nanda-1243/tngexp/docs/research/market-check-folds.md

# Market check: how square tin photo magnets are folded

Date: 2026-10-27. Question: does the Rev E fold match the sharp-cornered tin photo magnets that are sold, and what happens at the corners?

## What the products show

1. **Two flat folds, no curl.** The photo, film and tin fold down at the face edge, then fold flat inward under the back. There is no rolled edge.
2. **A flat border on the back, mitred at 45° at the corners.** On card-back kits the photo carries on round the edge, so the border is printed. On other makes the photo stops at the side wall and the border is bare tin.
3. **The tin starts flat.** Kits sold for 50 × 50, 63.5 × 63.5, 53 × 80 and 65 × 90 mm magnets (the same four sizes as the MagPress kits) supply:
   - a flat tinplate blank with small 45° corner clips;
   - photo paper and film cut as octagons, with large 45° corner clips (the paper cutters are octagonal);
   - a card back and a rubber magnet.
   The press folds the blank itself. Pre-formed square badge shells are sold too, but they have rounded corners of about R3–R4, so they cannot give a sharp corner.
4. **The spare material at each corner folds flat.** It is not cut away. The paper's corner clip stops it from bunching, and the line where the two folded edges meet is the diagonal seen on the back.

## What it changed in Rev E

- **The back edge is a two-layer hem.** After it turns inward under the back, the edge folds back on itself and both layers are pressed flat (the Rev D curl, made flat). That is the "folds twice" on the back of a bought magnet, and it is what the back length and the tin size give: 6 mm of tin past each face edge is the 2.4 mm side wall plus two layers of about 1.5–2 mm under the back. The photo stays outside, so the back shows a 2.8 mm printed border with mitred corners and the cut tin edge is hidden inside the fold.
- **Crimp anvil:** cove R0.7 flush with ring B's bore turns the edge inward; the back-plate platform's side wall (X − 6.6) turns it back on itself; the floor 0.85 below the platform presses the two layers flat. The magnet is about 2.4 mm thick.
- **Tin.** Changed from a drawn 4.5 mm tray to a flat blank cut from 0.20 mm soft tinplate, X + 12 (6 mm a side), with its corners clipped on the photo's 45° line. The photo and film are cut the same size, X + 12.
- **Stroke 1 now folds the tin.** It folds round the pickup pedestal (top edge R0.8) together with the photo and film, into walls about 5.6 mm deep. The pedestal is 23.0 high (was 21.8) so the whole 6 mm flange is drawn into the upper ring. Pickup ring A has a 0.6 mm recess at X + 12.5 that centres the blank, photo and film.
- **Folding force:** about 0.9–1.3 kN for 0.20 mm soft tin (`calc/results.txt`, section 2). The Rev D upper springs (0.68–1.3 kN) could not hold the upper ring against that.
- **New upper springs:** 8 × ISO 10243 Ø12.5 × 44 red, giving 1.57 kN preload and 2.54 kN at full travel. They sit in a 20 mm die body, which has a Ø54 counterbore for the holder.
- **Hand force at the end of stroke 2:** rises by about 50 N, to 210–268 N for the square kits.
- **Round kits keep the Rev D rolled edge** and drawn round cups. A flat round blank cannot be folded, and a round edge folded flat would have to shrink about 10 % as it turns in, so it would wrinkle.
- **To prove on the prototype:** that the edge, pushed round the cove and back along the floor, lies flat in two layers without buckling; the real hem width (adjust the blank between X + 11 and X + 13 to suit).

## Sources

- Jiangxi Mide square fridge-magnet press kit, molds 50 × 50, 63.5 × 63.5, 53 × 80 and 65 × 90 mm, with materials and finished-product photos: https://jxmide.en.made-in-china.com/product/ATERtYaUFjkM/China-Manual-Metal-Square-Fridge-Magnet-Photo-Making-Machine-Kit.html
- Square tinplate souvenir magnets, back views: https://ruiwangifts.en.made-in-china.com/product/MqlnwISypdpF/China-Square-Souvenir-Metal-Tin-Plate-Fridge-Magnet-for-Promotion-Gifts.html
- Tinplate fridge magnets, back views: https://miligift.en.made-in-china.com/product/AKxnBFECCqWV/China-Glitter-Square-Type-Flower-Wedding-Tourist-Tinplate-Fridge-Magnet.html
- Square badge machine and its materials, including pre-formed shells with rounded corners and an octagonal paper cutter (India): https://abhishekid.com/blogs/blog/how-to-make-square-button-badges-fridge-magnets
- Square badge crimping tips: https://www.americanbuttonmachines.com/blogs/american-button-machines/how-to-solve-crimping-issues
