nanda-1243/tngexp/release/RevE/MagPress-M4_Drawings_RevE.pdf

# MagPress M4

## Photo-magnet press · drawing set · Rev E (release)

### One universal die + size kits: 50 × 50, 63.5 × 63.5, 53 × 80, 65 × 90 mm Round kits (Rev D): Ø44, Ø50, Ø56, Ø58 mm

### DRAWING LIST

DRG NO. | TITLE | QTY | SHEET
MP-001 | GENERAL ARRANGEMENT & HEIGHTS | — | 2
MP-101 | BASE PLATE | 1 | 3
MP-102 | GUIDE RAIL | 2 (1 × -F, 1 × -B) | 4
MP-103 | KEEPER STRIP (GIB) | 2 (1 × -F, 1 × -B) | 5
MP-104 | STATION STOP BLOCK | 2 | 6
MP-105 | DIE TABLE (SLIDE) | 1 | 7
MP-106 | DIE TABLE STOP PIN | 1 | 8
MP-107 | COLUMN | 2 | 9
MP-108 | CROWN | 1 | 10
MP-109 | RAM | 1 | 11
MP-110 | CLEVIS | 1 | 12
MP-111 | DIE HOLDER | 1 | 13
MP-112 | PIVOT CHEEK | 2 | 14
MP-113 | HANDLE LEVER (ONE PIECE) | 1 | 15
MP-114 | TOGGLE LINK | 2 | 16
MP-116 | PIN A / PIN B (TOGGLE) | 2 | 17
MP-117 | PIN O (HANDLE PIVOT) | 1 | 18
MP-118 | RETURN ROD | 2 | 19
MP-119 | PIVOT SPACER | 2 | 20
MP-120 | STATION PILOT | 1 | 21
MP-121 | HANDLE-STOP POST | 1 | 22
MP-201 | UPPER DIE BODY (UNIVERSAL) | 1 per press | 23
MP-202 | UPPER DIE SHANK | 1 per press | 24
MP-203 | PLUG (SIZE KIT) | 1 per size kit (4) | 25
MP-204 | UPPER RING (SIZE KIT) | 1 per size kit (4) | 26
MP-205 | STATION BASE (UNIVERSAL) | 2 per press | 27
MP-206 | PICKUP PEDESTAL (SIZE KIT) | 1 per size kit (4) | 28
MP-207 | PICKUP RING A (SIZE KIT) | 1 per size kit (4) | 29
MP-208 | CRIMP ANVIL (SIZE KIT) | 1 per size kit (4) | 30
MP-209 | CRIMP RING B (SIZE KIT) | 1 per size kit (4) | 31
MP-210 | UPPER CARRIER (UNIVERSAL) | 1 per press | 32
MP-211 | LOWER CARRIER A / B (UNIVERSAL) | A + B per press | 33
MP-212 | PLUG STUD (SIZE KIT) | 1 per kit (8: 4 square, 4 round) 34
MP-223 | PLUG, ROUND (SIZE KIT) | 1 per round kit (4) | 35
MP-224 | UPPER RING, ROUND (SIZE KIT) | 1 per round kit (4) | 36
MP-226 | PICKUP PEDESTAL, ROUND (SIZE KIT) | 1 per round kit (4) | 37
MP-227 | PICKUP RING A, ROUND (SIZE KIT) | 1 per round kit (4) | 38
MP-228 | CRIMP ANVIL, ROUND (SIZE KIT) | 1 per round kit (4) | 39

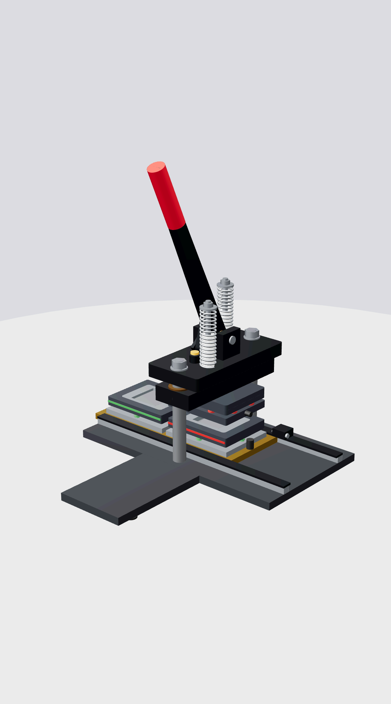
[picture p52: figure]
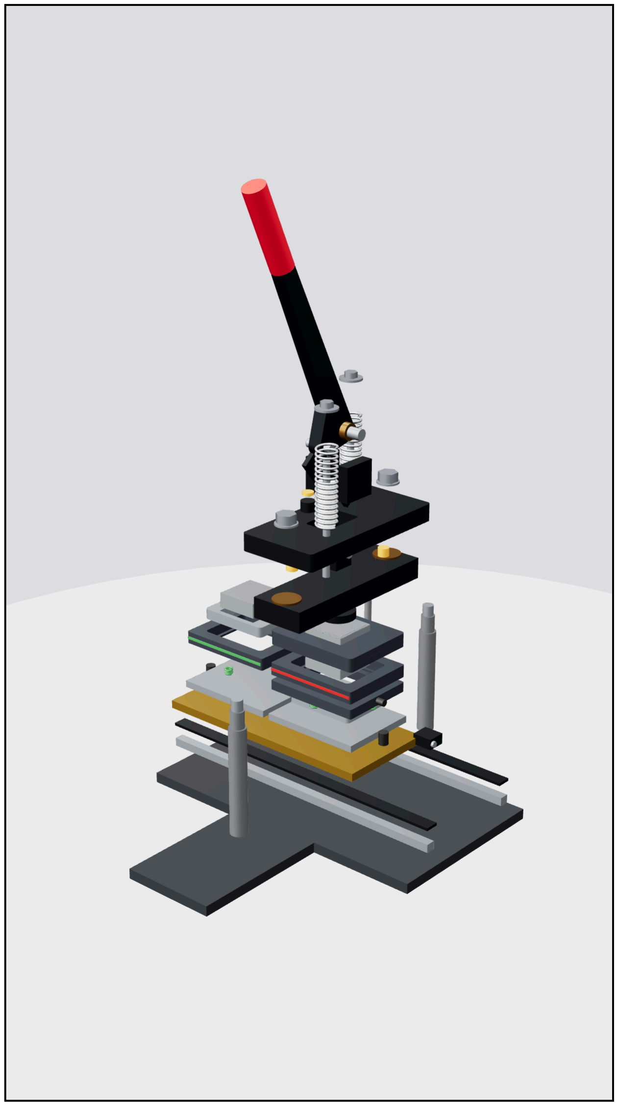
[picture p53: figure]

MP-229 | CRIMP RING B, ROUND (SIZE KIT) | 1 per round kit (4) | 40 | Reference renderings (Rev E): assembled, handle up (left); exploded (right). Not for measurement.

PROJECT
MagPress M4 · manual photo-magnet press

REVISION
E

SHEET
1 / 40

TITLE

# DRAWING SET — COVER & LIST

DRAWING NO.
MP-000

QTY
—

SCALE
—

UNITS
mm

MATERIAL
—

HEAT TREATMENT / FINISH
—

GENERAL TOLERANCES
ISO 2768-mK | 1st

DATE
2026-10-27
DRAWN | CHECKED

NOTES
1. Units mm. First-angle projection (ISO 128-30); every view is also labelled by name.
2. General tolerances ISO 2768-mK unless stated. Fits ISO 286. Threads ISO metric coarse 6H/6g unless stated. Ra 3.2 unless stated.
3. Column bores in base MP-101, crown MP-108 and ram MP-109 at 210.00 ±0.01: same datum scheme and CNC program.
4. Universal parts (MP-201, 202, 205, 210, 211) are made once per press. Square and rectangular kit parts (MP-203, 204, 206 to 209, 212) are tabulated for 5050, 6363, 5380, 6590; Rev D round kit parts (MP-223, 224, 226 to 229, with stud MP-212) for D44, D50, D56, D58.
5. DXF profiles are supplied for cutting and wire-EDM. If a DXF and a drawing disagree, the drawing governs. Bought parts are in the build pack BOM.
6. Rev B: failure-mode review (lever, pin O, bushings, return springs, pilot, base, 16 kN). Rev C (2026-10-27): universal die + 6-part size kits
changed by hand in about a minute; crimp anvil with roll channel; die springs re-rated to ISO 10243 limits. Rev C.1 (2026-10-27): fit fixes from the 3D interference check: ram link pockets (MP-109), crown reliefs for pins A and B (MP-108), push knobs on the table top (MP-105), flush column clamp (MP-101, MP-107), handle stop without jam nut, stop screw M6 × 0.75 × 40 (MP-104). Rev D (2026-10-27): four round size kits on the same universal die; MP-201 gains the inner plug pattern D2/K2. Rev E (2026-10-27), release: fixes from the independent review: sharp-cornered magnets from flat tin blanks folded in stroke 1, double flat fold (hem) with a printed border on the back (round kits keep the rolled edge); die body 20 thick with Ø12.5
× 44 red upper springs; detent pin along X; spigots; crown 120; stop post MP-121.

KEY HEIGHTS, handle up (mm from bench)

HEIGHT | LEVEL
586 | grip top, handle up
324 | return-rod top
234.5 | pivot O
201 | crown top
176 | crown bottom
164 | ram top
134 | ram bottom
92 | upper die bottom
66 | lower die top
40 | station base top
30 | die table top
18 | base top
3 | base underside (3 mm pads)
0 | bench

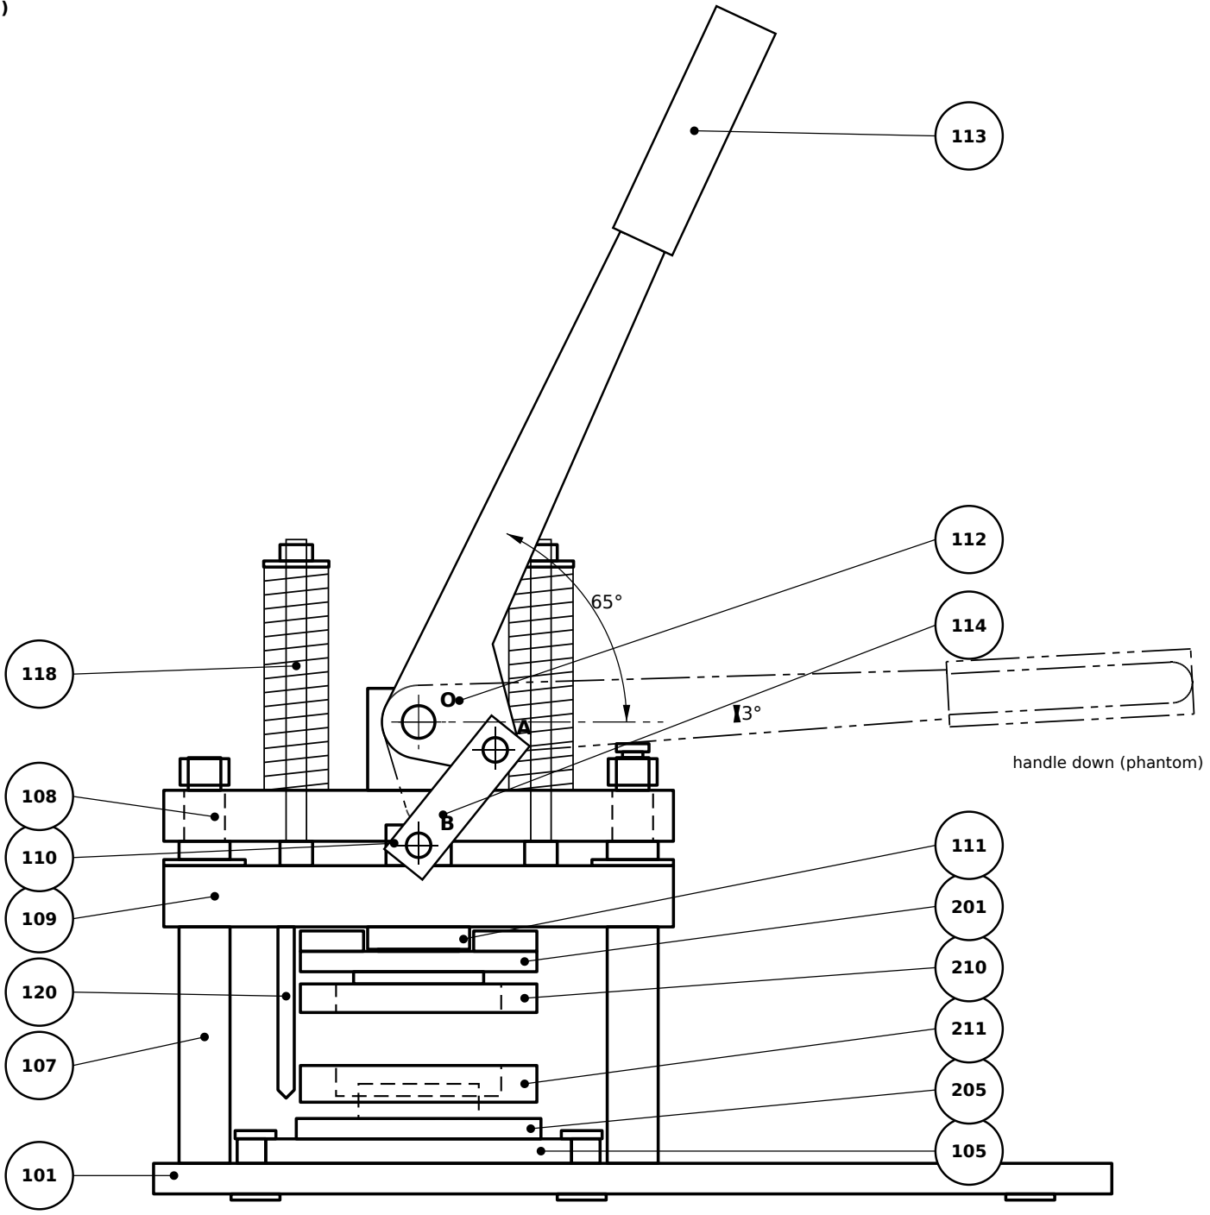
[picture p54: figure]
handle down (phantom)

### SIDE ELEVATION (viewed from the left; front →)

460

160 (stations)

80 (ram)

### FRONT ELEVATION 1:5 (handle cut off)

A | B

PROJECT
MagPress M4 · manual photo-magnet press

REVISION
E

SHEET
2 / 40

TITLE

# GENERAL ARRANGEMENT & HEIGHTS

DRAWING NO.
MP-001

QTY
—

SCALE
1:3 / 1:5

UNITS
mm

MATERIAL
—

—

NOTES
1. Shown with the handle UP (open), die table at "B under ram", size kit 6363 in the universal die. Heights from the bench top.
2. Toggle: crank O→A 40, link A→B 60, grip centre 320 from O (Rev A 290). Handle 65° → 3° above horizontal. Force gain 6.6 at the start, 34.6 at the end of the stroke.
3. Ram stroke 38.9. Dies meet after 26.0; working travel 12.9. Pickup stroke stops at 35.5. Station pilot MP-120 enters the table at 20.0, before the
dies meet.
4. Open stop: 2 urethane bumpers on the ram top. Closed stop: adjustable M10 × 1 screw + urethane cap in the post MP-121 on the crown (Rev E), set so the lever rests at 3°.
5. Rev B: one-piece lever (MP-115 deleted); pin O Ø16; dry bushings; return springs 80 / 245 N; station pilot; 15 mm base. Rev C: universal die + size kits (MP-201 to 212). Rev C.1: seven fit fixes from the 3D check (MP-101, 104, 105, 107, 108, 109). Rev D: round size kits Ø44 to Ø58 (MP-223 to 229), inner plug pattern on MP-201. Rev E: fixes from the independent review (see the cover).
6. Balloons = drawing numbers (MP-xxx). Pins MP-116 at A and B, MP-117 at O; spacers MP-119 on pin O; stop blocks MP-104 behind the table.

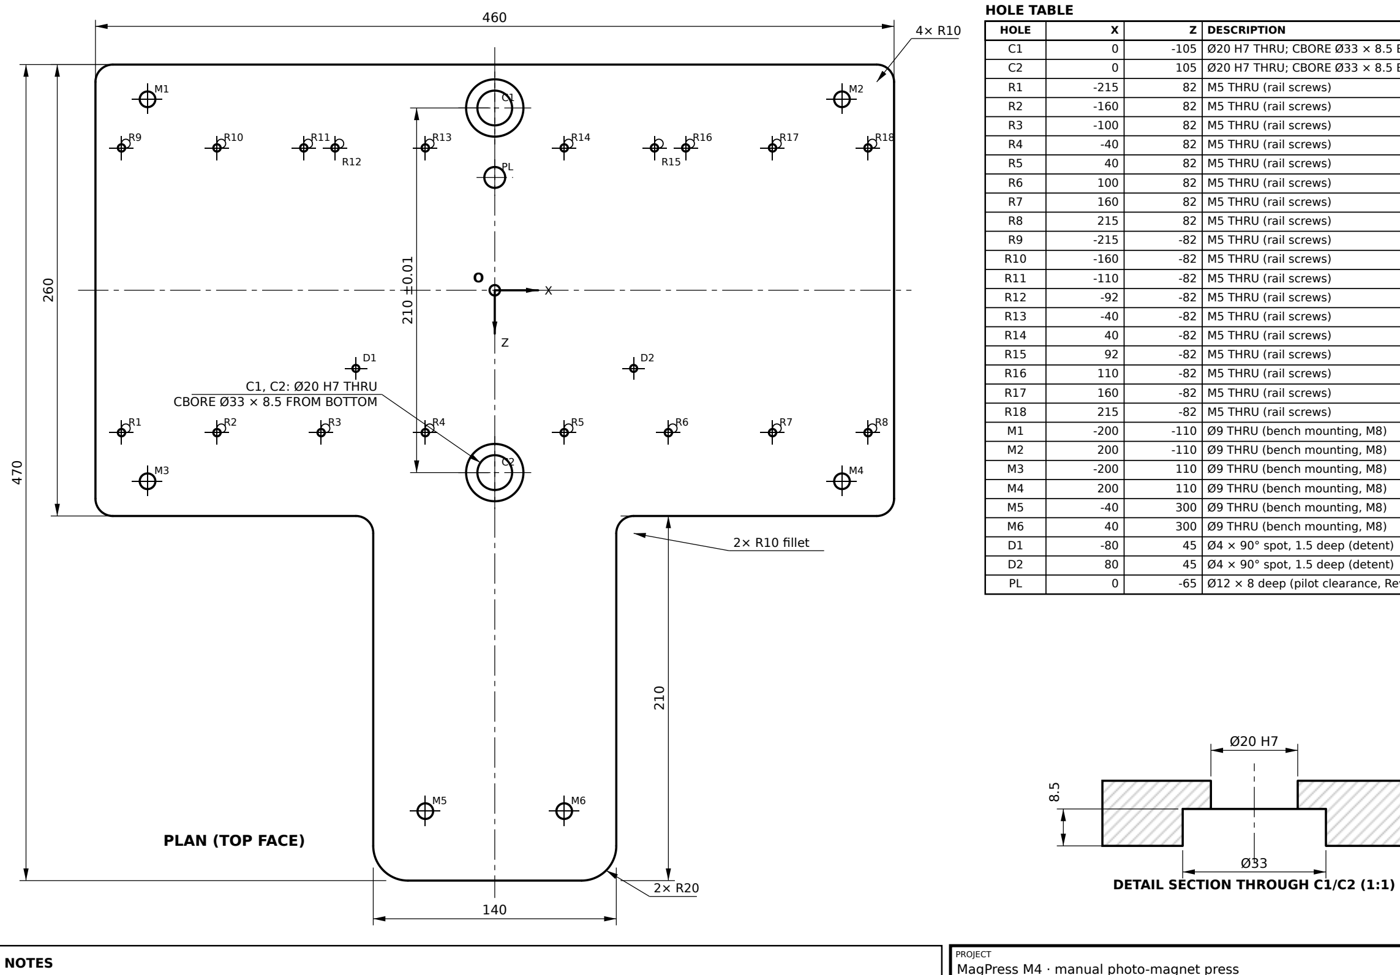
[picture p55: figure]
2× R10 fillet; C1, C2: Ø20 H7 THRU CBORE Ø33 × 8.5 FROM BOTTOM; PLAN (TOP FACE); HOLE TABLE; HOLE; DESCRIPTION; M5 THRU (rail screws); Ø9 THRU (bench mounting, M8); DETAIL SECTION THROUGH C1/C2 (1:1); PROJECT; NOTES

C1 | 0 | -105 | Ø20 H7 THRU; CBORE Ø33 × 8.5 BOTTOM
C2 | 0 | 105 | Ø20 H7 THRU; CBORE Ø33 × 8.5 BOTTOM
D1 | -80 | 45 | Ø4 × 90° spot, 1.5 deep (detent)
D2 | 80 | 45 | Ø4 × 90° spot, 1.5 deep (detent)
PL | 0 | -65 | Ø12 × 8 deep (pilot clearance, Rev E)

15

MagPress M4 · manual photo-magnet press

REVISION
E

SHEET
3 / 40

TITLE

# BASE PLATE

DRAWING NO.
MP-101

QTY
1

SCALE
1:2.5

UNITS
mm

MATERIAL
S355J2 steel plate 20 mm, profile cut, faced to 15.0

Slide area: QPQ nitrocarburize (prototype: black oxide + oil). Rest: black powder coat, bores masked

1. Rev B: 15 mm S355 (was 12 S235). At the 16 kN design load: 112 MPa, 0.26 mm (Rev A: 175 MPa, 0.51 mm). 0.08 mm at a normal 5 kN stroke.
2. Face both sides to 15.0 ±0.1. Flatness 0.05 over the slide area X ±230 × Z ±75, Ra 1.6.
3. C1/C2 Ø20 H7 at 210.00 ±0.01: same datum and program as crown MP-108 and ram MP-109. CBORE Ø33 × 8.5 from the BOTTOM (Rev C.1, was 4.5): the M10 × 16 DIN 7984 clamp screw and Ø32 × 2.5 washer sit flush with the underside.
4. M1–M6: Ø9 THRU bench-mounting holes (M8). Underside: five 3 mm adhesive rubber pads Ø24 at (±200, ±80) and (0, 300).
5. PL: Ø12 × 8 deep clearance for the station pilot MP-120. D1/D2: Ø4 × 90° spots, 1.5 deep (table detents).
6. Hole positions from datum O (midpoint of C1–C2). X to the right; Z toward the front (tongue).
7. General tolerances ISO 2768-mK; fits per ISO 286; threads ISO metric 6H/6g.
8. Break all sharp edges 0.3 × 45° unless stated. Remove all burrs.

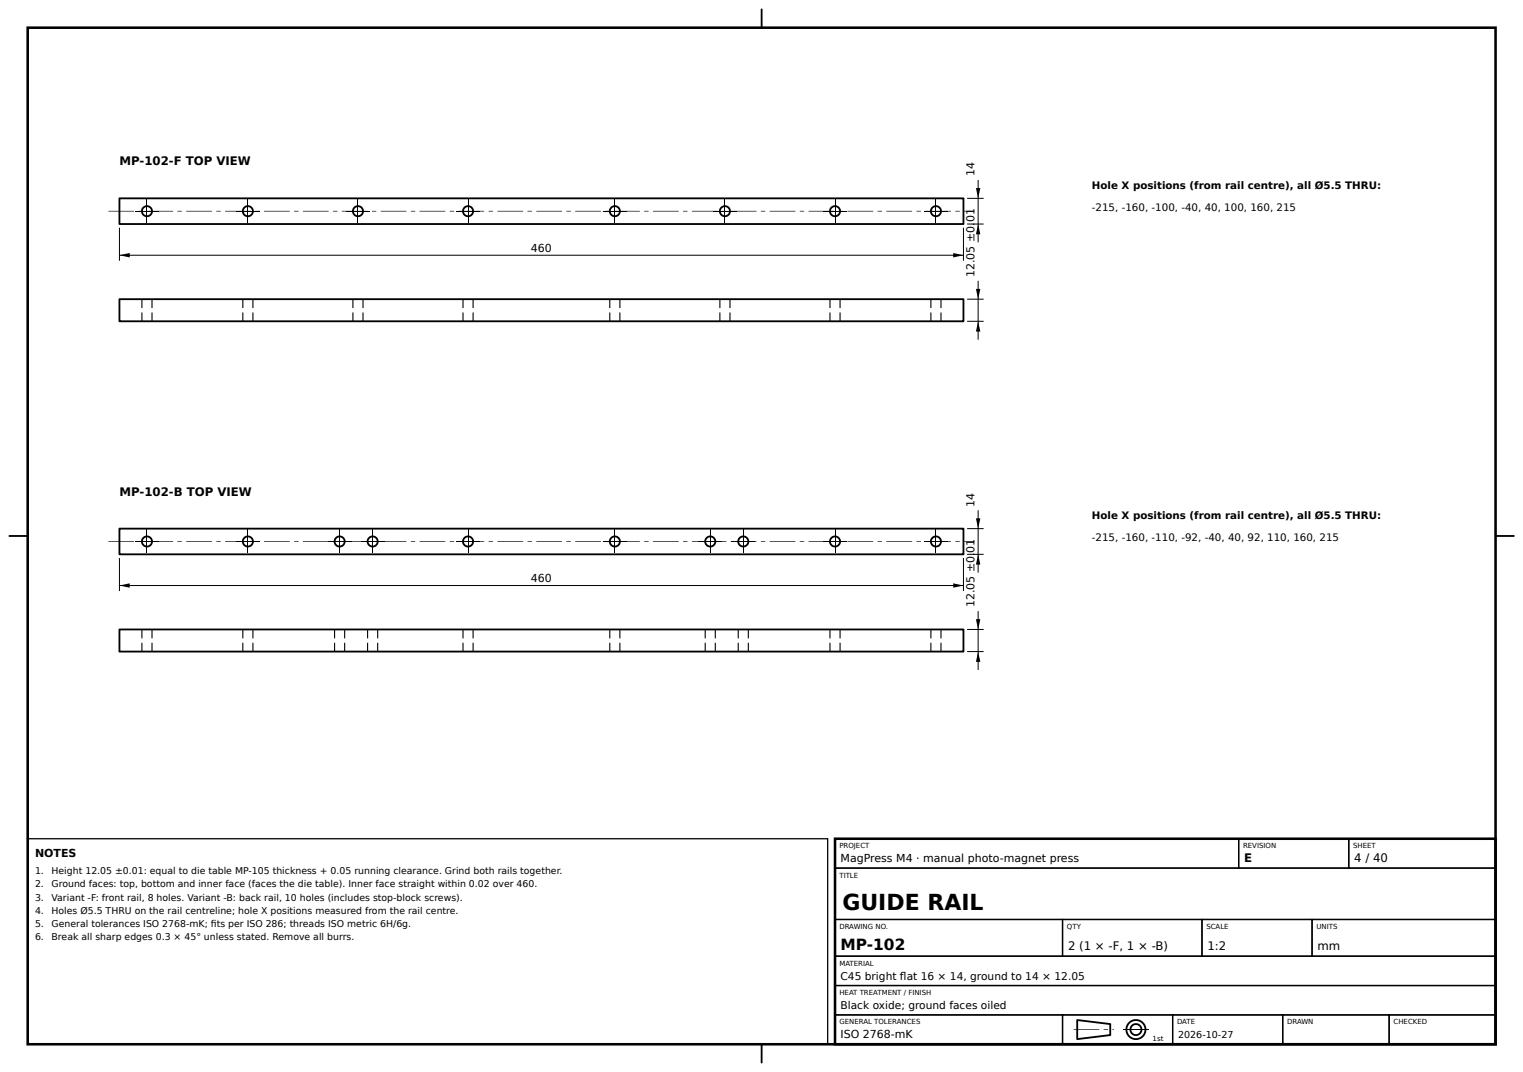
[picture p56: page 4]
REVISION E; SHEET 4 / 40; TITLE; DRAWING NO. MP-102; QTY 2 (1 × -F, 1 × -B); SCALE 1:2; UNITS mm

MP-102-F TOP VIEW

Hole X positions (from rail centre), all Ø5.5 THRU:

MP-102-B TOP VIEW

PROJECT
MagPress M4 · manual photo-magnet press
GUIDE RAIL

NOTES
1. Height 12.05 ±0.01: equal to die table MP-105 thickness + 0.05 running clearance. Grind both rails together.
2. Ground faces: top, bottom and inner face (faces the die table). Inner face straight within 0.02 over 460.
3. Variant -F: front rail, 8 holes. Variant -B: back rail, 10 holes (includes stop-block screws).
4. Holes Ø5.5 THRU on the rail centreline; hole X positions measured from the rail centre.
5. General tolerances ISO 2768-mK; fits per ISO 286; threads ISO metric 6H/6g.
6. Break all sharp edges 0.3 × 45° unless stated. Remove all burrs.

MATERIAL
C45 bright flat 16 × 14, ground to 14 × 12.05

Black oxide; ground faces oiled

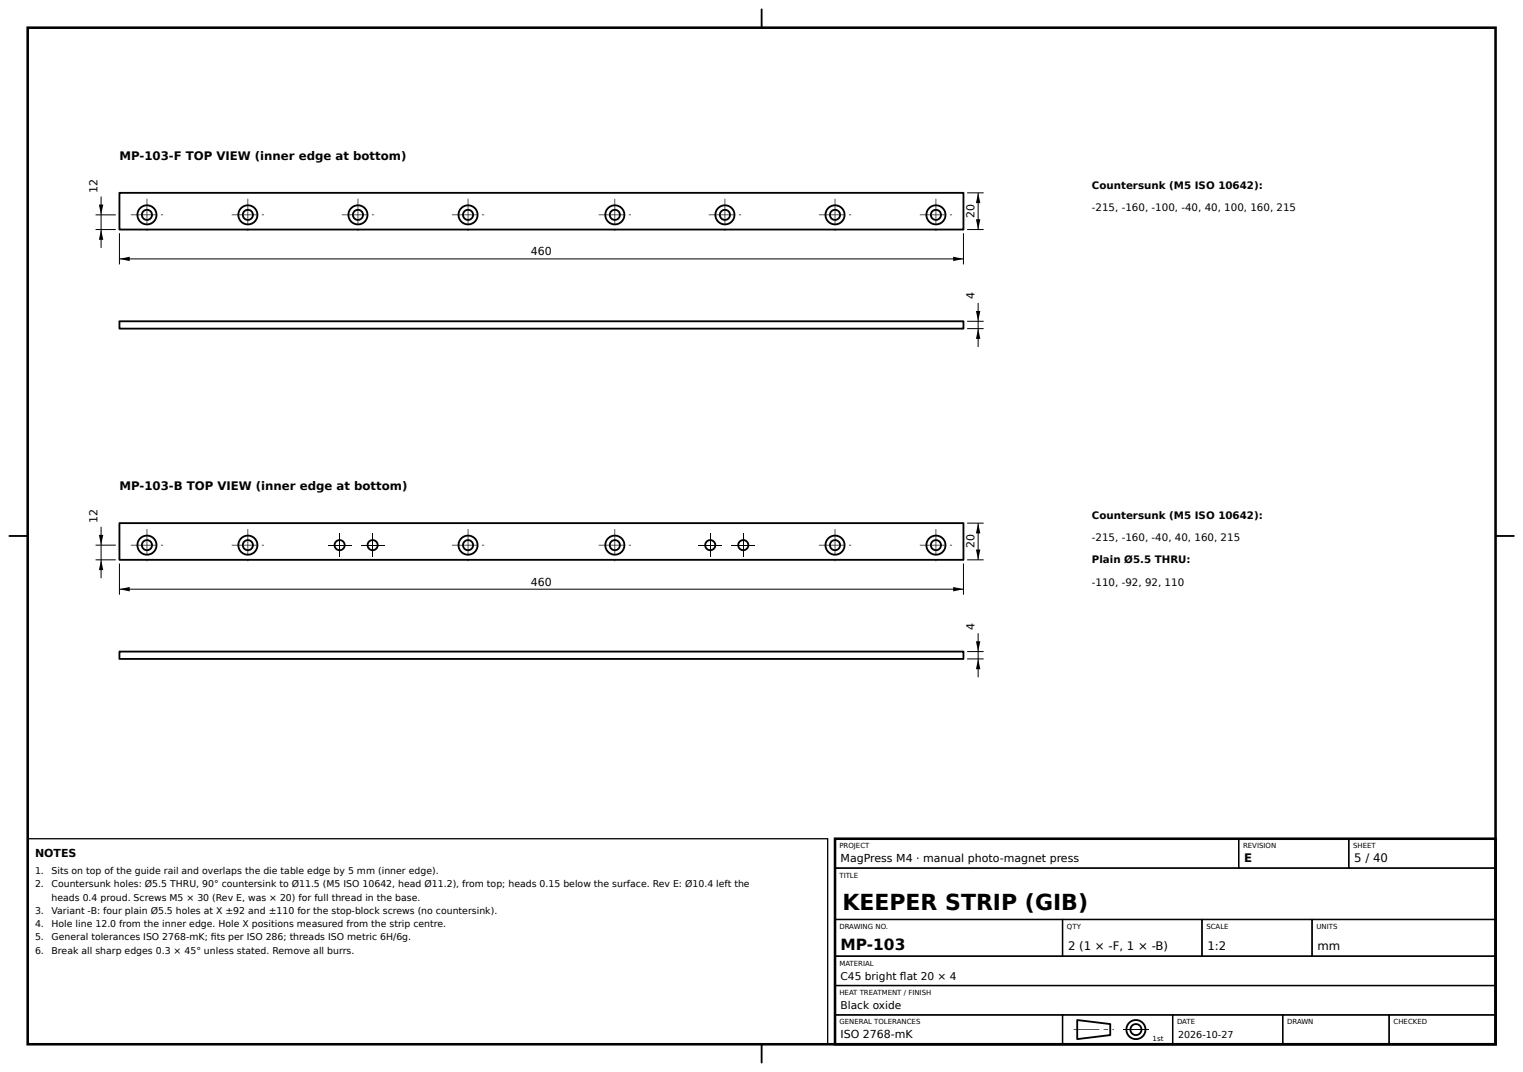
[picture p57: page 5]
Countersunk (M5 ISO 10642):; Plain Ø5.5 THRU:; REVISION E; SHEET 5 / 40; TITLE; DRAWING NO. MP-103; QTY 2 (1 × -F, 1 × -B); SCALE 1:2; UNITS mm; MATERIAL C45 bright flat 20 × 4; Black oxide

MP-103-F TOP VIEW (inner edge at bottom)

MP-103-B TOP VIEW (inner edge at bottom)

PROJECT
MagPress M4 · manual photo-magnet press
KEEPER STRIP (GIB)

NOTES
1. Sits on top of the guide rail and overlaps the die table edge by 5 mm (inner edge).
2. Countersunk holes: Ø5.5 THRU, 90° countersink to Ø11.5 (M5 ISO 10642, head Ø11.2), from top; heads 0.15 below the surface. Rev E: Ø10.4 left the
heads 0.4 proud. Screws M5 × 30 (Rev E, was × 20) for full thread in the base.
3. Variant -B: four plain Ø5.5 holes at X ±92 and ±110 for the stop-block screws (no countersink).
4. Hole line 12.0 from the inner edge. Hole X positions measured from the strip centre.
5. General tolerances ISO 2768-mK; fits per ISO 286; threads ISO metric 6H/6g.
6. Break all sharp edges 0.3 × 45° unless stated. Remove all burrs.

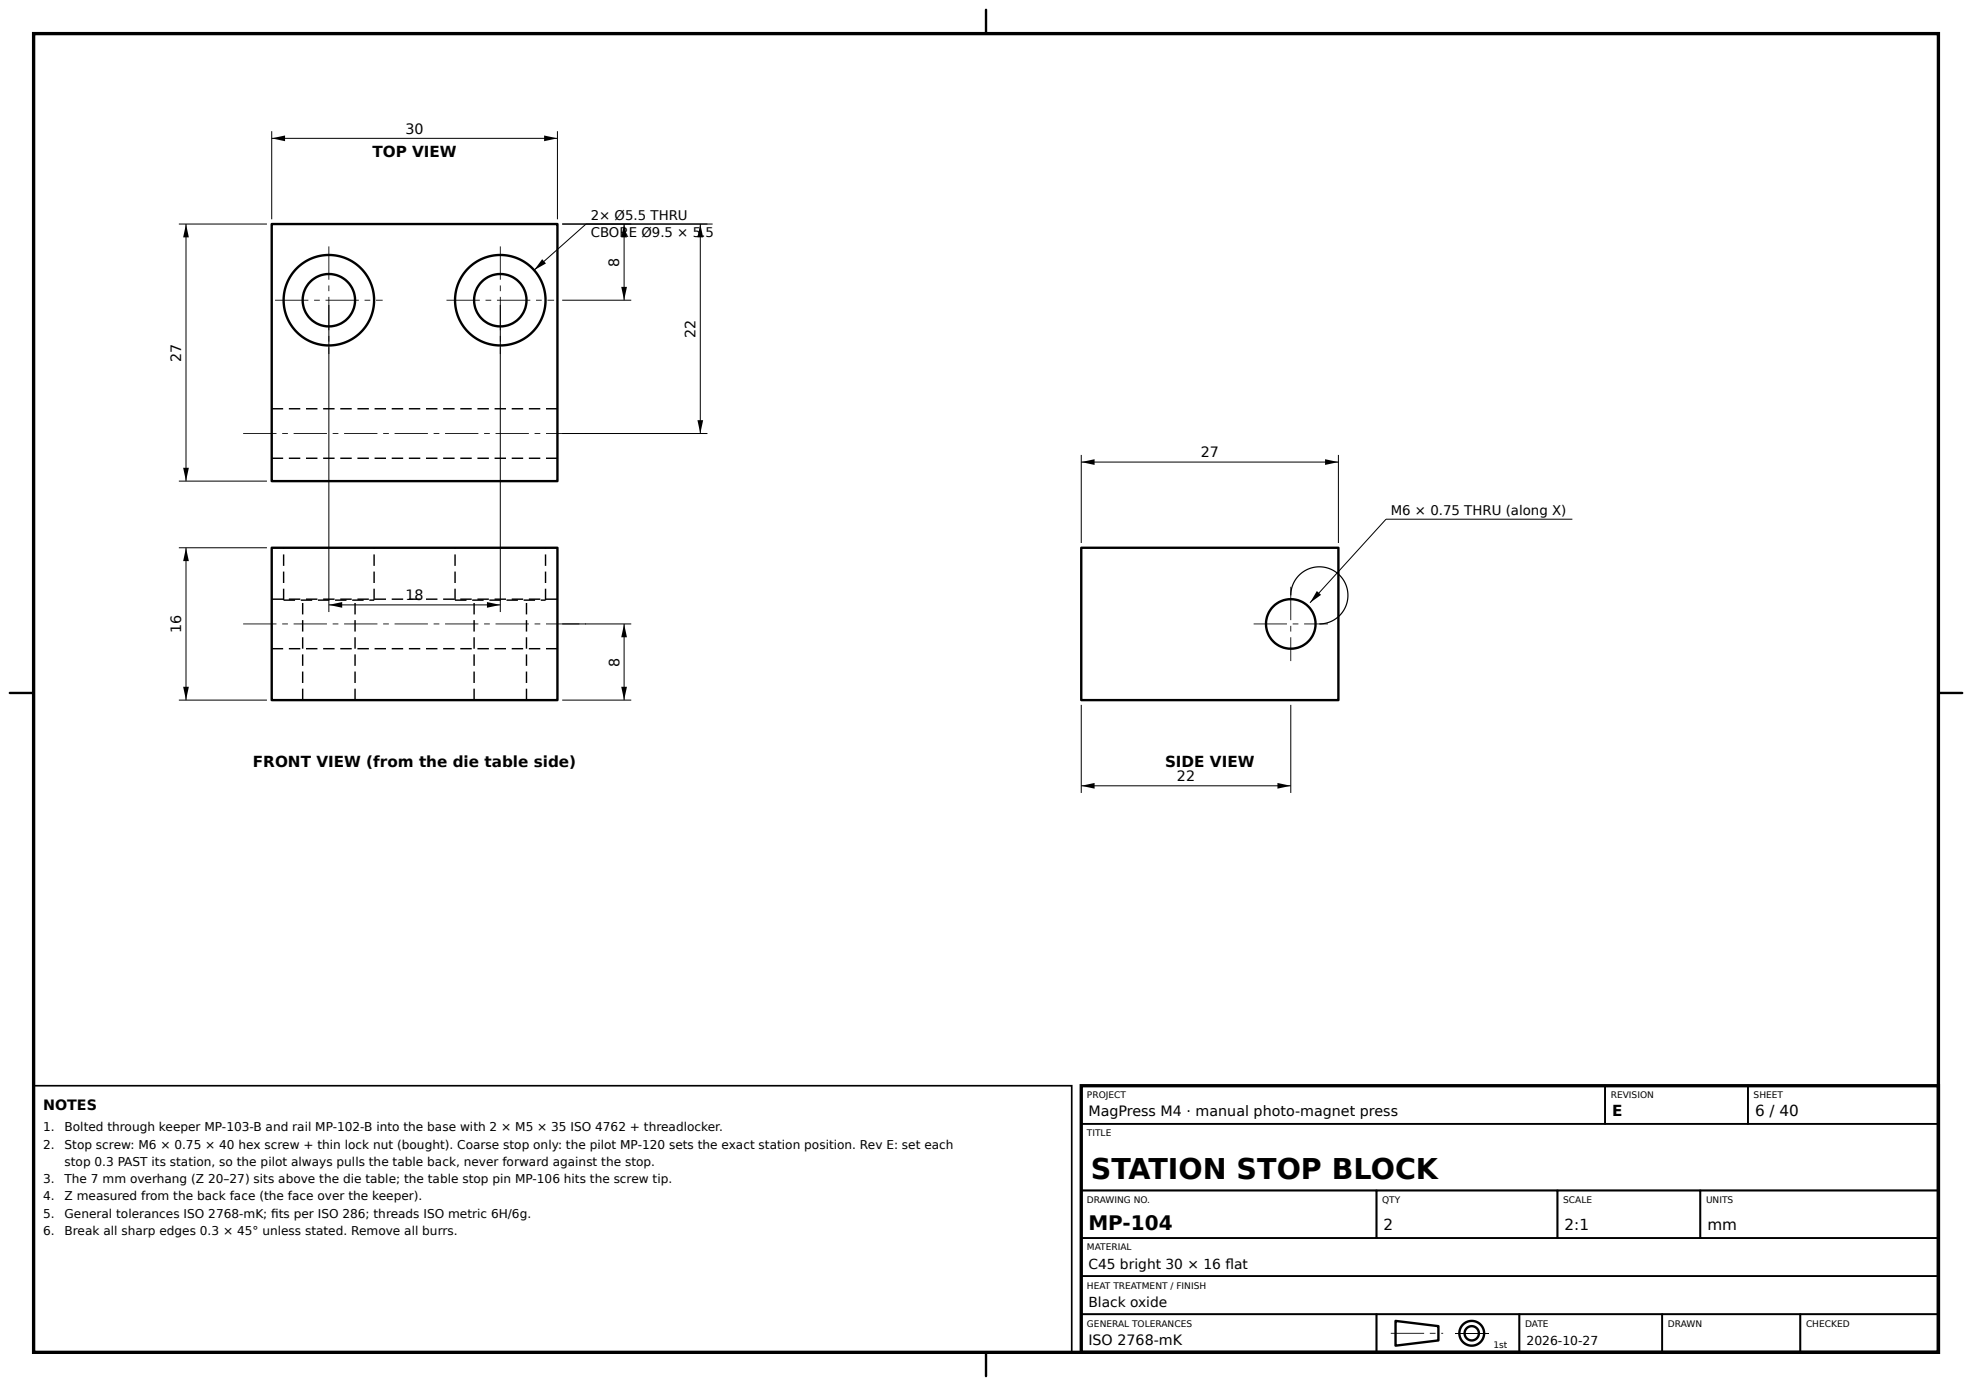
[picture p58: page 6]
TOP VIEW; 2× Ø5.5 THRU CBORE Ø9.5 × 5.5; SIDE VIEW; M6 × 0.75 THRU (along X); REVISION E; SHEET 6 / 40; TITLE; DRAWING NO. MP-104; QTY 2; SCALE 2:1; UNITS mm; MATERIAL C45 bright 30 × 16 flat; Black oxide

FRONT VIEW (from the die table side)

PROJECT
MagPress M4 · manual photo-magnet press
STATION STOP BLOCK

NOTES
1. Bolted through keeper MP-103-B and rail MP-102-B into the base with 2 × M5 × 35 ISO 4762 + threadlocker.
2. Stop screw: M6 × 0.75 × 40 hex screw + thin lock nut (bought). Coarse stop only: the pilot MP-120 sets the exact station position. Rev E: set each
stop 0.3 PAST its station, so the pilot always pulls the table back, never forward against the stop.
3. The 7 mm overhang (Z 20–27) sits above the die table; the table stop pin MP-106 hits the screw tip.
4. Z measured from the back face (the face over the keeper).
5. General tolerances ISO 2768-mK; fits per ISO 286; threads ISO metric 6H/6g.
6. Break all sharp edges 0.3 × 45° unless stated. Remove all burrs.

F1 | F2
F3 | F4
F5 | F6
F7 | F8
G1 | G2 | G3 | G4

S

BP

PA | PB
K1 | STATION A | STATION B | K2
X

Z

340

150

160

### PLAN

HOLE TABLE

HOLE | X | Z | DESCRIPTION
F1 | -115 | -35 | Ø5.5 THRU, CSK Ø11.5 × 90° BOTTOM (base screw)
F2 | -45 | -35 | Ø5.5 THRU, CSK Ø11.5 × 90° BOTTOM (base screw)
F3 | -115 | 35 | Ø5.5 THRU, CSK Ø11.5 × 90° BOTTOM (base screw)
F4 | -45 | 35 | Ø5.5 THRU, CSK Ø11.5 × 90° BOTTOM (base screw)
F5 | 45 | -35 | Ø5.5 THRU, CSK Ø11.5 × 90° BOTTOM (base screw)
F6 | 115 | -35 | Ø5.5 THRU, CSK Ø11.5 × 90° BOTTOM (base screw)
F7 | 45 | 35 | Ø5.5 THRU, CSK Ø11.5 × 90° BOTTOM (base screw)
F8 | 115 | 35 | Ø5.5 THRU, CSK Ø11.5 × 90° BOTTOM (base screw)
G1 | -125 | 0 | Ø6 H7 × 10 deep (base dowel)
G2 | -35 | 0 | Ø6 H7 × 10 deep (base dowel)
G3 | 35 | 0 | Ø6 H7 × 10 deep (base dowel)
G4 | 125 | 0 | Ø6 H7 × 10 deep (base dowel)
S | 0 | -66 | M4 × 8 deep (stop pin MP-106)
BP | 0 | 45 | M6 THRU (ball plunger)
PA | -80 | -65 | Ø10 H8 THRU (station pilot), ±0.02
PB | 80 | -65 | Ø10 H8 THRU (station pilot), ±0.02
K1 | -163 | 0 | M5 × 8 deep (push knob Ø14, top face)
K2 | 163 | 0 | M5 × 8 deep (push knob Ø14, top face)

A A

12 ±0.01

### SECTION A–A (through the pilot holes)

PROJECT
MagPress M4 · manual photo-magnet press

REVISION
E

SHEET
7 / 40

TITLE

# DIE TABLE (SLIDE)

DRAWING NO.
MP-105

QTY
1

SCALE
1:2

UNITS
mm

MATERIAL
EN AW-6061-T6 plate 15 mm, faced to 12.00

Hard anodise 25 µm, gold, PTFE-sealed

NOTES
1. Thickness 12.00 ±0.01 and flat within 0.03 after anodising. Guide rails MP-102 are 12.05.
2. PA/PB Ø10 H8 THRU take the station pilot MP-120 (Rev E: Ø10, was Ø8), ±0.02 to the base dowel holes G. The station bases MP-205 are fixed for good (F, G).
3. F1–F8: Ø5.5 THRU, 90° countersink Ø11.5 from the BOTTOM (M5 × 20 ISO 10642, 0.15 below flush). G1–G4: Ø6 H7 THRU, drilled and reamed in place with the station base aligned (base dowels).
4. S: M4 × 8 (stop pin MP-106). BP: M6 THRU (ball plunger). K1/K2: M5 × 8 in the top face (Ø14 push knobs; Rev C.1, the Rev C Ø24 end-face knobs
reached below the table into the base).
5. Hole positions from the table centre. Station centres at X = −80 (A) and +80 (B), Z = 0.
6. Long edges: 0.5 × 45° chamfer only (they run against the rails).
7. General tolerances ISO 2768-mK; fits per ISO 286; threads ISO metric 6H/6g.
8. Break all sharp edges 0.3 × 45° unless stated. Remove all burrs.

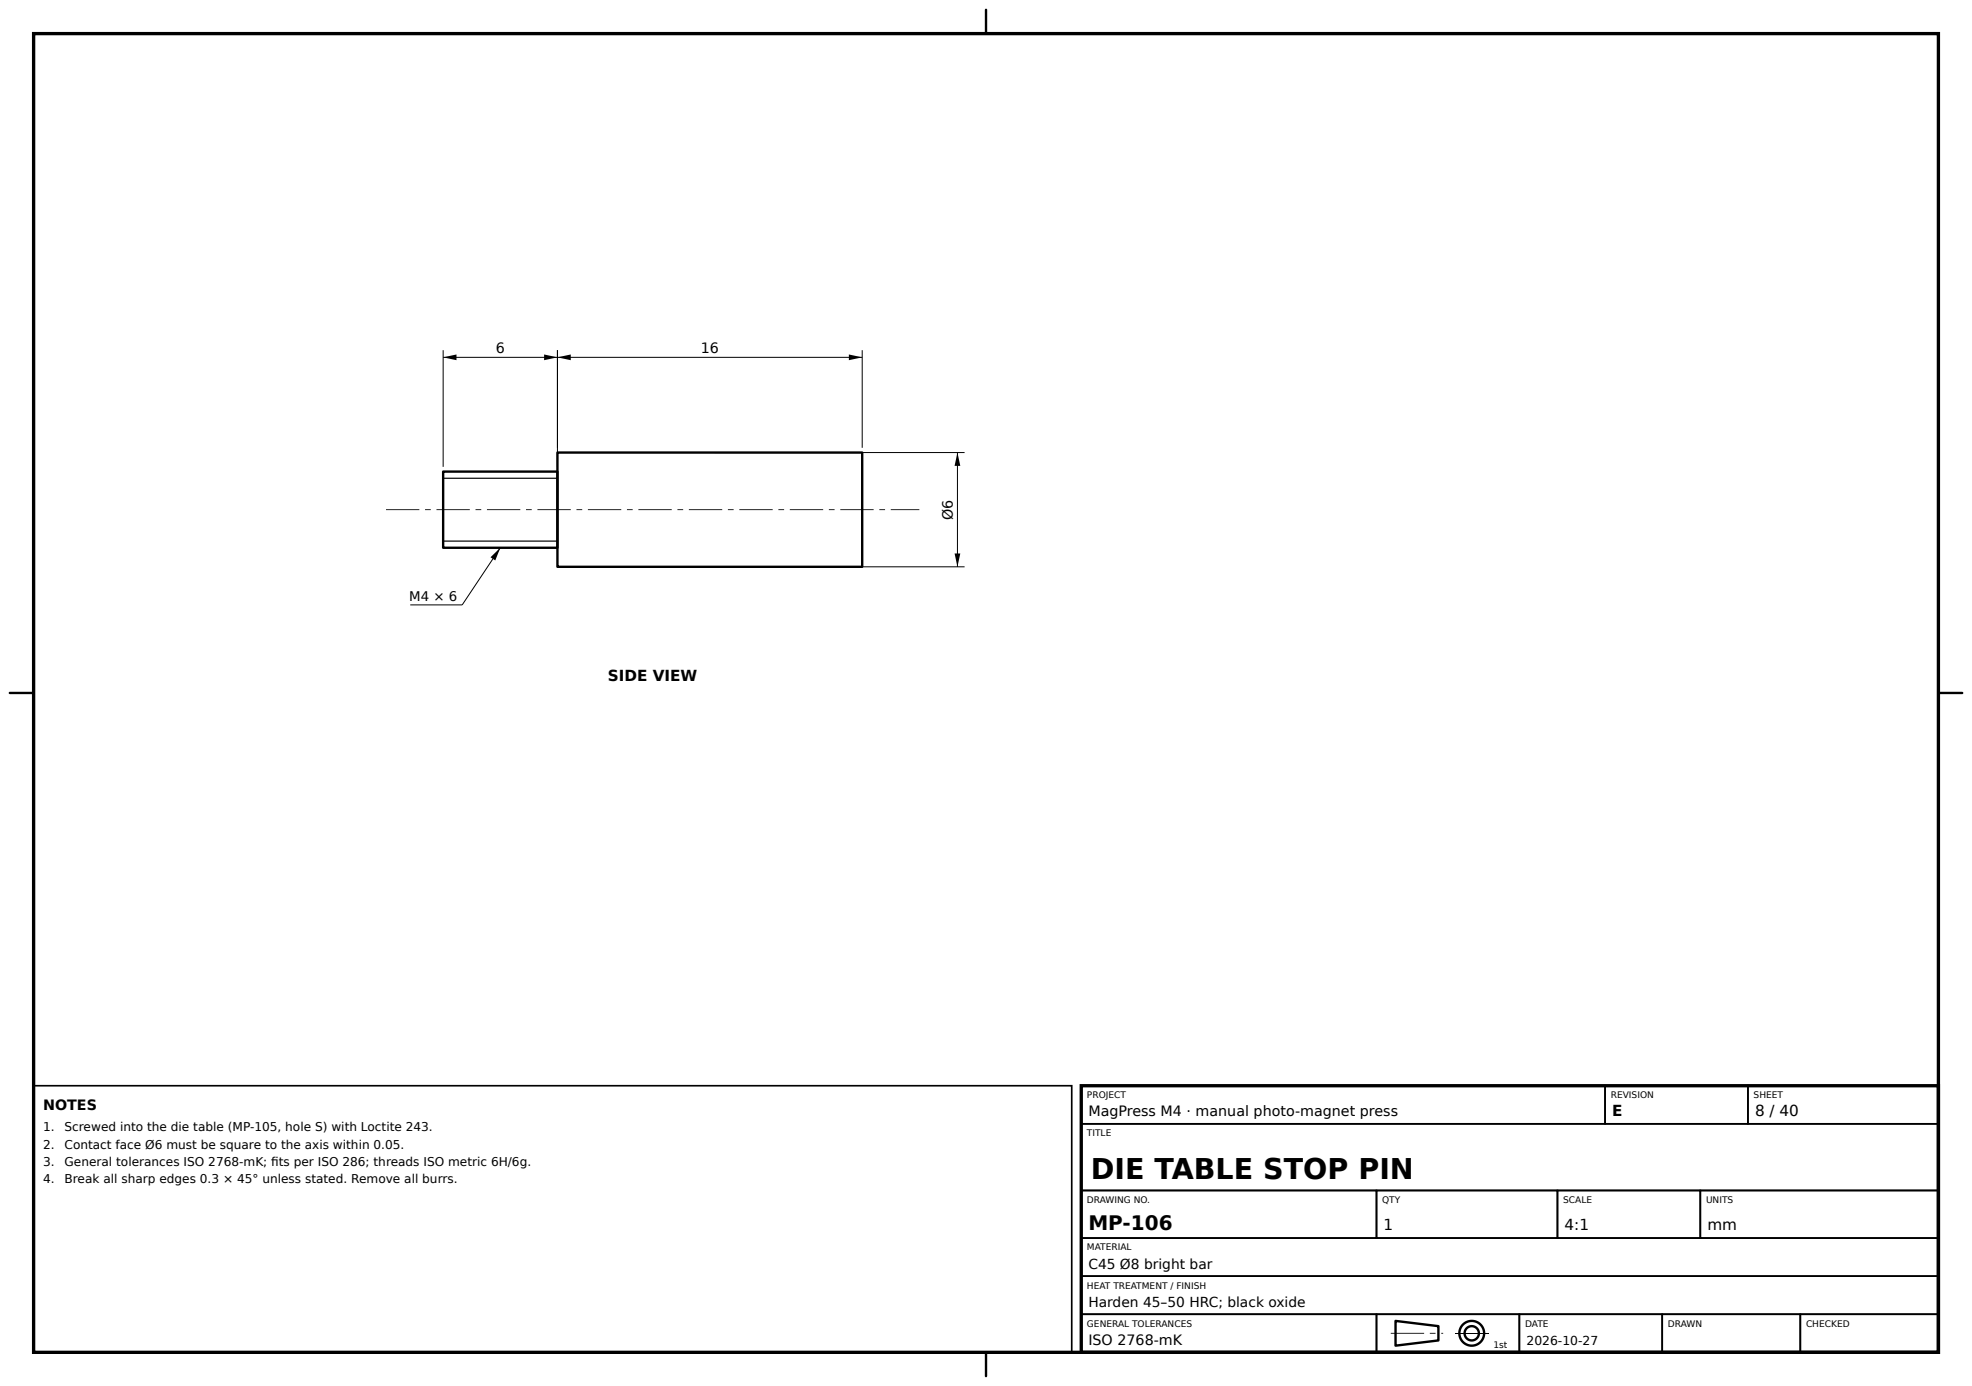
[picture p59: page 8]
SIDE VIEW; REVISION E; SHEET 8 / 40; TITLE; DRAWING NO. MP-106; QTY 1; SCALE 4:1; UNITS mm; MATERIAL C45 Ø8 bright bar

PROJECT
MagPress M4 · manual photo-magnet press
DIE TABLE STOP PIN

NOTES
1. Screwed into the die table (MP-105, hole S) with Loctite 243.
2. Contact face Ø6 must be square to the axis within 0.05.
3. General tolerances ISO 2768-mK; fits per ISO 286; threads ISO metric 6H/6g.
4. Break all sharp edges 0.3 × 45° unless stated. Remove all burrs.

Harden 45–50 HRC; black oxide

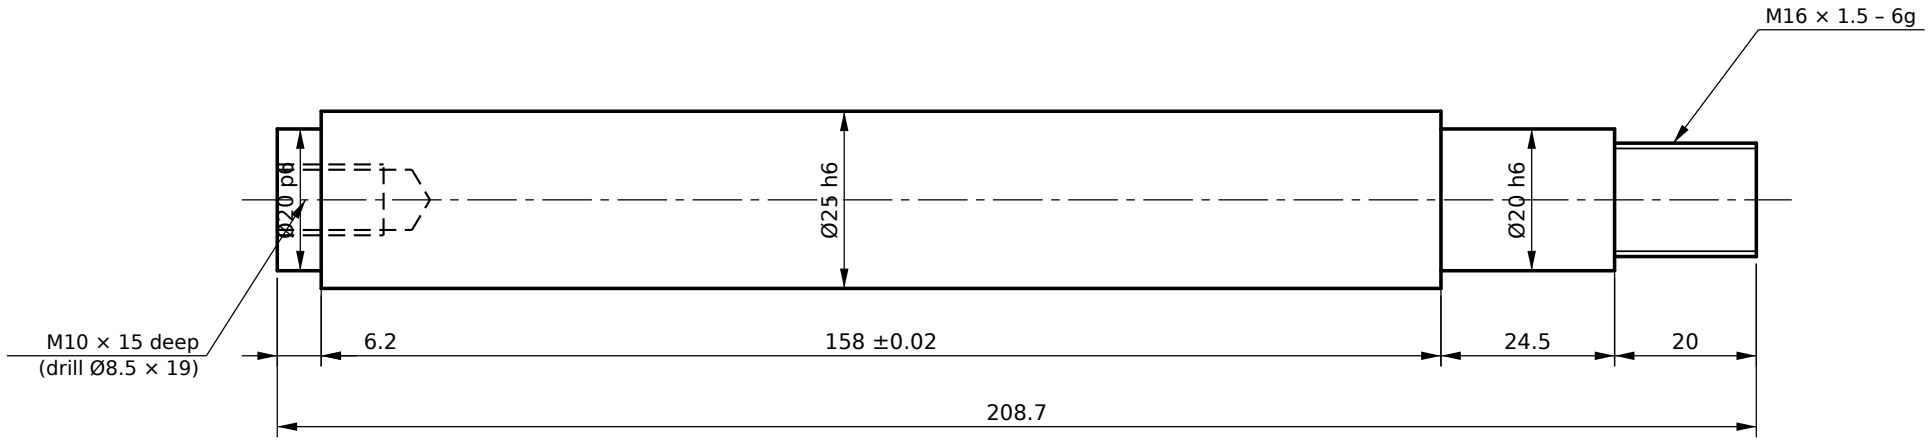
[picture p60: figure]
M10 × 15 deep (drill Ø8.5 × 19)

### SIDE VIEW

PROJECT
MagPress M4 · manual photo-magnet press

REVISION
E

SHEET
9 / 40

TITLE

# COLUMN

DRAWING NO.
MP-107

QTY
2

SCALE
1:1

UNITS
mm

MATERIAL
100Cr6 (52100 / GCr15) Ø30 bar

Ø25 section: induction harden 58–62 HRC, hard chrome 8–12 µm, ground to h6, Ra 0.2

NOTES
1. Ø25 h6 length 158.00 ±0.02; the two columns matched within 0.01 (sets crown parallelism).
2. Bottom spigot Ø20 p6 × 6.2 in the 6.5 bore below the base counterbore: the clamp washer bears on the base, not on the spigot end (Rev E, was 6.5). Clamp from below: M10 × 16 DIN 7984 + hardened washer Ø32 × 2.5, 40 N·m; head flush with the base underside.
3. Ø20 h6 top section 24.5 long passes through the 25 crown (Ø20 H7), so the nut clamps the crown, not the column (Rev E, was 25). Nut M16 × 1.5 + Nord-Lock washer on top, 100 N·m; thread 20 long (was 16).
4. Rev E: no tapped hole in the top end (it left a 2 mm wall under the nut thread). The handle stop is on a post on the crown, MP-121.
5. Shoulders square to the axis within 0.01. Run-out of all diameters 0.01 to the Ø25 axis.
6. Chamfers: ends 1 × 45°; steps 0.5 × 45°. Thread undercut DIN 76-A at the M16 thread end.
7. General tolerances ISO 2768-mK; fits per ISO 286; threads ISO metric 6H/6g.
8. Break all sharp edges 0.3 × 45° unless stated. Remove all burrs.

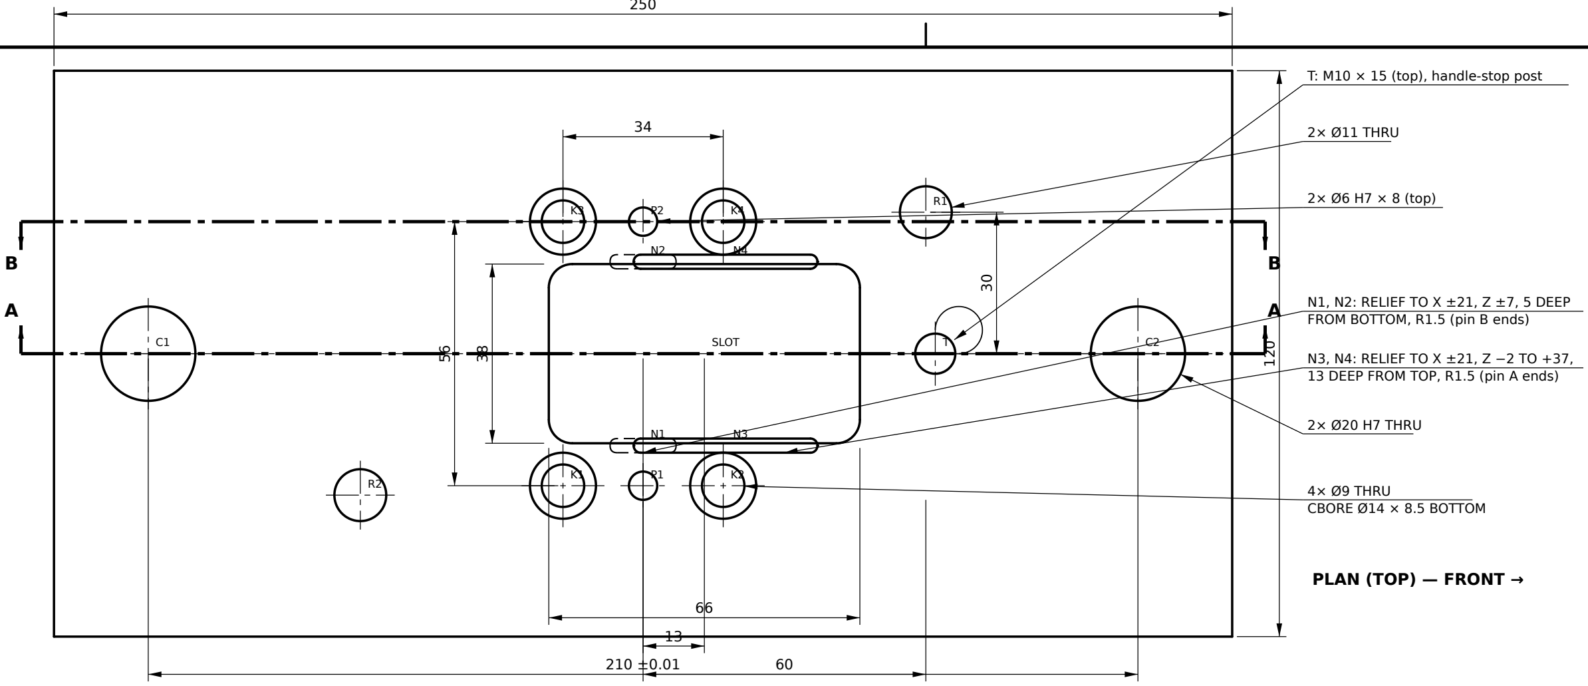
[picture p61: figure]
SLOT; PLAN (TOP) — FRONT →; T: M10 × 15 (top), handle-stop post; 2× Ø20 H7 THRU; 2× Ø11 THRU; 4× Ø9 THRU CBORE Ø14 × 8.5 BOTTOM; 2× Ø6 H7 × 8 (top); N1, N2: RELIEF TO X ±21, Z ±7, 5 DEEP FROM BOTTOM, R1.5 (pin B ends); N3, N4: RELIEF TO X ±21, Z −2 TO +37, 13 DEEP FROM TOP, R1.5 (pin A ends)

25

### SECTION A–A

### SECTION B–B (X = +28)

8.5

PROJECT
MagPress M4 · manual photo-magnet press

REVISION
E

SHEET
10 / 40

TITLE

# CROWN

DRAWING NO.
MP-108

QTY
1

SCALE
1:1

UNITS
mm

MATERIAL
C45 flat 120 × 30, faced to 25

Black oxide

NOTES
1. C1/C2 Ø20 H7 at 210.00 ±0.01: same datum and program as base MP-101 and ram MP-109.
2. Rev E: 120 wide (was 80). At the cheek-bolt line the slot, bolt holes and reliefs left the 80 crown at 373–426 MPa at 16 kN; 120 wide takes it to about 120 MPa and carries the whole return-spring seat.
3. T: M10 × 15 from the TOP at Z +62 for the handle-stop post MP-121 (Rev E: the stop moved off the column top).
4. K1–K4: Ø9 THRU, CBORE Ø14 × 8.5 from the BOTTOM (M8 × 30 ISO 4762 + Nord-Lock into the cheeks MP-112).
5. P1/P2: Ø6 H7 × 8 from the top (cheek dowels). Slot 38 × 66, R5, THRU (links pass through).
6. Rev C.1: reliefs in the slot walls, all to X ±21, R1.5. N1/N2 from the BOTTOM, Z −7 to +7, 5 deep: ends of pin B, handle up. N3/N4 from the TOP, Z −2 to +37, 13 deep: ends of pin A, handle down. 212 MPa at 16 kN at the centre section.
7. Top and bottom faces parallel 0.02, flat 0.02. Plan drawn with the front of the press to the right.
8. General tolerances ISO 2768-mK; fits per ISO 286; threads ISO metric 6H/6g.
9. Break all sharp edges 0.3 × 45° unless stated. Remove all burrs.

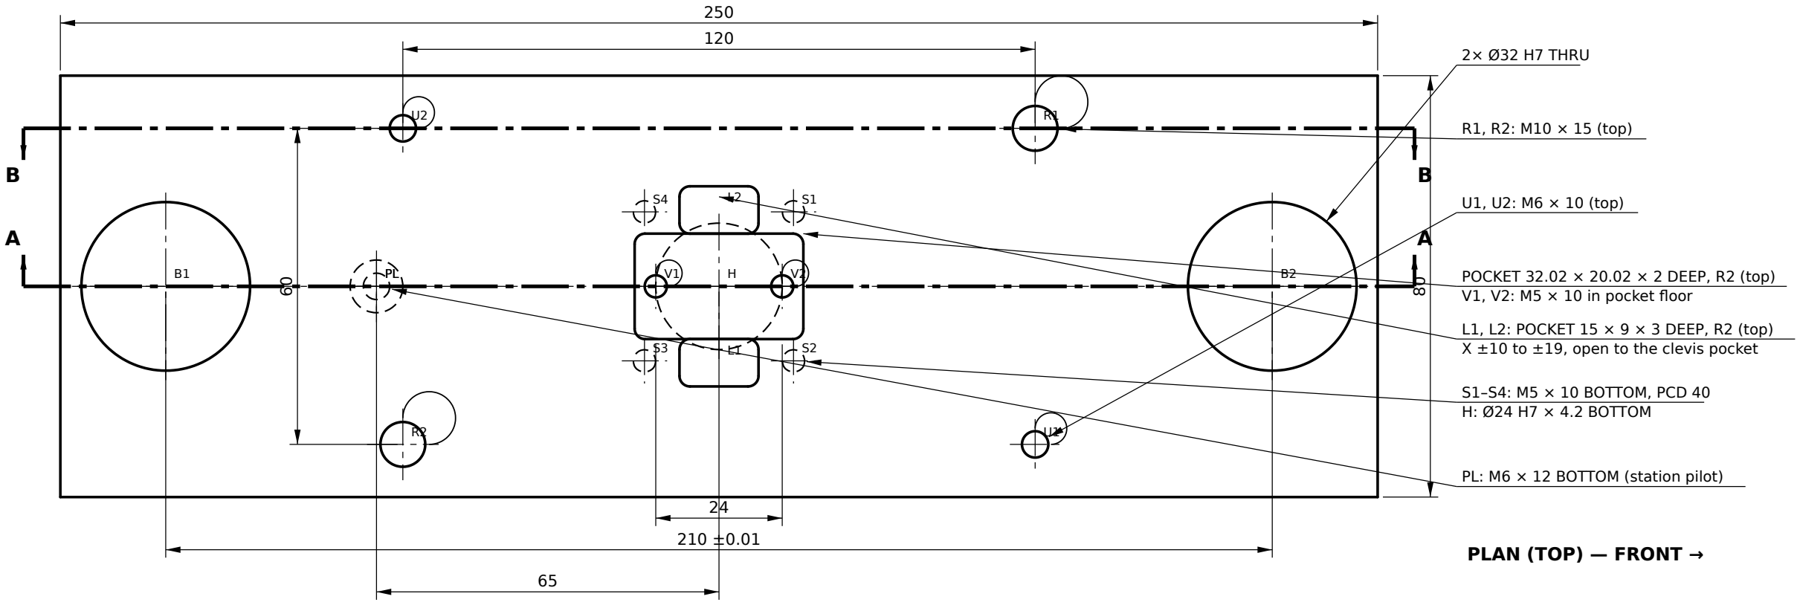
[picture p62: figure]
PLAN (TOP) — FRONT →; 2× Ø32 H7 THRU; R1, R2: M10 × 15 (top); U1, U2: M6 × 10 (top); POCKET 32.02 × 20.02 × 2 DEEP, R2 (top) V1, V2: M5 × 10 in pocket floor; S1–S4: M5 × 10 BOTTOM, PCD 40 H: Ø24 H7 × 4.2 BOTTOM; PL: M6 × 12 BOTTOM (station pilot); X ±10 to ±19, open to the clevis pocket

L1, L2: POCKET 15 × 9 × 3 DEEP, R2 (top)

30

### SECTION A–A

### SECTION B–B (X = +30)

PROJECT
MagPress M4 · manual photo-magnet press

REVISION
E

SHEET
11 / 40

TITLE

# RAM

DRAWING NO.
MP-109

QTY
1

SCALE
1:1

UNITS
mm

MATERIAL
C45 flat 90 × 35, faced to 80 × 30

Black oxide

NOTES
1. Rev B: width 80 (was 70) to carry the return rods at X = ±30 with full thread walls.
2. B1/B2 Ø32 H7 at 210.00 ±0.01 for flanged self-lubricating bronze bushings ID 25 / OD 32 / L 33; same program as MP-101/MP-108.
3. Top: clevis pocket 20.02 × 32.02 × 2.0 (R2) with V1/V2 M5 × 10; R1/R2 M10 × 15 (return rods); U1/U2 M6 × 10 (urethane bumpers).
4. Bottom: H Ø24 H7 × 4.2 (die-holder spigot); S1–S4 M5 × 10 on PCD 40 at 45°; PL Ø10 H7 × 4 + M6 × 14 for the station pilot MP-120 (Rev E: the pilot locates on its Ø10 body, not its thread).
5. V1/V2: M5 thread 10 deep BELOW the pocket floor (Rev E: the section showed 8; the M5 × 25 clevis screws need 8.5).
6. Rev E: after pressing in the bushings, ream the BACK bushing (B2) to Ø25.15: one column guides the ram, the other only stops it turning, so the columns bowing 0.05 under load cannot pinch it.
7. Rev C.1: L1/L2 link-clearance pockets on the top, X ±10 to ±19, 15 long, 3 deep, R2, open into the clevis pocket. The R12 link ends dip 2 mm below the ram top.
8. Top and bottom faces parallel 0.02. Plan drawn with the front of the press to the right; hidden features are on the bottom.
9. General tolerances ISO 2768-mK; fits per ISO 286; threads ISO metric 6H/6g.
10. Break all sharp edges 0.3 × 45° unless stated. Remove all burrs.

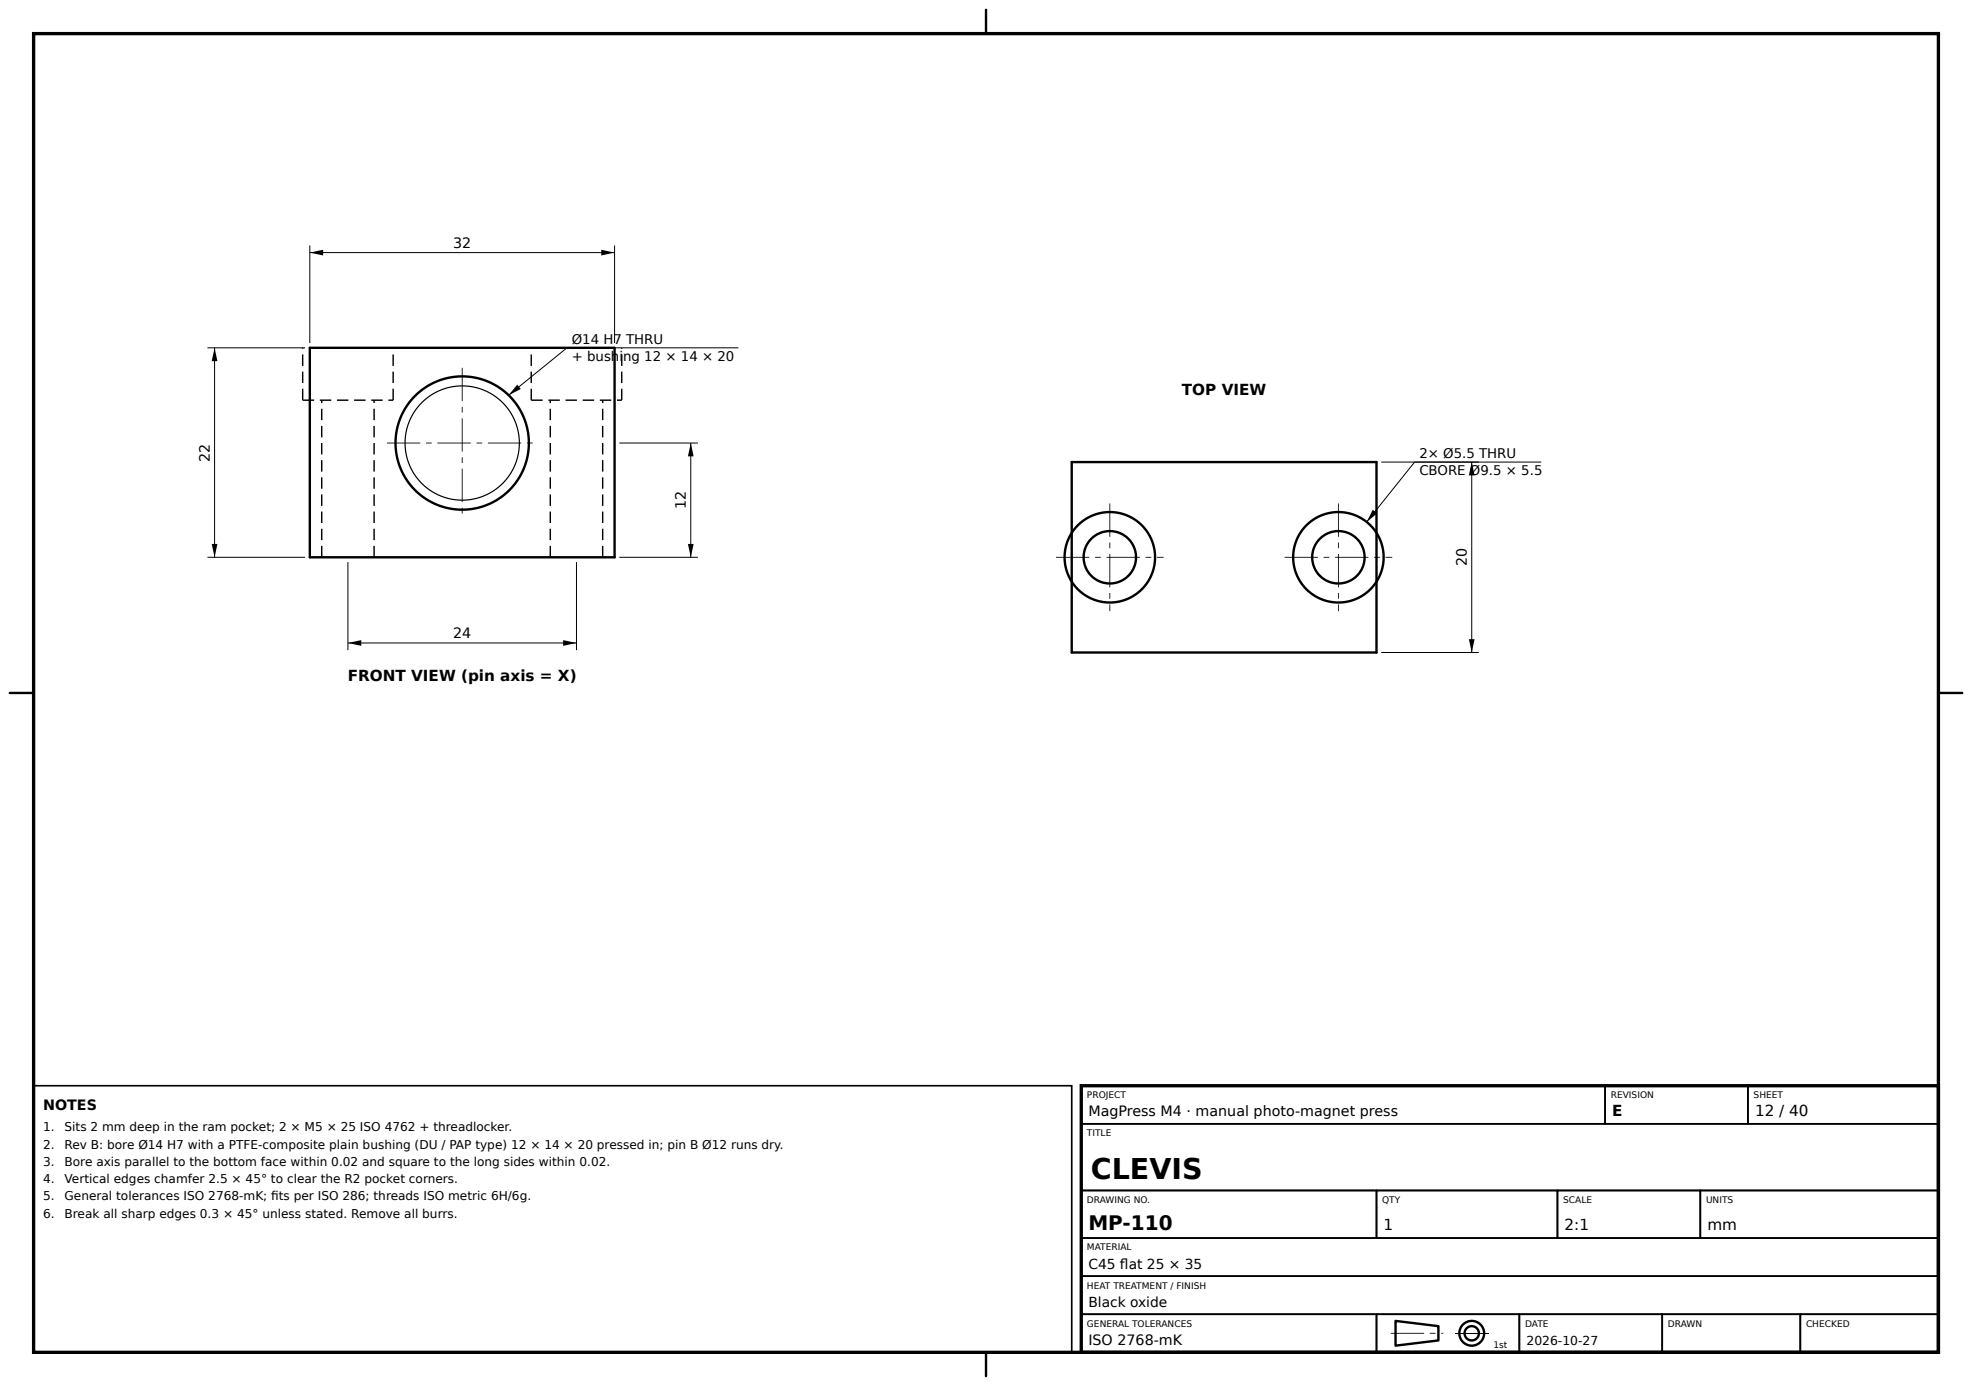
[picture p63: page 12]
Ø14 H7 THRU + bushing 12 × 14 × 20; TOP VIEW; 2× Ø5.5 THRU CBORE Ø9.5 × 5.5; REVISION E; SHEET 12 / 40; TITLE; DRAWING NO. MP-110; QTY 1; SCALE 2:1; UNITS mm; MATERIAL C45 flat 25 × 35; Black oxide

FRONT VIEW (pin axis = X)

PROJECT
MagPress M4 · manual photo-magnet press
CLEVIS

NOTES
1. Sits 2 mm deep in the ram pocket; 2 × M5 × 25 ISO 4762 + threadlocker.
2. Rev B: bore Ø14 H7 with a PTFE-composite plain bushing (DU / PAP type) 12 × 14 × 20 pressed in; pin B Ø12 runs dry.
3. Bore axis parallel to the bottom face within 0.02 and square to the long sides within 0.02.
4. Vertical edges chamfer 2.5 × 45° to clear the R2 pocket corners.
5. General tolerances ISO 2768-mK; fits per ISO 286; threads ISO metric 6H/6g.
6. Break all sharp edges 0.3 × 45° unless stated. Remove all burrs.

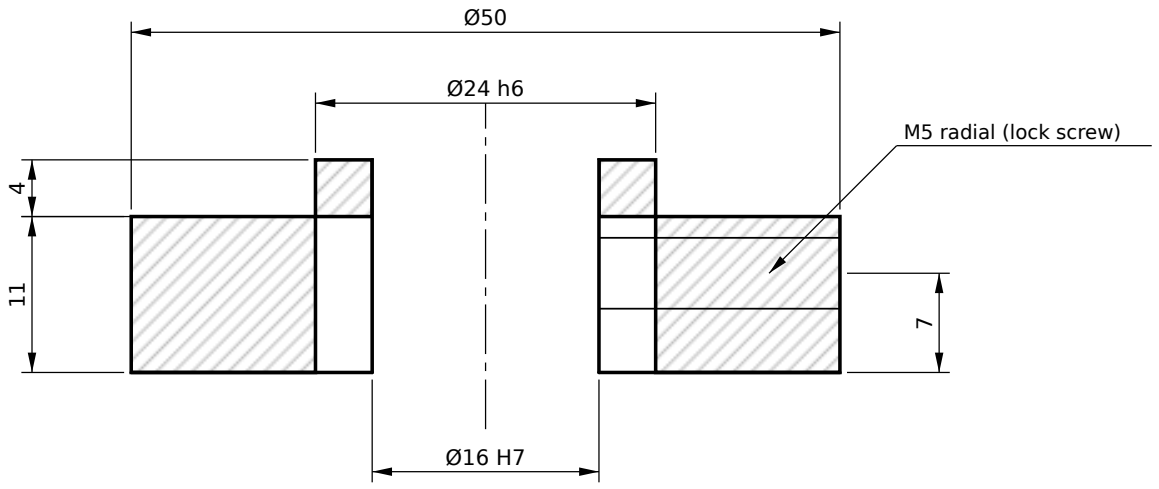
[picture p64: figure]
M5 radial (lock screw)

### SECTION THROUGH X AXIS

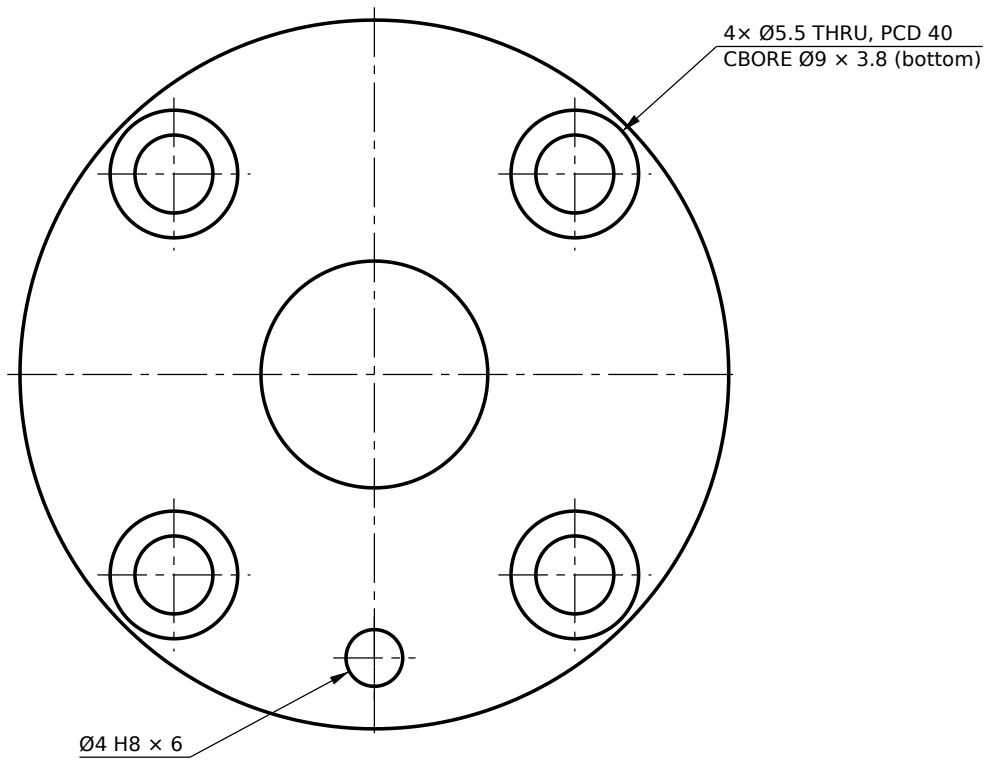
[picture p65: figure]
4× Ø5.5 THRU, PCD 40 CBORE Ø9 × 3.8 (bottom)

### BOTTOM VIEW (front at bottom)

PROJECT
MagPress M4 · manual photo-magnet press

REVISION
E

SHEET
13 / 40

TITLE

# DIE HOLDER

DRAWING NO.
MP-111

QTY
1

SCALE
2:1

UNITS
mm

MATERIAL
42CrMo4 Ø55 bar, QT 28–32 HRC

Black oxide

NOTES
1. Spigot Ø24 h6 locates in the ram (Ø24 H7). 4 × M5 × 16 DIN 7984 low-head screws from below + threadlocker.
2. Bore Ø16 H7 takes the upper-die shank MP-202. Bottom face (die seat) square to the bore within 0.01, flat 0.01.
3. Lock screw: M5 × 10 ISO 4027 cone-point set screw with nylon patch; seats in the shank V-groove. Rev E: 7.0 above the die seat (was 5.5), above the groove centre for any shim pack, so it always pulls the shank up. Check at every die change.
4. Orientation hole Ø4 H8 × 6 deep in the bottom face at 20 mm radius, on the Z axis toward the FRONT.
5. General tolerances ISO 2768-mK; fits per ISO 286; threads ISO metric 6H/6g.
6. Break all sharp edges 0.3 × 45° unless stated. Remove all burrs.

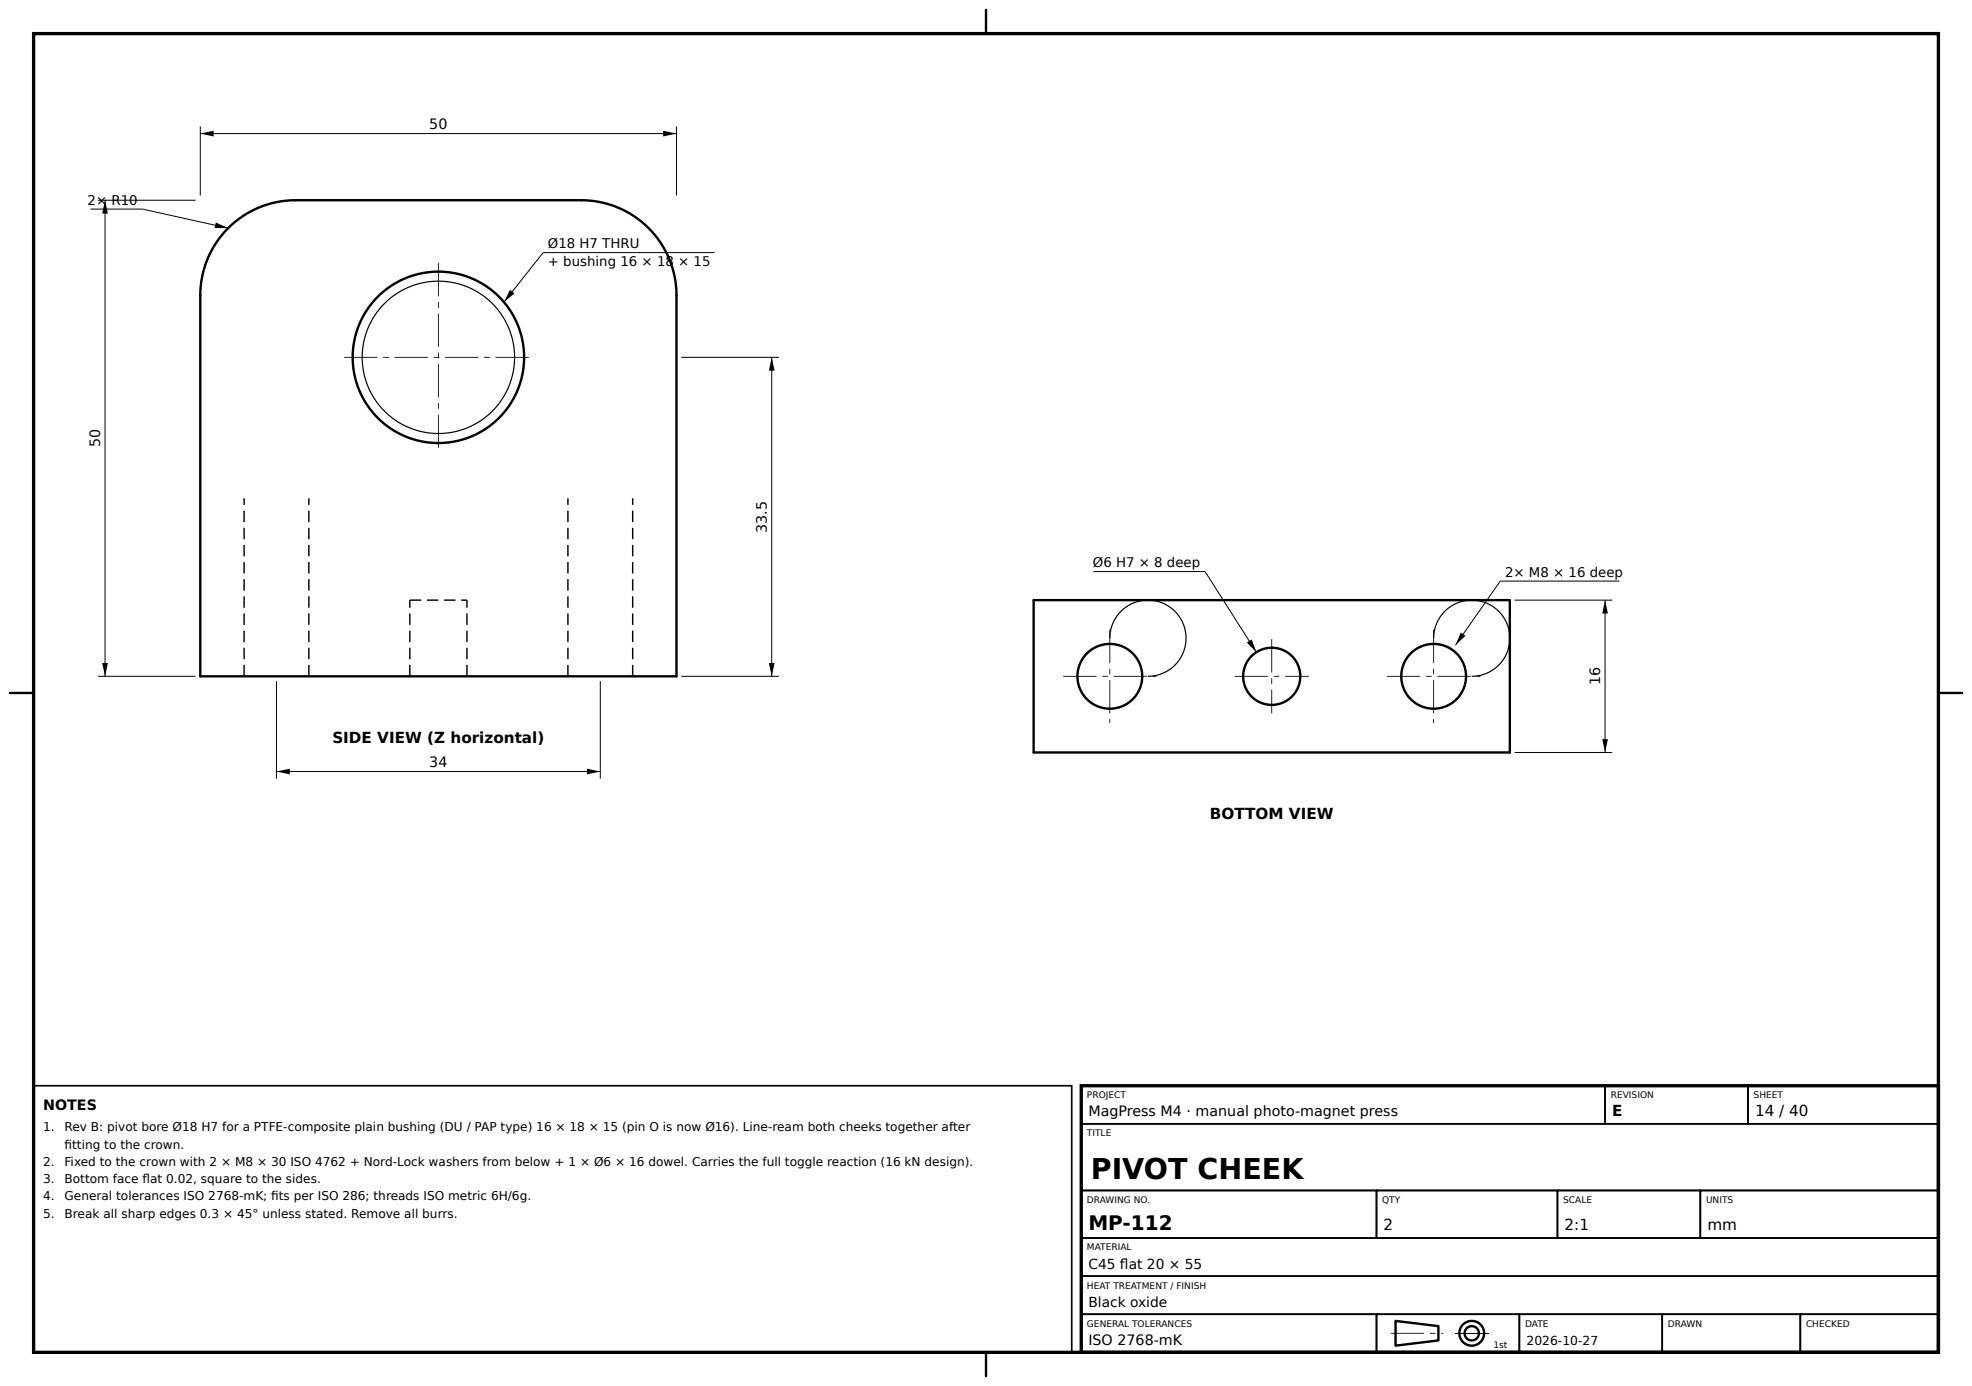
[picture p66: page 14]
Ø18 H7 THRU + bushing 16 × 18 × 15; BOTTOM VIEW; 2× M8 × 16 deep; Ø6 H7 × 8 deep; REVISION E; SHEET 14 / 40; TITLE; DRAWING NO. MP-112; QTY 2; SCALE 2:1; UNITS mm; MATERIAL C45 flat 20 × 55; Black oxide

SIDE VIEW (Z horizontal)

PROJECT
MagPress M4 · manual photo-magnet press
PIVOT CHEEK

NOTES
1. Rev B: pivot bore Ø18 H7 for a PTFE-composite plain bushing (DU / PAP type) 16 × 18 × 15 (pin O is now Ø16). Line-ream both cheeks together after
fitting to the crown.
2. Fixed to the crown with 2 × M8 × 30 ISO 4762 + Nord-Lock washers from below + 1 × Ø6 × 16 dowel. Carries the full toggle reaction (16 kN design).
3. Bottom face flat 0.02, square to the sides.
4. General tolerances ISO 2768-mK; fits per ISO 286; threads ISO metric 6H/6g.
5. Break all sharp edges 0.3 × 45° unless stated. Remove all burrs.

### PROFILE (handle axis horizontal)

320 (grip centre); Ø18 H7 THRU (O); Ø14 H7 THRU (A)

40 ±0.02 from O at 85°

### EDGE VIEW (thickness)

20

grip zone: 4 edges R6

PROJECT
MagPress M4 · manual photo-magnet press

REVISION
E

SHEET
15 / 40

TITLE

# HANDLE LEVER (ONE PIECE)

DRAWING NO.
MP-113

QTY
1

SCALE
1:2

UNITS
mm

MATERIAL
C45 plate 25 mm, faced to 20

Black oxide; grip zone edges R6

NOTES
1. Rev B: replaces the Rev A hub + screwed bar (MP-115 deleted). The Rev A M12 thread reached ≈ 465 MPa at a 200 N push; this section sees ≈ 14 MPa (36 MPa at 500 N).
2. Profile from DXF (laser/waterjet + CNC, or wire EDM). Faces parallel 0.05.
3. O: Ø18 H7 for a PTFE-composite plain bushing (DU / PAP type) 16 × 18 × 20. A: Ø14 H7 for a 12 × 14 × 20. Crank O→A = 40.00 ±0.02 at 85° ±0.1° to the handle axis.
4. Grip zone (u 260–380): 20 × 20 with all four long edges R6; red TPR grip Ø32 / Ø24 × 120 pushed on with rubber adhesive. Grip centre 320 from O.
5. Handle stop: the lever underside rests on the adjustable stop screw on the front column at 3° above horizontal.
6. General tolerances ISO 2768-mK; fits per ISO 286; threads ISO metric 6H/6g.
7. Break all sharp edges 0.3 × 45° unless stated. Remove all burrs.

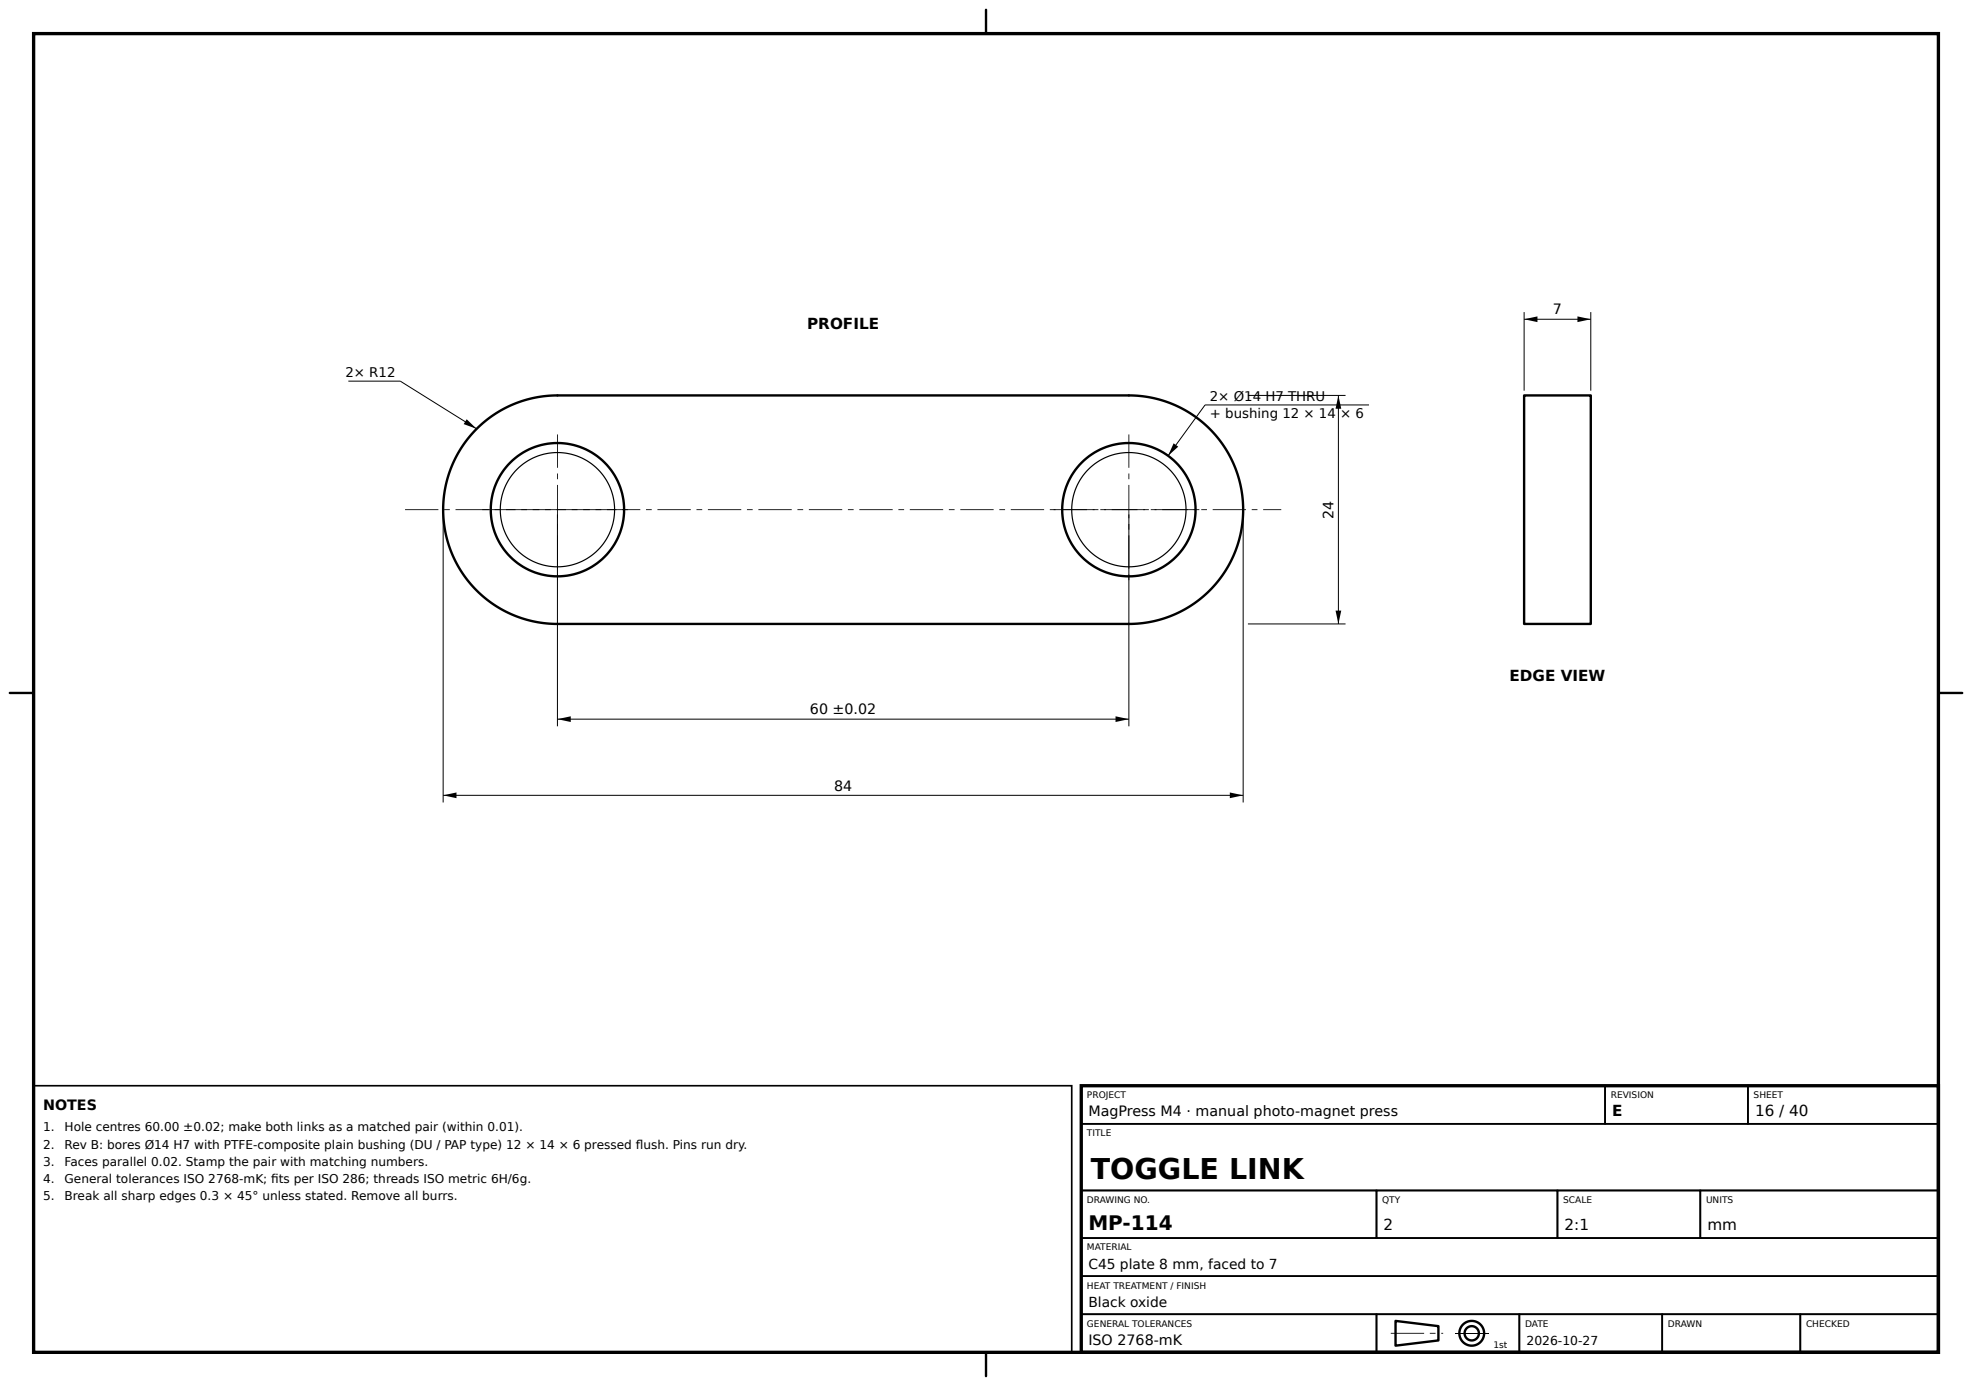
[picture p67: page 16]
PROFILE; 2× Ø14 H7 THRU + bushing 12 × 14 × 6; EDGE VIEW; REVISION E; SHEET 16 / 40; TITLE; DRAWING NO. MP-114; QTY 2; SCALE 2:1; UNITS mm; Black oxide

PROJECT
MagPress M4 · manual photo-magnet press
TOGGLE LINK

NOTES
1. Hole centres 60.00 ±0.02; make both links as a matched pair (within 0.01).
2. Rev B: bores Ø14 H7 with PTFE-composite plain bushing (DU / PAP type) 12 × 14 × 6 pressed flush. Pins run dry.
3. Faces parallel 0.02. Stamp the pair with matching numbers.
4. General tolerances ISO 2768-mK; fits per ISO 286; threads ISO metric 6H/6g.
5. Break all sharp edges 0.3 × 45° unless stated. Remove all burrs.

MATERIAL
C45 plate 8 mm, faced to 7

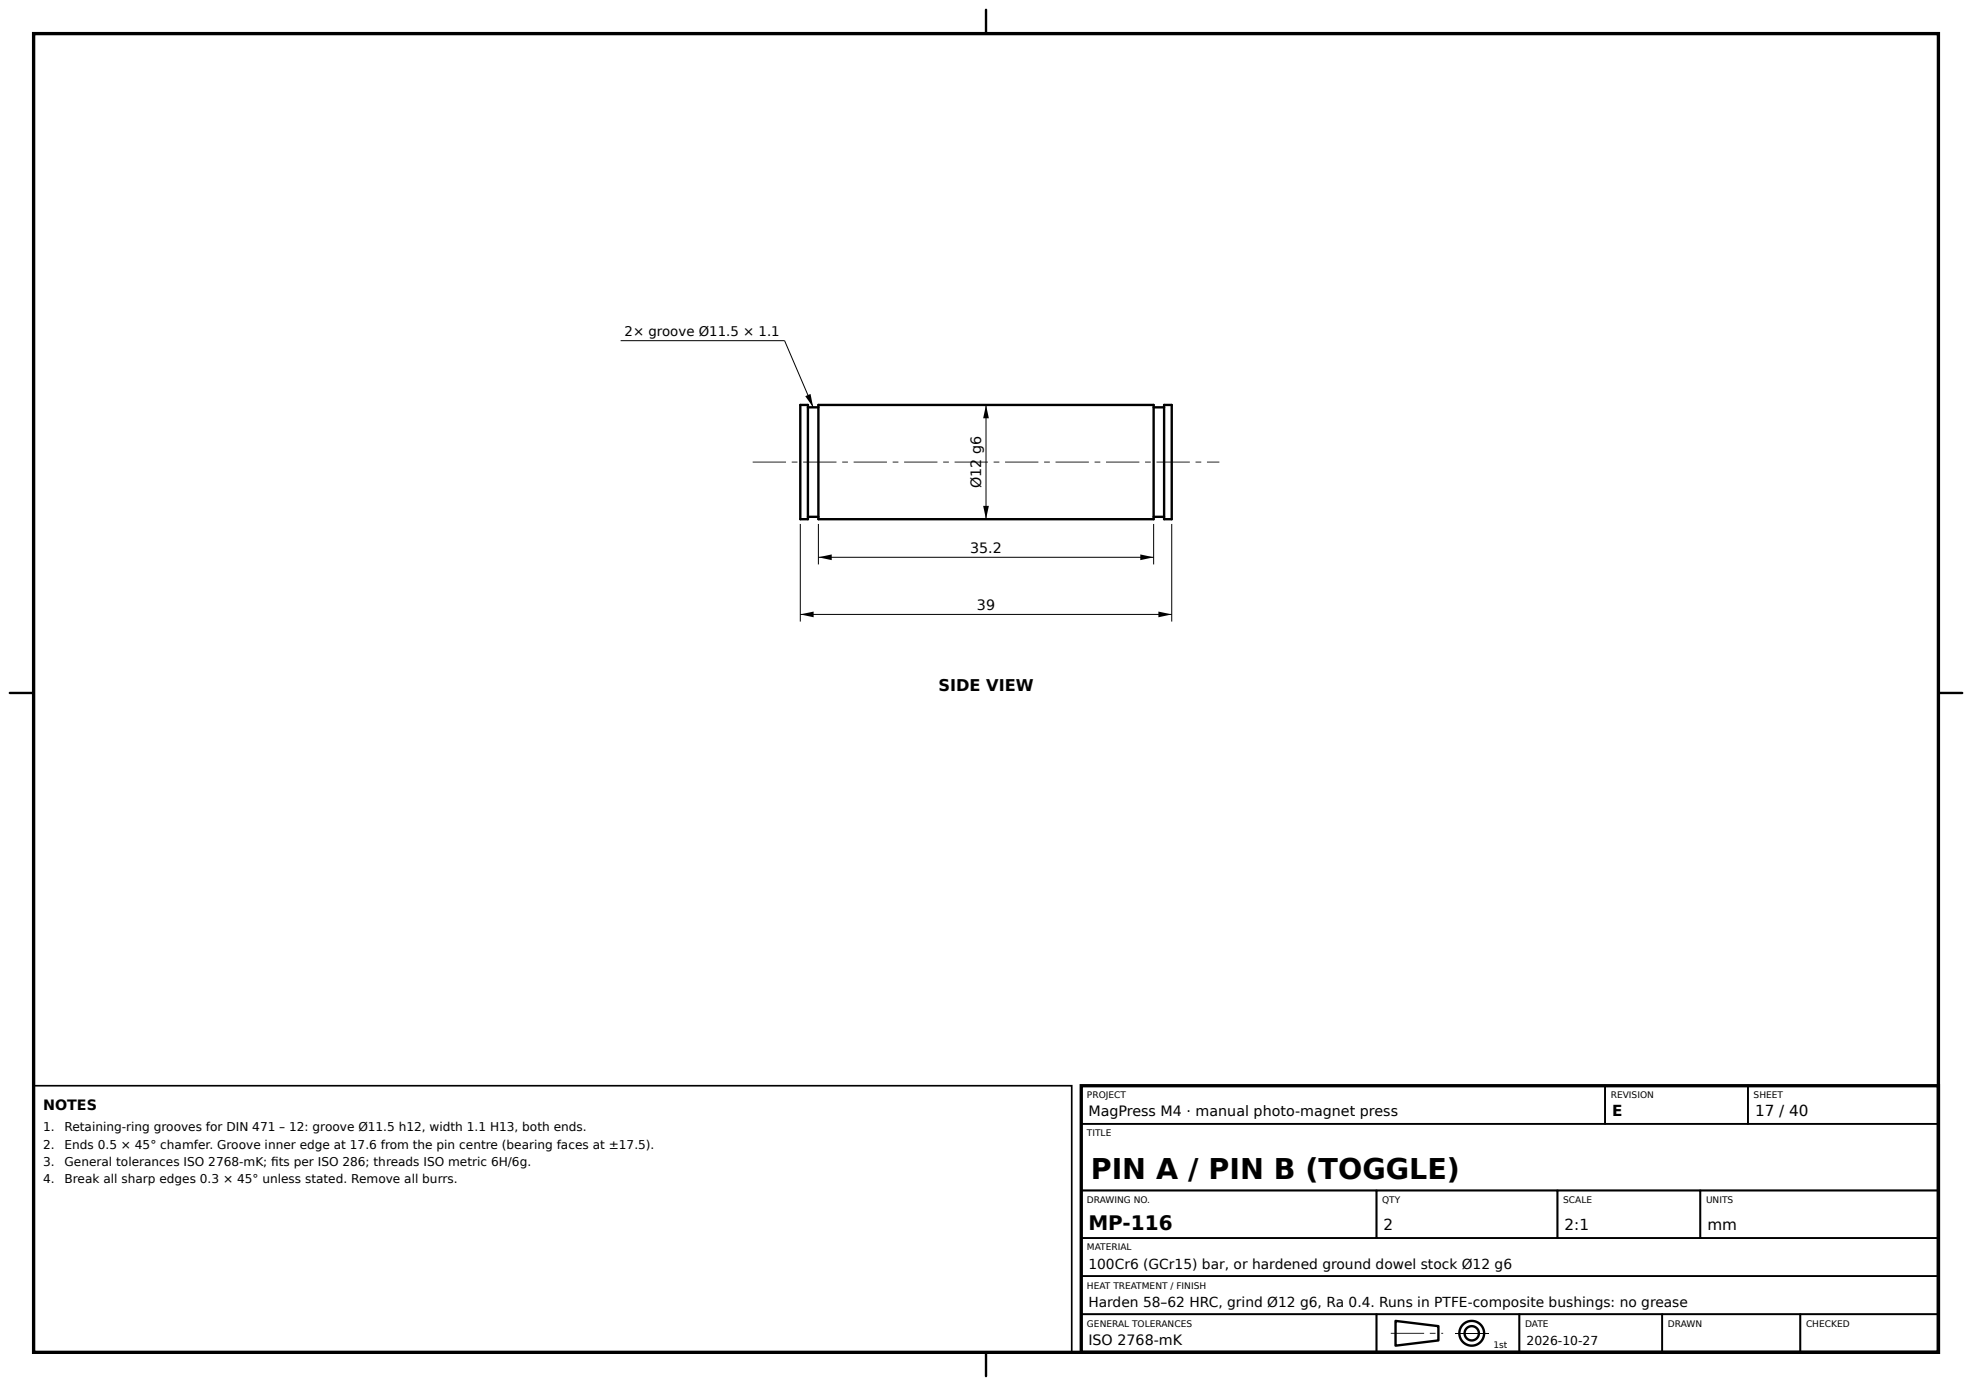
[picture p68: page 17]
2× groove Ø11.5 × 1.1; SIDE VIEW; REVISION E; SHEET 17 / 40; TITLE; DRAWING NO. MP-116; QTY 2; SCALE 2:1; UNITS mm

PROJECT
MagPress M4 · manual photo-magnet press
PIN A / PIN B (TOGGLE)

NOTES
1. Retaining-ring grooves for DIN 471 – 12: groove Ø11.5 h12, width 1.1 H13, both ends.
2. Ends 0.5 × 45° chamfer. Groove inner edge at 17.6 from the pin centre (bearing faces at ±17.5).
3. General tolerances ISO 2768-mK; fits per ISO 286; threads ISO metric 6H/6g.
4. Break all sharp edges 0.3 × 45° unless stated. Remove all burrs.

MATERIAL
100Cr6 (GCr15) bar, or hardened ground dowel stock Ø12 g6

Harden 58–62 HRC, grind Ø12 g6, Ra 0.4. Runs in PTFE-composite bushings: no grease

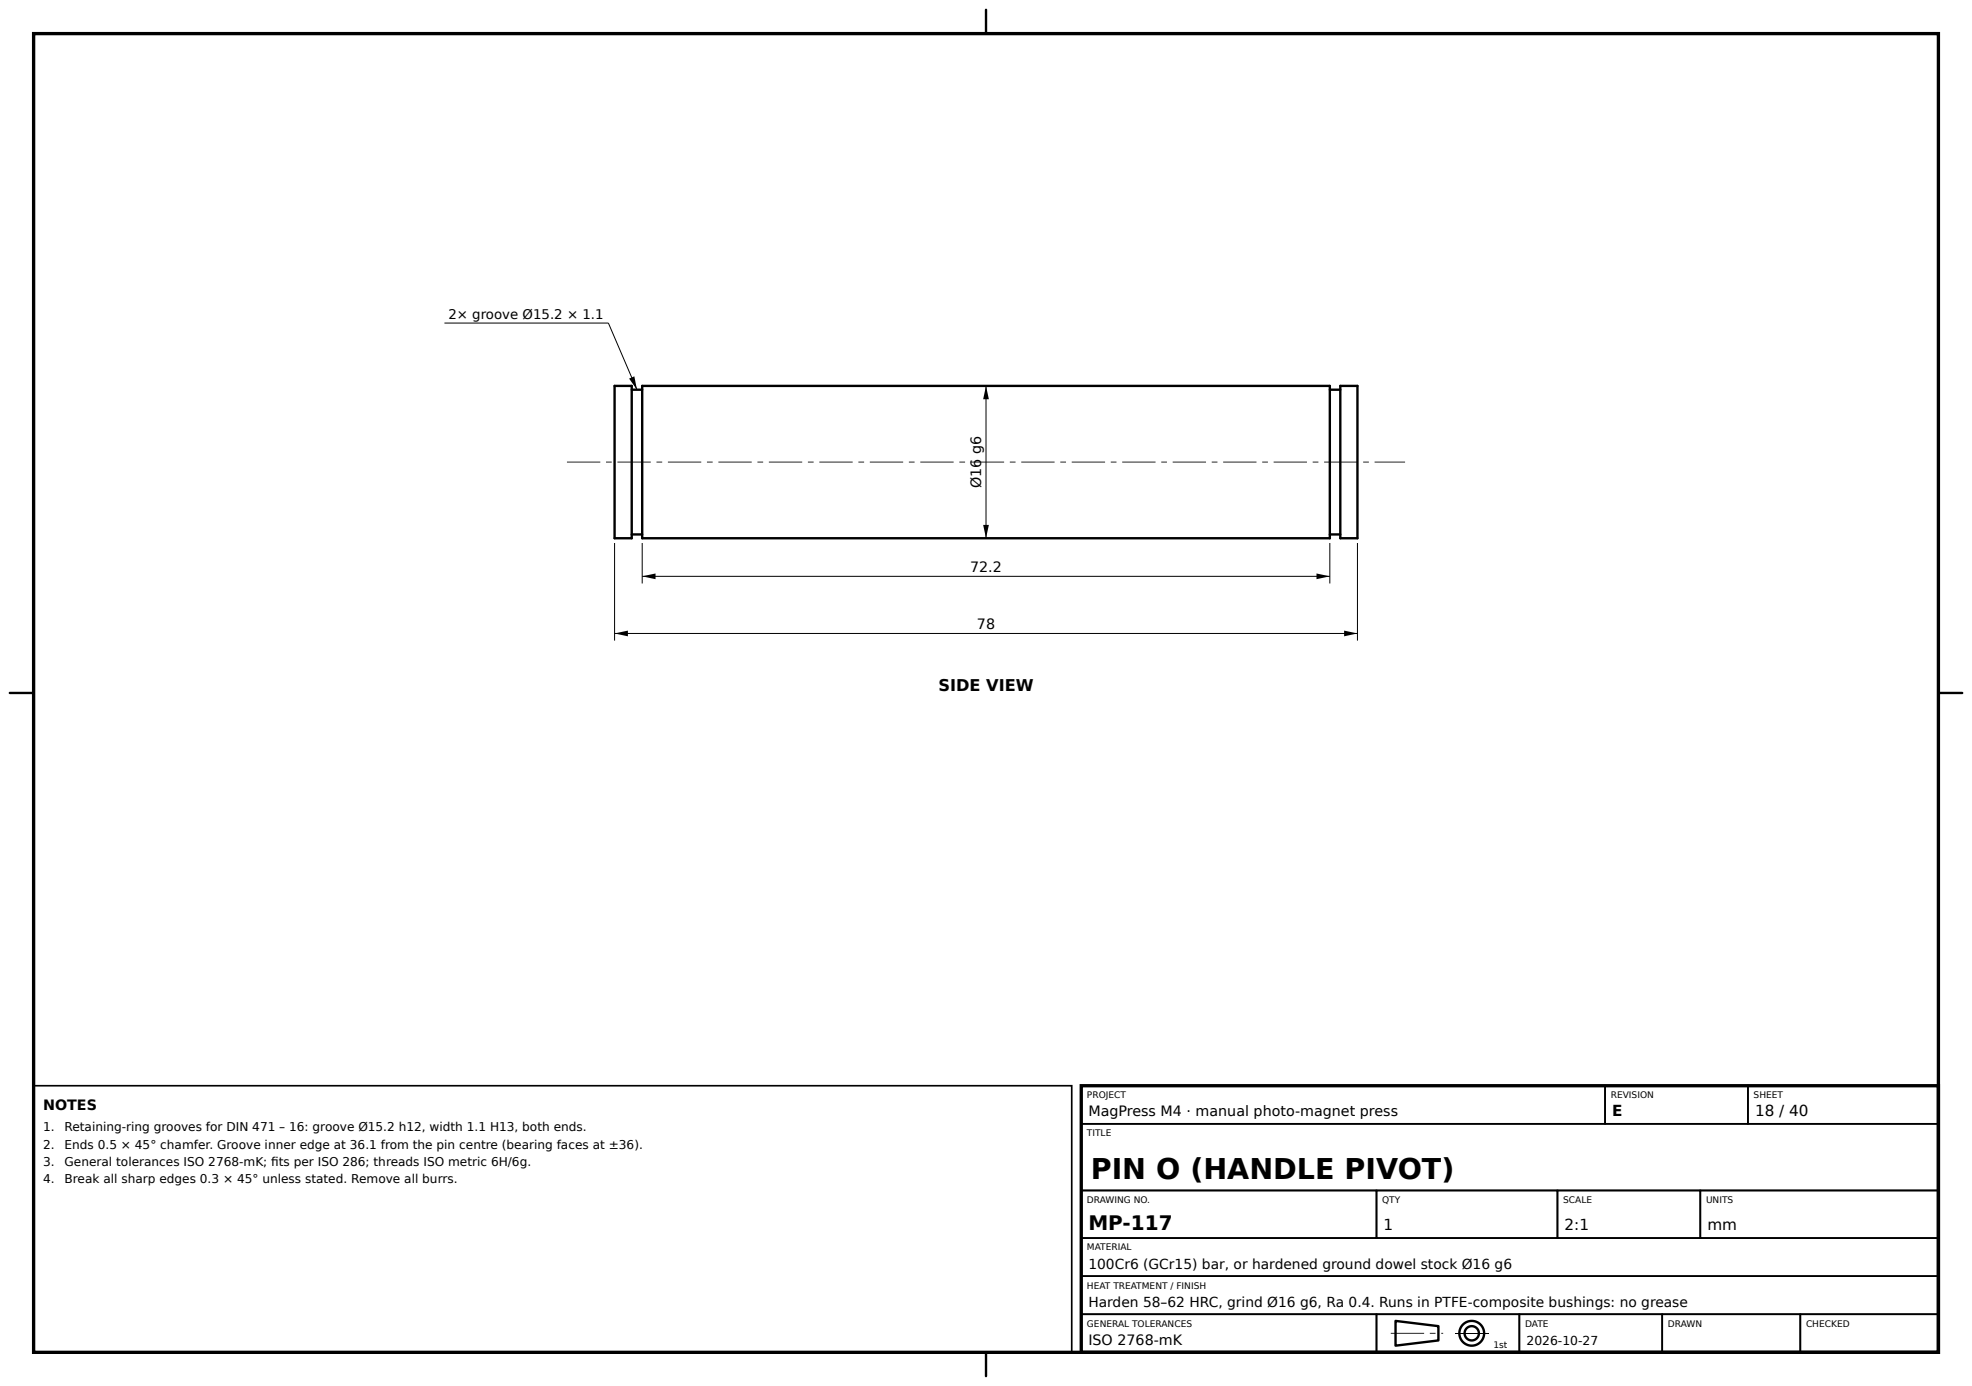
[picture p69: page 18]
2× groove Ø15.2 × 1.1; SIDE VIEW; REVISION E; SHEET 18 / 40; TITLE; DRAWING NO. MP-117; QTY 1; SCALE 2:1; UNITS mm

PROJECT
MagPress M4 · manual photo-magnet press
PIN O (HANDLE PIVOT)

NOTES
1. Retaining-ring grooves for DIN 471 – 16: groove Ø15.2 h12, width 1.1 H13, both ends.
2. Ends 0.5 × 45° chamfer. Groove inner edge at 36.1 from the pin centre (bearing faces at ±36).
3. General tolerances ISO 2768-mK; fits per ISO 286; threads ISO metric 6H/6g.
4. Break all sharp edges 0.3 × 45° unless stated. Remove all burrs.

MATERIAL
100Cr6 (GCr15) bar, or hardened ground dowel stock Ø16 g6

Harden 58–62 HRC, grind Ø16 g6, Ra 0.4. Runs in PTFE-composite bushings: no grease

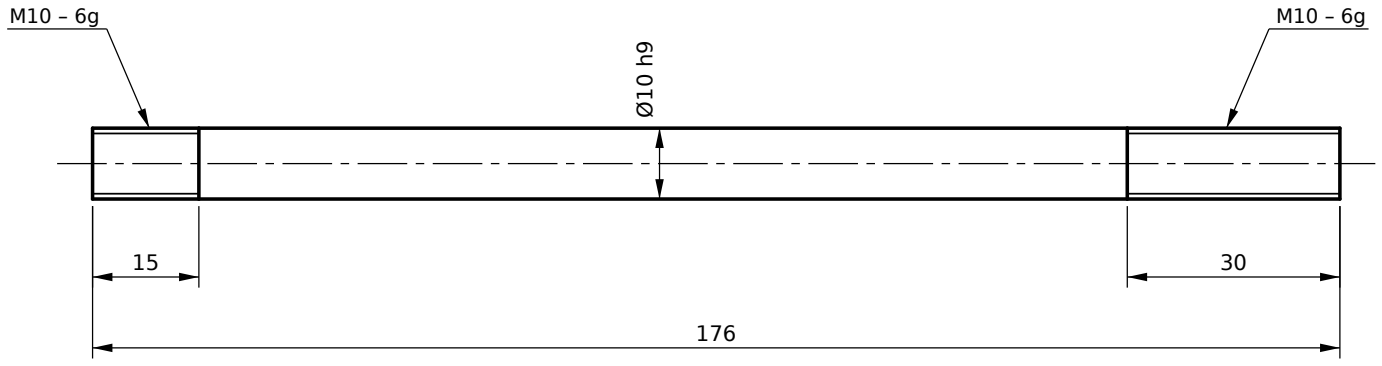
[picture p70: figure]

### SIDE VIEW

PROJECT
MagPress M4 · manual photo-magnet press

REVISION
E

SHEET
19 / 40

TITLE

# RETURN ROD

DRAWING NO.
MP-118

QTY
2

SCALE
1:1

UNITS
mm

MATERIAL
C45 Ø12 bright bar

Zinc plate 8 µm

NOTES
1. Bottom thread screws into the ram MP-109 (M10 × 15) with Loctite 243.
2. Return spring: music wire Ø3.5 (EN 10270-1 DH), OD 31.5, free length 128, ≈ 16.4 active coils, ends closed and ground, shot-peened.
3. Rate ≈ 4.25 N/mm. Installed 109.5 at handle-up (≈ 80 N); 70.6 at handle-down (≈ 245 N, τ ≈ 480 MPa). Solid length ≤ 64.5.
4. Top: Ø32 × 3 washer and M10 nylock nut. The two springs together must lift the handle from the fully-down position.
5. Rev E: two flats 8 a/f, 6 long, just above the bottom thread (to tighten the rod). A POM guide sleeve Ø24 × Ø10.5 × 60 (BUY-49) on each rod centres the spring and stops it buckling.
6. General tolerances ISO 2768-mK; fits per ISO 286; threads ISO metric 6H/6g.
7. Break all sharp edges 0.3 × 45° unless stated. Remove all burrs.

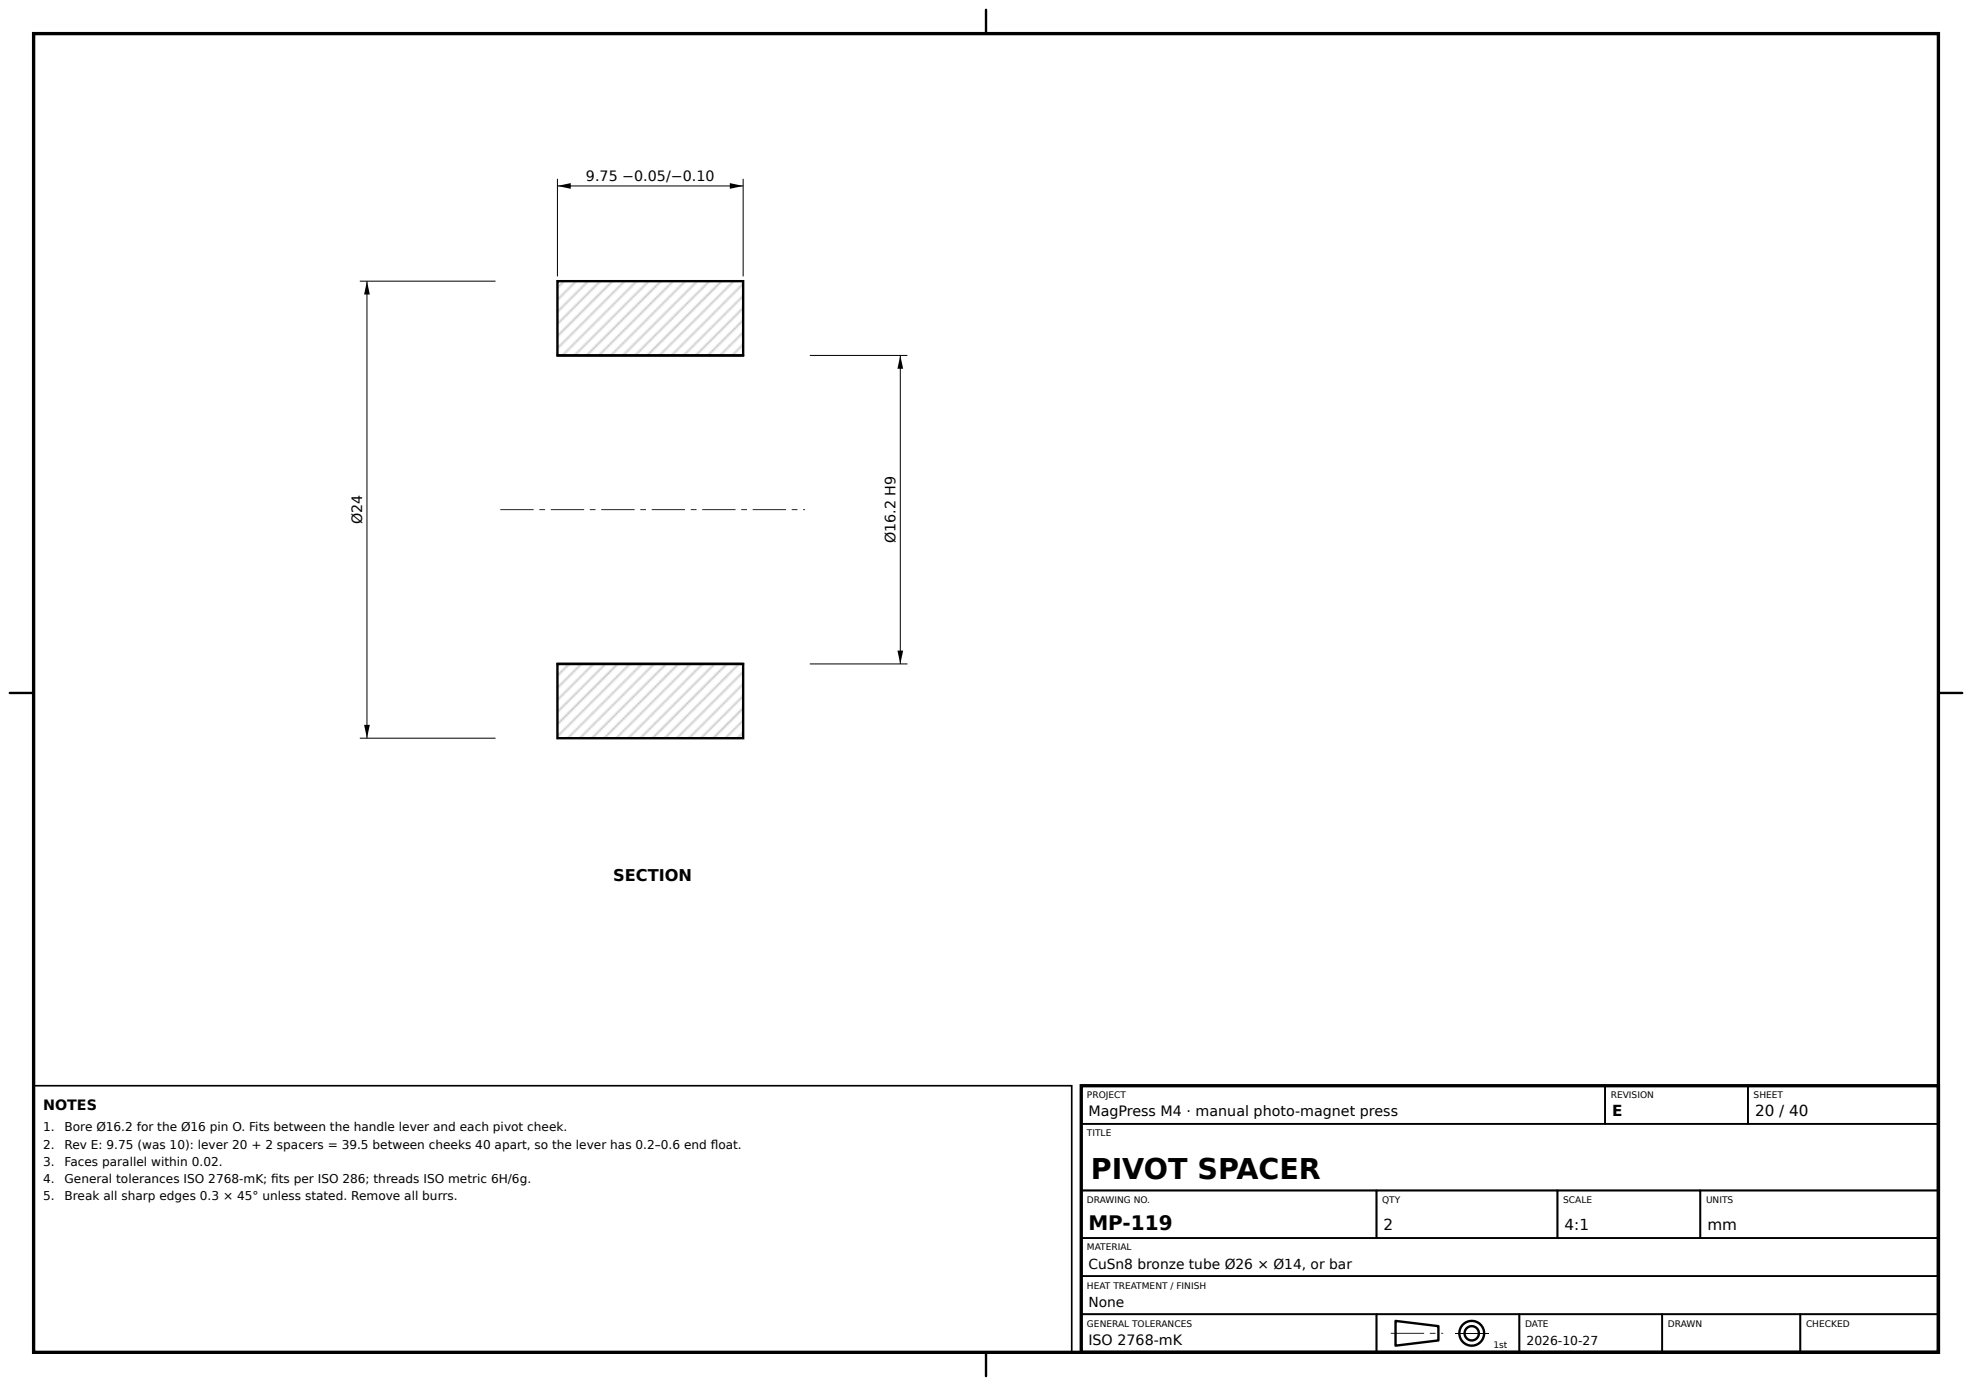
[picture p71: page 20]
SECTION; REVISION E; SHEET 20 / 40; TITLE; DRAWING NO. MP-119; QTY 2; SCALE 4:1; UNITS mm; None

PROJECT
MagPress M4 · manual photo-magnet press
PIVOT SPACER

NOTES
1. Bore Ø16.2 for the Ø16 pin O. Fits between the handle lever and each pivot cheek.
2. Rev E: 9.75 (was 10): lever 20 + 2 spacers = 39.5 between cheeks 40 apart, so the lever has 0.2–0.6 end float.
3. Faces parallel within 0.02.
4. General tolerances ISO 2768-mK; fits per ISO 286; threads ISO metric 6H/6g.
5. Break all sharp edges 0.3 × 45° unless stated. Remove all burrs.

MATERIAL
CuSn8 bronze tube Ø26 × Ø14, or bar

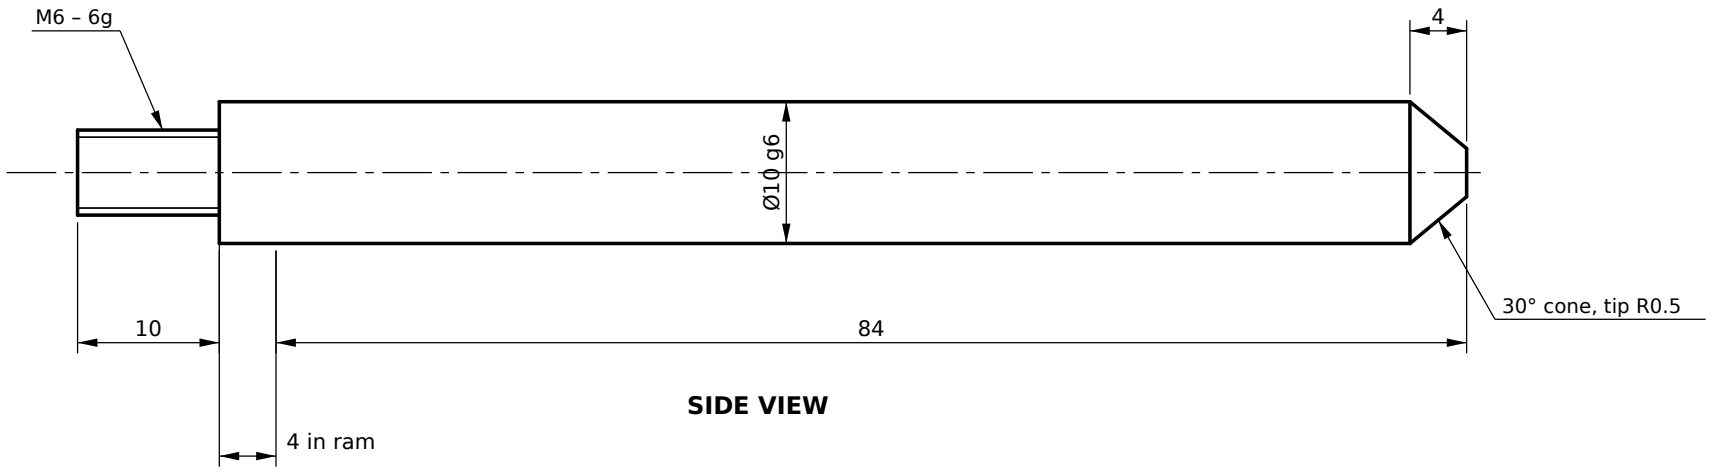
[picture p72: figure]
4 in ram; 30° cone, tip R0.5; SIDE VIEW

PROJECT
MagPress M4 · manual photo-magnet press

REVISION
E

SHEET
21 / 40

TITLE

# STATION PILOT

DRAWING NO.
MP-120

QTY
1

SCALE
2:1

UNITS
mm

MATERIAL
42CrMo4 Ø12 bar, QT 28–32 HRC

Grind Ø10 g6, Ra 0.4; tip nitrided or hard chrome

NOTES
1. Rev E: Ø10 in tough 42CrMo4 (was Ø8 hardened 100Cr6): if the table is held off station it bends, it does not snap. The Ø10 g6 body locates in the ram (Ø10 H7 × 4); the M6 thread only clamps.
2. Screwed into the ram underside (MP-109, hole PL) with Loctite 243 until the shoulder seats; tip 84 below the ram.
3. Enters the die table hole PA or PB 6 mm before the dies touch. If the table is more than about 2 mm off a station, the tip lands on the table and stops the stroke with the dies still 6 mm apart.
4. Within ±2 mm, the 30° tip pulls the table onto the exact station (±0.02).
5. Tip: 30° half-angle cone, 4 long, tip radius R0.5, polished.
6. General tolerances ISO 2768-mK; fits per ISO 286; threads ISO metric 6H/6g.
7. Break all sharp edges 0.3 × 45° unless stated. Remove all burrs.

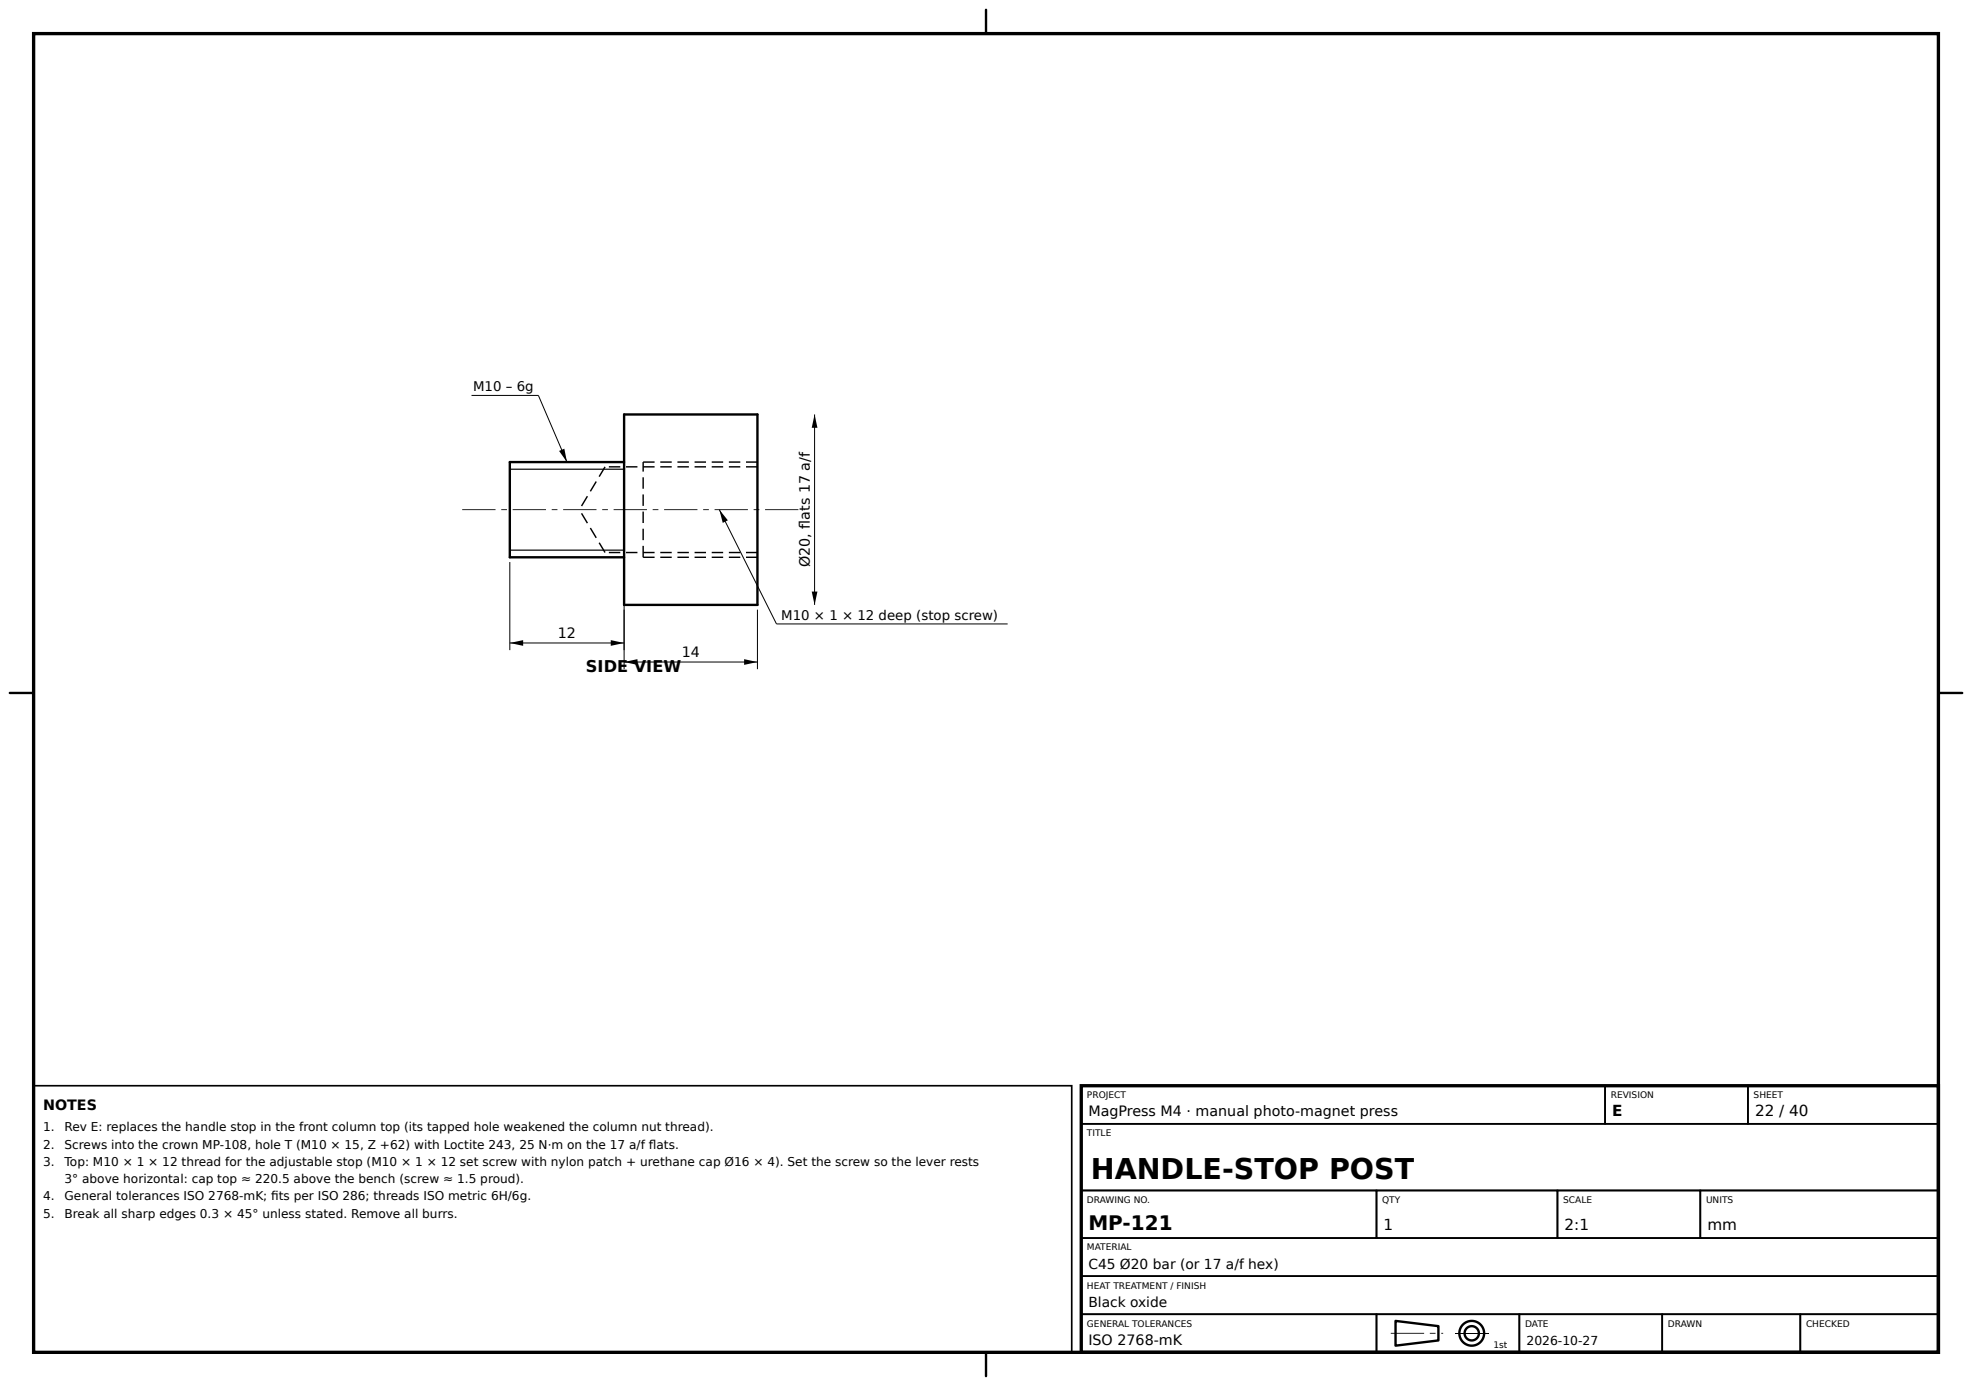
[picture p73: page 22]
Ø20, flats 17 a/f; SIDE VIEW; REVISION E; SHEET 22 / 40; TITLE; DRAWING NO. MP-121; QTY 1; SCALE 2:1; UNITS mm; Black oxide

M10 × 1 × 12 deep (stop screw)

PROJECT
MagPress M4 · manual photo-magnet press
HANDLE-STOP POST

NOTES
1. Rev E: replaces the handle stop in the front column top (its tapped hole weakened the column nut thread).
2. Screws into the crown MP-108, hole T (M10 × 15, Z +62) with Loctite 243, 25 N·m on the 17 a/f flats.
3. Top: M10 × 1 × 12 thread for the adjustable stop (M10 × 1 × 12 set screw with nylon patch + urethane cap Ø16 × 4). Set the screw so the lever rests
3° above horizontal: cap top ≈ 220.5 above the bench (screw ≈ 1.5 proud).
4. General tolerances ISO 2768-mK; fits per ISO 286; threads ISO metric 6H/6g.
5. Break all sharp edges 0.3 × 45° unless stated. Remove all burrs.

MATERIAL
C45 Ø20 bar (or 17 a/f hex)

HS | W
D | D

K

D2 | D2

K2

R

R

R

R

O

### PLAN (TOP) — front at bottom

144

116

125

98.5

S: Ø12 H7 × 6 + M10 THRU (shank)

A A

20

### SECTION A–A

B B

### SECTION B–B (Z = ±49.25)

L: Ø6 H8 from the LEFT end face to X −7, at Z +7,
4 above the bottom face (detent pin, inserted from the left)

FEATURES (positions from the part centre, +Z = front)

KEY | POSITIONS (X, Z) | FEATURE
H | centre | Ø54 × 10 from the TOP (room for the shim pack and the die holder MP-111)
W | X +27 → +72 | Slot 10 wide × 10 deep from the TOP, H to the +X end (key for the lock screw)
S | centre | Ø12 H7 × 6 below the floor of H (shank spigot), then M10 THRU (shank MP-202)
D | (±20, −10) | Ø5 F7 × 6 from the BOTTOM (square-kit plug dowels; drop-in fit)
K | (−18, +13.8) | Ø10.5 × 8 from the BOTTOM (plug stud MP-212, square kits)
D2 | (±12, −12) | Ø5 F7 × 6 from the BOTTOM (round-kit plug dowels; drop-in fit)
K2 | (−13, +0.2) | Ø10.5 × 8 from the BOTTOM (round-kit plug stud)
L | Z +7, X −72 → −7 | Ø6 H8 along X from the LEFT end, 4 up; detent groove 0.4 deep, 4 from the end
R | (±62.5, ±49.25) | M5 THRU (carrier shoulder screws ISO 7379 Ø6 × 10)
P | (±30, ±49.25), (±62.5, ±25) | Ø13 × 18 from the BOTTOM (8 upper springs ISO 10243 Ø12.5 × 44 red)
O | (0, +20) | Ø4 H7 × 6 below the floor of H (orientation pin Ø4 m6 × 10)

PROJECT
MagPress M4 · manual photo-magnet press

REVISION
E

SHEET
23 / 40

TITLE

# UPPER DIE BODY (UNIVERSAL)

DRAWING NO.
MP-201

QTY

### 1 per press

SCALE
1:1

UNITS
mm

MATERIAL
1.2312 (P20+S) prehardened 28–32 HRC

Black oxide

NOTES
1. Universal die part: one per press, the same for every magnet size. X = along the die table, +Z = front.
2. Laser-mark the drawing number on a side face.
3. The plug hangs on dowels D and the stud K, held by a Ø6 quick-release detent pin in hole L: no screws to change a size. Round kits use the inner pattern D2 + K2.
4. Rev E: pin L runs along X from the left end face (Rev D ran it from the front face, where the front column blocked it). K and K2 sit 6.8 either side of its axis, so one pin holds either stud. D, D2 are F7: the plug dowels drop in by hand.
5. Floor of H (seat against the holder through the shim pack) and bottom face parallel 0.01, flat 0.01. The shim pack sets the crimp depth once for all kits.
6. Rev E: 20 thick (was 10) for longer, stronger upper springs: 8 × ISO 10243 Ø12.5 × 44 red in 36 mm cavities, 8 mm preload (≈ 1.57 kN total), ≈ 2.54 kN at full retraction (29%). They hold the upper ring while stroke 1 folds the flat tin blank (up to ≈ 1.7 kN). Replace every 100,000 strokes. Top
face 2 mm below the ram.
7. General tolerances ISO 2768-mK; fits per ISO 286; threads ISO metric 6H/6g.
8. Break all sharp edges 0.3 × 45° unless stated. Remove all burrs.

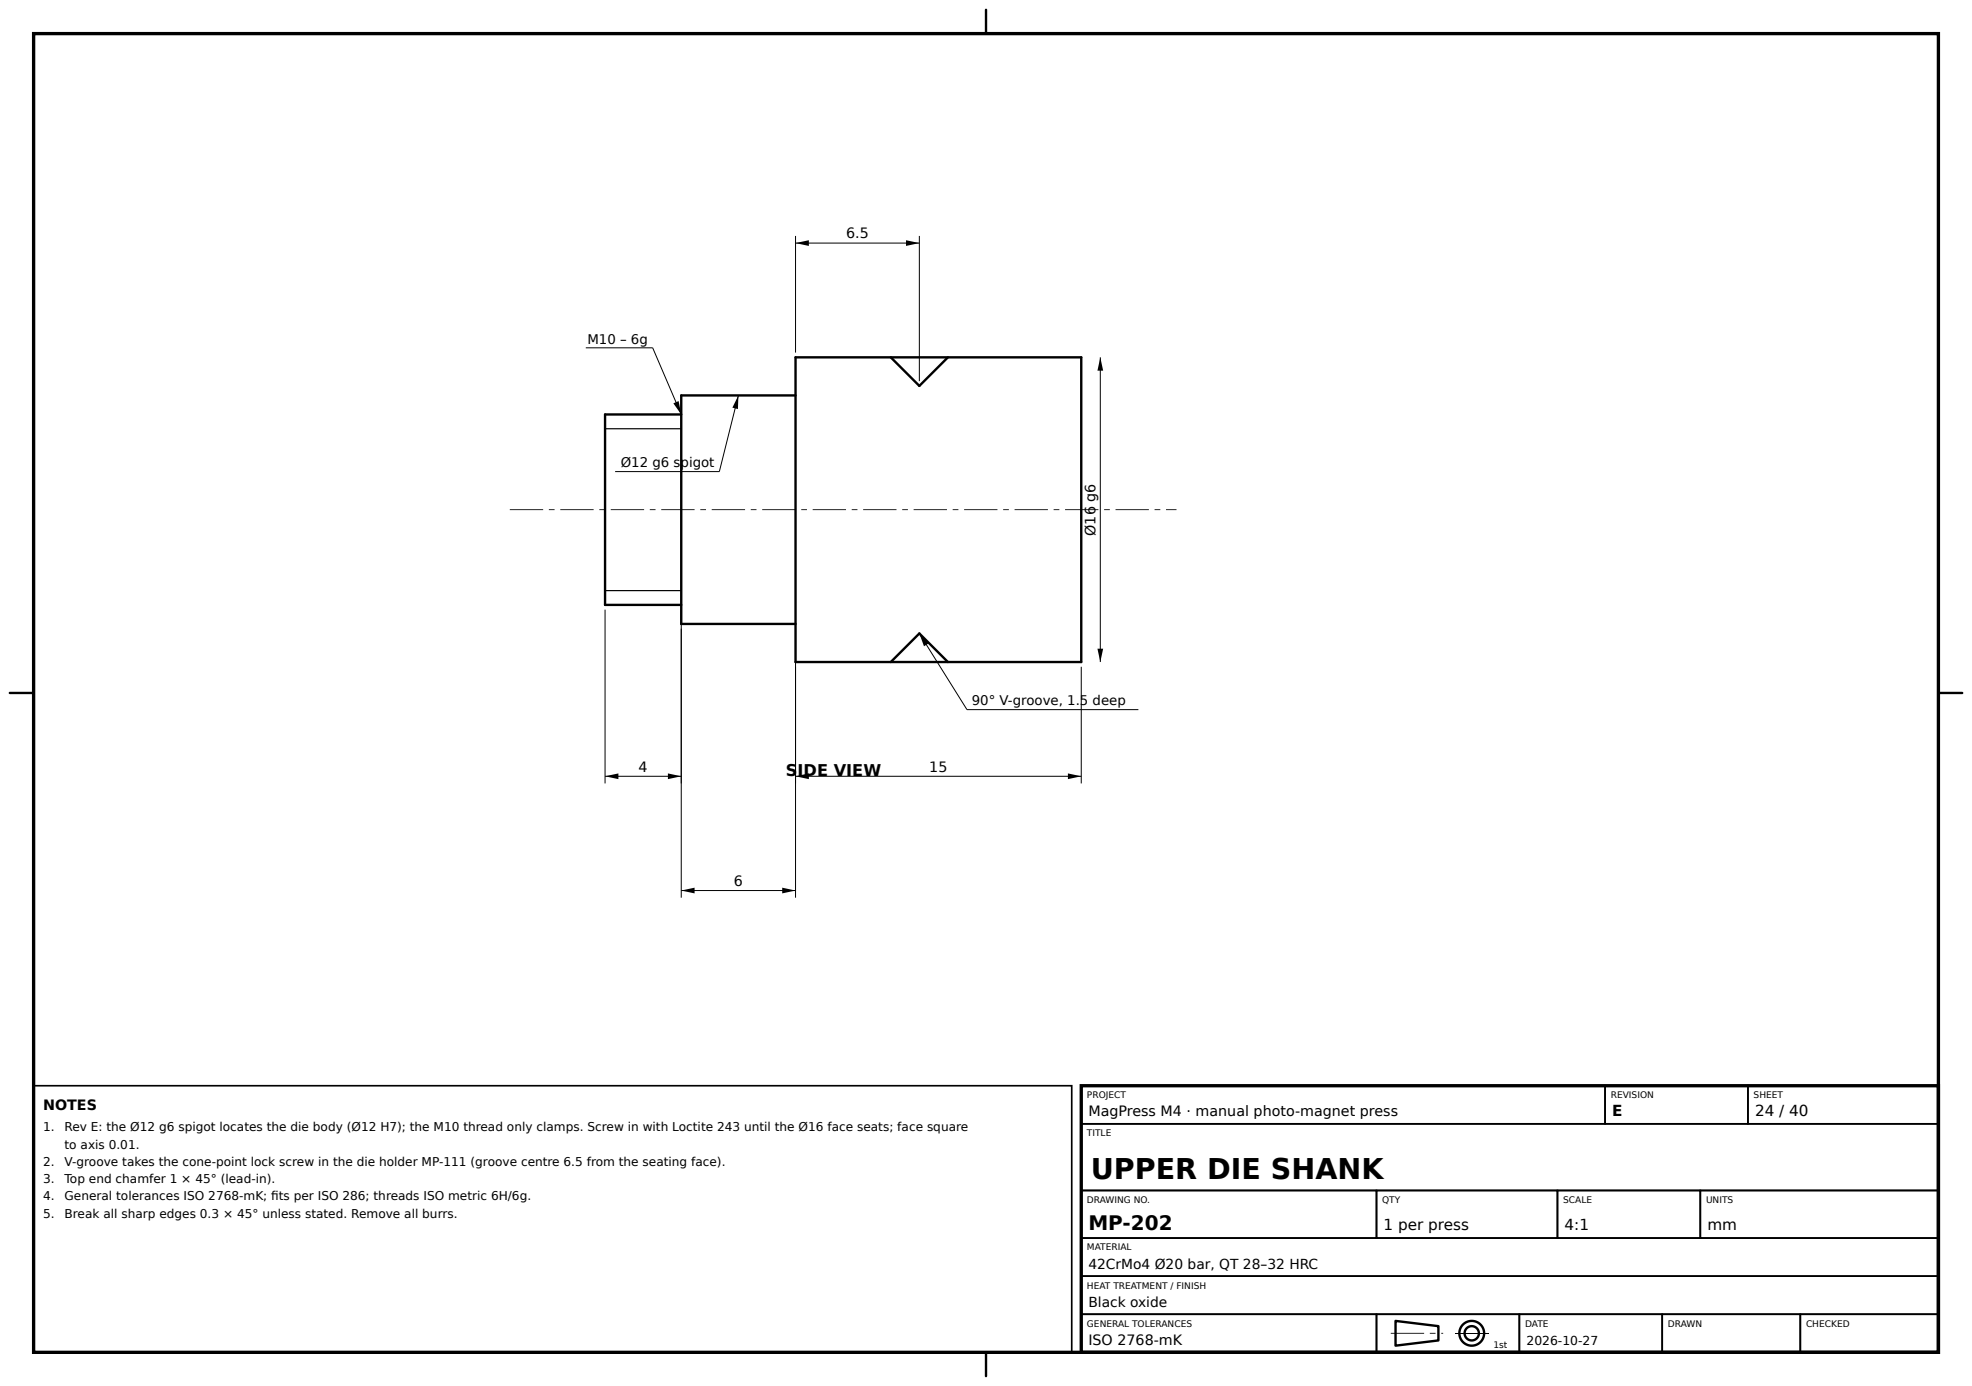
[picture p74: page 24]
Ø12 g6 spigot; 90° V-groove, 1.5 deep; SIDE VIEW; REVISION E; SHEET 24 / 40; TITLE; DRAWING NO. MP-202; QTY 1 per press; SCALE 4:1; UNITS mm; Black oxide

PROJECT
MagPress M4 · manual photo-magnet press
UPPER DIE SHANK

NOTES
1. Rev E: the Ø12 g6 spigot locates the die body (Ø12 H7); the M10 thread only clamps. Screw in with Loctite 243 until the Ø16 face seats; face square
to axis 0.01.
2. V-groove takes the cone-point lock screw in the die holder MP-111 (groove centre 6.5 from the seating face).
3. Top end chamfer 1 × 45° (lead-in).
4. General tolerances ISO 2768-mK; fits per ISO 286; threads ISO metric 6H/6g.
5. Break all sharp edges 0.3 × 45° unless stated. Remove all burrs.

MATERIAL
42CrMo4 Ø20 bar, QT 28–32 HRC

### PLAN (TOP) — front at bottom

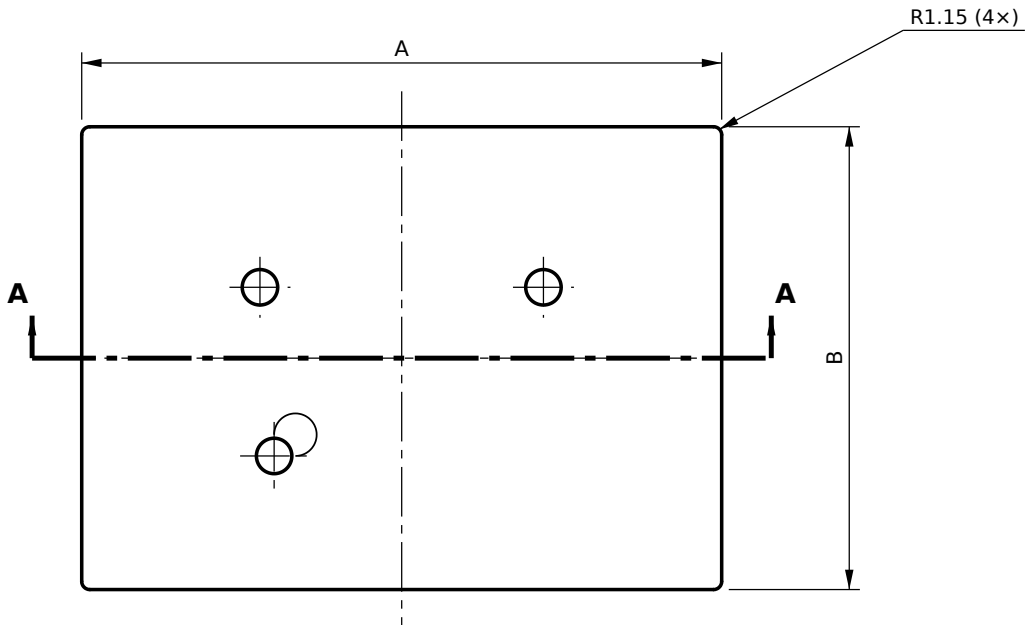
[picture p75: figure]

14.5

### SECTION A–A

DETAIL Y (5:1) working edge concave lip R1, 1.5 wide × 0.5 deep all round the bottom face

DIMENSION TABLE (mm)

SIZE | X | Z | A | B
5050 | 50 | 50 | 50.3 | 50.3
6363 | 63.5 | 63.5 | 63.8 | 63.8
5380 | 80 | 53 | 80.3 | 53.3
6590 | 90 | 65 | 90.3 | 65.3

Size code = magnet face: 5050 = 50 × 50, 6363 = 63.5 × 63.5, 5380 = 53 × 80, 6590 = 65 × 90. A = X + 0.30 (plug length, ±0.01)
B = Z + 0.30 (plug width, ±0.01)

FEATURES (positions from the part centre, +Z = front)

KEY | POSITIONS (X, Z) | FEATURE
S | (−18, +13.8) | M6 × 10 from the TOP (stud MP-212, Loctite 243)
D | (±20, −10) | Ø5 H7 × 8 from the TOP (dowels Ø5 m6 × 14: +X cylindrical, −X diamond)

PROJECT
MagPress M4 · manual photo-magnet press

REVISION
E

SHEET
25 / 40

TITLE

# PLUG (SIZE KIT)

DRAWING NO.
MP-203

QTY

### 1 per size kit (4)

SCALE

### 1:1 (size 6590)

UNITS
mm

MATERIAL
A2 / 1.2363 tool steel; 7075-T6 for the prototype kit; PM cold-work steel for high volume

Harden 58–60 HRC, temper ×2; wire-EDM + 2 skim cuts, then re-temper; forming edges Ra 0.2; thin dense chrome

NOTES
1. Size kit part: one per magnet size, tabulated below. Shown to scale for size 6590 (65 × 90). X = long side, along the die table.
2. Laser-mark on a side face: drawing no., size code and U / A / B where applicable (e.g. "MP-207 6590 A").
3. No screws. Two Ø5 × 14 dowels pressed in (5.5 protruding), one cylindrical and one diamond, locate it in the body; stud MP-212 in the M6 hole takes the detent pin.
4. Profile A × B, R1.15 (Rev E: sharp-cornered magnets): wire-EDM after hardening, ±0.01. Sliding fit in the upper ring (ring = plug + 0.05).
5. Bottom (working) face flat 0.01, Ra 0.2, lip per Detail Y. Height 14.5 ±0.01 sets the 5.5 recess in the ring.
6. General tolerances ISO 2768-mK; fits per ISO 286; threads ISO metric 6H/6g.
7. Break all sharp edges 0.3 × 45° unless stated. Remove all burrs.

Y

Y

Y

Y

### PLAN (TOP) — front at bottom

106

81

C

D

A A

14

### SECTION A–A

B B

### SECTION B–B (Z = ±20)

N: 4× M3 radial (ball plungers)
1.8 above the BOTTOM face, at X = ±E/2

M: Ø3.6 × 3.5 hole, both X ends, 7 above the bottom face (dog-point thumb screws)

Y: corner relief Ø1.2 THRU on each corner of the opening (paper folded at the corner)

DETAIL P (5:1) bottom inner edge

opening

lead-in 0.3 × 30° all round, polished

M3 plunger hole, centre 1.8

DIMENSION TABLE (mm)

SIZE | X | Z | C | D | E
5050 | 50 | 50 | 50.35 | 50.35 | 25
6363 | 63.5 | 63.5 | 63.85 | 63.85 | 31.75
5380 | 80 | 53 | 80.35 | 53.35 | 40
6590 | 90 | 65 | 90.35 | 65.35 | 45

Size code = magnet face: 5050 = 50 × 50, 6363 = 63.5 × 63.5, 5380 = 53 × 80, 6590 = 65 × 90. C = X + 0.35 (opening, +0.01/0)
D = Z + 0.35 (opening, +0.01/0)
E = X / 2 (pitch of the plungers in X)

FEATURES (positions from the part centre, +Z = front)

KEY | POSITIONS (X, Z) | FEATURE
K | (0, ±41.5) | Key slot R2.1, centre 1.0 outside the face, full height, on both long faces
M | (±53, 0) | Ø3.6 × 3.5 deep, 7 above the bottom face (dog-point thumb screws)
N | (±E/2, long faces) | M3 radial THRU, 1.8 above the bottom face (ball plungers)
Y | opening corners | Ø1.2 THRU on each corner of the opening (corner relief)

PROJECT
MagPress M4 · manual photo-magnet press

REVISION
E

SHEET
26 / 40

TITLE

# UPPER RING (SIZE KIT)

DRAWING NO.
MP-204

QTY

### 1 per size kit (4)

SCALE

### 1:1 (size 6590)

UNITS
mm

MATERIAL
A2 / 1.2363 tool steel; 7075-T6 for the prototype kit; PM cold-work steel for high volume

Harden 58–60 HRC, temper ×2; wire-EDM + 2 skim cuts, then re-temper; forming edges Ra 0.2; thin dense chrome

NOTES
1. Size kit part: one per magnet size, tabulated below. Shown to scale for size 6590 (65 × 90). X = long side, along the die table.
2. Laser-mark on a side face: drawing no., size code and U / A / B where applicable (e.g. "MP-207 6590 A").
3. Outside 106 × 81 (−0.01/−0.02) for every size: fits the upper carrier MP-210 pocket. Key slots K (R2.1, centre 1.0 outside the face) take the carrier pins.
4. Opening C × D, R1.2, with corner reliefs Y, THRU: wire-EDM after hardening, lap Ra 0.2. Bottom inner lead-in 0.3 × 30° (Detail P): Rev E, a short lead-in so the wrapped shell is gripped over 2.5 mm of straight wall. It is also the die edge the flat tin blank folds over in stroke 1: polish it.
5. Held by 2 dog-point thumb screws in holes M (Rev E: dog points take the load in shear; cone points brinelled their dimples). Four M3 ball plungers N protrude 0.2–0.3 into the opening at 1.8, on the straight wall of the shell.
6. General tolerances ISO 2768-mK; fits per ISO 286; threads ISO metric 6H/6g.
7. Break all sharp edges 0.3 × 45° unless stated. Remove all burrs.

### PLAN (TOP) — front at bottom

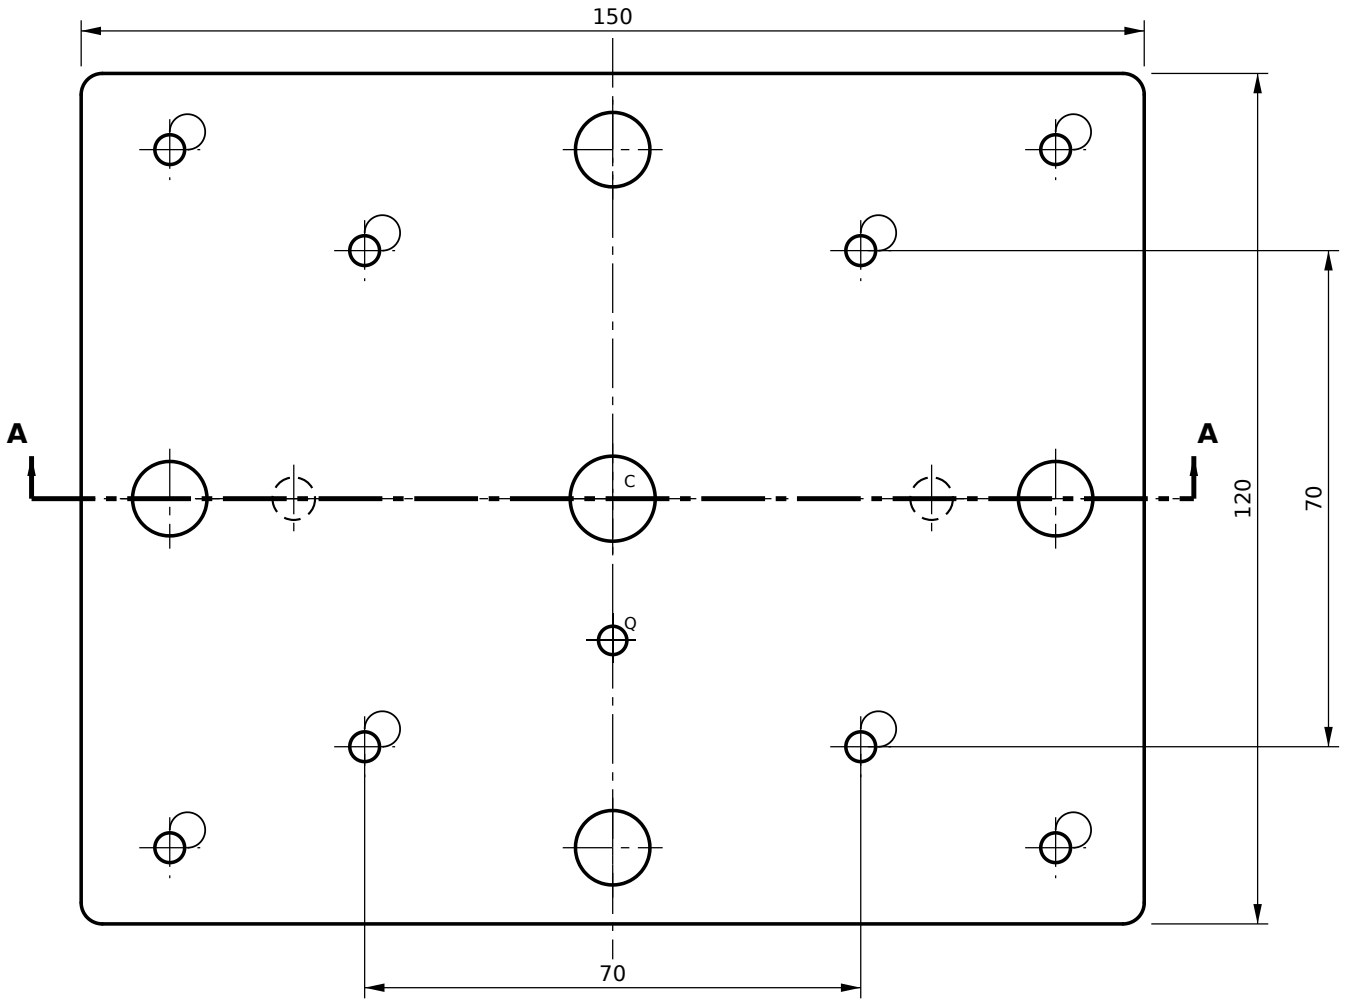
[picture p76: figure]

10

### SECTION A–A

FEATURES (positions from the part centre, +Z = front)

KEY | POSITIONS (X, Z) | FEATURE
C | centre | Ø12 F7 × 8 from the TOP (pedestal / anvil spigot; drop-in fit)
Q | (0, +20) | Ø4 F7 × 6 from the TOP (anti-rotation pin; drop-in fit)
P | (±62.5, 0), (0, ±49.25) | Ø10.5 × 7 from the TOP (4 lower springs)
R | (±62.5, ±49.25) | M5 THRU (carrier shoulder screws ISO 7379 Ø6 × 12)
F | (±35, ±35) | M5 THRU (fixing to the die table, M5 × 20 ISO 10642 from below)
G | (±45, 0) | Ø6 H7 × 6 from the BOTTOM (dowels Ø6 m6 × 12 into the table)

PROJECT
MagPress M4 · manual photo-magnet press

REVISION
E

SHEET
27 / 40

TITLE

# STATION BASE (UNIVERSAL)

DRAWING NO.
MP-205

QTY

### 2 per press

SCALE
1:1

UNITS
mm

MATERIAL
C45 plate 12 mm, faced to 10

Black oxide

NOTES
1. Universal die part: one per press, the same for every magnet size. X = along the die table, +Z = front.
2. Laser-mark the drawing number on a side face.
3. Both stations use this part; it stays fixed to the die table and is never removed for a size change.
4. Rev E: align each base to its carrier pocket with a setting plug through the ring pocket, clamp, then drill and ream the dowels G in place through the table. Faces parallel 0.01, flat 0.01.
5. General tolerances ISO 2768-mK; fits per ISO 286; threads ISO metric 6H/6g.
6. Break all sharp edges 0.3 × 45° unless stated. Remove all burrs.

### PLAN (TOP) — front at bottom

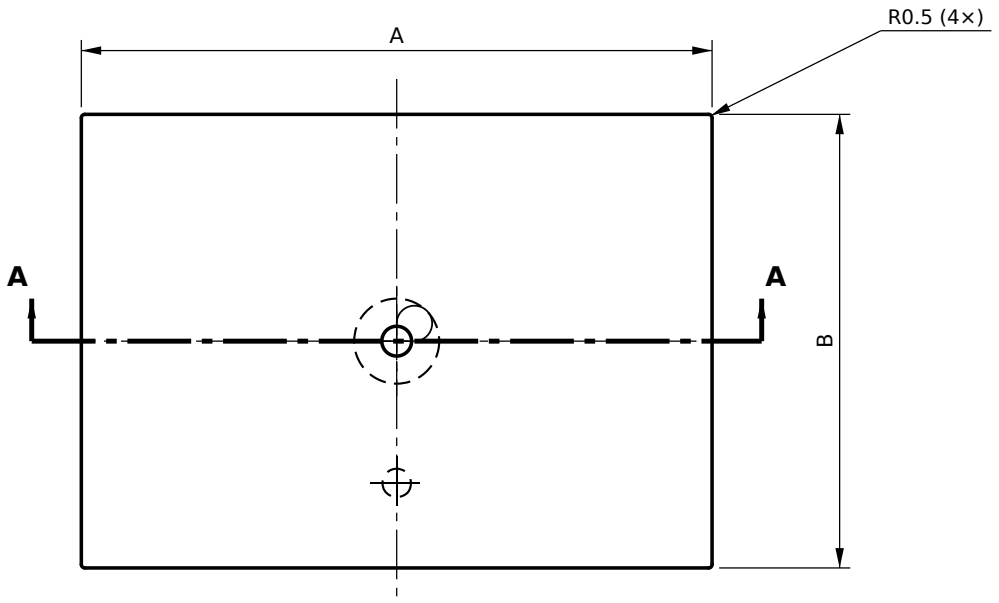
[picture p77: figure]

23

### SECTION A–A

DIMENSION TABLE (mm)

SIZE | X | Z | A | B
5050 | 50 | 50 | 49 | 49
6363 | 63.5 | 63.5 | 62.5 | 62.5
5380 | 80 | 53 | 79 | 52
6590 | 90 | 65 | 89 | 64

Size code = magnet face: 5050 = 50 × 50, 6363 = 63.5 × 63.5, 5380 = 53 × 80, 6590 = 65 × 90. A = X − 1.0 (±0.01)
B = Z − 1.0 (±0.01)

FEATURES (positions from the part centre, +Z = front)

KEY | POSITIONS (X, Z) | FEATURE
H | centre | M5 × 6 from the TOP (puller)
C | centre | Ø12 H7 × 8.5 from the BOTTOM (spigot dowel)
Q | (0, +20) | Ø4 H7 × 6 from the BOTTOM (anti-rotation pin)

PROJECT
MagPress M4 · manual photo-magnet press

REVISION
E

SHEET
28 / 40

TITLE

# PICKUP PEDESTAL (SIZE KIT)

DRAWING NO.
MP-206

QTY

### 1 per size kit (4)

SCALE

### 1:1 (size 6590)

UNITS
mm

MATERIAL
A2 / 1.2363 tool steel; 7075-T6 for the prototype kit; PM cold-work steel for high volume

Harden 58–60 HRC, temper ×2; wire-EDM + 2 skim cuts, then re-temper; forming edges Ra 0.2; thin dense chrome

NOTES
1. Size kit part: one per magnet size, tabulated below. Shown to scale for size 6590 (65 × 90). X = long side, along the die table.
2. Laser-mark on a side face: drawing no., size code and U / A / B where applicable (e.g. "MP-207 6590 A").
3. Rev E: the flat tin blank, photo and film lie in ring A's recess, 2.4 above it. In stroke 1 ring A drops and the pedestal folds the blank's edges
down into the upper ring (0.68 a side for 0.4 of tin, photo and film). Top face flat 0.01, Ra 0.2; top edge R0.8, the inside radius of the fold.
Height 23.0 ±0.02 (Rev E, was 21.8): the whole 6 mm flange is drawn into the upper ring.
4. Rev C: drop-in. Press a Ø12 m6 × 15 dowel into C (7 protruding) and a Ø4 m6 × 10 pin into Q (4 protruding). Lift out with the M5 T-handle puller in hole H.
5. General tolerances ISO 2768-mK; fits per ISO 286; threads ISO metric 6H/6g.
6. Break all sharp edges 0.3 × 45° unless stated. Remove all burrs.

### PLAN (TOP) — front at bottom

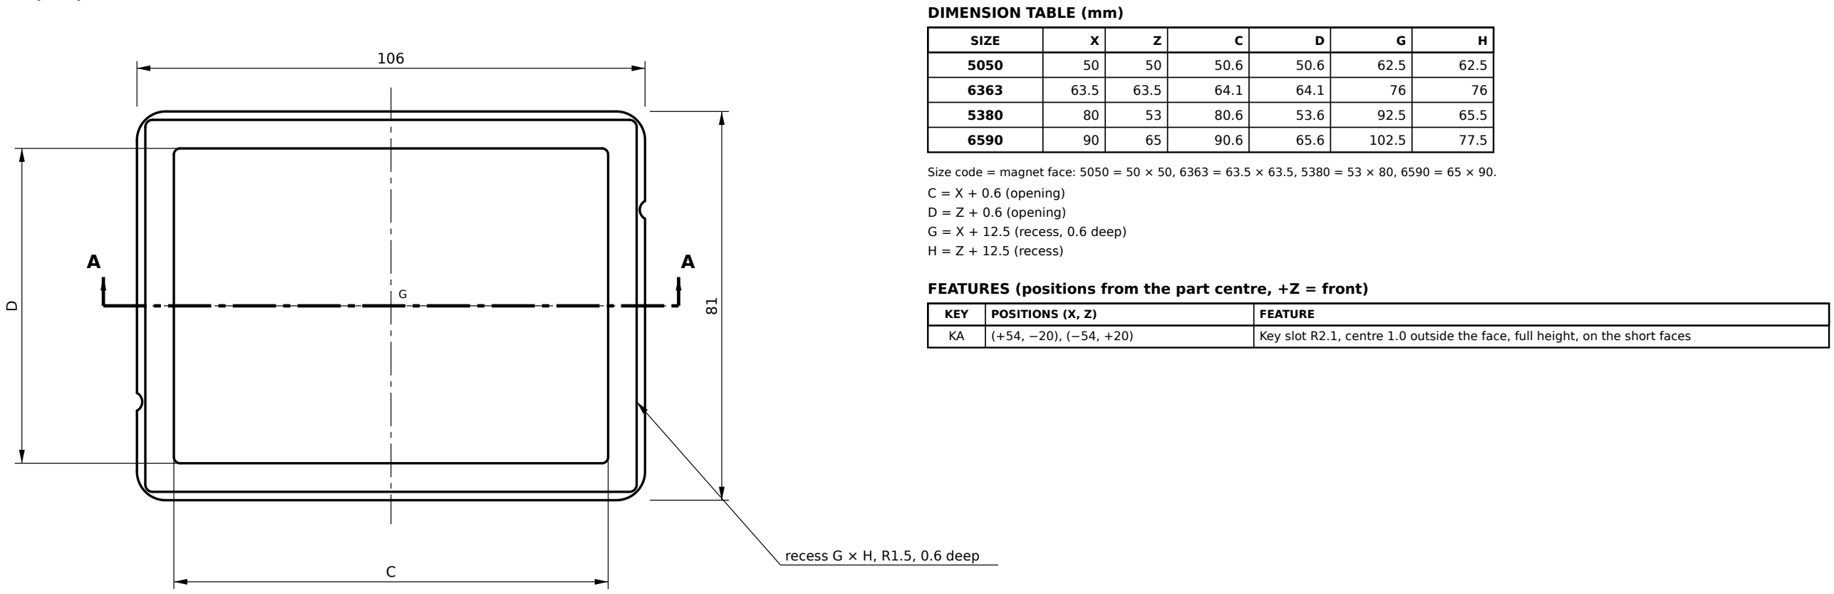
[picture p78: figure]
recess G × H, R1.5, 0.6 deep; DIMENSION TABLE (mm); SIZE; C = X + 0.6 (opening) D = Z + 0.6 (opening) G = X + 12.5 (recess, 0.6 deep) H = Z + 12.5 (recess); KEY; POSITIONS (X, Z); FEATURE

15

### SECTION A–A

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

FEATURES (positions from the part centre, +Z = front)

KA | (+54, −20), (−54, +20) | Key slot R2.1, centre 1.0 outside the face, full height, on the short faces

PROJECT
MagPress M4 · manual photo-magnet press

REVISION
E

SHEET
29 / 40

TITLE

# PICKUP RING A (SIZE KIT)

DRAWING NO.
MP-207

QTY

### 1 per size kit (4)

SCALE

### 1:1 (size 6590)

UNITS
mm

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

NOTES
1. Size kit part: one per magnet size, tabulated below. Shown to scale for size 6590 (65 × 90). X = long side, along the die table.
2. Laser-mark on a side face: drawing no., size code and U / A / B where applicable (e.g. "MP-207 6590 A").
3. Outside 106 × 81 (−0.01/−0.02) for every size: drops into the lower carrier A pocket. Key slots KA fit only carrier A.
4. Opening C × D, R1.3, THRU, wire-EDM; top inner edge R0.5. Recess G × H, R1.5, 0.6 deep, Ra 0.8: it centres the flat tin blank, the photo and the film, all cut X + 12 with the corners clipped at 45° (Rev E), 0.4 thick together.
5. Lift out by hand through the opening once the pedestal is out. Faces parallel 0.01.
6. General tolerances ISO 2768-mK; fits per ISO 286; threads ISO metric 6H/6g.
7. Break all sharp edges 0.3 × 45° unless stated. Remove all burrs.

### PLAN (TOP) — front at bottom

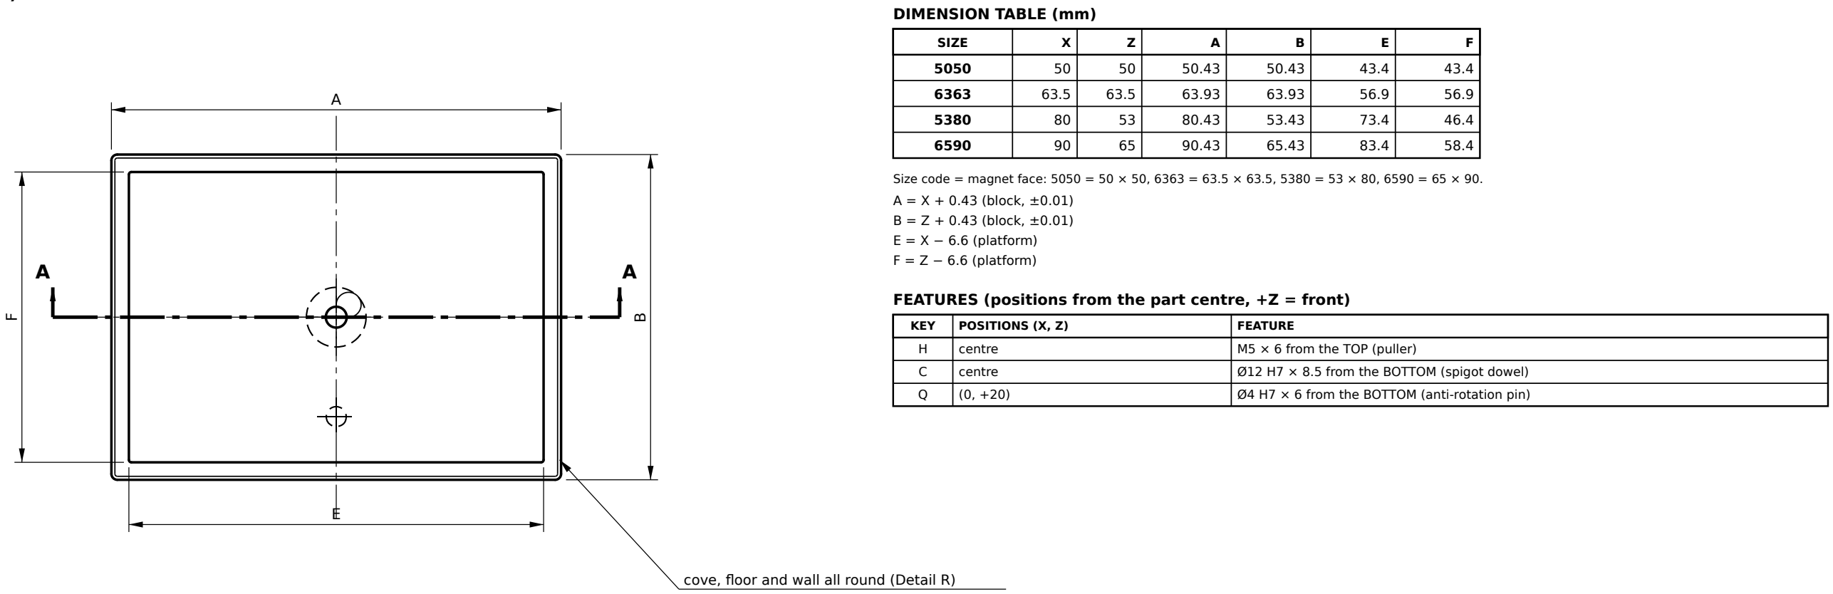
[picture p79: figure]
DIMENSION TABLE (mm); SIZE; A = X + 0.43 (block, ±0.01) B = Z + 0.43 (block, ±0.01) E = X − 6.6 (platform) F = Z − 6.6 (platform); KEY; POSITIONS (X, Z); FEATURE; centre; M5 × 6 from the TOP (puller)

cove, floor and wall all round (Detail R)

16.85
17

### SECTION A–A

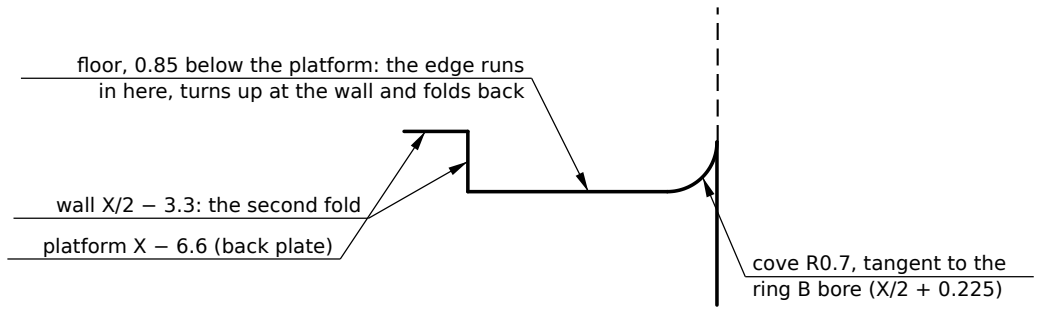
[picture p80: figure]
cove R0.7, tangent to the ring B bore (X/2 + 0.225); wall X/2 − 3.3: the second fold; platform X − 6.6 (back plate)

DETAIL R (10:1) cove, floor and wall — X/2 = shell line floor, 0.85 below the platform: the edge runs in here, turns up at the wall and folds back

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

FEATURES (positions from the part centre, +Z = front)

C | centre | Ø12 H7 × 8.5 from the BOTTOM (spigot dowel)
Q | (0, +20) | Ø4 H7 × 6 from the BOTTOM (anti-rotation pin)

PROJECT
MagPress M4 · manual photo-magnet press

REVISION
E

SHEET
30 / 40

TITLE

# CRIMP ANVIL (SIZE KIT)

DRAWING NO.
MP-208

QTY

### 1 per size kit (4)

SCALE
1:1 / 10:1

UNITS
mm

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

NOTES
1. Size kit part: one per magnet size, tabulated below. Shown to scale for size 6590 (65 × 90). X = long side, along the die table.
2. Laser-mark on a side face: drawing no., size code and U / A / B where applicable (e.g. "MP-207 6590 A").
3. Rev E: double flat fold, as on commercial square magnets. The skirt runs down the ring B bore; the cove (Detail R) turns it inward along the floor; the wall at the platform edge turns it up and back outward under the back plate. The edge ends in two flat layers with the photo outside: a 2.8 mm printed border on the back, the cut edge of the tin hidden inside.
4. Block A × B (X + 0.43) slides in the crimp ring (X + 0.45). Platform E × F (X − 6.6) carries the back plate; the floor is 0.85 below it, room for
the two layers.
5. Profile is a start value: prove it on the prototype kit, then cut tool steel. Polish the cove and floor Ra 0.2.
6. Drop-in: Ø12 m6 × 15 dowel in C (7 protruding), Ø4 m6 × 10 pin in Q. Lift out with the M5 puller in hole H.
7. General tolerances ISO 2768-mK; fits per ISO 286; threads ISO metric 6H/6g.
8. Break all sharp edges 0.3 × 45° unless stated. Remove all burrs.

### PLAN (TOP) — front at bottom

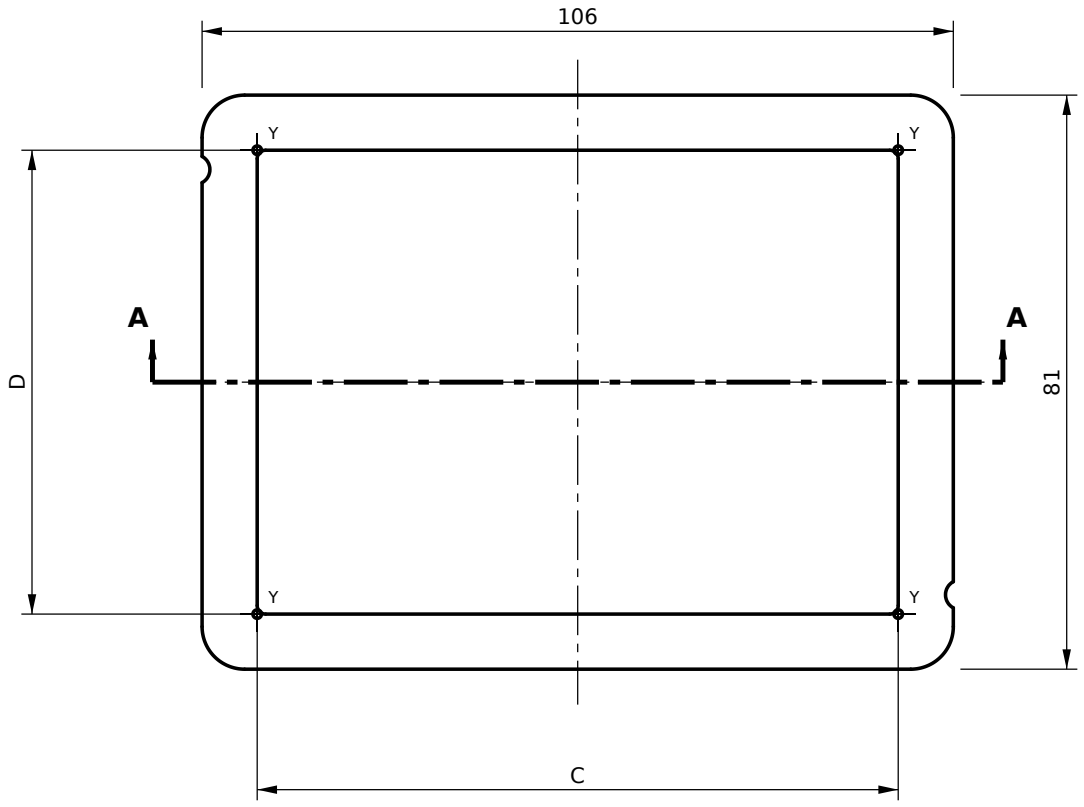
[picture p81: figure]

15

### SECTION A–A

1.2 × 30° lead-in, all round, polished Ra 0.2

DIMENSION TABLE (mm)

SIZE | X | Z | C | D
5050 | 50 | 50 | 50.45 | 50.45
6363 | 63.5 | 63.5 | 63.95 | 63.95
5380 | 80 | 53 | 80.45 | 53.45
6590 | 90 | 65 | 90.45 | 65.45

Size code = magnet face: 5050 = 50 × 50, 6363 = 63.5 × 63.5, 5380 = 53 × 80, 6590 = 65 × 90. C = X + 0.45 (opening, +0.01/0)
D = Z + 0.45 (opening, +0.01/0)

FEATURES (positions from the part centre, +Z = front)

KEY | POSITIONS (X, Z) | FEATURE
KB | (+54, +30), (−54, −30) | Key slot R2.1, centre 1.0 outside the face, full height, on the short faces (Rev E: Z ±30, so ring A turned over ca
Y | opening corners | Ø1.2 THRU on each corner of the opening (corner relief)

PROJECT
MagPress M4 · manual photo-magnet press

REVISION
E

SHEET
31 / 40

TITLE

# CRIMP RING B (SIZE KIT)

DRAWING NO.
MP-209

QTY

### 1 per size kit (4)

SCALE

### 1:1 (size 6590)

UNITS
mm

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

NOTES
1. Size kit part: one per magnet size, tabulated below. Shown to scale for size 6590 (65 × 90). X = long side, along the die table.
2. Laser-mark on a side face: drawing no., size code and U / A / B where applicable (e.g. "MP-207 6590 A").
3. Outside 106 × 81 (−0.01/−0.02) for every size: drops into the lower carrier B pocket. Key slots KB fit only carrier B.
4. Opening C × D, R1.2, with corner reliefs Y (Ø1.2 THRU on each corner), wire-EDM, lap Ra 0.2. Top lead-in 1.2 × 30°. The bore guides the skirt down onto the anvil cove; the anvil block slides in it (X + 0.43 in X + 0.45).
5. A drop of silicone release on the lead-in stops laser-printed film slipping. No EDM recast on the forming edges (2 skim cuts + re-temper).
6. General tolerances ISO 2768-mK; fits per ISO 286; threads ISO metric 6H/6g.
7. Break all sharp edges 0.3 × 45° unless stated. Remove all burrs.

### PLAN (TOP) — front at bottom

144

116

106.02 +0.01/0

81.02 +0.01/

A | A | 0

14

### SECTION A–A

B B

### SECTION B–B (Z = ±49.25)

T: M5 THRU along X, 7 above the bottom face, both ends (thumb screws, dog point, hold the ring)

FEATURES (positions from the part centre, +Z = front)

KEY | POSITIONS (X, Z) | FEATURE
W | centre | Pocket 106.02 × 81.02 (+0.01/0), R6, THRU: holds the upper ring MP-204
R | (±62.5, ±49.25) | Ø6.1 THRU, CBORE Ø10.5 × 10 from the BOTTOM
P | (±30, ±49.25), (±62.5, ±25) | Ø13 × 12 from the TOP (8 upper springs, Rev E: Ø12.5 × 44 red)
K | (0, ±41.51) | Ø4 H7 THRU, centre 1.0 into the pocket wall; press in Ø4 m6 × 14 flush (key pins, upper ring only)
T | X ±72 → ±53, Z 0 | M5 THRU along X, 7 above the bottom face (2 dog-point thumb screws, Ø3.5 × 3 dog)

PROJECT
MagPress M4 · manual photo-magnet press

REVISION
E

SHEET
32 / 40

TITLE

# UPPER CARRIER (UNIVERSAL)

DRAWING NO.
MP-210

QTY

### 1 per press

SCALE
1:1

UNITS
mm

MATERIAL
42CrMo4 (1.7225) plate, QT 28–32 HRC

Black oxide; pocket walls ground or wire-EDM, Ra 0.8

NOTES
1. Universal die part: one per press, the same for every magnet size. X = along the die table, +Z = front.
2. Laser-mark the drawing number on a side face.
3. Rev C: spring-loaded sleeve that carries the upper size ring. Guided by the plug through the ring; floats on 4 shoulder screws.
4. Faces parallel 0.01. Pocket walls square to the faces within 0.01.
5. General tolerances ISO 2768-mK; fits per ISO 286; threads ISO metric 6H/6g.
6. Break all sharp edges 0.3 × 45° unless stated. Remove all burrs.

### PLAN (TOP) — front at bottom

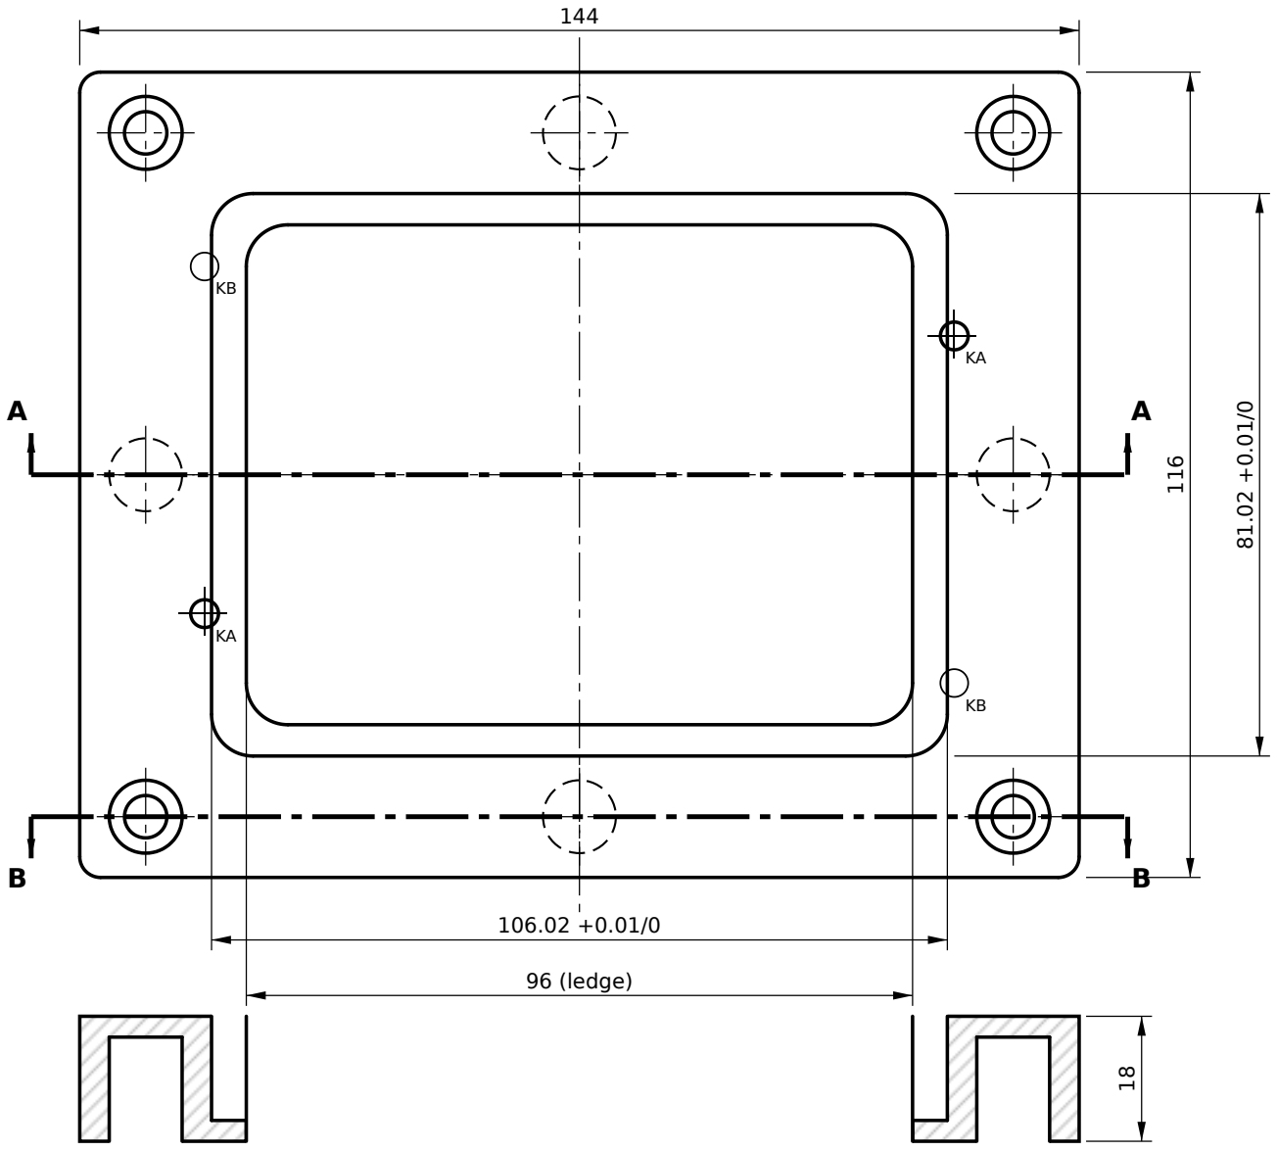
[picture p82: figure]
96 (ledge)

### SECTION A–A

### SECTION B–B (Z = ±49.25)

FEATURES (positions from the part centre, +Z = front)

KEY | POSITIONS (X, Z) | FEATURE
W | centre | Pocket 106.02 × 81.02 (+0.01/0), R6, 15 deep from the TOP (ring seat on a 3 mm ledge)
V | centre | Ledge opening 96 × 72, R6, THRU
R | (±62.5, ±49.25) | Ø6.1 THRU, CBORE Ø10.5 × 14 from the TOP (ISO 7379 Ø6 × 12 into the base)
P | (±62.5, 0), (0, ±49.25) | Ø10.5 × 15 from the BOTTOM (4 lower springs)
KA | (+54.01, −20), (−54.01, +20) | Variant A only: Ø4 H7 × 15, centre 1.0 into the pocket wall, Ø4 m6 × 14 pressed flush (key pins)
KB | (+54.01, +30), (−54.01, −30) | Variant B only: as KA at these positions

PROJECT
MagPress M4 · manual photo-magnet press

REVISION
E

SHEET
33 / 40

TITLE

# LOWER CARRIER A / B (UNIVERSAL)

DRAWING NO.
MP-211

QTY

### A + B per press

SCALE
1:1

UNITS
mm

MATERIAL
42CrMo4 (1.7225) plate, QT 28–32 HRC

Black oxide; pocket walls ground or wire-EDM, Ra 0.8

NOTES
1. Universal die part: one per press, the same for every magnet size. X = along the die table, +Z = front.
2. Laser-mark the drawing number on a side face.
3. Rev C: one carrier per station. Variant A (pickup, left station, green band) and variant B (crimp, right station, red band) differ only in the key pins.
4. The keys stop a pickup ring going into the crimp station and the other way round. Faces parallel 0.01; ledge face flat 0.01.
5. Lower springs: 4 × ISO 10243 Ø10 × 32 green per carrier in 30 mm cavities: 2 mm preload (≈ 75 N), ≈ 0.38 kN at the 8 mm stop (31%).
6. General tolerances ISO 2768-mK; fits per ISO 286; threads ISO metric 6H/6g.
7. Break all sharp edges 0.3 × 45° unless stated. Remove all burrs.

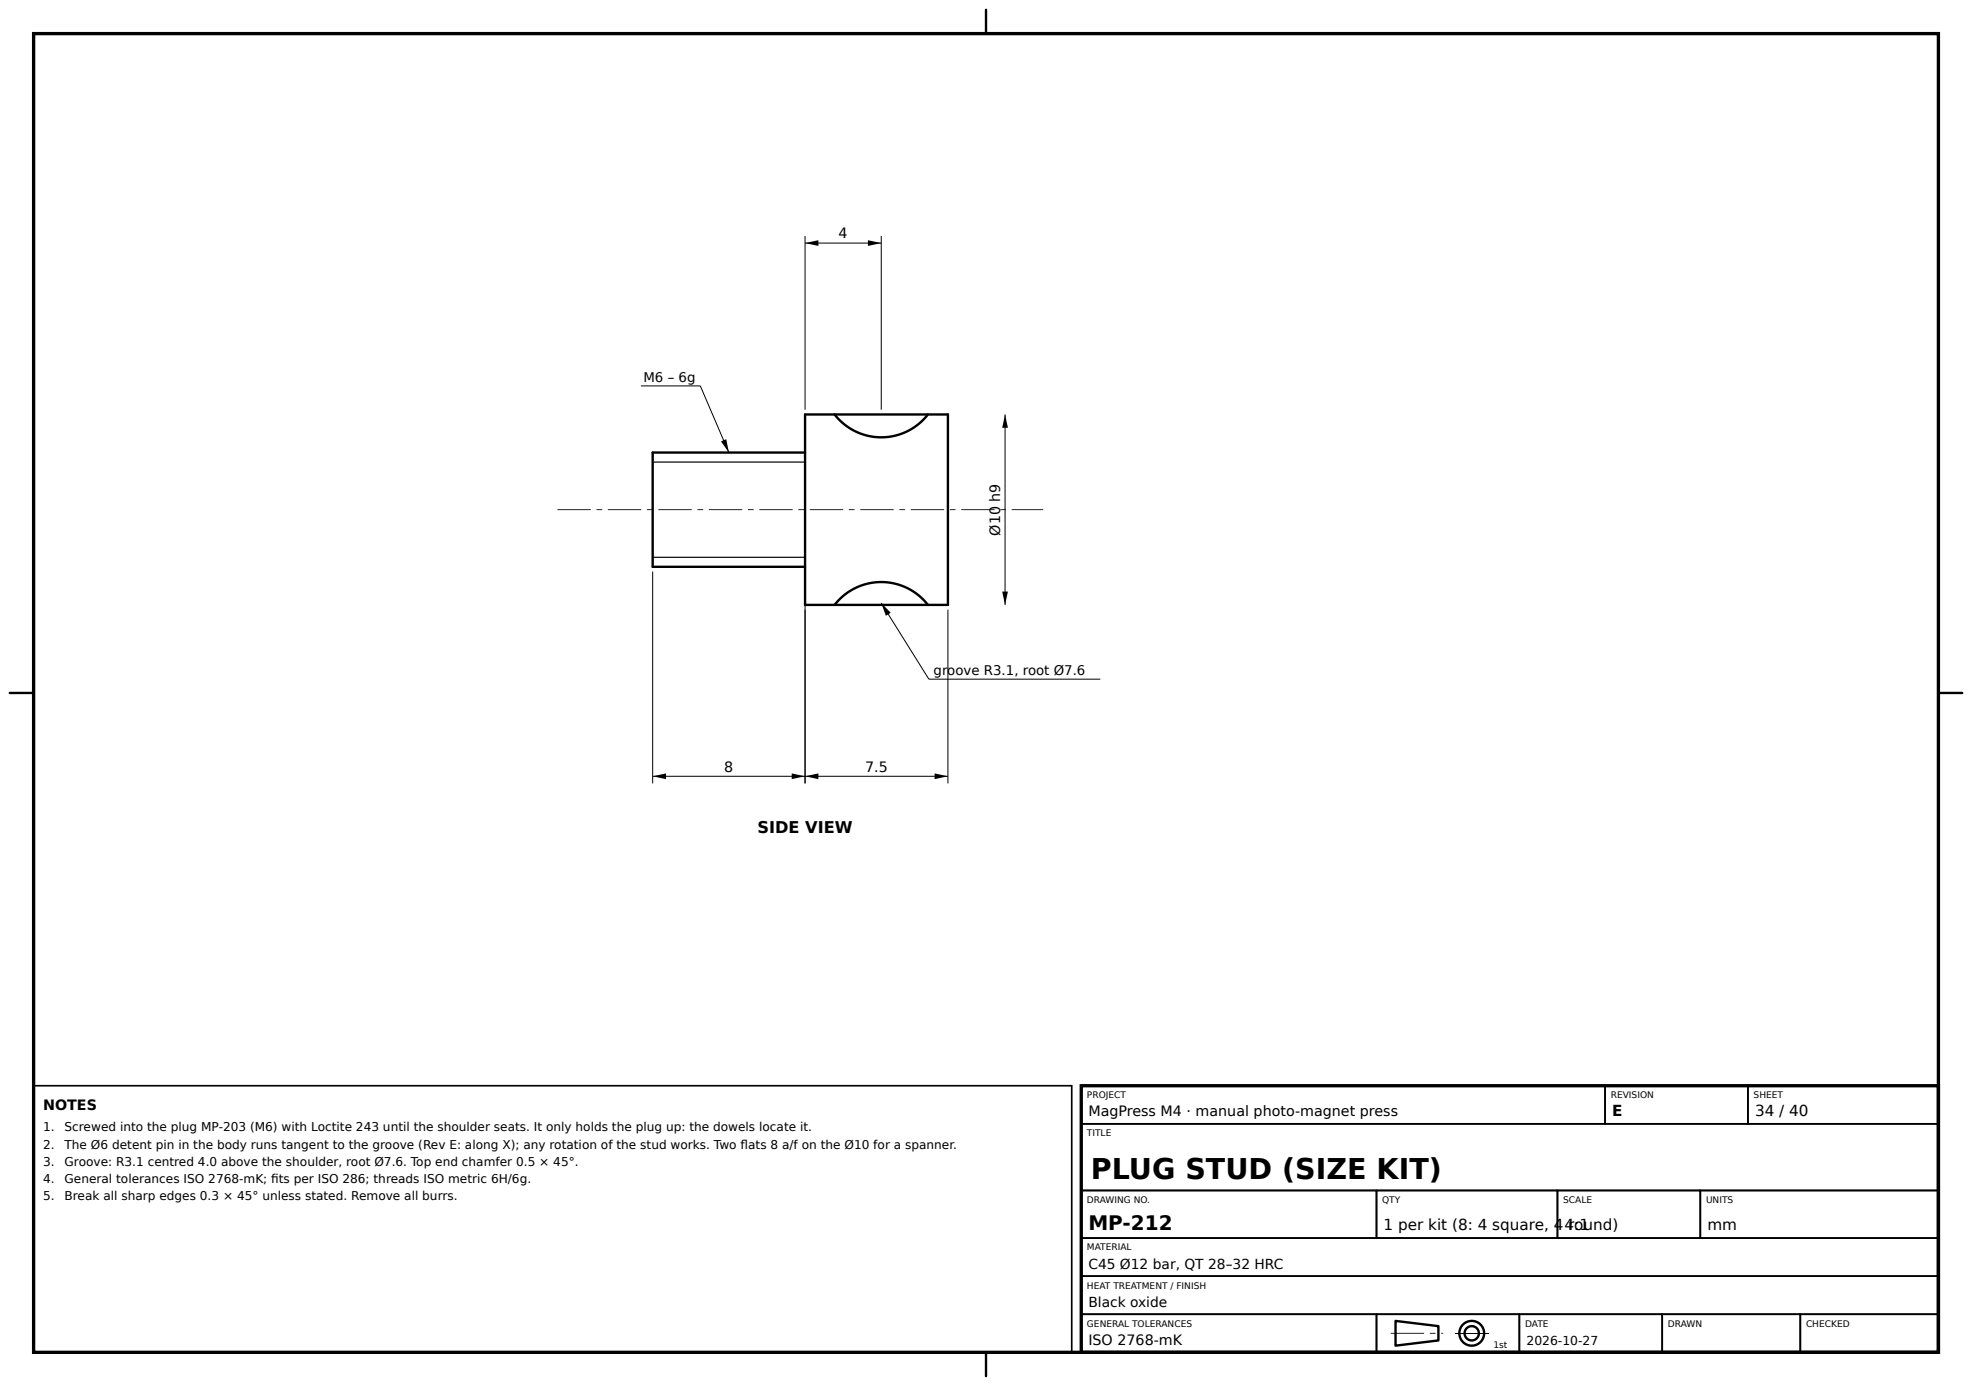
[picture p83: page 34]
groove R3.1, root Ø7.6; SIDE VIEW; REVISION E; SHEET 34 / 40; TITLE; DRAWING NO. MP-212; SCALE 4:1; UNITS mm; Black oxide

PROJECT
MagPress M4 · manual photo-magnet press
PLUG STUD (SIZE KIT)

NOTES
1. Screwed into the plug MP-203 (M6) with Loctite 243 until the shoulder seats. It only holds the plug up: the dowels locate it.
2. The Ø6 detent pin in the body runs tangent to the groove (Rev E: along X); any rotation of the stud works. Two flats 8 a/f on the Ø10 for a spanner.
3. Groove: R3.1 centred 4.0 above the shoulder, root Ø7.6. Top end chamfer 0.5 × 45°.
4. General tolerances ISO 2768-mK; fits per ISO 286; threads ISO metric 6H/6g.
5. Break all sharp edges 0.3 × 45° unless stated. Remove all burrs.

QTY
1 per kit (8: 4 square, 4 round)

MATERIAL
C45 Ø12 bar, QT 28–32 HRC

### PLAN (TOP) — front at bottom

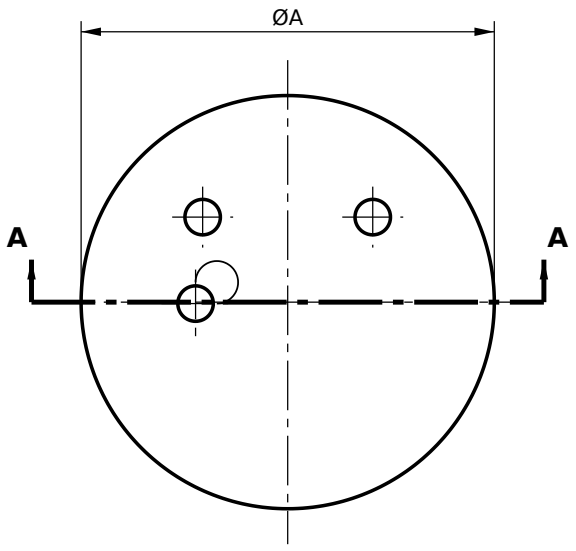
[picture p84: figure]

14.5

### SECTION A–A

DETAIL Y (5:1) working edge, as MP-203 concave lip R1, 1.5 wide × 0.5 deep all round the bottom face

DIMENSION TABLE (mm)

SIZE | Ø | A
D44 | 44 | 44.3
D50 | 50 | 50.3
D56 | 56 | 56.3
D58 | 58 | 58.3

Size code = magnet face diameter: D44 = Ø44, D50 = Ø50, D56 = Ø56, D58 = Ø58. A = D + 0.30 (plug diameter, ±0.01)

FEATURES (positions from the part centre, +Z = front)

KEY | POSITIONS (X, Z) | FEATURE
S | (−13, +0.2) | M6 × 10 from the TOP (stud MP-212, Loctite 243)
D | (±12, −12) | Ø5 H7 × 8 from the TOP (dowels Ø5 × 14: +X cylindrical, −X diamond)

PROJECT
MagPress M4 · manual photo-magnet press

REVISION
E

SHEET
35 / 40

TITLE

# PLUG, ROUND (SIZE KIT)

DRAWING NO.
MP-223

QTY

### 1 per round kit (4)

SCALE

### 1:1 (size D58)

UNITS
mm

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

Turn/bore +0.2; harden 58–60 HRC, temper ×2; grind, hone bores Ra 0.2; thin dense chrome

NOTES
1. Rev D round size-kit part: one per round size, tabulated below. Shown to scale for size D58 (Ø58).
2. Laser-mark on a side face: drawing no., size code and U / A / B where applicable (e.g. "MP-227 D58 A").
3. Turned part. Two Ø5 × 14 dowels pressed in (5.5 protruding; +X cylindrical, −X diamond) locate it on the INNER pattern D2 of the die body MP-201; stud MP-212 in the M6 hole sits in K2 and takes the same detent pin as the square kits.
4. Diameter A: grind after hardening, ±0.01. Sliding fit in the upper ring (ring = plug + 0.05).
5. Bottom (working) face flat 0.01, Ra 0.2, lip per Detail Y. Height 14.5 ±0.01 sets the 5.5 recess in the ring. No DXF: turned.
6. General tolerances ISO 2768-mK; fits per ISO 286; threads ISO metric 6H/6g.
7. Break all sharp edges 0.3 × 45° unless stated. Remove all burrs.

### PLAN (TOP) — front at bottom

106

81

ØC

A A

14

### SECTION A–A

B B

### SECTION B–B (Z = ±20)

N: 4× M3 THRU from the long faces 1.8 above the BOTTOM face, at X = ±E

M: Ø3.6 × 3.5 hole, both X ends, 7 above the bottom face (dog-point thumb screws)

DETAIL P (5:1) bottom inner edge lead-in 0.3 × 30° all round, polished

DIMENSION TABLE (mm)

SIZE | Ø | C | E
D44 | 44 | 44.35 | 11
D50 | 50 | 50.35 | 12.5
D56 | 56 | 56.35 | 14
D58 | 58 | 58.35 | 14.5

Size code = magnet face diameter: D44 = Ø44, D50 = Ø50, D56 = Ø56, D58 = Ø58. C = D + 0.35 (bore, +0.01/0)
E = D / 4 (plunger offset in X)

FEATURES (positions from the part centre, +Z = front)

KEY | POSITIONS (X, Z) | FEATURE
K | (0, ±41.5) | Key slot R2.1, centre 1.0 outside the face, full height, on both long faces
M | (±53, 0) | Ø3.6 × 3.5 deep, 7 above the bottom face (dog-point thumb screws)
N | (±E, long faces) | M3 THRU to the bore, 1.8 above the bottom face (ball plungers)

PROJECT
MagPress M4 · manual photo-magnet press

REVISION
E

SHEET
36 / 40

TITLE

# UPPER RING, ROUND (SIZE KIT)

DRAWING NO.
MP-224

QTY

### 1 per round kit (4)

SCALE

### 1:1 (size D58)

UNITS
mm

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

Turn/bore +0.2; harden 58–60 HRC, temper ×2; grind, hone bores Ra 0.2; thin dense chrome

NOTES
1. Rev D round size-kit part: one per round size, tabulated below. Shown to scale for size D58 (Ø58).
2. Laser-mark on a side face: drawing no., size code and U / A / B where applicable (e.g. "MP-227 D58 A").
3. Outside 106 × 81 (−0.01/−0.02) for every size: fits the upper carrier MP-210 pocket. Key slots K (R2.1, centre 1.0 outside the face) take the carrier pins.
4. Bore C: bore and hone after hardening, Ra 0.2. Bottom inner lead-in 0.3 × 30° (Detail P). Deburr the plunger breakouts in the bore.
5. Held by 2 dog-point thumb screws in holes M. Four M3 ball plungers N stand 0.2–0.3 into the bore at 1.8 above the bottom face.
6. General tolerances ISO 2768-mK; fits per ISO 286; threads ISO metric 6H/6g.
7. Break all sharp edges 0.3 × 45° unless stated. Remove all burrs.

### PLAN (TOP) — front at bottom

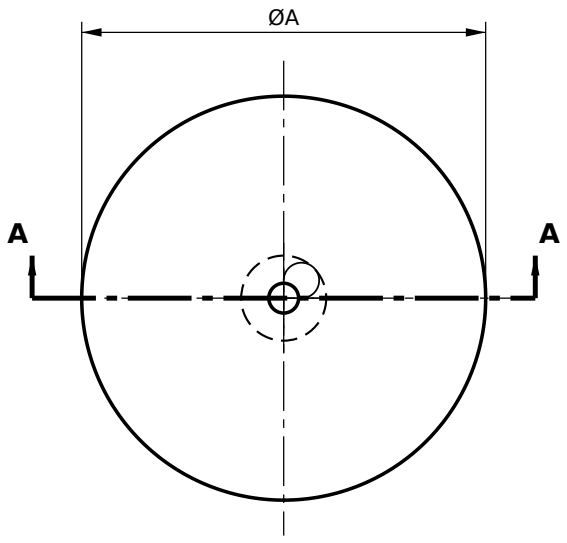
[picture p85: figure]

21.8

### SECTION A–A

DIMENSION TABLE (mm)

SIZE | Ø | A
D44 | 44 | 43
D50 | 50 | 49
D56 | 56 | 55
D58 | 58 | 57

Size code = magnet face diameter: D44 = Ø44, D50 = Ø50, D56 = Ø56, D58 = Ø58. A = D − 1.0 (±0.01)

FEATURES (positions from the part centre, +Z = front)

KEY | POSITIONS (X, Z) | FEATURE
H | centre | M5 × 6 from the TOP (puller)
C | centre | Ø12 H7 × 8.5 from the BOTTOM (spigot dowel)

PROJECT
MagPress M4 · manual photo-magnet press

REVISION
E

SHEET
37 / 40

TITLE

# PICKUP PEDESTAL, ROUND (SIZE KIT)

DRAWING NO.
MP-226

QTY

### 1 per round kit (4)

SCALE

### 1:1 (size D58)

UNITS
mm

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

Turn/bore +0.2; harden 58–60 HRC, temper ×2; grind, hone bores Ra 0.2; thin dense chrome

NOTES
1. Rev D round size-kit part: one per round size, tabulated below. Shown to scale for size D58 (Ø58).
2. Laser-mark on a side face: drawing no., size code and U / A / B where applicable (e.g. "MP-227 D58 A").
3. The tinplate shell sits face-up over it with 0.3 clearance a side (Rev E: was D − 0.5). Top face flat 0.01, Ra 0.2; top edge R0.3. Height 21.8 ±0.02.
4. Turned part. Press a Ø12 m6 × 15 dowel into C (7 protruding). No anti-rotation pin: a round pedestal can turn. Lift out with the M5 T-handle puller in hole H. No DXF: turned.
5. General tolerances ISO 2768-mK; fits per ISO 286; threads ISO metric 6H/6g.
6. Break all sharp edges 0.3 × 45° unless stated. Remove all burrs.

### PLAN (TOP) — front at bottom

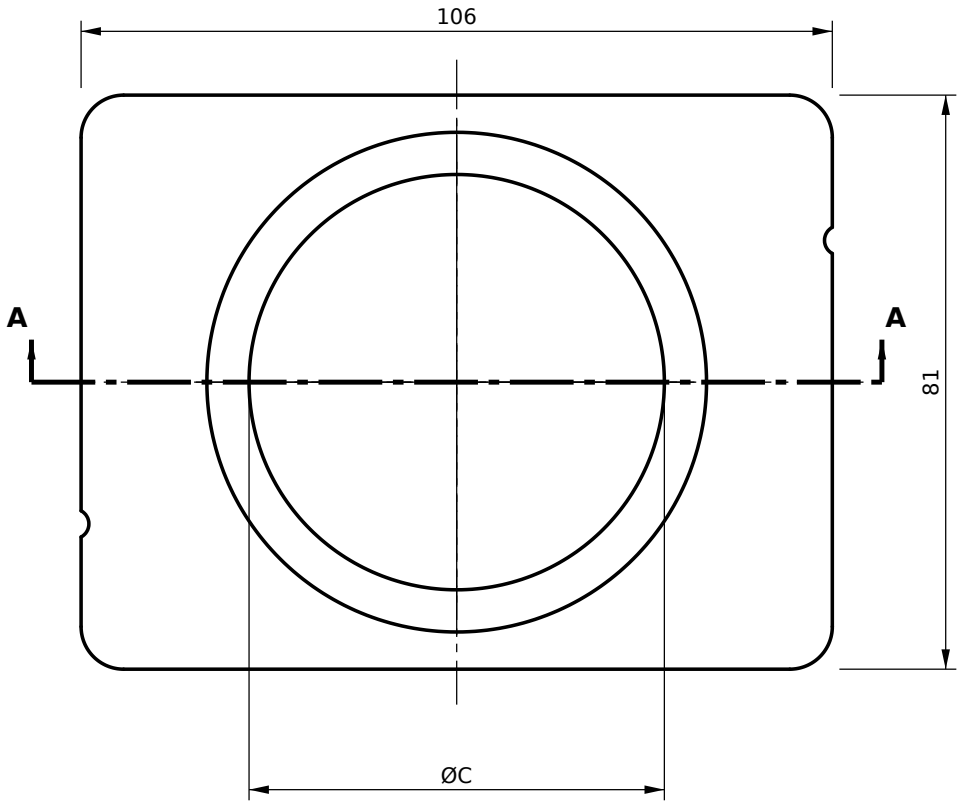
[picture p86: figure]

15

### SECTION A–A

DIMENSION TABLE (mm)

SIZE | Ø | C | G
D44 | 44 | 44.6 | 56.5
D50 | 50 | 50.6 | 62.5
D56 | 56 | 56.6 | 68.5
D58 | 58 | 58.6 | 70.5

Size code = magnet face diameter: D44 = Ø44, D50 = Ø50, D56 = Ø56, D58 = Ø58. C = D + 0.6 (bore)
G = D + 9.5 (film recess, 0.6 deep)

FEATURES (positions from the part centre, +Z = front)

KEY | POSITIONS (X, Z) | FEATURE
KA | (+54, −20), (−54, +20) | Key slot R2.1, centre 1.0 outside the face, full height, on the short faces

PROJECT
MagPress M4 · manual photo-magnet press

REVISION
E

SHEET
38 / 40

TITLE

# PICKUP RING A, ROUND (SIZE KIT)

DRAWING NO.
MP-227

QTY

### 1 per round kit (4)

SCALE

### 1:1 (size D58)

UNITS
mm

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

NOTES
1. Rev D round size-kit part: one per round size, tabulated below. Shown to scale for size D58 (Ø58).
2. Laser-mark on a side face: drawing no., size code and U / A / B where applicable (e.g. "MP-227 D58 A").
3. Outside 106 × 81 (−0.01/−0.02) for every size: drops into the lower carrier A pocket. Key slots KA fit only carrier A.
4. Bore C THRU, top inner edge R0.5. Film recess ØG, 0.6 deep, Ra 0.8: it centres the photo and film.
5. Lift out by hand through the bore once the pedestal is out. Faces parallel 0.01.
6. General tolerances ISO 2768-mK; fits per ISO 286; threads ISO metric 6H/6g.
7. Break all sharp edges 0.3 × 45° unless stated. Remove all burrs.

### PLAN (TOP)

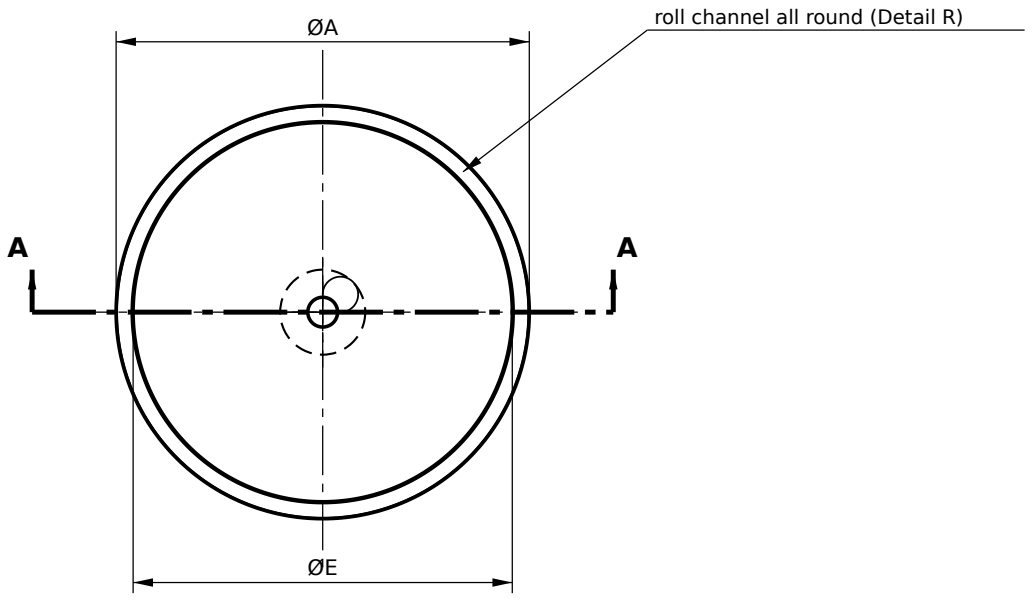
[picture p87: figure]
roll channel all round (Detail R)

16

17

### SECTION A–A

DETAIL R (10:1) roll channel (round kits only)

R1.0, centre 1.0 inside the shell line D/2, level with the rim (1.0 below the platform)

DIMENSION TABLE (mm)

SIZE | Ø | A | E
D44 | 44 | 44.3 | 39.5
D50 | 50 | 50.3 | 45.5
D56 | 56 | 56.3 | 51.5
D58 | 58 | 58.3 | 53.5

Size code = magnet face diameter: D44 = Ø44, D50 = Ø50, D56 = Ø56, D58 = Ø58. A = D + 0.3 (block, ±0.01)
E = D − 4.5 (platform)

FEATURES (positions from the part centre, +Z = front)

KEY | POSITIONS (X, Z) | FEATURE
H | centre | M5 × 6 from the TOP (puller)
C | centre | Ø12 H7 × 8.5 from the BOTTOM (spigot dowel)

PROJECT
MagPress M4 · manual photo-magnet press

REVISION
E

SHEET
39 / 40

TITLE

# CRIMP ANVIL, ROUND (SIZE KIT)

DRAWING NO.
MP-228

QTY

### 1 per round kit (4)

SCALE
1:1 / 10:1

UNITS
mm

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

NOTES
1. Rev D round size-kit part: one per round size, tabulated below. Shown to scale for size D58 (Ø58).
2. Laser-mark on a side face: drawing no., size code and U / A / B where applicable (e.g. "MP-227 D58 A").
3. Rev D, kept in Rev E: turned. The R1.0 roll channel runs round the full circle (Detail R): it rolls the shell edge inward under the back plate.
Round kits do not get the Rev E double flat fold: a round edge cannot be folded flat without wrinkling.
4. Block D + 0.3 slides in the crimp ring (D + 0.45) and guides it. Platform (D − 4.5) carries the back plate.
5. Channel profile is a start value: prove it on the 7075 prototype kit. Polish the channel Ra 0.2. Drop-in: Ø12 m6 × 15 dowel in C (7 protruding); no anti-rotation pin.
6. General tolerances ISO 2768-mK; fits per ISO 286; threads ISO metric 6H/6g.
7. Break all sharp edges 0.3 × 45° unless stated. Remove all burrs.

### PLAN (TOP) — front at bottom

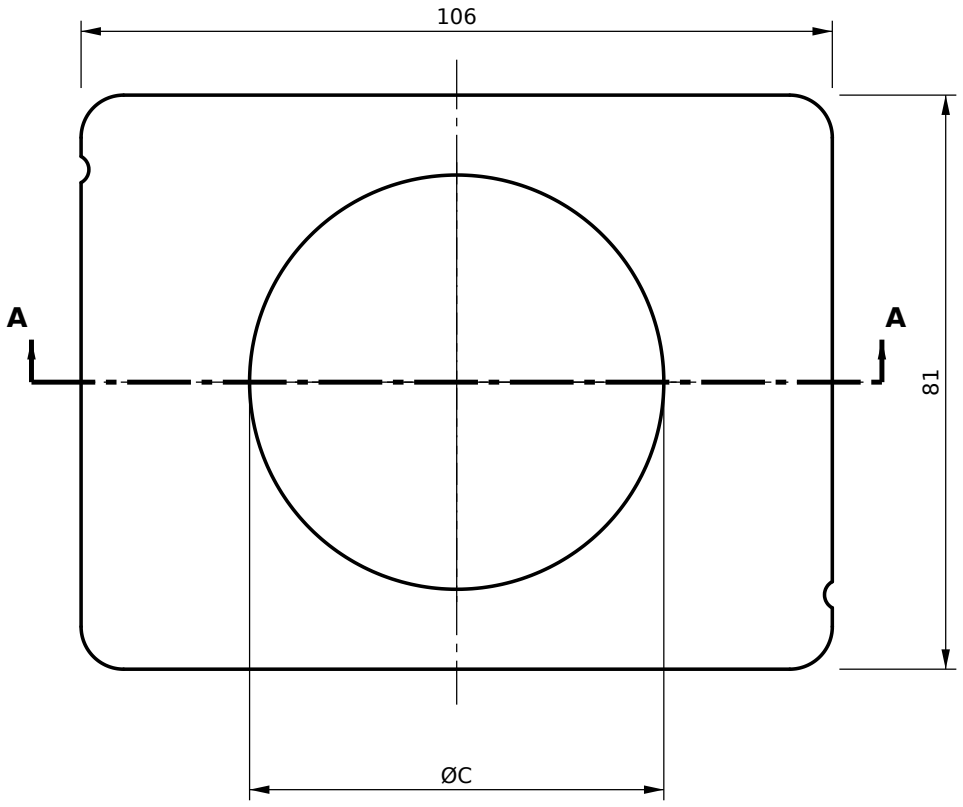
[picture p88: figure]

15

### SECTION A–A

1.2 × 30° lead-in, all round, polished Ra 0.2

DIMENSION TABLE (mm)

SIZE | Ø | C
D44 | 44 | 44.45
D50 | 50 | 50.45
D56 | 56 | 56.45
D58 | 58 | 58.45

Size code = magnet face diameter: D44 = Ø44, D50 = Ø50, D56 = Ø56, D58 = Ø58. C = D + 0.45 (bore, +0.01/0)

FEATURES (positions from the part centre, +Z = front)

KEY | POSITIONS (X, Z) | FEATURE
KB | (+54, +30), (−54, −30) | Key slot R2.1, centre 1.0 outside the face, full height, on the short faces

PROJECT
MagPress M4 · manual photo-magnet press

REVISION
E

SHEET
40 / 40

TITLE

# CRIMP RING B, ROUND (SIZE KIT)

DRAWING NO.
MP-229

QTY

### 1 per round kit (4)

SCALE

### 1:1 (size D58)

UNITS
mm

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

NOTES
1. Rev D round size-kit part: one per round size, tabulated below. Shown to scale for size D58 (Ø58).
2. Laser-mark on a side face: drawing no., size code and U / A / B where applicable (e.g. "MP-227 D58 A").
3. Outside 106 × 81 (−0.01/−0.02) for every size: drops into the lower carrier B pocket. Key slots KB fit only carrier B.
4. Bore C THRU, honed Ra 0.2. Top lead-in 1.2 × 30° folds the film under the shell edge and guides the shell onto the anvil's roll channel (round kits keep the Rev D rolled edge).
5. General tolerances ISO 2768-mK; fits per ISO 286; threads ISO metric 6H/6g.
6. Break all sharp edges 0.3 × 45° unless stated. Remove all burrs.
