nanda-1243/tngexp/cad/img_exploded.png

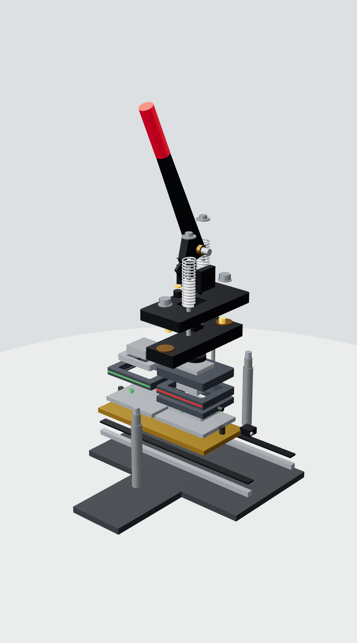
cad/img_exploded.png
