nanda-1243/tngexp/docs/research/market/ad1dac50-image.jpg

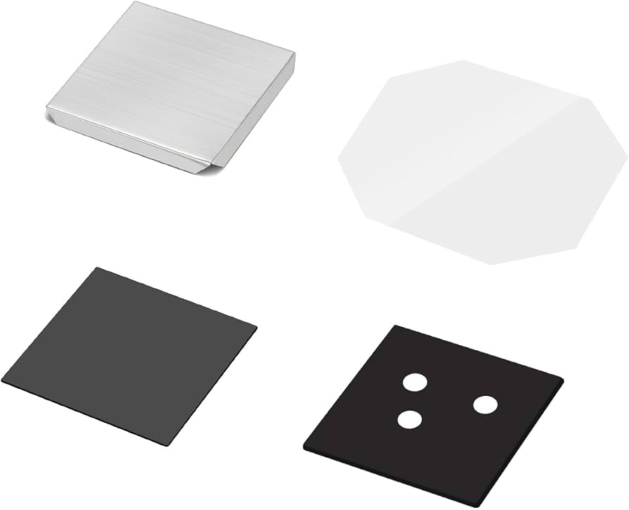
docs/research/market/ad1dac50-image.jpg
