nanda-1243/tngexp/docs/research/market/b5acaed8-image.jpg

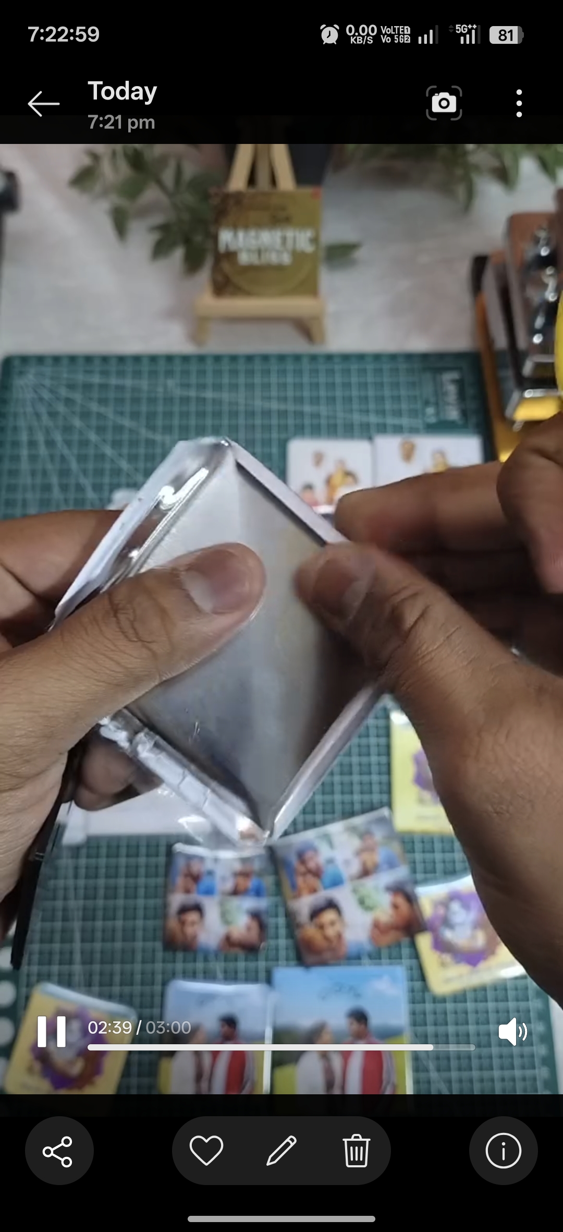
docs/research/market/b5acaed8-image.jpg
