nanda-1243/tngexp/docs/research/market/ba2e259d-image.jpg

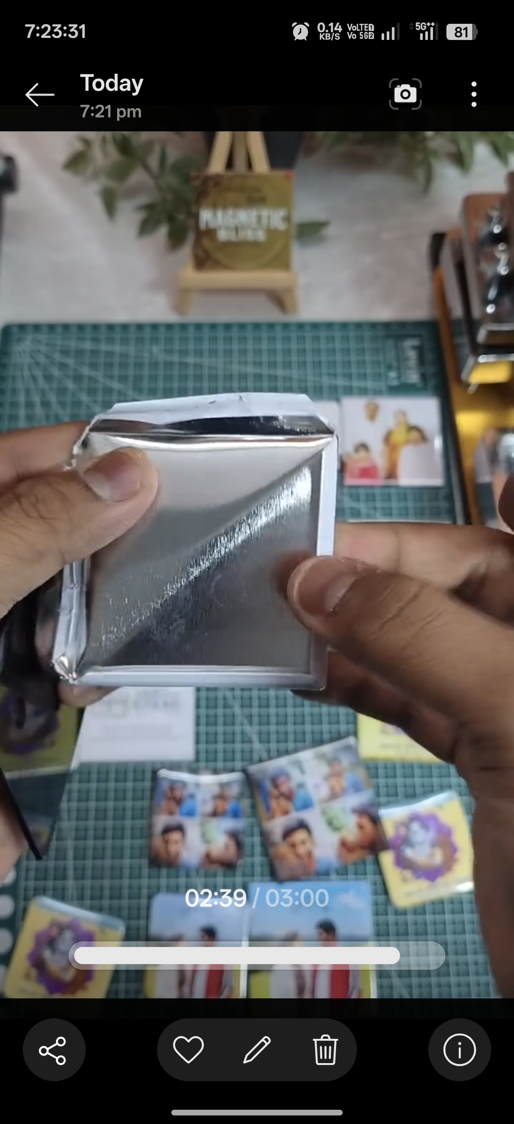
docs/research/market/ba2e259d-image.jpg
