nanda-1243/tngexp/docs/research/market/bfa5b5e2-image.jpg

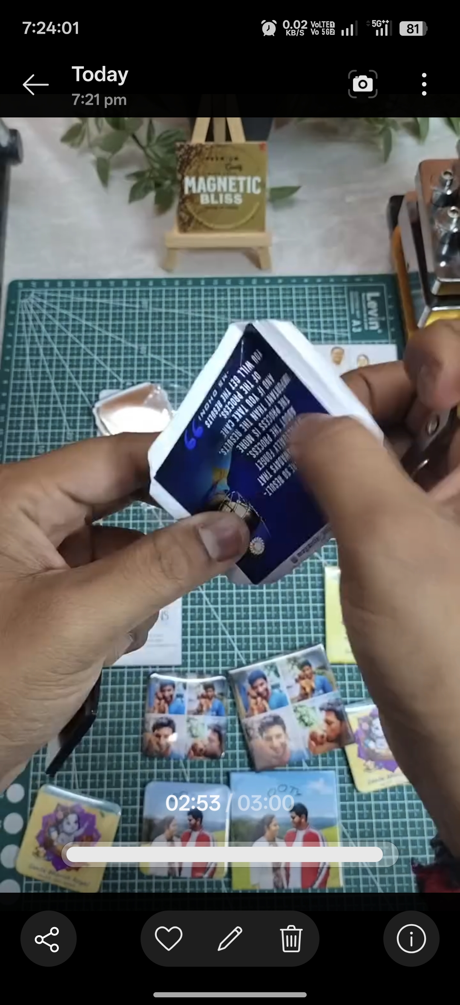
docs/research/market/bfa5b5e2-image.jpg
