nanda-1243/tngexp/docs/research/market/f2ef1e9c-image.jpg

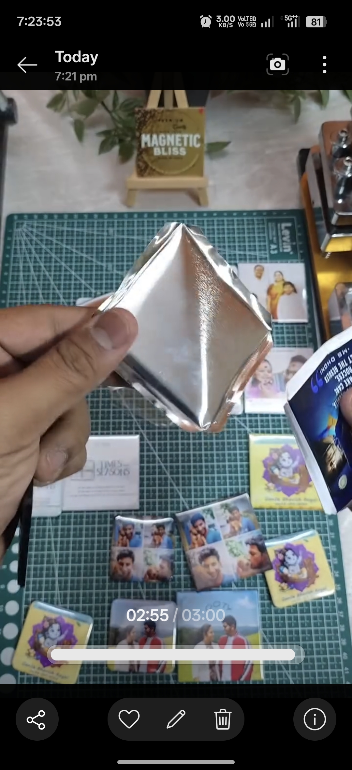
docs/research/market/f2ef1e9c-image.jpg
