nanda-1243/tngexp/docs/research/market/set-tin-and-film.jpg

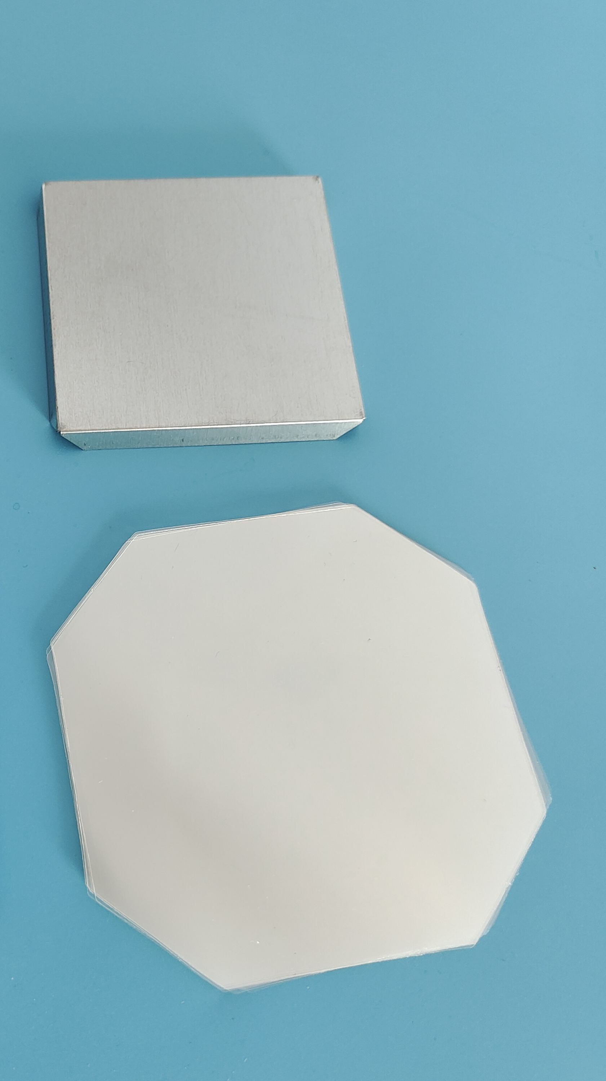
docs/research/market/set-tin-and-film.jpg
