nanda-1243/tngexp/light/render_exploded.png

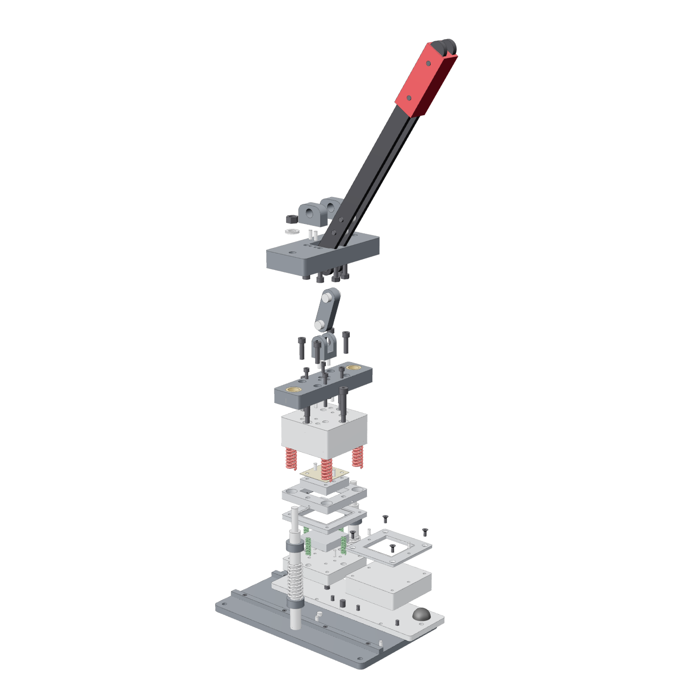
light/render_exploded.png
