nanda-1243/tngexp/docs/sourcing-india.md

# Building the MagPress M4 in India: where to get each part, and what it costs

Researched 28 Oct 2026 from suppliers' own pages, marketplace listings (IndiaMART, TradeIndia, Moglix) and institute rate
cards. Prices are what sellers advertise, mostly before GST (18 %) and transport. Treat every figure as ±30 % and get
two or three written quotes against the drawings before ordering. Andhra Pradesh and Delhi NCR come first in every row;
the "best option" column names the place that is best on price, capability or delivery wherever it is.

> **Status after verification (29 Oct 2026, [verification.md](verification.md)):** the frame, drive and fits pass. The
> **square size kits do not form as drawn** (the double fold on the back fails in simulation) and are on hold until they
> are reworked to the commercial recipe: a short flange and a thick card-and-magnet back. Do not order kit steel or
> machining for square sizes yet. The prices below stay valid for the frame, the universal die and the round kits; the
> square-kit rework will change the consumables (a thick back instead of the 1.2 mm plate) and may change the upper die
> springs.

## 1. Read this first: buying versus building

| Option | Approximate cost | Notes |
|---|---|---|
| Ready-made Indian square magnet press, one size | ₹10,000 (50 × 50, plastic body, cutter and 100 material sets) to ₹30,000 (50 × 50, metal body); ₹46,000 for 80 × 53 with cutter | [Copier Bazar](https://copierbazar.com/fridge-magnet-machines/) (+91 88899 15080); IndiaMART listings at ₹16,500 and ₹25,000 for 50 × 50 ([1](https://www.indiamart.com/proddetail/fridge-magnet-making-machine-50x-50-mm-sqaure-2855464652830.html), [2](https://www.indiamart.com/proddetail/50mm-square-fridge-magnet-badge-machine-kit-2857606458055.html)). Material sets ₹25–27 per magnet. |
| MagPress M4, press with one size kit | **₹0.85 – 1.45 lakh** (up to ≈ ₹1.7 lakh at tool-room rates) | Section 4. One frame takes all eight size kits; each extra kit ₹20,000–40,000. |
| A forming trial before the full build (recommended) | ₹15,000 – 25,000 | One size's six forming parts in 7075 aluminium or soft (unhardened) D2, pressed in a 1–2 t bench arbor press. Proves the fold and the back fold on real tin, paper and film before ₹1 lakh is spent. After the square-kit rework this is the one test the simulation cannot replace. |
| Commercial consumables to measure | ₹300 – 500 | One pack of square-magnet sets (sheet, film, card back, magnet) in 50 × 50 or 65 × 90, measured with calipers, fixes the reworked kit's sizes. |

For one or two sizes, a bought press is cheaper. The MagPress pays off only if you want several sizes on one frame, the
heavier build, or the printed back border it is designed around.

## 2. Where to get the machining done

| Work | Andhra Pradesh | Delhi NCR | Best option anywhere |
|---|---|---|---|
| Size-kit parts: CNC rough, wire-EDM openings after hardening, grinding, CMM check | **MSME Technology Centre, Visakhapatnam** (Plot 6, Industrial Corridor, Pudi, Atchutapuram 531011; +91 95153 97533, 08924-282600; info@msmetcvizag.org). Has 10 CNC mills, 10 CNC lathes, GF wire-cut and die-sink EDM, surface and cylindrical grinders, CMM; does tool and die work ([machines](https://www.msmetcvizag.org/list-of-machines/), [contact](https://www.msmetcvizag.org/contact-us/)). No vacuum furnace listed: send kit parts out for hardening (section 3). | NSIC Technical Services Centre, Okhla (job work and spare capacity: 99799 33266, 011-26826801 ext. 228) ([page](https://nsic.co.in/NTSC/Okhla)). Private tool rooms in Okhla, Mayapuri, Wazirpur and Faridabad ([Faridabad directory](https://dir.indiamart.com/faridabad/precision-machining-services.html)). | **CITD Hyderabad** (MSME Tool Room, Balanagar), the nearest full tool room to AP: wire cut, EDM, VMC, CNC lathes, grinding. Its website could not be opened from this session; call or visit. |
| Frame, drive and universal-die parts (C45, S355, 42CrMo4: milling, turning, drilling, tapping) | MSME TC Visakhapatnam; private CNC shops in the Vijayawada and Visakhapatnam Autonagars | Okhla, Mayapuri, Naraina, Faridabad CNC job shops | Any 3-axis VMC shop with a CNC lathe |
| Laser or plasma profiles (base plate blank, lever blank), laser-cut acrylic back plates | Local fabricators | Faridabad laser job work ₹25–30 per minute for steel ([listing](https://dir.indiamart.com/faridabad/laser-cutting-services.html)) | Acrylic: ₹50–245 per sq ft or ₹15–90 per running foot ([listing](https://m.indiamart.com/impcat/acrylic-cutting-service.html)) |

Typical rates to check quotes against:
- VMC job work: ₹250–450 per hour at small private shops ([example](https://m.indiamart.com/vanshi-engineering)), ₹1,030–1,400 per hour at institute tool rooms ([CSIR-CMERI rate chart](https://cmeri.res.in/sites/default/files/Brochure-MSME%20Rate%20Chart.pdf)).
- CNC lathe: ₹400 per hour (IIT Kanpur, industry users) to ₹1,150 per hour (CMERI) ([IIT Kanpur](https://www.iitk.ac.in/mse/MSE-Facilities/MTL/charges.php)).
- Wire EDM: ₹0.12–0.24 per mm² of cut face (≈ ₹77–155 per sq inch) at private shops ([listings](https://m.indiamart.com/impcat/wire-cutting-services.html)); ₹480–580 per hour at IIT Madras, ₹900 per hour at IIT Kanpur, ₹1,240 per hour at CMERI ([IIT Madras](https://cstf.iitm.ac.in/downloads/Guidlines%20to%20use%20wire%20EDM%20machine.pdf)).

## 3. Heat treatment and finishing

| Process | Parts | Andhra Pradesh | Delhi NCR | Approximate cost |
|---|---|---|---|---|
| Vacuum hardening, 58–60 HRC, double temper | Size-kit parts (D2), about 6 kg per kit | Hyderabad tool rooms and heat treaters (CITD, Balanagar/Jeedimetla); Chennai | **voestalpine High Performance Metals India** (Böhler/Uddeholm), vacuum heat treatment and warehouse at C-19, Site C, UPSIDC Surajpur, Greater Noida 201306; vahpm-in-vht-noida@voestalpine.com, 85888 91063 ([contact](https://www.voestalpine.com/highperformancemetals/india/en/contact-us/)) | ₹2,000–5,000 per batch (usually a minimum charge) |
| Through-hardening and grinding | Pins A, B, O (EN31), station pilot, die holder (EN19) | Local heat treaters | Local heat treaters; Maxwell Tools, Rajpura (vacuum) | ₹1,000–2,000 |
| Black oxide (blackodising) | Frame and drive steel parts | Local platers | Local platers | ₹1,000–2,000 per lot |
| Hard anodise | Die table (6061) | Hyderabad/Chennai platers | Delhi listing ₹3 per sq inch ([listing](https://m.indiamart.com/impcat/hard-coat-anodizing.html)) | ₹500–800. Mask the pilot and dowel holes |
| Hard chrome | Columns, only if not bought as chrome bar | — | Greater Noida listing ₹4 per sq inch ([listing](https://m.indiamart.com/impcat/hard-chrome-plating.html)) | ₹500–800 |
| QPQ (salt-bath nitrocarburise) | Base plate slide area | Ask | Ask | Quote; or grind the slide area and keep it oiled |
| Powder coat | Base plate | Local | Local | ₹500–1,000 |

## 4. Materials and bought parts

| Item | Spec and quantity | Andhra Pradesh | Delhi NCR | Best option / price |
|---|---|---|---|---|
| Kit tool steel | D2 (1.2379, "HCHCr"), about 6 kg finished, 8 kg bought, per kit. A2 (1.2363) is rarely stocked in India; D2 is the equivalent to order | Through the tool room | Loha Mandi, Naraina (e.g. Goel Steel Emporium, [listing](https://www.tradeindia.com/products/d2-tool-steel-c3026899.html)); voestalpine Greater Noida (Böhler K110 = D2) | ₹260–290 per kg generic D2 ([listings](https://m.indiamart.com/impcat/die-steels.html)); branded more |
| Carbon and alloy steel | C45 (≈ EN8/EN9) and 42CrMo4 (≈ EN19) bars and plate, about 45 kg | Steel stockists, Vijayawada/Visakhapatnam | Loha Mandi, Naraina | ₹65–90 per kg ([BigMint EN8 benchmark](https://www.bigmint.co/intel/detail/india-alloy-steel-round-bar-prices-remained-stable-w-o-w-35171), [Delhi bright bar](https://m.indiamart.com/bkengineeringtools/bright-steel-bars.html)) |
| Base plate steel | S355 (≈ IS 2062 E350), 20 mm, 480 × 490, about 37 kg | RINL/SAIL stockists | Naraina | ₹51–60 per kg + cutting ([listings](https://m.indiamart.com/impcat/ms-plates.html)) |
| Columns | Ø25, 2 × 210 mm. Either 100Cr6 (EN31) hardened, ground and hard-chromed, or induction-hardened chrome bar (CK45, 50–58 HRC) ground to Ø25 h6 | — | Indian Hydraulic Products, Delhi: IH chrome bar ₹150 per kg (≈ ₹600 per metre at Ø25) ([listing](https://www.aajjo.com/product/induction-hardened-rod-in-delhi-indian-hydraulic-products)) | ₹600–1,200 for both. Hydraulic rod is usually f7: ask for h6 |
| Die table | 6061-T6 plate, 12 mm, 340 × 150 | Aluminium stockists | Aluminium stockists | ₹350–450 per kg (≈ ₹700) |
| Bronze | CuSn8 / phosphor bronze rod for the pivot spacers | Local | Local | ₹400–1,000 per kg ([listing](https://www.tradeindia.com/products/phosphor-bronze-rods-1685517.html)) |
| Die springs | ISO 10243: 8 × Ø10 × 32 green (light) and 8 × Ø12.5 × 44 red (heavy) | Order online | Pi-Tech Services, New Delhi ([listing](https://m.indiamart.com/pi-techservices/die-spring.html)); Standard Ring Pvt Ltd, Karnal Road ([listing](https://www.tradeindia.com/products/die-springs-563445.html)) | ISO 10243 stockists: Prosoc Engineering Solutions and Maxima Resource (Bengaluru), FIBRO India (Pune). ₹100–300 each, ₹2,000–5,000 for 16. MISUMI India sells JIS springs (from ₹83–105, same-day dispatch, [catalogue](https://in.misumi-ec.com/vona2/maker/misumi/mold/K1000000000/K1001000000/K1001020000/)) but JIS sizes and colours differ: use them only after re-checking the rates and the spring pockets |
| PTFE-composite plain bushes (DU type) | 16 × 18 × 15 (2), 16 × 18 × 20 (1), 12 × 14 × 20 (2), 12 × 14 × 6 (4) | Bearing shops | Shraddhanand Marg / G.B. Road bearing and machinery stores (e.g. [RM Overseas](https://m.indiamart.com/rm-overseas), [Nitin Machinery Stores](https://m.indiamart.com/nitin-machinery-stores)) | ₹15–150 each ([listings](https://m.indiamart.com/impcat/dry-bushings.html)); ≈ ₹1,000 |
| Bronze flanged bushes | Self-lubricating, 25 × 32 × 33 with flange, 2 | Bearing shops | Same | ₹300–600 each ([SAE 660 listings](https://m.indiamart.com/impcat/bronze-bushes.html)) |
| Socket screws, nuts, set screws | Grade 12.9 (Unbrako or TVS): 22 × M5 csk, 10 × M5 cap/low-head, 4 × M8 × 30, 2 × M10 × 16 low-head, 2 × M16 × 1.5 nuts, 2 × M10 nylock, stop screws, set screws | Local hardware | **Bazar Sirkiwalan, Chandni Chowk** fastener dealers (e.g. [Reliance Fasteners](https://m.indiamart.com/reliancefasteners/profile.html), [Panchsheel Fasteners](https://m.indiamart.com/panchsheelfasteners/profile.html)); online at Moglix ([Unbrako M5 pack](https://www.moglix.com/unbrako-m5x10mm-full-threaded-socket-head-cap-screw-122243-pack-of-500/mp/msniot8tjc1)) | ₹1,500–3,000 (small quantities cost more per piece than packs) |
| Shoulder screws ISO 7379 | Ø6 × 10 (4), Ø6 × 12 (8) | Online | Unbrako dealers | ₹80–200 each |
| Dowel pins (hardened, m6) | Frame and universal die about 13; per kit 6 | Online | Unbrako dealers | ₹500–1,000 |
| Ball plungers | M3 × 4 per kit; M6 × 1 | Online | MISUMI India (spring plungers from ₹953, [page](https://in.misumi-ec.com/vona2/detail/110310869849)); IndiaMART | ₹1,000–4,000 |
| Quick-release detent pin | Ø6, 64 usable, ring handle | Online | Jergens India (₹3,000) or generic stainless ₹200 ([listings](https://m.indiamart.com/impcat/ball-lock-pins.html)) | ₹200–3,000 |
| Return springs | Music wire Ø3.5, OD 31.5, free length 128, 2 off | Local spring maker | Spring makers in Wazirpur / Karnal Road | ₹300–800 for two (custom) |
| Nord-Lock washers | M8 (4), M16 (2) | Online | Online | ₹1,500–3,000; or use Loctite 243 with plain hardened washers |
| Small parts | Retaining rings, thumb screws, rubber pads, urethane bumpers, push knobs, TPR grip, POM sleeves, shim pack | Local | Local | ₹1,000–2,000 |

## 5. Consumables (per magnet, 63.5 × 63.5)

| Item | Spec | Where | Cost per magnet |
|---|---|---|---|
| Tin blank | 0.20 mm soft (T2) electrolytic tinplate, X + 12 with clipped corners | Optimum Steels, New Delhi, ETP sheet ₹72 per kg ([listing](https://m.indiamart.com/optimum-steels)); Diamond Tin & Metal, Kolkata, 0.20 mm ₹97 per kg ([listing](https://m.indiamart.com/diamond-tin-metal)). Cut with a hand guillotine to the print template, or have a local press shop make a ₹5,000–15,000 blanking die per size | ≈ ₹1 |
| Photo | 90–120 g/m² inkjet matte paper, printed from the Magnet Studio | Any stationer | ≈ ₹1 |
| Film | 0.075 mm PET (Mylar) | Polyester film rolls ₹100–180 per kg ([listings](https://m.indiamart.com/impcat/polyester-film.html)); Sudershan Paper Mart, Delhi | < ₹1 |
| Back | Rev E: ABS or acrylic 1.2 mm, X − 1.4, laser cut (₹2–5). After the square-kit rework: a thick back that fills the shell, as in commercial sets (card about 2–4 mm + magnet sheet), or a laser-cut 3.5–4 mm MDF/acrylic insert | Laser cutters; card and board from paper merchants (Chawri Bazar, Delhi, is the main paper market) | ₹2–6 |
| Magnet sheet | Self-adhesive flexible magnet 0.5 mm, A4 | IndiaMART sellers, ₹15–64 per A4 sheet (self-adhesive ₹64 in Greater Noida) ([listings](https://m.indiamart.com/impcat/magnetic-sheets.html)) | ₹4–7 |
| **Total** | | | **≈ ₹10–15**, against ₹25–27 for bought material sets |

## 6. Estimated total cost

| Block | What it covers | Approximate cost |
|---|---|---|
| Frame and drive | About 40 machine hours (base, rails, keepers, stop blocks, die table, columns, crown, ram, clevis, holder, cheeks, lever, links, pins, rods, spacers, pilot, post), profile cutting, about 85 kg of steel, aluminium and bronze, hardening of pins, black oxide, anodise, powder coat | ₹40,000 – 60,000 |
| Universal die | About 17 machine hours (die body, shank, upper carrier, two lower carriers, two station bases), material, black oxide | ₹12,000 – 20,000 |
| Bought parts | Springs, bushings, fasteners, pins, plungers, detent pin, small parts (section 4) | ₹12,000 – 25,000 |
| **Press without a kit** | | **₹65,000 – 1,05,000** |
| One size kit | D2 ≈ ₹2,000; soft machining 5 h; vacuum hardening; wire EDM of 6 parts (≈ 60,000 mm² of cut face incl. skim cuts, ₹9,000–15,000); grinding, cove and edge radii, lapping 6 h | ₹20,000 – 40,000 |
| **Press with one kit** | | **₹0.85 – 1.45 lakh** (≈ ₹1.7 lakh at tool-room rates) |
| All eight kits | | ₹1.6 – 3.2 lakh |

Ways to bring it down: order the frame from a private CNC shop and only the kit from a tool room; buy induction-hardened
chrome bar for the columns and hardened ground dowel stock for the pins; skip QPQ, Nord-Lock and powder coat on the first
build.

## 7. How to order

1. Send the drawing PDF and the DXF zip from `release/RevE/` (and the STEP files from `models/step/` if the shop has CAM),
   with the material and heat-treatment column of the parts list. Ask for a quote per part, and for the inspection
   report on the H7 bores, the 210.00 hole pitch (base, crown, ram) and the kit openings.
2. Kit parts: rough machine, vacuum harden, then wire-EDM and grind, in that order. Ask the tool room to arrange the
   hardening if it has no vacuum furnace.
3. Buy the springs, bushings, pins and fasteners yourself before the parts arrive, so the shop can test-fit them.
4. Start with one size kit. Order the next kits after the first magnets come out right.
