nanda-1243/tngexp/models/parts.csv

id | name | make_or_buy | group | qty_in_assembly | size_xyz_mm | volume_mm3 | file_base | note
MP-101 | Base plate | make | Frame | 1 | 460.0 × 470.0 × 15.0 | 2201209 | MP-101_base-plate
MP-102-F | Guide rail, front | make | Frame | 1 | 460.0 × 14.0 × 12.1 | 75312 | MP-102-F_guide-rail-front
MP-102-B | Guide rail, back | make | Frame | 1 | 460.0 × 14.0 × 12.1 | 74739 | MP-102-B_guide-rail-back
MP-103-F | Keeper strip, front | make | Frame | 1 | 460.0 × 20.0 × 4.1 | 35192 | MP-103-F_keeper-strip-front
MP-103-B | Keeper strip, back | make | Frame | 1 | 460.0 × 20.0 × 4.1 | 35213 | MP-103-B_keeper-strip-back
MP-104 | Station stop block | make | Frame | 2 | 30.0 × 27.0 × 16.0 | 10833 | MP-104_station-stop-block
MP-105 | Die table (slide) | make | Die table | 1 | 340.0 × 150.0 × 12.1 | 604875 | MP-105_die-table-slide
MP-106 | Die table stop pin | make | Die table | 1 | 6.0 × 6.0 × 22.0 | 528 | MP-106_die-table-stop-pin
MP-107 | Column | make | Frame | 2 | 25.0 × 25.0 × 208.7 | 90046 | MP-107_column
MP-108 | Crown | make | Frame | 1 | 120.0 × 250.0 × 25.0 | 654042 | MP-108_crown
MP-109 | Ram | make | Press drive | 1 | 80.0 × 250.0 × 30.0 | 543084 | MP-109_ram
MP-110 | Clevis | make | Press drive | 1 | 20.0 × 32.0 × 22.0 | 9191 | MP-110_clevis
MP-111 | Die holder | make | Press drive | 1 | 50.0 × 50.1 × 15.0 | 18331 | MP-111_die-holder
MP-112 | Pivot cheek | make | Press drive | 2 | 50.0 × 50.0 × 16.0 | 33407 | MP-112_pivot-cheek
MP-113 | Handle lever (one piece) | make | Press drive | 1 | 398.2 × 70.2 × 20.4 | 227874 | MP-113_handle-lever-one-piece
MP-114 | Toggle link | make | Press drive | 2 | 84.0 × 24.0 × 7.0 | 11092 | MP-114_toggle-link
MP-116 | Pin A / pin B (toggle) | make | Press drive | 2 | 12.0 × 12.0 × 39.0 | 4390 | MP-116_pin-a-pin-b-toggle
MP-117 | Pin O (handle pivot) | make | Press drive | 1 | 16.0 × 16.0 × 78.0 | 15640 | MP-117_pin-o-handle-pivot
MP-118 | Return rod | make | Press drive | 2 | 10.0 × 10.0 × 176.0 | 13823 | MP-118_return-rod
MP-119 | Pivot spacer | make | Press drive | 2 | 24.0 × 24.0 × 9.8 | 2401 | MP-119_pivot-spacer
MP-120 | Station pilot | make | Press drive | 1 | 10.1 × 10.1 × 98.0 | 6964 | MP-120_station-pilot
MP-121 | Handle-stop post | make | Frame | 1 | 20.0 × 20.0 × 26.0 | 4398 | MP-121_handle-stop-post
MP-201 | Upper die body (universal) | make | Universal die | 1 | 144.0 × 116.0 × 20.1 | 280662 | MP-201_upper-die-body-universal
MP-202 | Upper die shank (universal) | make | Universal die | 1 | 16.1 × 16.1 × 25.0 | 3903 | MP-202_upper-die-shank-universal
MP-205 | Station base (universal) | make | Universal die | 2 | 150.0 × 120.0 × 10.0 | 174608 | MP-205_station-base-universal
MP-210 | Upper carrier (universal) | make | Universal die | 1 | 144.0 × 116.0 × 14.0 | 96222 | MP-210_upper-carrier-universal
MP-211-A | Lower carrier A (universal, pickup) | make | Universal die | 1 | 144.0 × 116.0 × 18.0 | 140692 | MP-211-A_lower-carrier-a-universal-pickup
MP-211-B | Lower carrier B (universal, crimp) | make | Universal die | 1 | 144.0 × 116.0 × 18.0 | 140692 | MP-211-B_lower-carrier-b-universal-crimp
MP-212 | Plug stud (size kit, same for every size) | make | Size kit | 1 | 10.0 × 10.0 × 15.5 | 700 | MP-212_plug-stud-size-kit-same-for-every-size
MP-203-5050 | Plug, kit 50 × 50 | make | Size kit | 0 | 50.3 × 50.3 × 14.5 | 36073 | MP-203-5050_plug-kit-50-x-50
MP-204-5050 | Upper ring, kit 50 × 50 | make | Size kit | 0 | 106.0 × 81.0 × 14.0 | 83650 | MP-204-5050_upper-ring-kit-50-x-50
MP-206-5050 | Pickup pedestal, kit 50 × 50 | make | Size kit | 0 | 49.0 × 49.0 × 23.0 | 54064 | MP-206-5050_pickup-pedestal-kit-50-x-50
MP-207-5050 | Pickup ring A, kit 50 × 50 | make | Size kit | 0 | 106.0 × 81.0 × 15.0 | 89049 | MP-207-5050_pickup-ring-a-kit-50-x-50
MP-208-5050 | Crimp anvil, kit 50 × 50 | make | Size kit | 0 | 50.4 × 50.4 × 17.0 | 41519 | MP-208-5050_crimp-anvil-kit-50-x-50
MP-209-5050 | Crimp ring B, kit 50 × 50 | make | Size kit | 0 | 106.0 × 81.0 × 15.0 | 89934 | MP-209-5050_crimp-ring-b-kit-50-x-50
MP-203-6363 | Plug, kit 63.5 × 63.5 | make | Size kit | 1 | 63.8 × 63.8 × 14.5 | 58408 | MP-203-6363_plug-kit-63-5-x-63-5
MP-204-6363 | Upper ring, kit 63.5 × 63.5 | make | Size kit | 1 | 106.0 × 81.0 × 14.0 | 62257 | MP-204-6363_upper-ring-kit-63-5-x-63-5
MP-206-6363 | Pickup pedestal, kit 63.5 × 63.5 | make | Size kit | 1 | 62.5 × 62.5 × 23.0 | 88684 | MP-206-6363_pickup-pedestal-kit-63-5-x-63-5
MP-207-6363 | Pickup ring A, kit 63.5 × 63.5 | make | Size kit | 1 | 106.0 × 81.0 × 15.0 | 65629 | MP-207-6363_pickup-ring-a-kit-63-5-x-63-5
MP-208-6363 | Crimp anvil, kit 63.5 × 63.5 | make | Size kit | 1 | 63.9 × 63.9 × 17.0 | 67609 | MP-208-6363_crimp-anvil-kit-63-5-x-63-5
MP-209-6363 | Crimp ring B, kit 63.5 × 63.5 | make | Size kit | 1 | 106.0 × 81.0 × 15.0 | 66746 | MP-209-6363_crimp-ring-b-kit-63-5-x-63-5
MP-203-5380 | Plug, kit 53 × 80 | make | Size kit | 0 | 80.3 × 53.3 × 14.5 | 61446 | MP-203-5380_plug-kit-53-x-80
MP-204-5380 | Upper ring, kit 53 × 80 | make | Size kit | 0 | 106.0 × 81.0 × 14.0 | 59171 | MP-204-5380_upper-ring-kit-53-x-80
MP-206-5380 | Pickup pedestal, kit 53 × 80 | make | Size kit | 0 | 79.0 × 52.0 × 23.0 | 93325 | MP-206-5380_pickup-pedestal-kit-53-x-80
MP-207-5380 | Pickup ring A, kit 53 × 80 | make | Size kit | 0 | 106.0 × 81.0 × 15.0 | 62416 | MP-207-5380_pickup-ring-a-kit-53-x-80
MP-208-5380 | Crimp anvil, kit 53 × 80 | make | Size kit | 0 | 80.4 × 53.4 × 17.0 | 71150 | MP-208-5380_crimp-anvil-kit-53-x-80
MP-209-5380 | Crimp ring B, kit 53 × 80 | make | Size kit | 0 | 106.0 × 81.0 × 15.0 | 63585 | MP-209-5380_crimp-ring-b-kit-53-x-80
MP-203-6590 | Plug, kit 65 × 90 | make | Size kit | 0 | 90.3 × 65.3 × 14.5 | 84887 | MP-203-6590_plug-kit-65-x-90
MP-204-6590 | Upper ring, kit 65 × 90 | make | Size kit | 0 | 106.0 × 81.0 × 14.0 | 36693 | MP-204-6590_upper-ring-kit-65-x-90
MP-206-6590 | Pickup pedestal, kit 65 × 90 | make | Size kit | 0 | 89.0 × 64.0 × 23.0 | 129849 | MP-206-6590_pickup-pedestal-kit-65-x-90
MP-207-6590 | Pickup ring A, kit 65 × 90 | make | Size kit | 0 | 106.0 × 81.0 × 15.0 | 37911 | MP-207-6590_pickup-ring-a-kit-65-x-90
MP-208-6590 | Crimp anvil, kit 65 × 90 | make | Size kit | 0 | 90.4 × 65.4 × 17.0 | 98554 | MP-208-6590_crimp-anvil-kit-65-x-90
MP-209-6590 | Crimp ring B, kit 65 × 90 | make | Size kit | 0 | 106.0 × 81.0 × 15.0 | 39268 | MP-209-6590_crimp-ring-b-kit-65-x-90
MP-223-D44 | Plug, round kit Ø44 | make | Size kit | 0 | 44.3 × 44.3 × 14.6 | 21752 | MP-223-D44_plug-round-kit-d44
MP-224-D44 | Upper ring, round kit Ø44 | make | Size kit | 0 | 106.0 × 81.0 × 14.1 | 97390 | MP-224-D44_upper-ring-round-kit-d44
MP-226-D44 | Pickup pedestal, round kit Ø44 | make | Size kit | 0 | 43.0 × 43.0 × 21.9 | 30579 | MP-226-D44_pickup-pedestal-round-kit-d44
MP-227-D44 | Pickup ring A, round kit Ø44 | make | Size kit | 0 | 106.0 × 81.0 × 15.1 | 104239 | MP-227-D44_pickup-ring-a-round-kit-d44
MP-228-D44 | Crimp anvil, round kit Ø44 | make | Size kit | 0 | 44.3 × 44.3 × 17.1 | 24616 | MP-228-D44_crimp-anvil-round-kit-d44
MP-229-D44 | Crimp ring B, round kit Ø44 | make | Size kit | 0 | 106.0 × 81.0 × 15.1 | 104904 | MP-229-D44_crimp-ring-b-round-kit-d44
MP-223-D50 | Plug, round kit Ø50 | make | Size kit | 0 | 50.3 × 50.3 × 14.6 | 28216 | MP-223-D50_plug-round-kit-d50
MP-224-D50 | Upper ring, round kit Ø50 | make | Size kit | 0 | 106.0 × 81.0 × 14.1 | 91216 | MP-224-D50_upper-ring-round-kit-d50
MP-226-D50 | Pickup pedestal, round kit Ø50 | make | Size kit | 0 | 49.0 × 49.0 × 21.9 | 40030 | MP-226-D50_pickup-pedestal-round-kit-d50
MP-227-D50 | Pickup ring A, round kit Ø50 | make | Size kit | 0 | 106.0 × 81.0 × 15.1 | 97442 | MP-227-D50_pickup-ring-a-round-kit-d50
MP-228-D50 | Crimp anvil, round kit Ø50 | make | Size kit | 0 | 50.3 × 50.3 × 17.1 | 32122 | MP-228-D50_crimp-anvil-round-kit-d50
MP-229-D50 | Crimp ring B, round kit Ø50 | make | Size kit | 0 | 106.0 × 81.0 × 15.1 | 98188 | MP-229-D50_crimp-ring-b-round-kit-d50
MP-223-D56 | Plug, round kit Ø56 | make | Size kit | 0 | 56.3 × 56.4 × 14.6 | 35500 | MP-223-D56_plug-round-kit-d56
MP-224-D56 | Upper ring, round kit Ø56 | make | Size kit | 0 | 106.0 × 81.0 × 14.1 | 84250 | MP-224-D56_upper-ring-round-kit-d56
MP-226-D56 | Pickup pedestal, round kit Ø56 | make | Size kit | 0 | 55.0 × 55.1 × 21.9 | 50714 | MP-226-D56_pickup-pedestal-round-kit-d56
MP-227-D56 | Pickup ring A, round kit Ø56 | make | Size kit | 0 | 106.0 × 81.0 × 15.1 | 89797 | MP-227-D56_pickup-ring-a-round-kit-d56
MP-228-D56 | Crimp anvil, round kit Ø56 | make | Size kit | 0 | 56.3 × 56.4 × 17.1 | 40589 | MP-228-D56_crimp-anvil-round-kit-d56
MP-229-D56 | Crimp ring B, round kit Ø56 | make | Size kit | 0 | 106.0 × 81.0 × 15.1 | 90624 | MP-229-D56_crimp-ring-b-round-kit-d56
MP-223-D58 | Plug, round kit Ø58 | make | Size kit | 0 | 58.3 × 58.4 × 14.6 | 38111 | MP-223-D58_plug-round-kit-d58
MP-224-D58 | Upper ring, round kit Ø58 | make | Size kit | 0 | 106.0 × 81.0 × 14.1 | 81753 | MP-224-D58_upper-ring-round-kit-d58
MP-226-D58 | Pickup pedestal, round kit Ø58 | make | Size kit | 0 | 57.0 × 57.1 × 21.9 | 54549 | MP-226-D58_pickup-pedestal-round-kit-d58
MP-227-D58 | Pickup ring A, round kit Ø58 | make | Size kit | 0 | 106.0 × 81.0 × 15.1 | 87060 | MP-227-D58_pickup-ring-a-round-kit-d58
MP-228-D58 | Crimp anvil, round kit Ø58 | make | Size kit | 0 | 58.3 × 58.4 × 17.1 | 43625 | MP-228-D58_crimp-anvil-round-kit-d58
MP-229-D58 | Crimp ring B, round kit Ø58 | make | Size kit | 0 | 106.0 × 81.0 × 15.1 | 87914 | MP-229-D58_crimp-ring-b-round-kit-d58
BUY-01 | Rubber pad Ø24 × 3 | buy | Frame | 6 | 24.0 × 24.0 × 3.0 | 1357 | BUY-01_rubber-pad-d24-x-3 | NBR, adhesive; 6 per press (Rev E: two under the tongue)
BUY-02 | Countersunk screw M5 × 30 ISO 10642 | buy | Frame | 14 | 11.3 × 11.3 × 30.1 | 672 | BUY-02_countersunk-screw-m5-x-30-iso-10642
BUY-03 | Cap screw M5 × 35 ISO 4762 (stop blocks) | buy | Frame | 4 | 8.5 × 8.5 × 40.0 | 933 | BUY-03_cap-screw-m5-x-35-iso-4762-stop-blocks
BUY-04 | Stop screw M6 × 0.75 × 40 hex | buy | Frame | 2 | 11.5 × 10.0 × 44.0 | 1477 | BUY-04_stop-screw-m6-x-0-75-x-40-hex
BUY-05 | Thin lock nut M6 × 0.75 | buy | Frame | 2 | 11.5 × 10.0 × 3.2 | 187 | BUY-05_thin-lock-nut-m6-x-0-75
BUY-06 | Column clamp screw M10 × 16 DIN 7984 (low head) | buy | Frame | 2 | 16.0 × 16.0 × 22.0 | 2323 | BUY-06_column-clamp-screw-m10-x-16-din-7984-low-head
BUY-07 | Column clamp washer Ø32 × 2.5, hardened | buy | Frame | 2 | 32.0 × 32.0 × 2.5 | 1794 | BUY-07_column-clamp-washer-d32-x-2-5-hardened
BUY-08 | Nord-Lock washer M16 | buy | Frame | 2 | 25.4 × 25.4 × 3.4 | 951 | BUY-08_nord-lock-washer-m16
BUY-09 | Column nut M16 × 1.5 | buy | Frame | 2 | 27.7 × 24.0 × 13.0 | 3871 | BUY-09_column-nut-m16-x-1-5
BUY-10 | Handle stop screw M10 × 1 × 12, nylon patch (set screw) | buy | Frame | 1 | 10.0 × 10.0 × 12.0 | 813 | BUY-10_handle-stop-screw-m10-x-1-x-12-nylon-patch-set-screw
BUY-12 | Handle stop cap, urethane Ø16 × 4 | buy | Frame | 1 | 16.0 × 16.0 × 4.0 | 804 | BUY-12_handle-stop-cap-urethane-d16-x-4
BUY-13 | Flanged bronze bushing 25 × 32 × 33 (ram) | buy | Press drive | 2 | 40.0 × 40.0 × 33.0 | 11699 | BUY-13_flanged-bronze-bushing-25-x-32-x-33-ram | self-lubricating, graphite plugs
BUY-14 | PTFE-composite bushing 16 × 18 × 15 (cheeks) | buy | Press drive | 2 | 18.0 × 18.0 × 15.0 | 801 | BUY-14_ptfe-composite-bushing-16-x-18-x-15-cheeks
BUY-15 | PTFE-composite bushing 16 × 18 × 20 (lever O) | buy | Press drive | 1 | 18.0 × 18.0 × 20.0 | 1068 | BUY-15_ptfe-composite-bushing-16-x-18-x-20-lever-o
BUY-16 | PTFE-composite bushing 12 × 14 × 20 (lever A, clevis) | buy | Press drive | 2 | 14.0 × 14.0 × 20.0 | 817 | BUY-16_ptfe-composite-bushing-12-x-14-x-20-lever-a-clevis
BUY-17 | PTFE-composite bushing 12 × 14 × 6 (links) | buy | Press drive | 4 | 14.0 × 14.0 × 6.0 | 245 | BUY-17_ptfe-composite-bushing-12-x-14-x-6-links
BUY-18 | Retaining ring DIN 471-12 | buy | Press drive | 4 | 16.5 × 16.3 × 1.0 | 100 | BUY-18_retaining-ring-din-471-12
BUY-19 | Retaining ring DIN 471-16 | buy | Press drive | 2 | 21.5 × 21.3 × 1.0 | 169 | BUY-19_retaining-ring-din-471-16
BUY-20 | Return spring Ø3.5 wire, OD 31.5 (shown installed, 109.5) | buy | Press drive | 2 | 32.1 × 32.1 × 110.1 | 15572 | BUY-20_return-spring-d3-5-wire-od-31-5-shown-installed-109-5 | music wire, free length 128, about 16.4 active coils
BUY-21 | Washer Ø32 × 3 (return rod) | buy | Press drive | 2 | 32.0 × 32.0 × 3.0 | 2153 | BUY-21_washer-d32-x-3-return-rod
BUY-49 | Spring guide sleeve POM Ø24 × Ø10.5 × 60 (return rod) | buy | Press drive | 2 | 24.0 × 24.0 × 60.0 | 21948 | BUY-49_spring-guide-sleeve-pom-d24-x-d10-5-x-60-return-rod | Rev E: centres the return spring on its rod and stops it buckling
BUY-22 | Nylock nut M10 | buy | Press drive | 2 | 19.6 × 17.0 × 10.0 | 1717 | BUY-22_nylock-nut-m10
BUY-23 | Urethane bumper Ø16 × 12, M6 stud | buy | Press drive | 2 | 16.0 × 16.0 × 22.0 | 2695 | BUY-23_urethane-bumper-d16-x-12-m6-stud
BUY-24 | Cap screw M8 × 30 ISO 4762 (cheeks) | buy | Press drive | 4 | 13.0 × 13.0 × 38.0 | 2433 | BUY-24_cap-screw-m8-x-30-iso-4762-cheeks
BUY-25 | Nord-Lock washer M8 | buy | Press drive | 4 | 13.5 × 13.5 × 2.5 | 209 | BUY-25_nord-lock-washer-m8
BUY-26 | Dowel pin Ø6 × 16 (cheeks) | buy | Press drive | 2 | 6.0 × 6.0 × 16.0 | 452 | BUY-26_dowel-pin-d6-x-16-cheeks
BUY-27 | Cap screw M5 × 25 ISO 4762 (clevis) | buy | Press drive | 2 | 8.5 × 8.5 × 30.0 | 736 | BUY-27_cap-screw-m5-x-25-iso-4762-clevis
BUY-28 | Low-head cap screw M5 × 16 DIN 7984 (die holder) | buy | Press drive | 4 | 8.5 × 8.5 × 19.5 | 498 | BUY-28_low-head-cap-screw-m5-x-16-din-7984-die-holder
BUY-29 | Lock screw M5 × 10 ISO 4027, cone point (die holder) | buy | Press drive | 1 | 5.0 × 5.0 × 10.0 | 152 | BUY-29_lock-screw-m5-x-10-iso-4027-cone-point-die-holder
BUY-30 | Grip, red TPR Ø32 × 120 | buy | Press drive | 1 | 32.0 × 32.0 × 120.0 | 41851 | BUY-30_grip-red-tpr-d32-x-120
BUY-31 | Spring ball plunger M6 | buy | Die table | 1 | 6.0 × 6.0 × 11.5 | 316 | BUY-31_spring-ball-plunger-m6
BUY-32 | Push knob, phenolic Ø14 × 18, M5 | buy | Die table | 2 | 14.0 × 14.0 × 26.0 | 2851 | BUY-32_push-knob-phenolic-d14-x-18-m5
BUY-33 | Die spring ISO 10243 Ø10 × 32 green (light), shown installed 30 | buy | Universal die | 8 | 9.8 × 9.8 × 30.0 | 311 | BUY-33_die-spring-iso-10243-d10-x-32-green-light-shown-installed-30
BUY-34 | Die spring ISO 10243 Ø12.5 × 44 red (heavy), shown installed 36 | buy | Universal die | 8 | 12.3 × 12.3 × 36.1 | 896 | BUY-34_die-spring-iso-10243-d12-5-x-44-red-heavy-shown-installed-36 | Rev E: 8 mm preload, 1.57 kN total; holds the upper ring while stroke 1 folds the flat tin blank
BUY-35 | Shoulder screw ISO 7379 Ø6 × 10 (upper carrier) | buy | Universal die | 4 | 10.0 × 10.0 × 24.0 | 803 | BUY-35_shoulder-screw-iso-7379-d6-x-10-upper-carrier
BUY-36 | Shoulder screw ISO 7379 Ø6 × 12 (lower carriers) | buy | Universal die | 8 | 10.0 × 10.0 × 26.0 | 860 | BUY-36_shoulder-screw-iso-7379-d6-x-12-lower-carriers
BUY-37 | Key pin Ø4 × 14 | buy | Universal die | 6 | 4.0 × 4.0 × 14.0 | 176 | BUY-37_key-pin-d4-x-14
BUY-38 | Thumb screw M5, knurled, dog point Ø3.5 × 3 (upper ring) | buy | Universal die | 2 | 11.9 × 11.9 × 28.0 | 1009 | BUY-38_thumb-screw-m5-knurled-dog-point-d3-5-x-3-upper-ring
BUY-39 | Quick-release detent pin Ø6, usable length 64, ring handle | buy | Universal die | 1 | 22.0 × 22.0 × 71.0 | 2799 | BUY-39_quick-release-detent-pin-d6-usable-length-64-ring-handle
BUY-40 | Countersunk screw M5 × 20 ISO 10642 (station bases) | buy | Universal die | 8 | 11.3 × 11.3 × 20.1 | 476 | BUY-40_countersunk-screw-m5-x-20-iso-10642-station-bases
BUY-41 | Dowel pin Ø6 × 12 (station bases) | buy | Universal die | 4 | 6.0 × 6.0 × 12.0 | 339 | BUY-41_dowel-pin-d6-x-12-station-bases
BUY-42 | Orientation pin Ø4 × 10 | buy | Universal die | 1 | 4.0 × 4.0 × 10.0 | 126 | BUY-42_orientation-pin-d4-x-10
BUY-43 | Depth shim pack Ø40 × 1 | buy | Universal die | 1 | 40.0 × 39.9 × 1.0 | 1036 | BUY-43_depth-shim-pack-d40-x-1 | stainless 0.1 / 0.2 / 0.5, shown as 1.0
BUY-44 | Puller, M5 T-handle (loose tool) | buy | Universal die | 0 | 50.0 × 10.0 × 44.0 | 3390 | BUY-44_puller-m5-t-handle-loose-tool
BUY-45 | Ball plunger M3 (upper ring) | buy | Size kit | 4 | 3.0 × 3.0 × 6.0 | 42 | BUY-45_ball-plunger-m3-upper-ring | 4 per kit; ball protrudes 0.2-0.3 into the opening, 1.8 above the ring bottom
BUY-46 | Dowel pin Ø5 × 14 (plug) | buy | Size kit | 2 | 5.0 × 5.0 × 14.0 | 275 | BUY-46_dowel-pin-d5-x-14-plug
BUY-47 | Dowel pin Ø12 × 15 (pedestal and anvil spigot) | buy | Size kit | 2 | 12.0 × 12.0 × 15.0 | 1696 | BUY-47_dowel-pin-d12-x-15-pedestal-and-anvil-spigot
BUY-48 | Pin Ø4 × 10 (pedestal and anvil anti-rotation) | buy | Size kit | 2 | 4.0 × 4.0 × 10.0 | 126 | BUY-48_pin-d4-x-10-pedestal-and-anvil-anti-rotation
