nanda-1243/tngexp/models/assembly/MagPress-M4_assembly.step

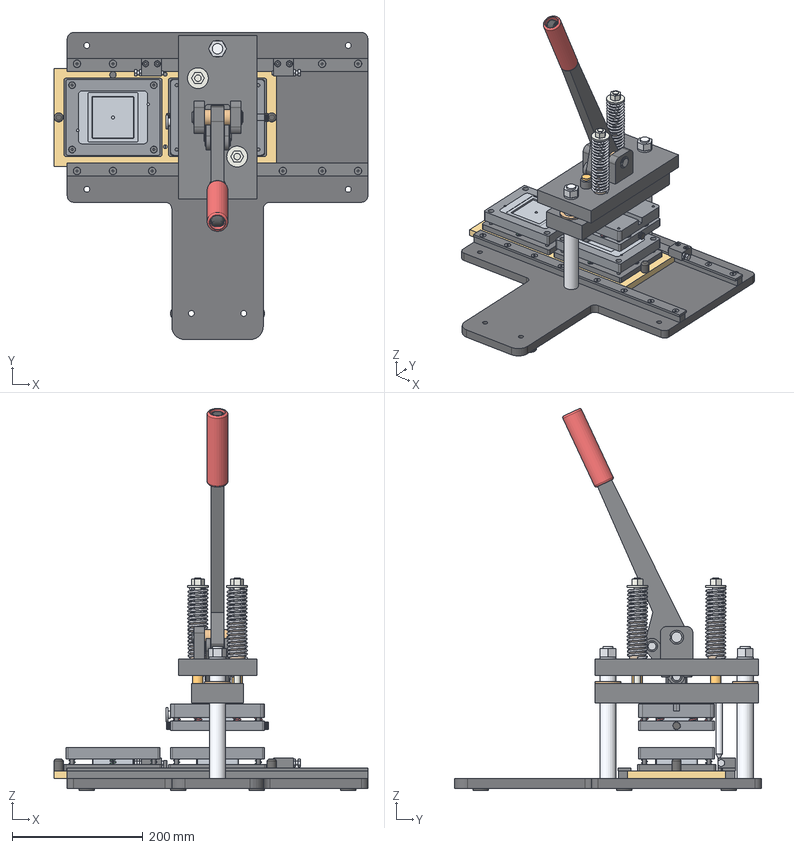
[picture p172: CAD file, 2026-10-28]
models/assembly/MagPress-M4_assembly.step
480.0 x 470.0 x 584.5 mm
MP-101_1
MP-102-F_1
MP-102-B_1
MP-103-F_1
MP-103-B_1
MP-104_1
MP-104_2
MP-105_1
MP-106_1
MP-107_1
MP-107_2
MP-108_1
MP-109_1
MP-110_1
MP-111_1
MP-112_1
MP-112_2
MP-113_1
MP-114_1
MP-114_2
MP-116_1
MP-116_2
MP-117_1
MP-118_1
MP-118_2
MP-119_1
MP-119_2
MP-120_1
MP-121_1
MP-201_1
MP-202_1
MP-205_1
MP-205_2
MP-210_1
MP-211-A_1
MP-211-B_1
MP-212_1
MP-203-6363_1
MP-204-6363_1
MP-206-6363_1
MP-207-6363_1
MP-208-6363_1
MP-209-6363_1
BUY-01_1
BUY-01_2
BUY-01_3
BUY-01_4
BUY-01_5
BUY-01_6
BUY-02_1
BUY-02_2
BUY-02_3
BUY-02_4
BUY-02_5
BUY-02_6
BUY-02_7
BUY-02_8
BUY-02_9
BUY-02_10
BUY-02_11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
