nanda-1243/tngexp/models/step/MP-228-D44_crimp-anvil-round-kit-d44.step

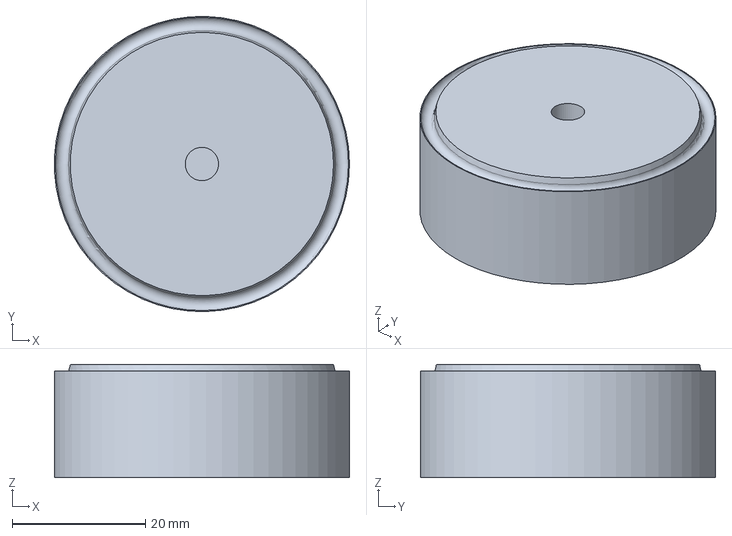
[picture p173: CAD file, 2026-10-28]
models/step/MP-228-D44_crimp-anvil-round-kit-d44.step
44.3 x 44.3 x 17.0 mm
