nanda-1243/tngexp/models/step/MP-207-5050_pickup-ring-a-kit-50-x-50.step

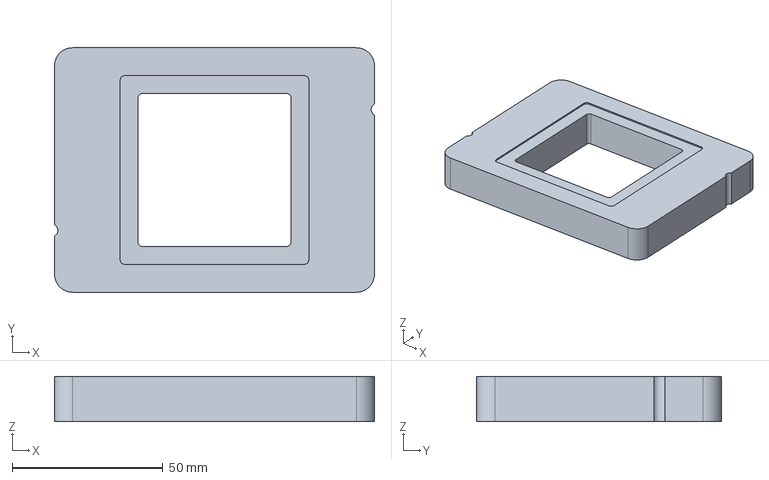
[picture p174: CAD file, 2026-10-28]
models/step/MP-207-5050_pickup-ring-a-kit-50-x-50.step
106.0 x 81.0 x 15.0 mm
