nanda-1243/tngexp/models/step/MP-208-5050_crimp-anvil-kit-50-x-50.step

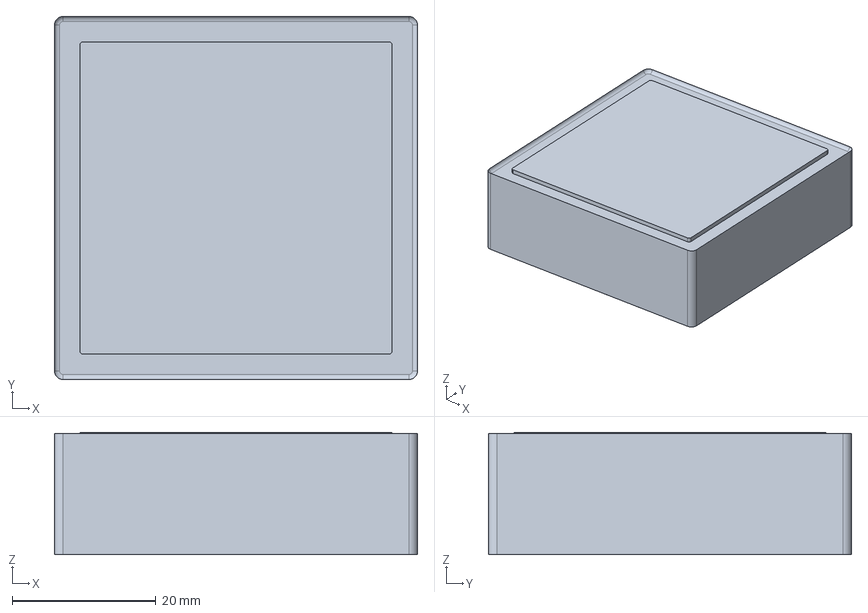
[picture p175: CAD file, 2026-10-28]
models/step/MP-208-5050_crimp-anvil-kit-50-x-50.step
50.4 x 50.4 x 17.0 mm
