nanda-1243/tngexp/models/step/MP-206-6363_pickup-pedestal-kit-63-5-x-63-5.step

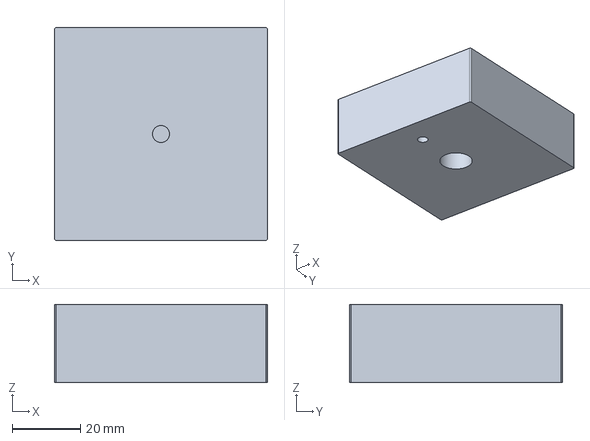
[picture p176: CAD file, 2026-10-28]
models/step/MP-206-6363_pickup-pedestal-kit-63-5-x-63-5.step
62.5 x 62.5 x 23.0 mm
