nanda-1243/tngexp/models/step/MP-227-D50_pickup-ring-a-round-kit-d50.step

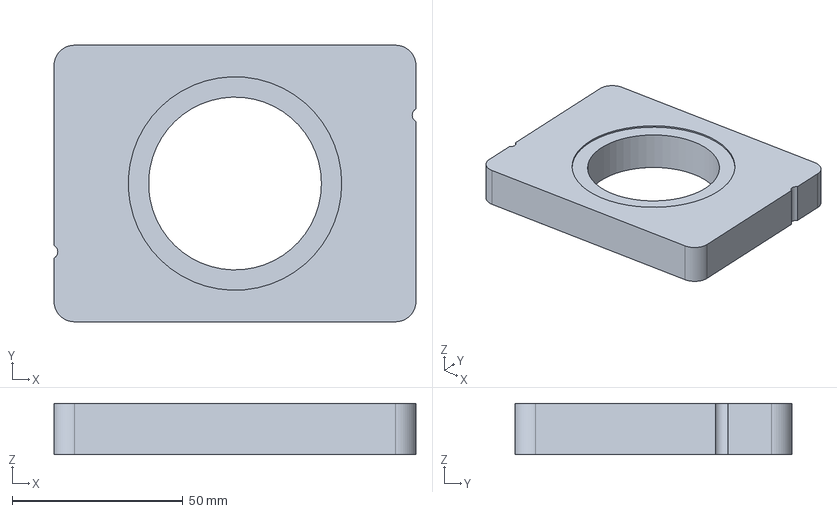
[picture p177: CAD file, 2026-10-28]
models/step/MP-227-D50_pickup-ring-a-round-kit-d50.step
106.0 x 81.0 x 15.0 mm
