nanda-1243/tngexp/models/step/MP-113_handle-lever-one-piece.step

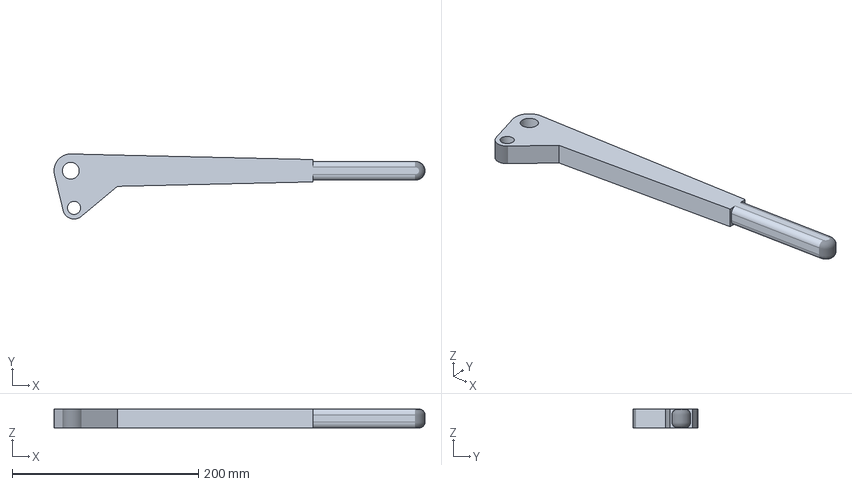
[picture p178: CAD file, 2026-10-28]
models/step/MP-113_handle-lever-one-piece.step
398.0 x 69.8 x 20.0 mm
