nanda-1243/tngexp/models/step/MP-228-D56_crimp-anvil-round-kit-d56.step

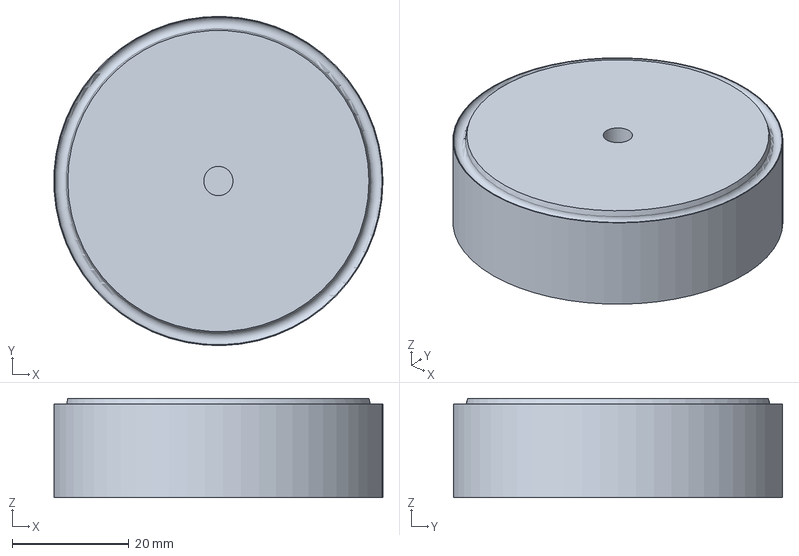
[picture p179: CAD file, 2026-10-28]
models/step/MP-228-D56_crimp-anvil-round-kit-d56.step
56.3 x 56.3 x 17.0 mm
