nanda-1243/tngexp/models/step/MP-228-D58_crimp-anvil-round-kit-d58.step

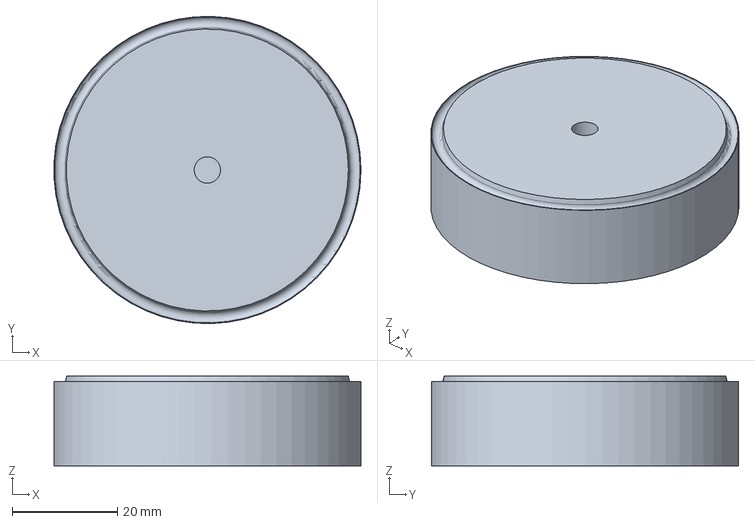
[picture p180: CAD file, 2026-10-28]
models/step/MP-228-D58_crimp-anvil-round-kit-d58.step
58.3 x 58.3 x 17.0 mm
