nanda-1243/tngexp/models/step/MP-207-5380_pickup-ring-a-kit-53-x-80.step

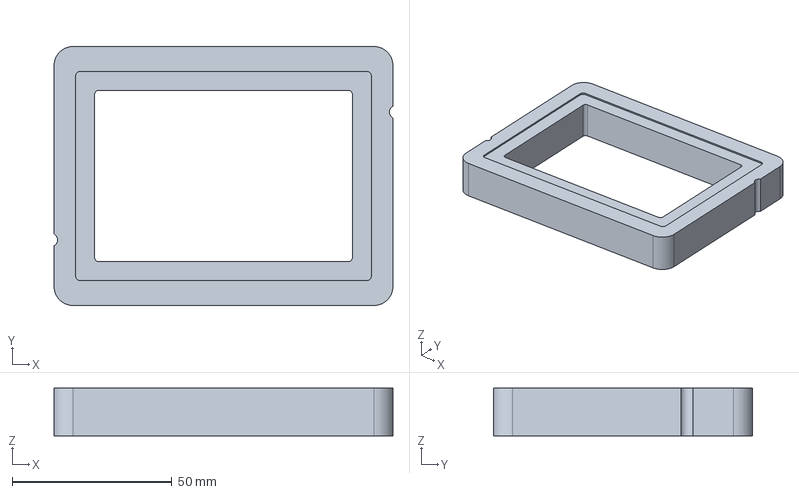
[picture p181: CAD file, 2026-10-28]
models/step/MP-207-5380_pickup-ring-a-kit-53-x-80.step
106.0 x 81.0 x 15.0 mm
