nanda-1243/tngexp/models/step/MP-206-5050_pickup-pedestal-kit-50-x-50.step

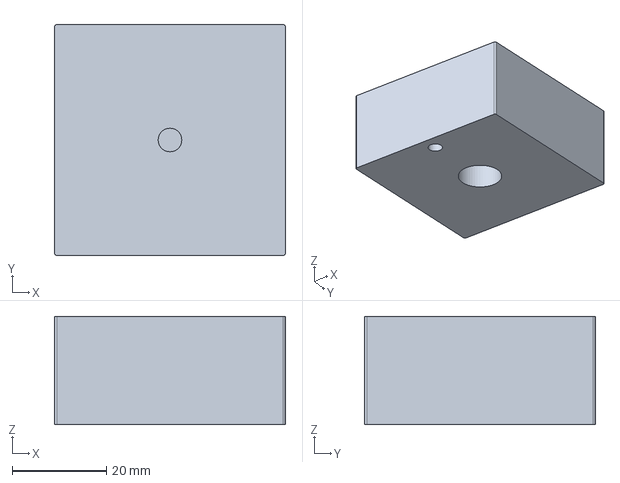
[picture p182: CAD file, 2026-10-28]
models/step/MP-206-5050_pickup-pedestal-kit-50-x-50.step
49.0 x 49.0 x 23.0 mm
