nanda-1243/tngexp/models/step/MP-208-5380_crimp-anvil-kit-53-x-80.step

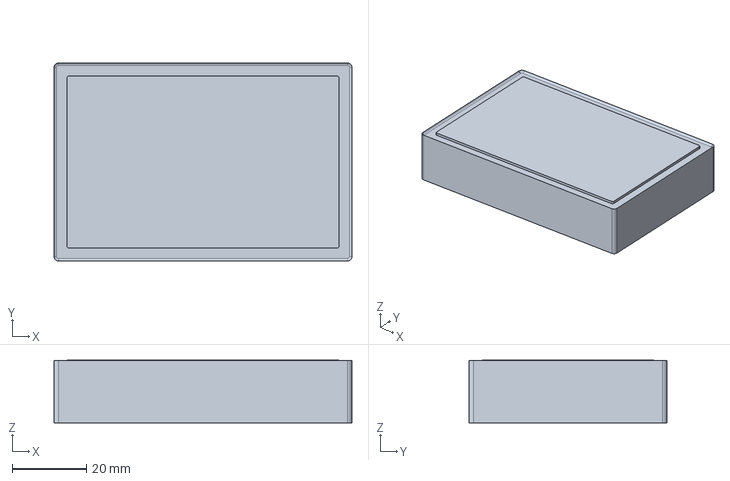
[picture p183: CAD file, 2026-10-28]
models/step/MP-208-5380_crimp-anvil-kit-53-x-80.step
80.4 x 53.4 x 17.0 mm
