nanda-1243/tngexp/models/step/MP-228-D50_crimp-anvil-round-kit-d50.step

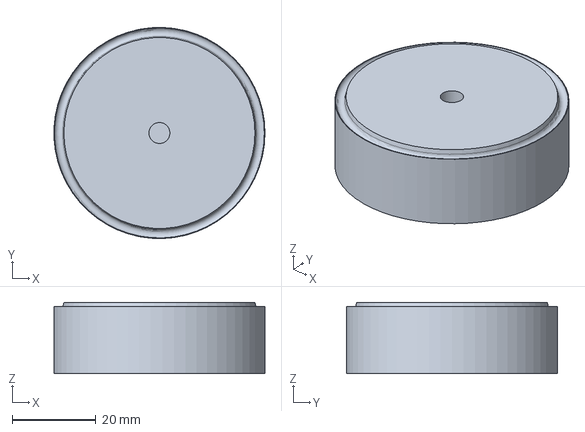
[picture p184: CAD file, 2026-10-28]
models/step/MP-228-D50_crimp-anvil-round-kit-d50.step
50.3 x 50.3 x 17.0 mm
