nanda-1243/tngexp/models/step/MP-208-6363_crimp-anvil-kit-63-5-x-63-5.step

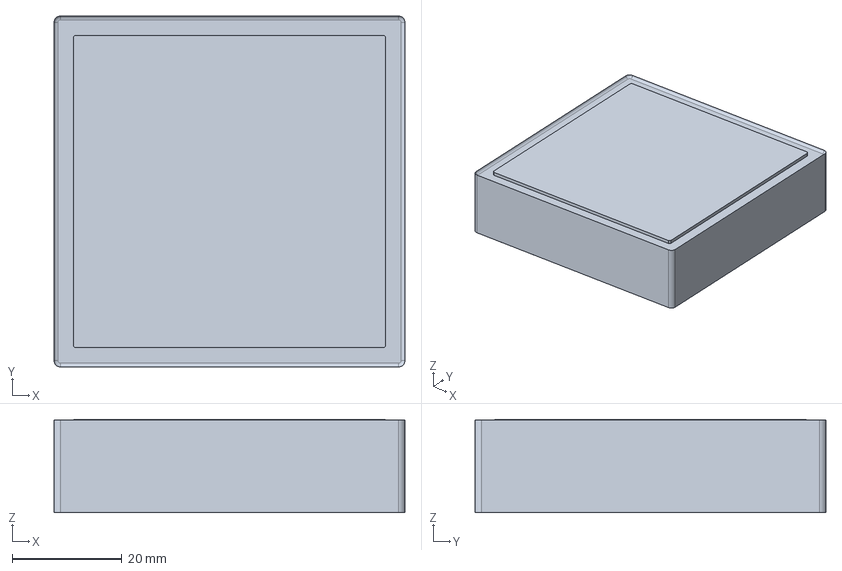
[picture p185: CAD file, 2026-10-28]
models/step/MP-208-6363_crimp-anvil-kit-63-5-x-63-5.step
63.9 x 63.9 x 17.0 mm
