nanda-1243/tngexp/models/step/MP-207-6590_pickup-ring-a-kit-65-x-90.step

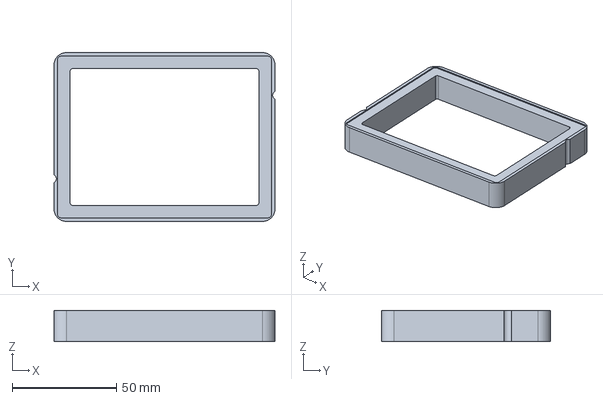
[picture p186: CAD file, 2026-10-28]
models/step/MP-207-6590_pickup-ring-a-kit-65-x-90.step
106.0 x 81.0 x 15.0 mm
