nanda-1243/tngexp/models/step/MP-206-6590_pickup-pedestal-kit-65-x-90.step

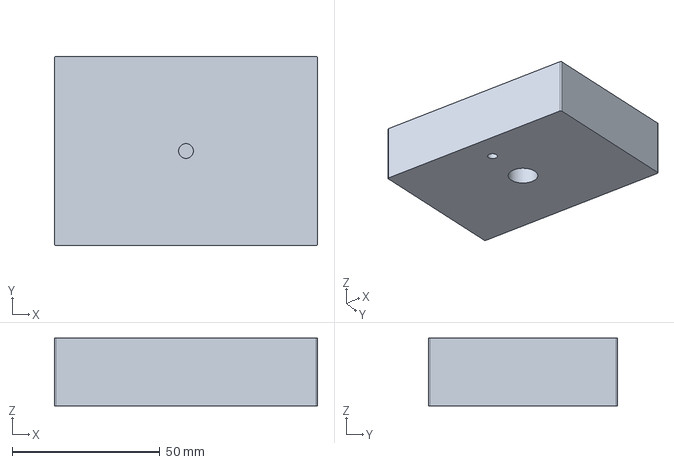
[picture p187: CAD file, 2026-10-28]
models/step/MP-206-6590_pickup-pedestal-kit-65-x-90.step
89.0 x 64.0 x 23.0 mm
