nanda-1243/tngexp/models/step/MP-227-D44_pickup-ring-a-round-kit-d44.step

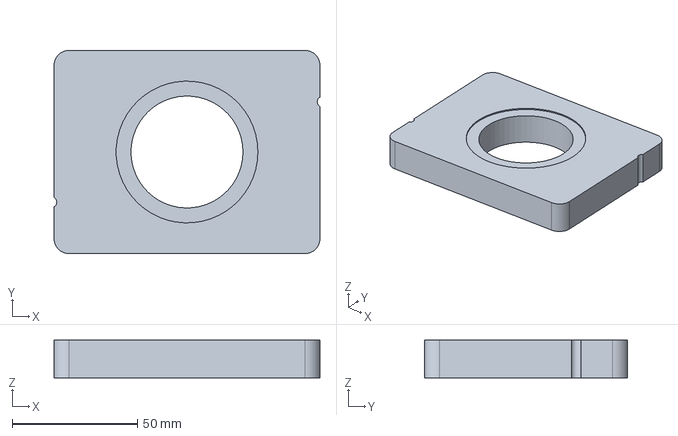
[picture p188: CAD file, 2026-10-28]
models/step/MP-227-D44_pickup-ring-a-round-kit-d44.step
106.0 x 81.0 x 15.0 mm
