nanda-1243/tngexp/models/step/MP-206-5380_pickup-pedestal-kit-53-x-80.step

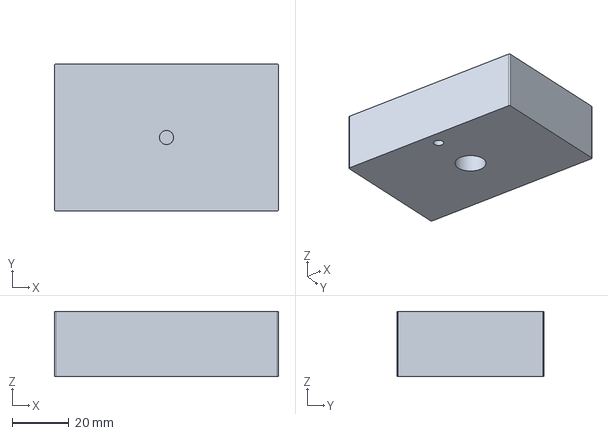
[picture p189: CAD file, 2026-10-28]
models/step/MP-206-5380_pickup-pedestal-kit-53-x-80.step
79.0 x 52.0 x 23.0 mm
