nanda-1243/tngexp/models/step/MP-208-6590_crimp-anvil-kit-65-x-90.step

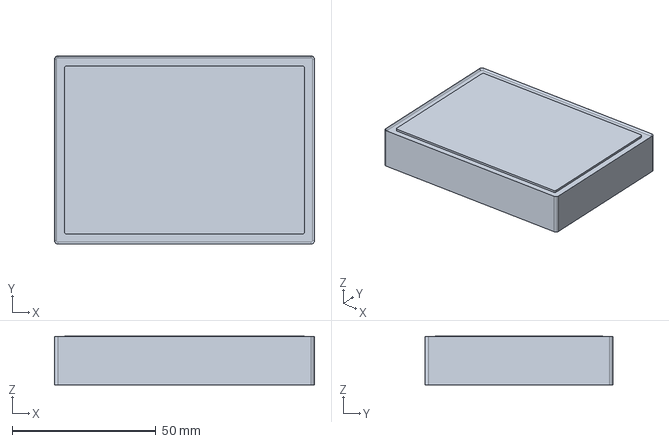
[picture p190: CAD file, 2026-10-28]
models/step/MP-208-6590_crimp-anvil-kit-65-x-90.step
90.4 x 65.4 x 17.0 mm
