nanda-1243/tngexp/models/step/MP-204-5050_upper-ring-kit-50-x-50.step

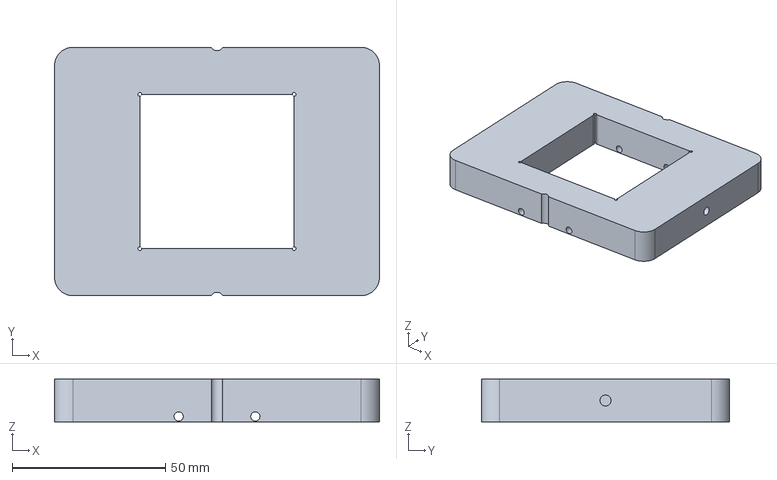
[picture p191: CAD file, 2026-10-27]
models/step/MP-204-5050_upper-ring-kit-50-x-50.step
106.0 x 81.0 x 14.0 mm
