nanda-1243/tngexp/models/step/BUY-16_ptfe-composite-bushing-12-x-14-x-20-lever-a-clevis.step

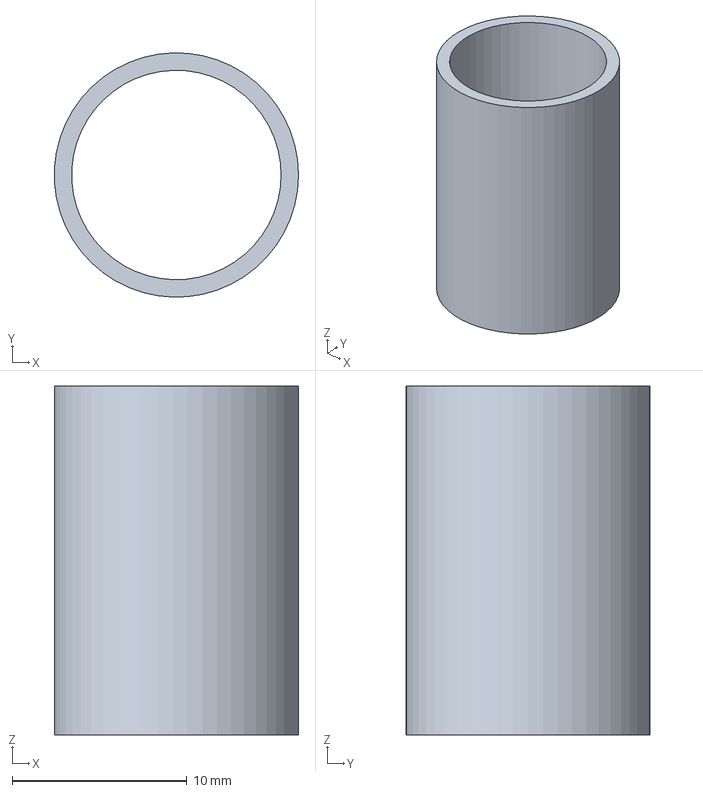
[picture p192: CAD file, 2026-10-27]
models/step/BUY-16_ptfe-composite-bushing-12-x-14-x-20-lever-a-clevis.step
14.0 x 14.0 x 20.0 mm
