nanda-1243/tngexp/models/step/BUY-18_retaining-ring-din-471-12.step

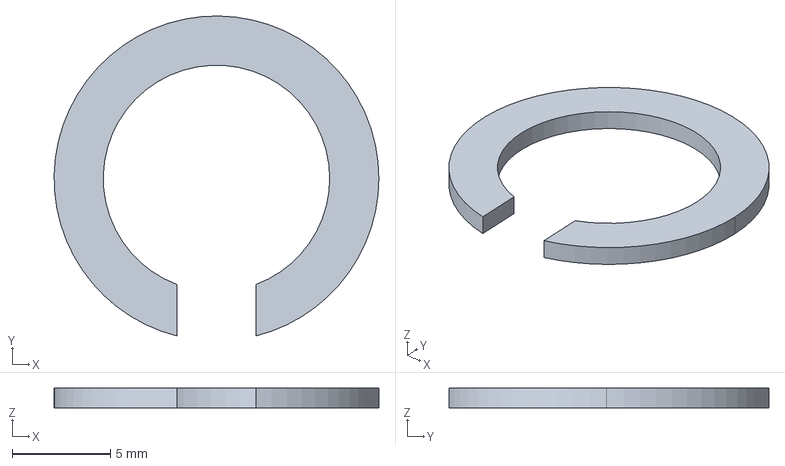
[picture p193: CAD file, 2026-10-27]
models/step/BUY-18_retaining-ring-din-471-12.step
16.5 x 16.3 x 1.00 mm
