nanda-1243/tngexp/models/step/MP-204-6590_upper-ring-kit-65-x-90.step

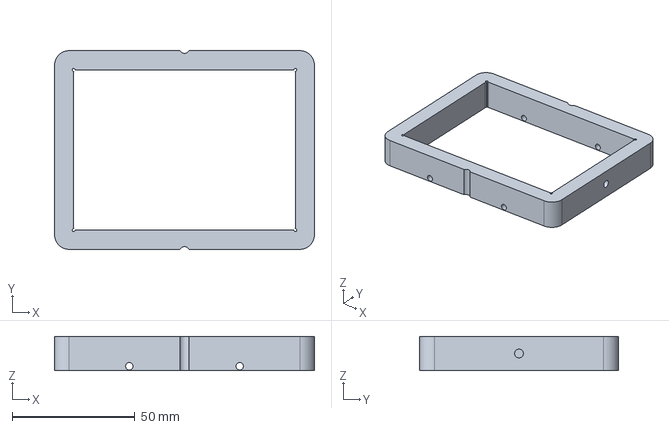
[picture p194: CAD file, 2026-10-27]
models/step/MP-204-6590_upper-ring-kit-65-x-90.step
106.0 x 81.0 x 14.0 mm
