nanda-1243/tngexp/models/step/MP-211-B_lower-carrier-b-universal-crimp.step

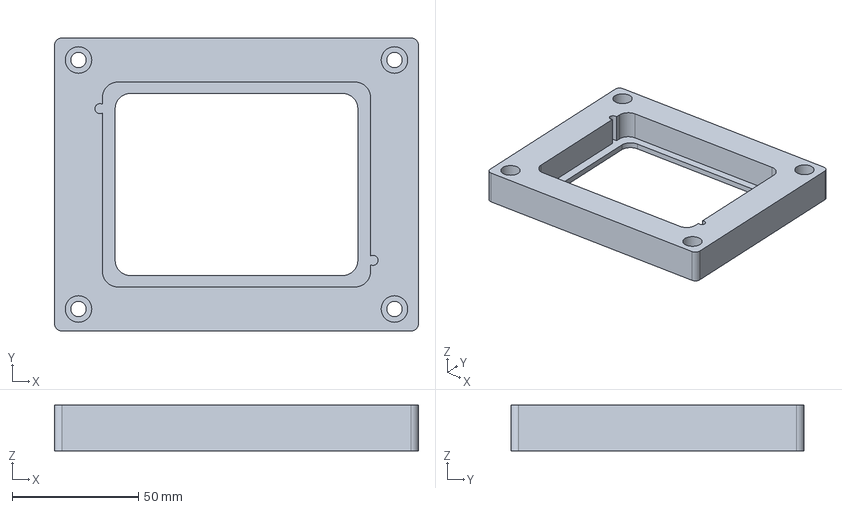
[picture p195: CAD file, 2026-10-27]
models/step/MP-211-B_lower-carrier-b-universal-crimp.step
144.0 x 116.0 x 18.0 mm
