nanda-1243/tngexp/models/step/MP-105_die-table-slide.step

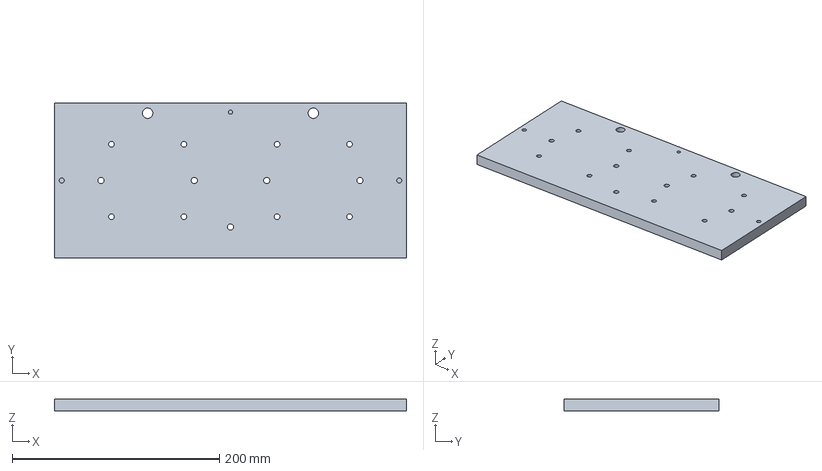
[picture p196: CAD file, 2026-10-27]
models/step/MP-105_die-table-slide.step
340.0 x 150.0 x 12.0 mm
