nanda-1243/tngexp/models/step/BUY-43_depth-shim-pack-d40-x-1.step

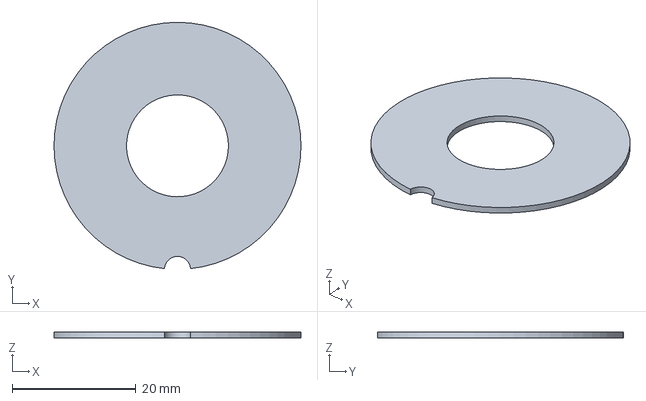
[picture p197: CAD file, 2026-10-27]
models/step/BUY-43_depth-shim-pack-d40-x-1.step
40.0 x 39.9 x 1.00 mm
