nanda-1243/tngexp/models/step/BUY-31_spring-ball-plunger-m6.step

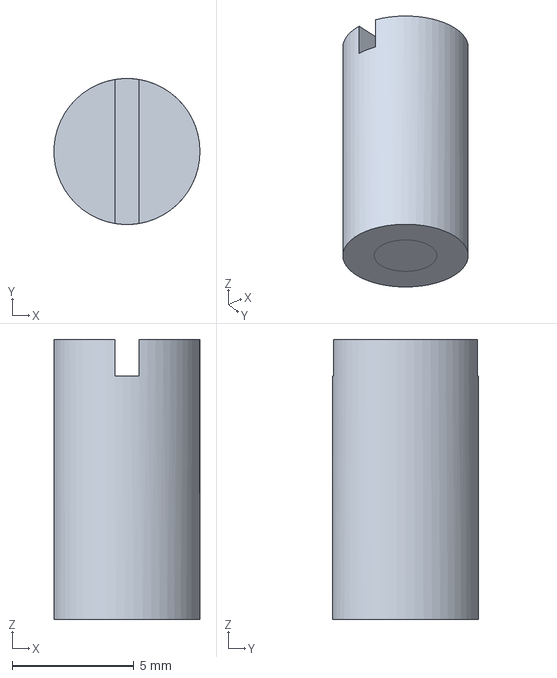
[picture p198: CAD file, 2026-10-27]
models/step/BUY-31_spring-ball-plunger-m6.step
5.99 x 6.00 x 11.5 mm
