nanda-1243/tngexp/models/step/BUY-37_key-pin-d4-x-14.step

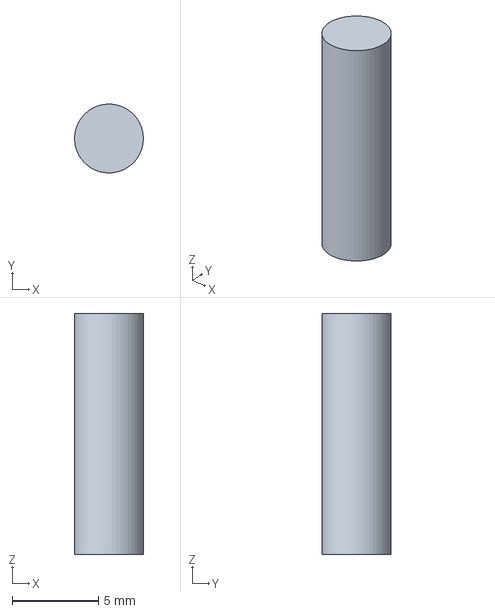
[picture p199: CAD file, 2026-10-27]
models/step/BUY-37_key-pin-d4-x-14.step
4.00 x 4.00 x 14.0 mm
