nanda-1243/tngexp/models/step/BUY-19_retaining-ring-din-471-16.step

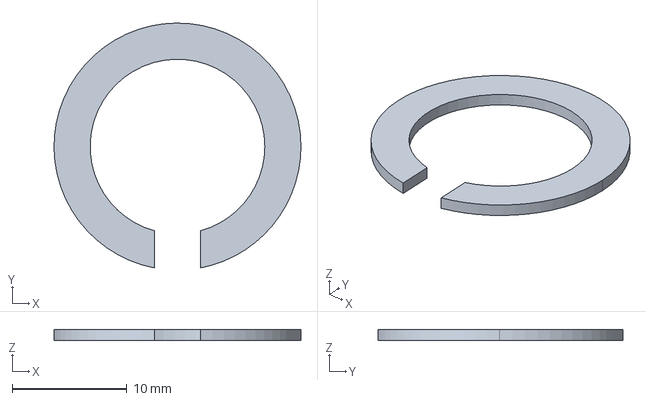
[picture p200: CAD file, 2026-10-27]
models/step/BUY-19_retaining-ring-din-471-16.step
21.5 x 21.3 x 1.00 mm
