nanda-1243/tngexp/models/step/MP-104_station-stop-block.step

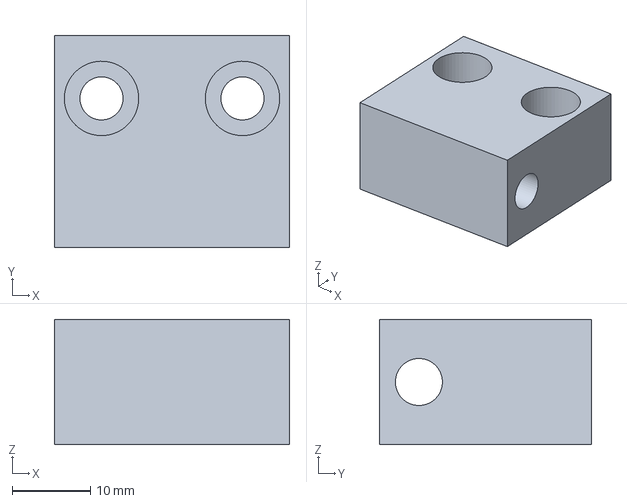
[picture p201: CAD file, 2026-10-27]
models/step/MP-104_station-stop-block.step
30.0 x 27.0 x 16.0 mm
