nanda-1243/tngexp/models/step/MP-223-D44_plug-round-kit-d44.step

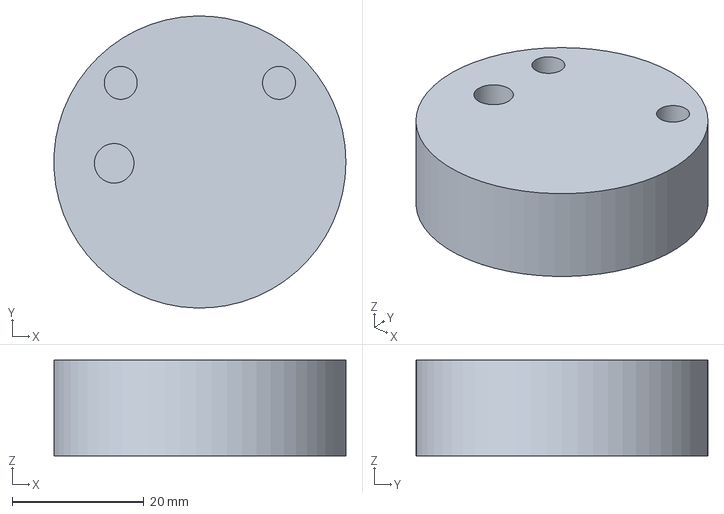
[picture p202: CAD file, 2026-10-27]
models/step/MP-223-D44_plug-round-kit-d44.step
44.3 x 44.3 x 14.5 mm
