nanda-1243/tngexp/models/step/BUY-42_orientation-pin-d4-x-10.step

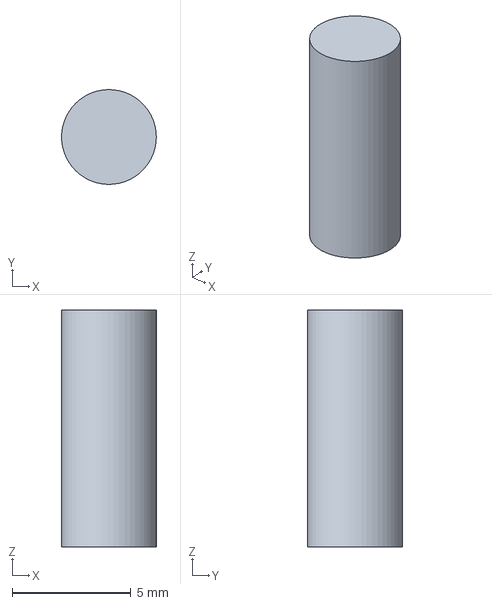
[picture p203: CAD file, 2026-10-27]
models/step/BUY-42_orientation-pin-d4-x-10.step
4.00 x 4.00 x 10.0 mm
