nanda-1243/tngexp/models/step/BUY-33_die-spring-iso-10243-d10-x-32-green-light-shown-installed-30.step

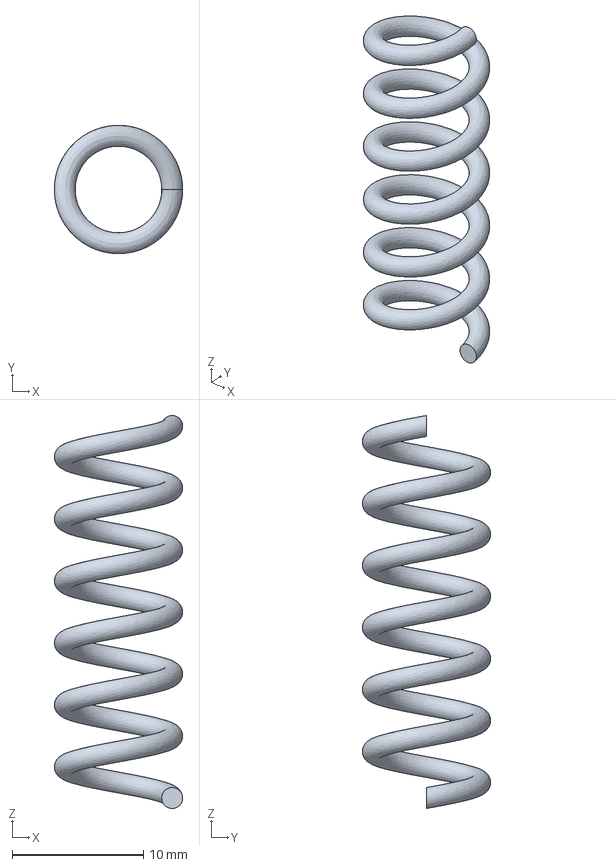
[picture p204: CAD file, 2026-10-27]
models/step/BUY-33_die-spring-iso-10243-d10-x-32-green-light-shown-installed-30.step
9.80 x 9.80 x 30.0 mm
