nanda-1243/tngexp/models/step/MP-201_upper-die-body-universal.step

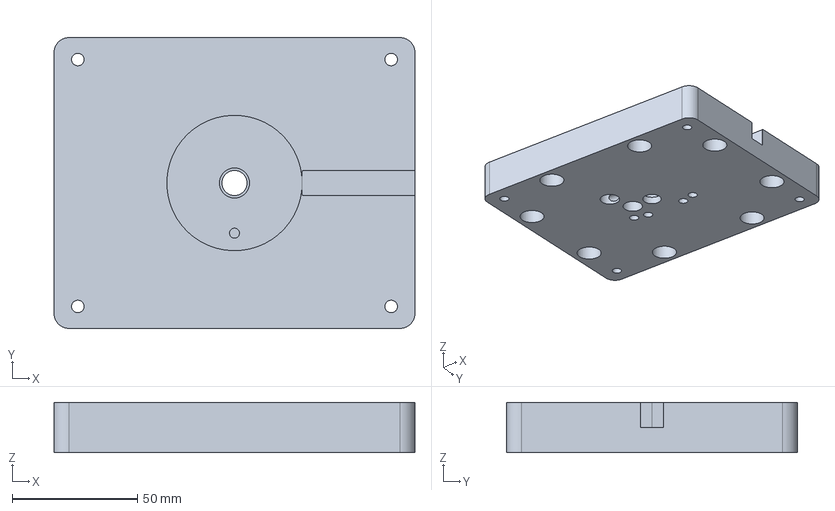
[picture p205: CAD file, 2026-10-27]
models/step/MP-201_upper-die-body-universal.step
144.0 x 116.0 x 20.0 mm
