nanda-1243/tngexp/models/step/MP-223-D58_plug-round-kit-d58.step

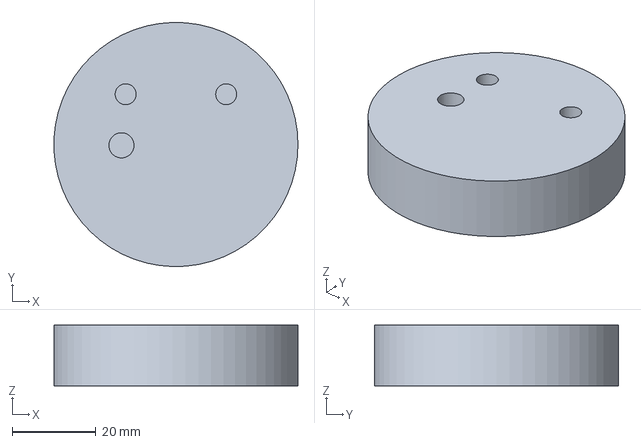
[picture p206: CAD file, 2026-10-27]
models/step/MP-223-D58_plug-round-kit-d58.step
58.3 x 58.3 x 14.5 mm
