nanda-1243/tngexp/models/step/MP-120_station-pilot.step

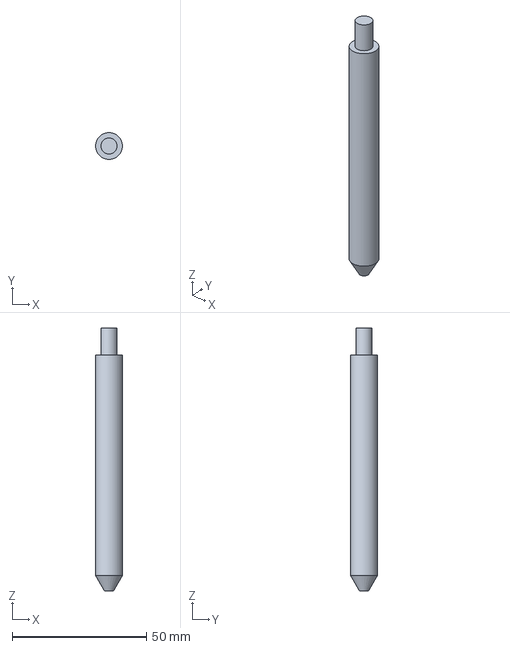
[picture p207: CAD file, 2026-10-27]
models/step/MP-120_station-pilot.step
9.99 x 10.00 x 98.0 mm
