nanda-1243/tngexp/models/step/BUY-47_dowel-pin-d12-x-15-pedestal-and-anvil-spigot.step

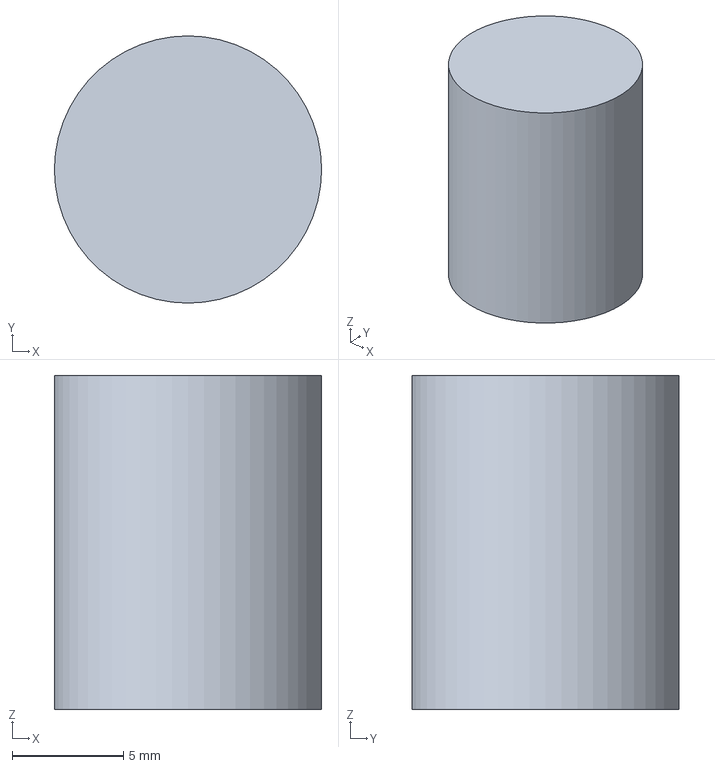
[picture p208: CAD file, 2026-10-27]
models/step/BUY-47_dowel-pin-d12-x-15-pedestal-and-anvil-spigot.step
12.0 x 12.0 x 15.0 mm
