nanda-1243/tngexp/models/step/MP-121_handle-stop-post.step

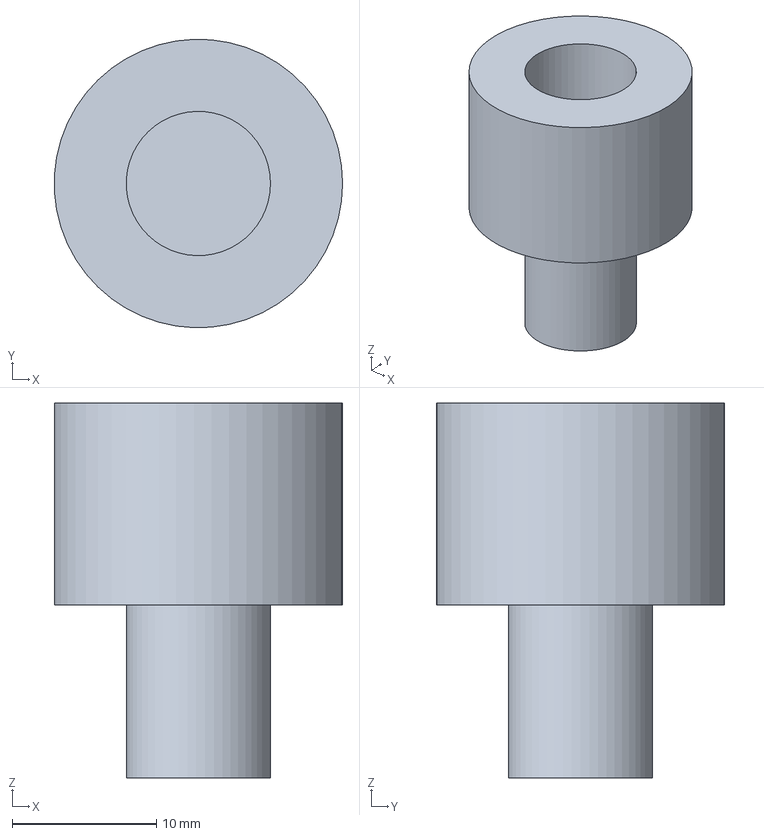
[picture p209: CAD file, 2026-10-27]
models/step/MP-121_handle-stop-post.step
20.0 x 20.0 x 26.0 mm
