nanda-1243/tngexp/models/step/MP-226-D58_pickup-pedestal-round-kit-d58.step

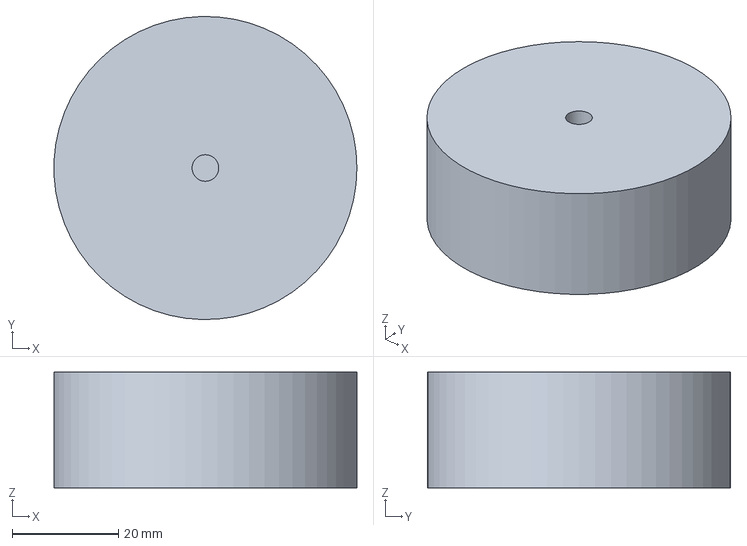
[picture p210: CAD file, 2026-10-27]
models/step/MP-226-D58_pickup-pedestal-round-kit-d58.step
57.0 x 57.0 x 21.8 mm
