nanda-1243/tngexp/models/step/MP-226-D44_pickup-pedestal-round-kit-d44.step

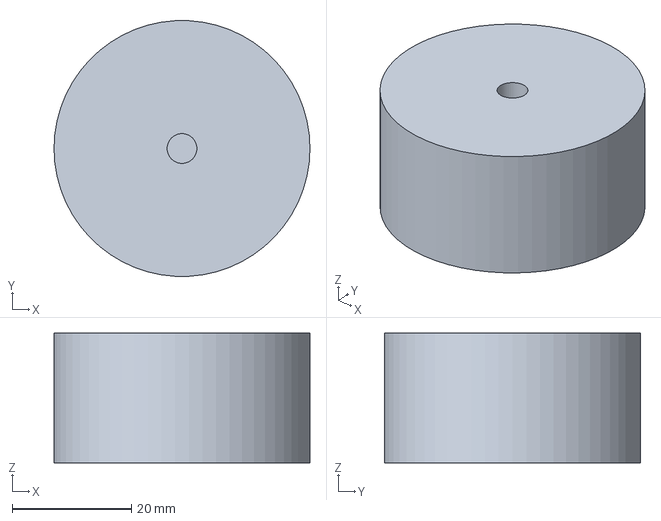
[picture p211: CAD file, 2026-10-27]
models/step/MP-226-D44_pickup-pedestal-round-kit-d44.step
43.0 x 42.9 x 21.8 mm
