nanda-1243/tngexp/models/step/BUY-34_die-spring-iso-10243-d12-5-x-44-red-heavy-shown-installed-36.step

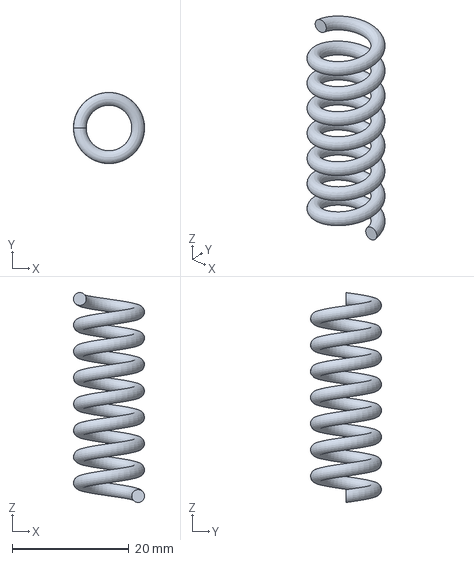
[picture p212: CAD file, 2026-10-27]
models/step/BUY-34_die-spring-iso-10243-d12-5-x-44-red-heavy-shown-installed-36.step
12.2 x 12.2 x 36.0 mm
