nanda-1243/tngexp/models/step/MP-118_return-rod.step

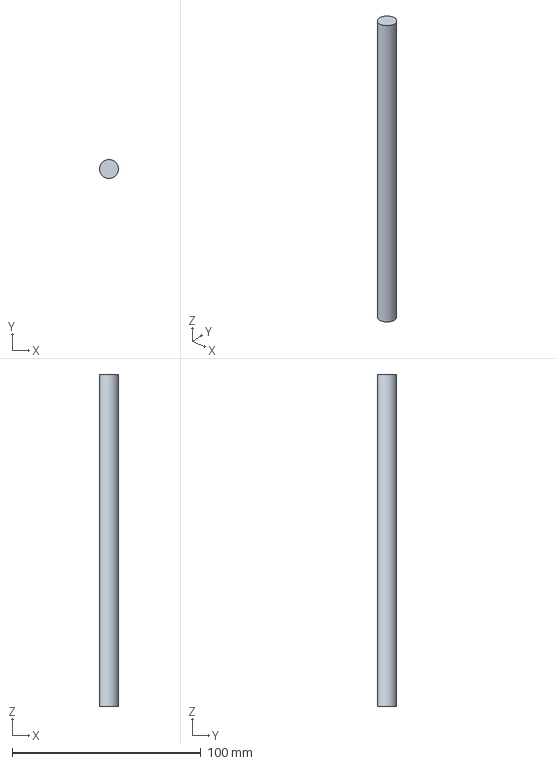
[picture p213: CAD file, 2026-10-27]
models/step/MP-118_return-rod.step
9.99 x 10.00 x 176.0 mm
