nanda-1243/tngexp/models/step/BUY-49_spring-guide-sleeve-pom-d24-x-d10-5-x-60-return-rod.step

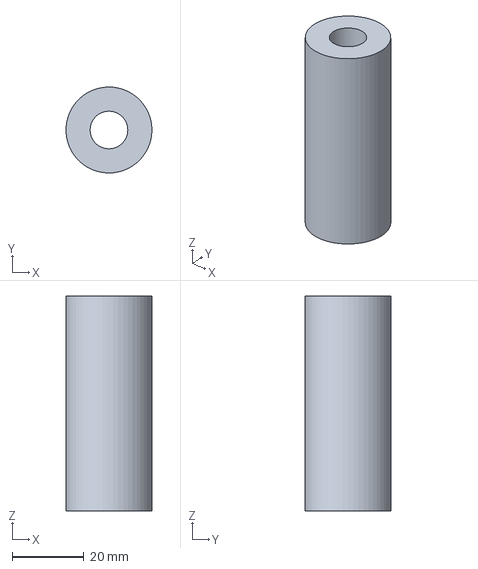
[picture p214: CAD file, 2026-10-27]
models/step/BUY-49_spring-guide-sleeve-pom-d24-x-d10-5-x-60-return-rod.step
24.0 x 24.0 x 60.0 mm
