nanda-1243/tngexp/models/step/BUY-26_dowel-pin-d6-x-16-cheeks.step

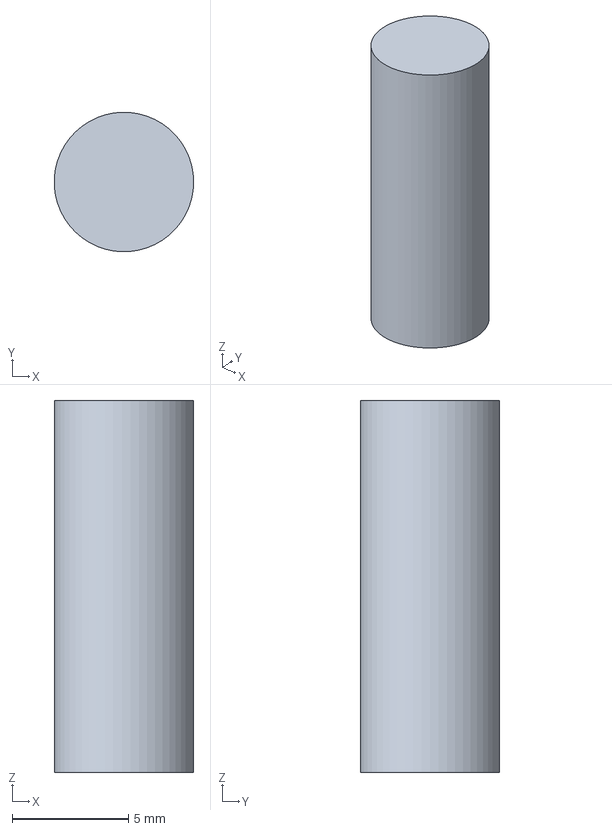
[picture p215: CAD file, 2026-10-27]
models/step/BUY-26_dowel-pin-d6-x-16-cheeks.step
5.99 x 6.00 x 16.0 mm
