nanda-1243/tngexp/models/step/BUY-46_dowel-pin-d5-x-14-plug.step

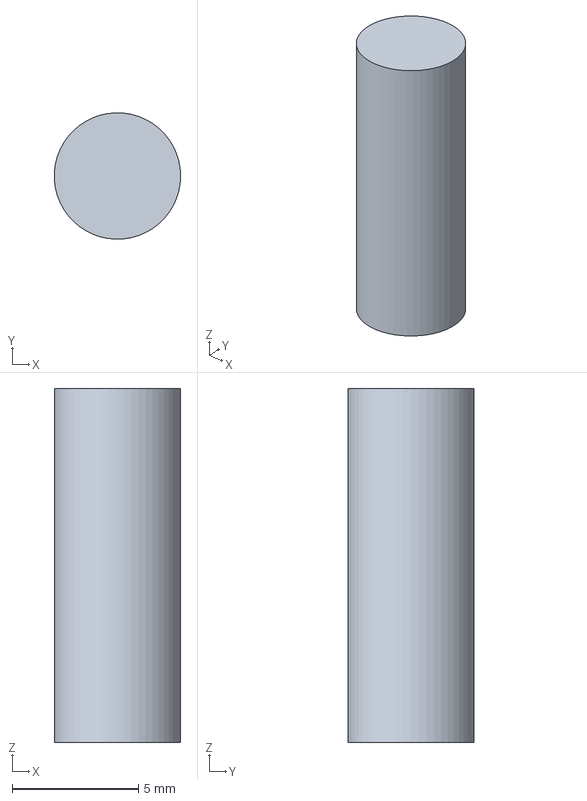
[picture p216: CAD file, 2026-10-27]
models/step/BUY-46_dowel-pin-d5-x-14-plug.step
5.00 x 5.00 x 14.0 mm
