nanda-1243/tngexp/models/step/MP-108_crown.step

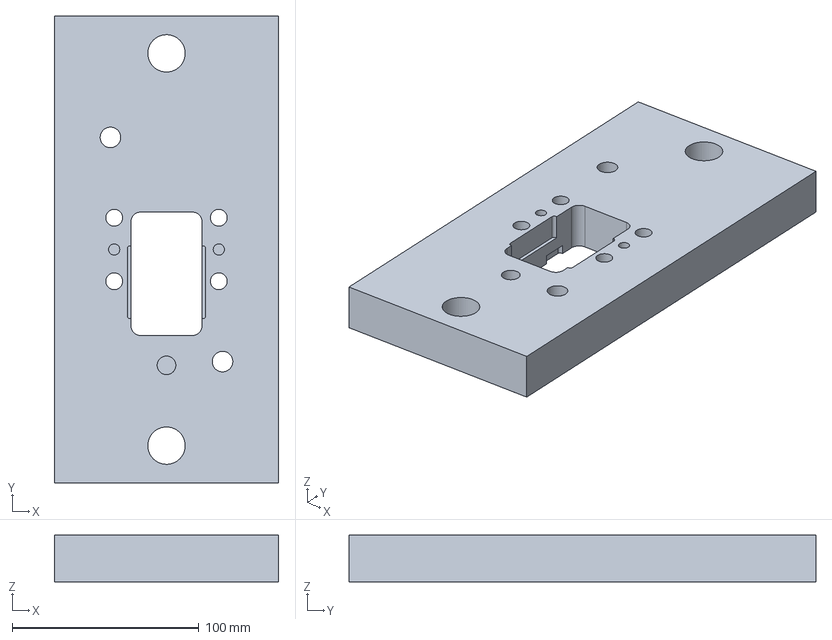
[picture p217: CAD file, 2026-10-27]
models/step/MP-108_crown.step
120.0 x 250.0 x 25.0 mm
