nanda-1243/tngexp/models/step/MP-102-B_guide-rail-back.step

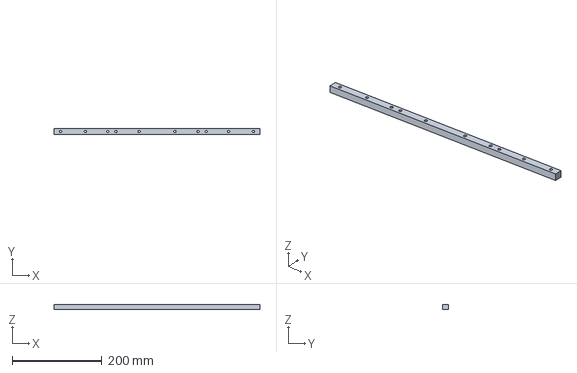
[picture p218: CAD file, 2026-10-27]
models/step/MP-102-B_guide-rail-back.step
460.0 x 14.0 x 12.1 mm
