nanda-1243/tngexp/models/step/MP-111_die-holder.step

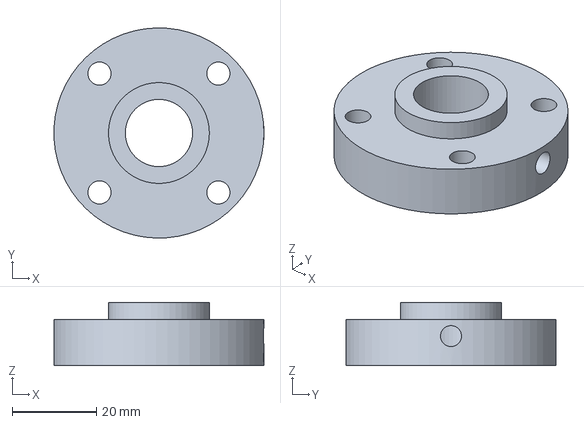
[picture p219: CAD file, 2026-10-27]
models/step/MP-111_die-holder.step
50.0 x 50.0 x 15.0 mm
