nanda-1243/tngexp/models/step/BUY-39_quick-release-detent-pin-d6-usable-length-64-ring-handle.step

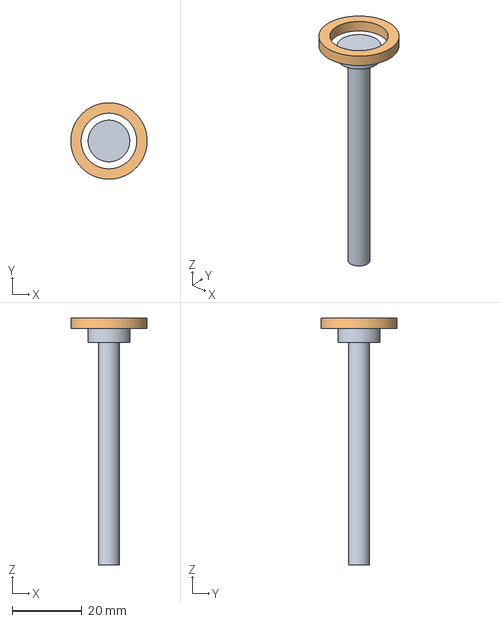
[picture p220: CAD file, 2026-10-27]
models/step/BUY-39_quick-release-detent-pin-d6-usable-length-64-ring-handle.step
22.0 x 22.0 x 71.0 mm
