nanda-1243/tngexp/models/step/MP-223-D56_plug-round-kit-d56.step

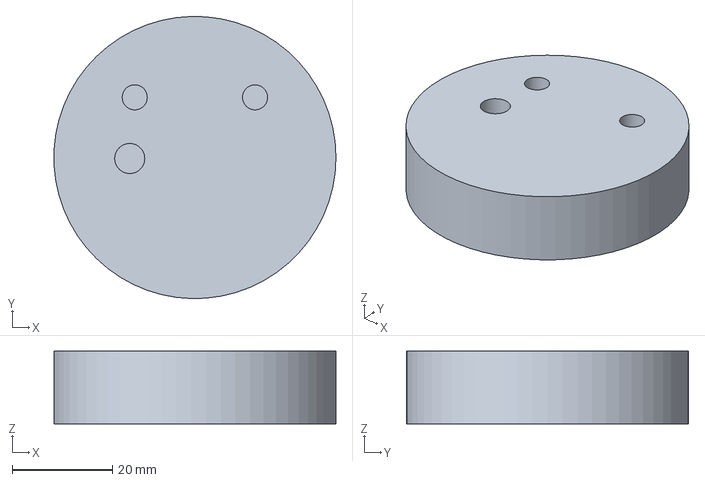
[picture p221: CAD file, 2026-10-27]
models/step/MP-223-D56_plug-round-kit-d56.step
56.3 x 56.3 x 14.5 mm
