nanda-1243/tngexp/models/step/MP-203-6590_plug-kit-65-x-90.step

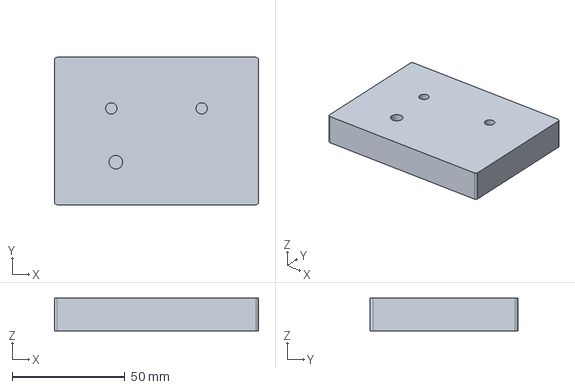
[picture p222: CAD file, 2026-10-27]
models/step/MP-203-6590_plug-kit-65-x-90.step
90.3 x 65.3 x 14.5 mm
