nanda-1243/tngexp/models/step/MP-205_station-base-universal.step

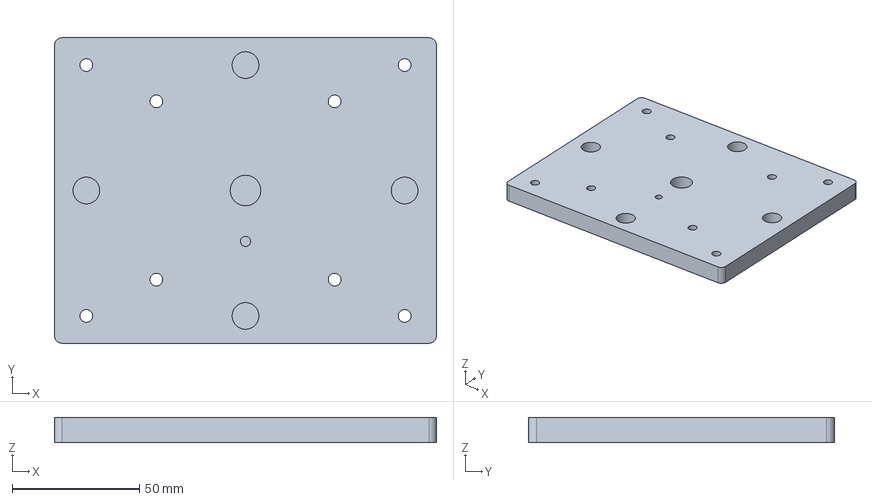
[picture p224: CAD file, 2026-10-27]
models/step/MP-205_station-base-universal.step
150.0 x 120.0 x 10.0 mm
