nanda-1243/tngexp/models/step/MP-107_column.step

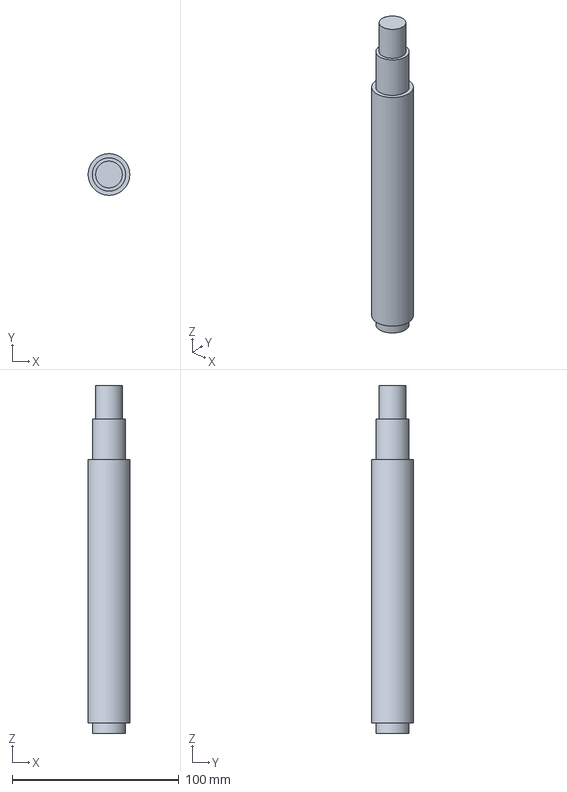
[picture p225: CAD file, 2026-10-27]
models/step/MP-107_column.step
25.0 x 25.0 x 208.7 mm
