nanda-1243/tngexp/models/step/BUY-15_ptfe-composite-bushing-16-x-18-x-20-lever-o.step

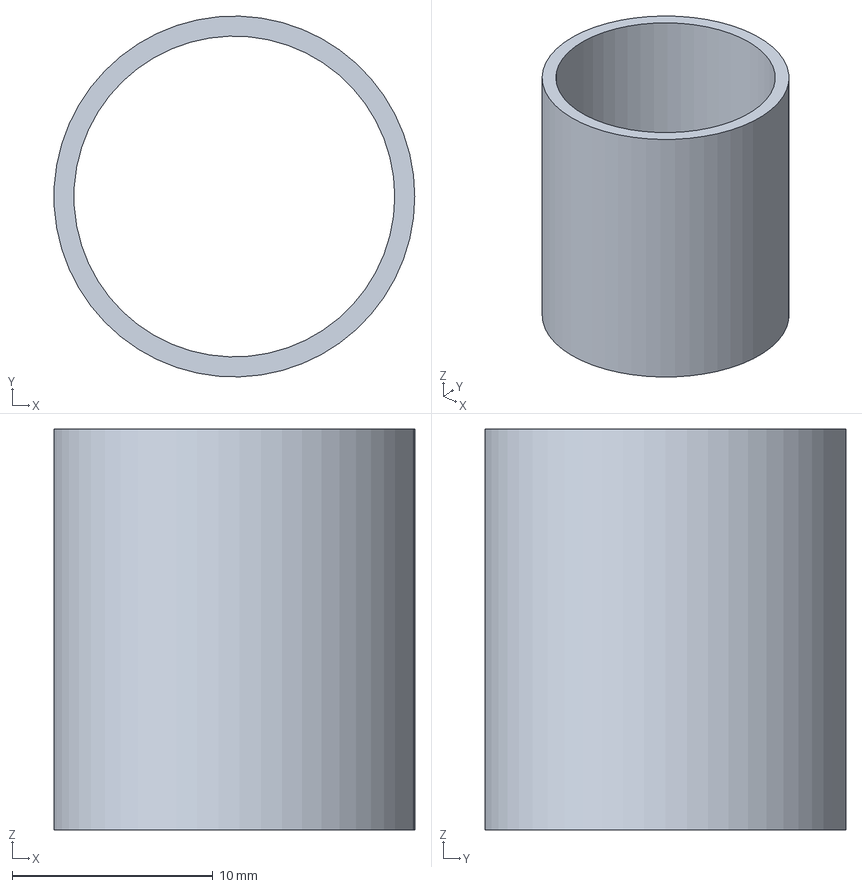
[picture p226: CAD file, 2026-10-27]
models/step/BUY-15_ptfe-composite-bushing-16-x-18-x-20-lever-o.step
18.0 x 18.0 x 20.0 mm
