nanda-1243/tngexp/models/step/MP-203-5050_plug-kit-50-x-50.step

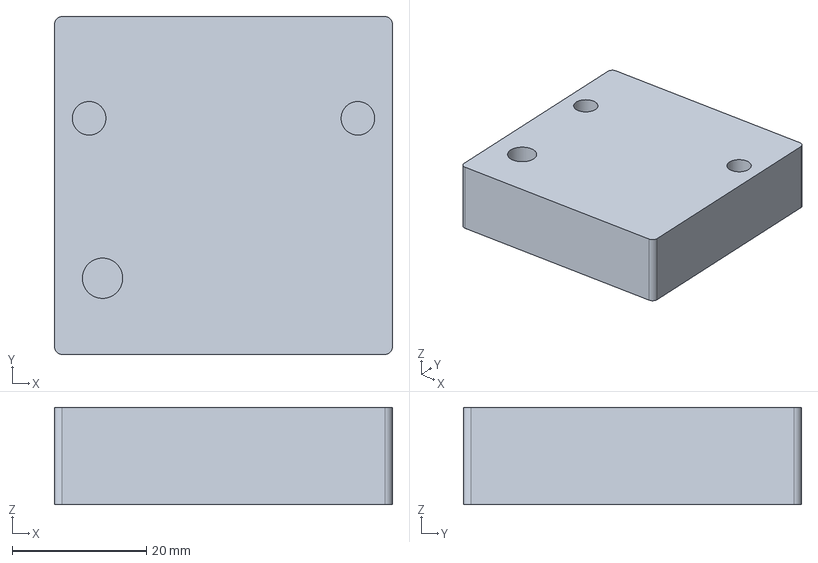
[picture p227: CAD file, 2026-10-27]
models/step/MP-203-5050_plug-kit-50-x-50.step
50.3 x 50.3 x 14.5 mm
