nanda-1243/tngexp/models/step/MP-224-D44_upper-ring-round-kit-d44.step

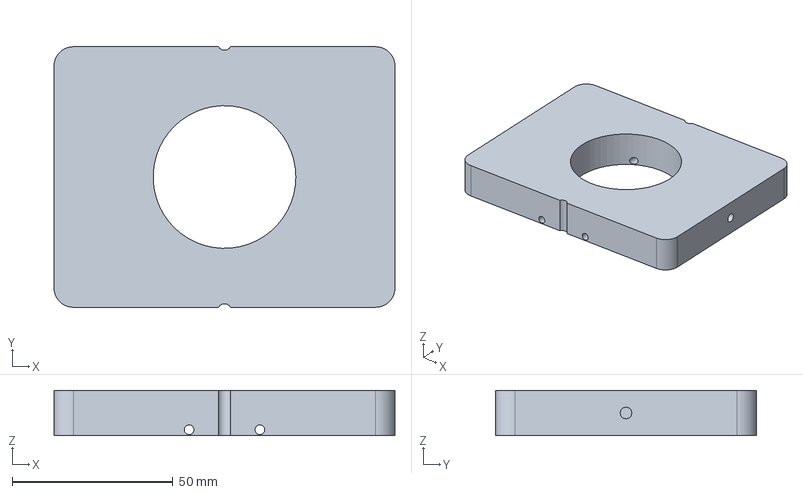
[picture p228: CAD file, 2026-10-27]
models/step/MP-224-D44_upper-ring-round-kit-d44.step
106.0 x 81.0 x 14.0 mm
