nanda-1243/tngexp/models/step/MP-106_die-table-stop-pin.step

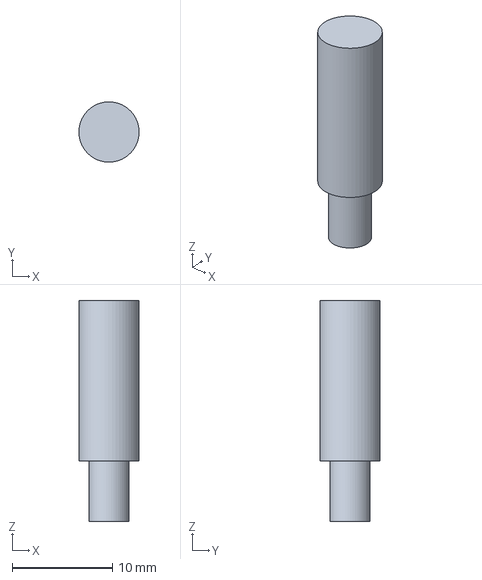
[picture p229: CAD file, 2026-10-27]
models/step/MP-106_die-table-stop-pin.step
5.99 x 6.00 x 22.0 mm
