nanda-1243/tngexp/models/step/BUY-13_flanged-bronze-bushing-25-x-32-x-33-ram.step

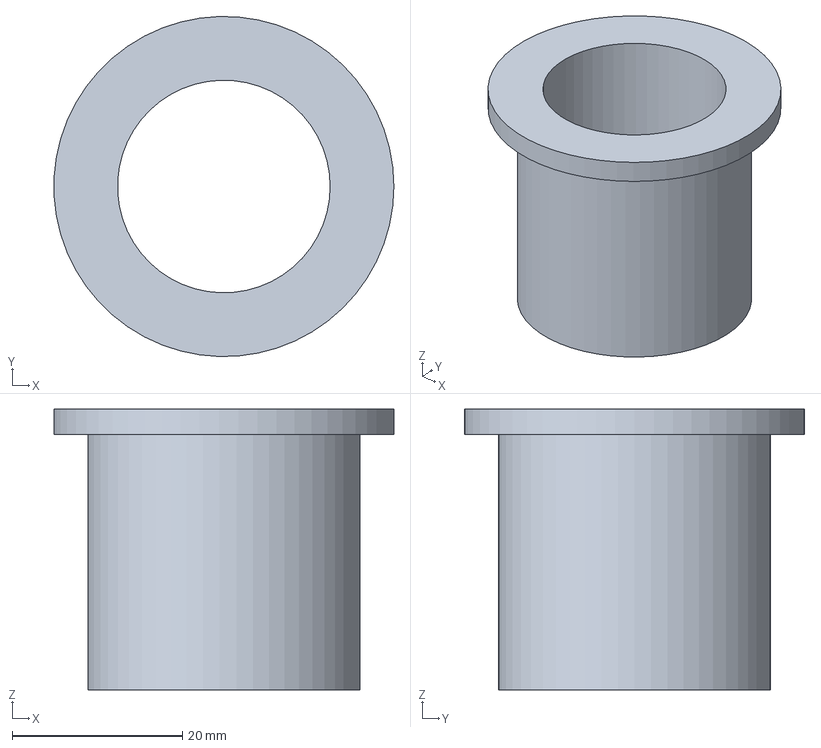
[picture p230: CAD file, 2026-10-27]
models/step/BUY-13_flanged-bronze-bushing-25-x-32-x-33-ram.step
40.0 x 40.0 x 33.0 mm
