nanda-1243/tngexp/models/step/MP-103-B_keeper-strip-back.step

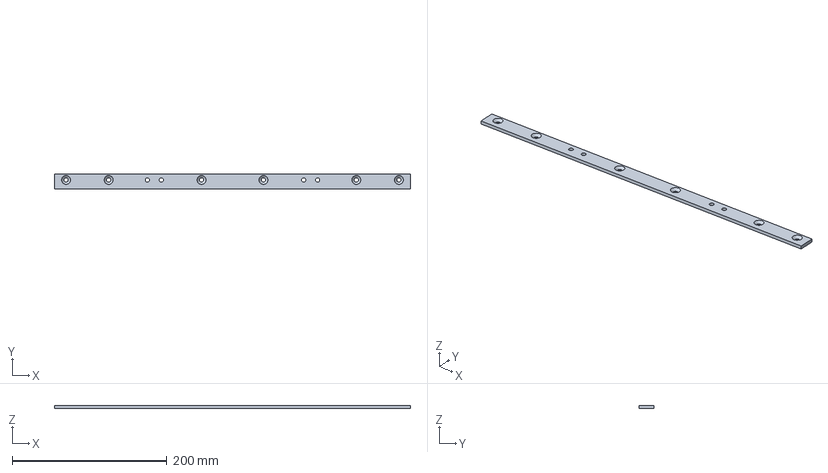
[picture p231: CAD file, 2026-10-27]
models/step/MP-103-B_keeper-strip-back.step
460.0 x 20.0 x 4.00 mm
