nanda-1243/tngexp/models/step/MP-117_pin-o-handle-pivot.step

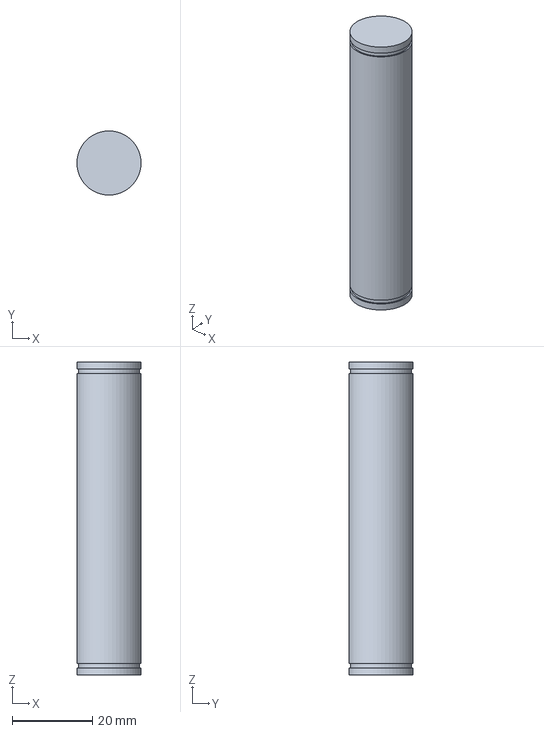
[picture p232: CAD file, 2026-10-27]
models/step/MP-117_pin-o-handle-pivot.step
16.0 x 16.0 x 78.0 mm
