nanda-1243/tngexp/models/step/MP-204-6363_upper-ring-kit-63-5-x-63-5.step

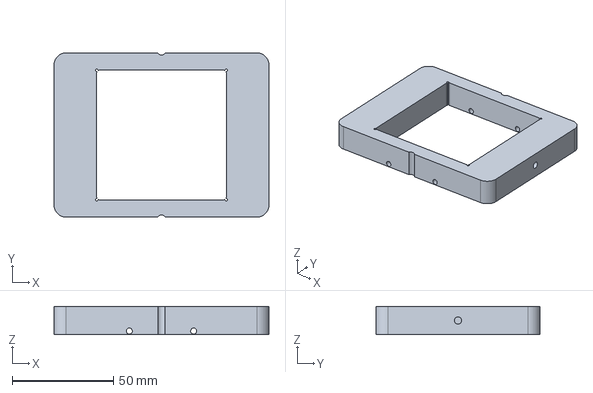
[picture p233: CAD file, 2026-10-27]
models/step/MP-204-6363_upper-ring-kit-63-5-x-63-5.step
106.0 x 81.0 x 14.0 mm
