nanda-1243/tngexp/models/step/BUY-17_ptfe-composite-bushing-12-x-14-x-6-links.step

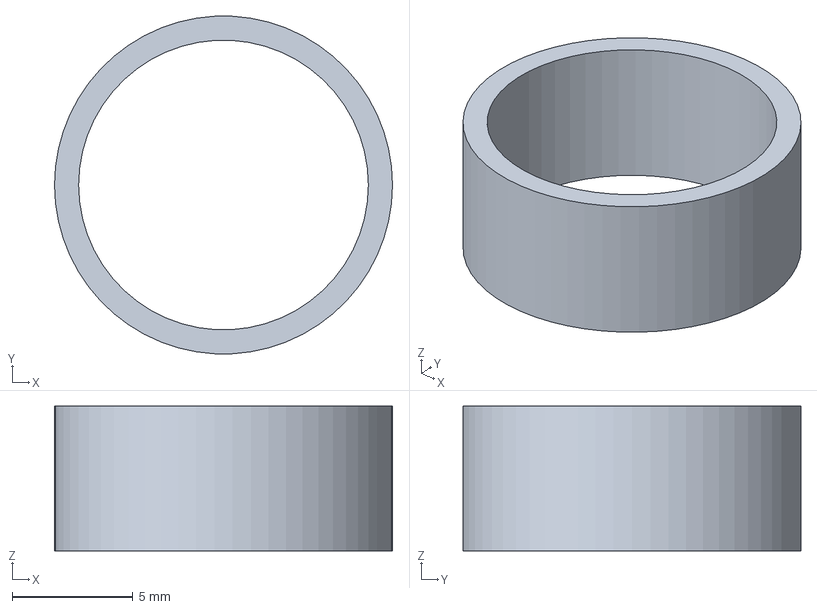
[picture p234: CAD file, 2026-10-27]
models/step/BUY-17_ptfe-composite-bushing-12-x-14-x-6-links.step
14.0 x 14.0 x 6.00 mm
