nanda-1243/tngexp/models/step/BUY-41_dowel-pin-d6-x-12-station-bases.step

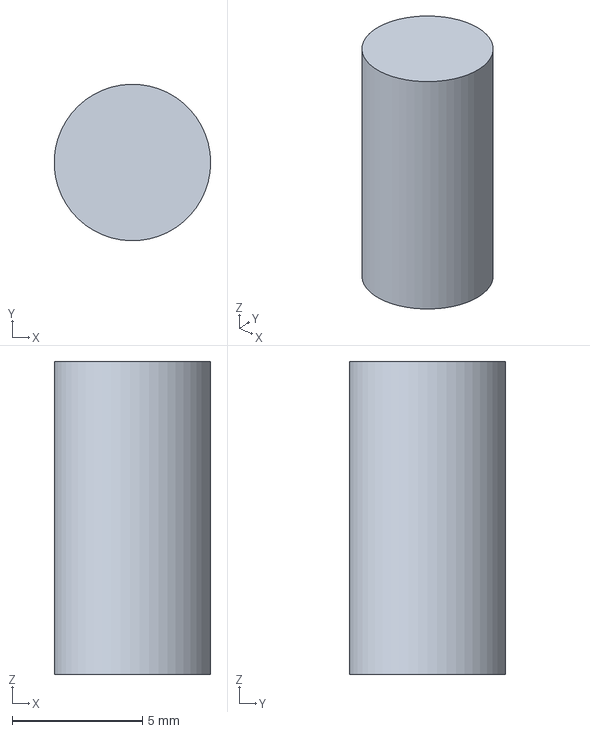
[picture p235: CAD file, 2026-10-27]
models/step/BUY-41_dowel-pin-d6-x-12-station-bases.step
5.99 x 6.00 x 12.0 mm
