nanda-1243/tngexp/models/step/BUY-45_ball-plunger-m3-upper-ring.step

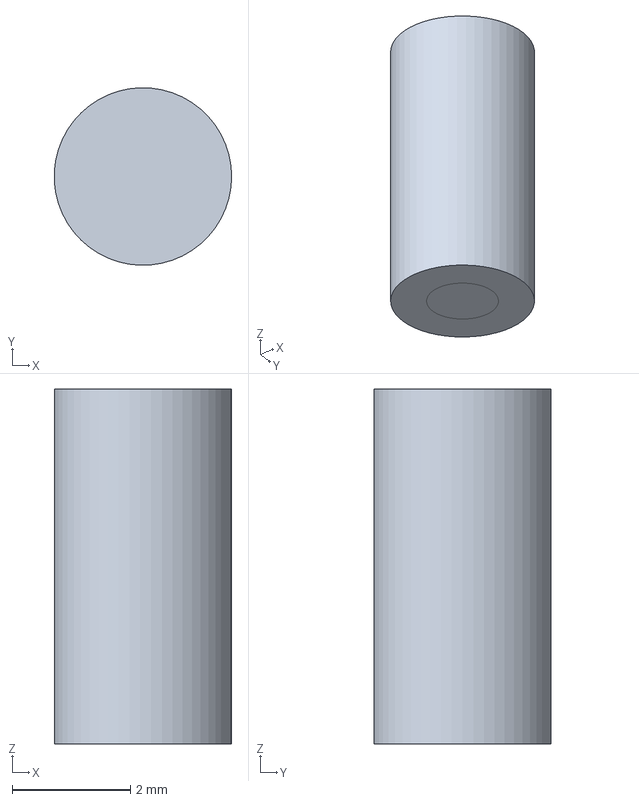
[picture p236: CAD file, 2026-10-27]
models/step/BUY-45_ball-plunger-m3-upper-ring.step
3.00 x 3.00 x 6.00 mm
