nanda-1243/tngexp/models/step/BUY-32_push-knob-phenolic-d14-x-18-m5.step

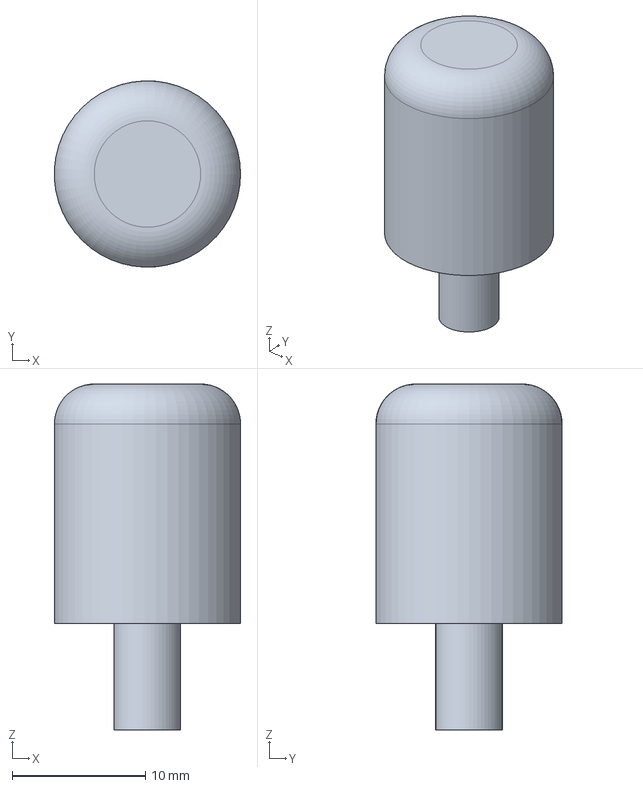
[picture p237: CAD file, 2026-10-27]
models/step/BUY-32_push-knob-phenolic-d14-x-18-m5.step
14.0 x 14.0 x 26.0 mm
