nanda-1243/tngexp/models/step/MP-202_upper-die-shank-universal.step

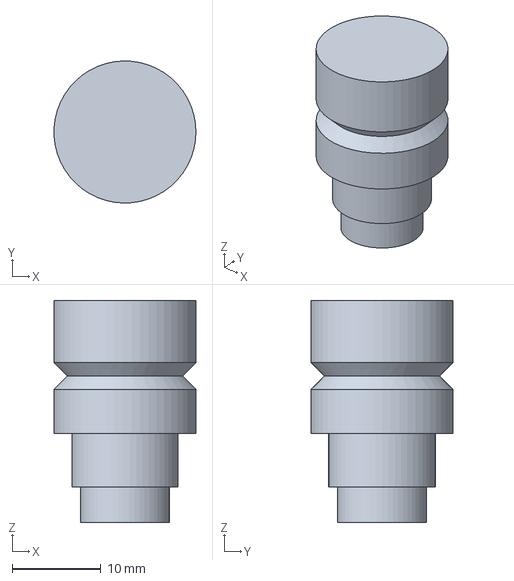
[picture p238: CAD file, 2026-10-27]
models/step/MP-202_upper-die-shank-universal.step
16.0 x 16.0 x 25.0 mm
