nanda-1243/tngexp/models/step/MP-101_base-plate.step

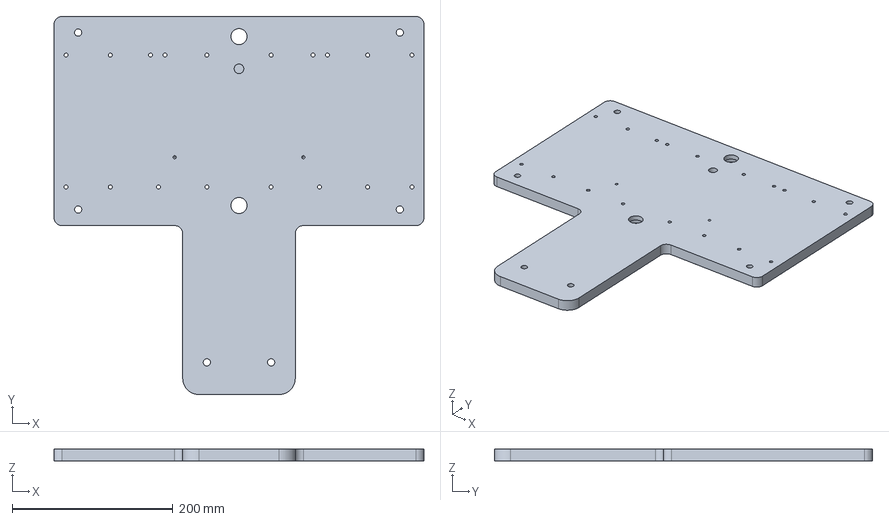
[picture p239: CAD file, 2026-10-27]
models/step/MP-101_base-plate.step
460.0 x 470.0 x 15.0 mm
