nanda-1243/tngexp/models/step/MP-112_pivot-cheek.step

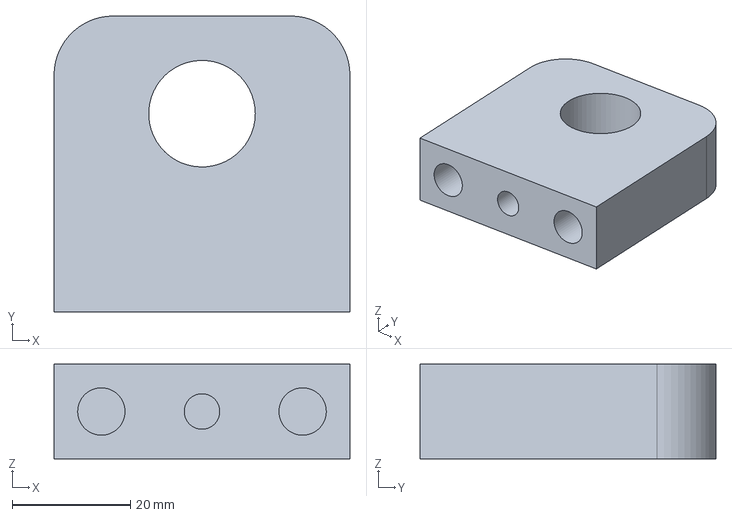
[picture p240: CAD file, 2026-10-27]
models/step/MP-112_pivot-cheek.step
50.0 x 50.0 x 16.0 mm
