nanda-1243/tngexp/models/step/MP-226-D56_pickup-pedestal-round-kit-d56.step

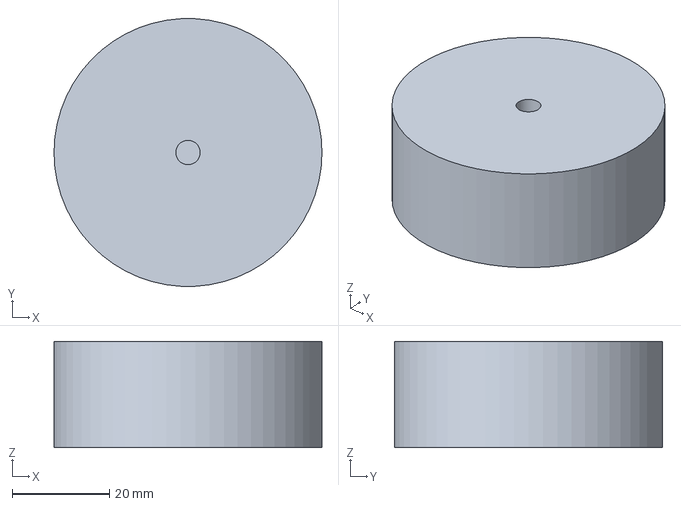
[picture p241: CAD file, 2026-10-27]
models/step/MP-226-D56_pickup-pedestal-round-kit-d56.step
55.0 x 54.9 x 21.8 mm
