nanda-1243/tngexp/models/step/BUY-01_rubber-pad-d24-x-3.step

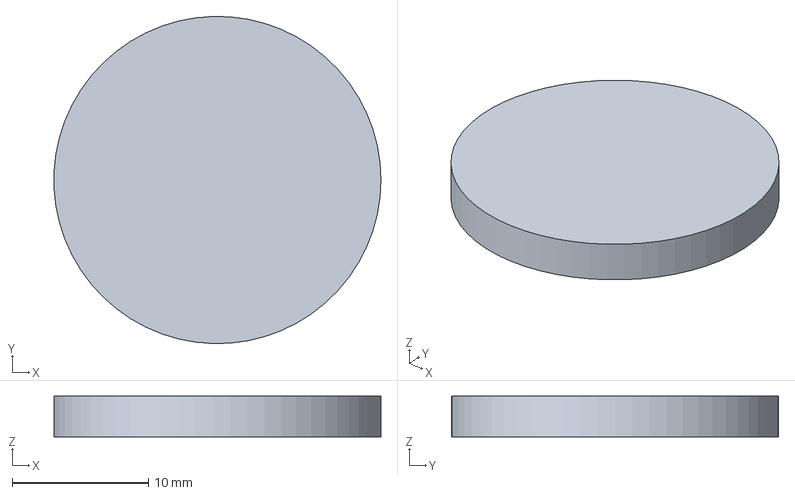
[picture p242: CAD file, 2026-10-27]
models/step/BUY-01_rubber-pad-d24-x-3.step
24.0 x 24.0 x 3.00 mm
