nanda-1243/tngexp/models/step/MP-114_toggle-link.step

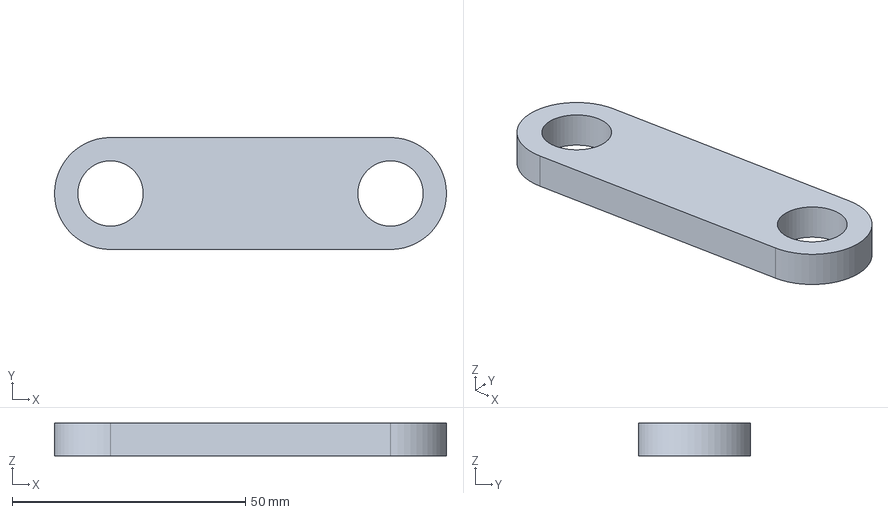
[picture p243: CAD file, 2026-10-27]
models/step/MP-114_toggle-link.step
84.0 x 24.0 x 7.00 mm
