nanda-1243/tngexp/models/step/MP-119_pivot-spacer.step

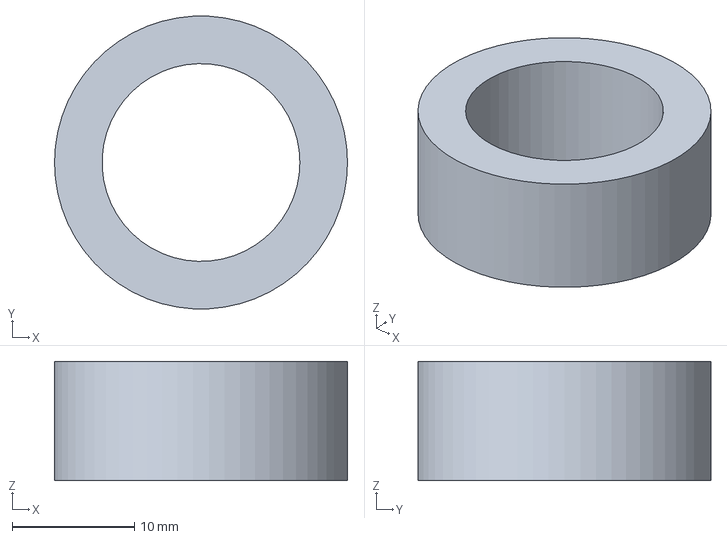
[picture p244: CAD file, 2026-10-27]
models/step/MP-119_pivot-spacer.step
24.0 x 24.0 x 9.75 mm
