nanda-1243/tngexp/models/step/MP-116_pin-a-pin-b-toggle.step

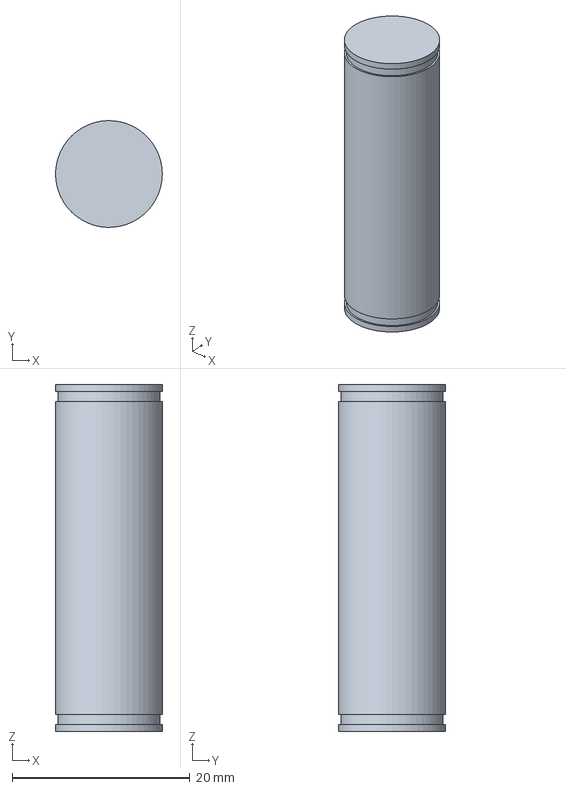
[picture p245: CAD file, 2026-10-27]
models/step/MP-116_pin-a-pin-b-toggle.step
12.0 x 12.0 x 39.0 mm
