nanda-1243/tngexp/models/step/BUY-12_handle-stop-cap-urethane-d16-x-4.step

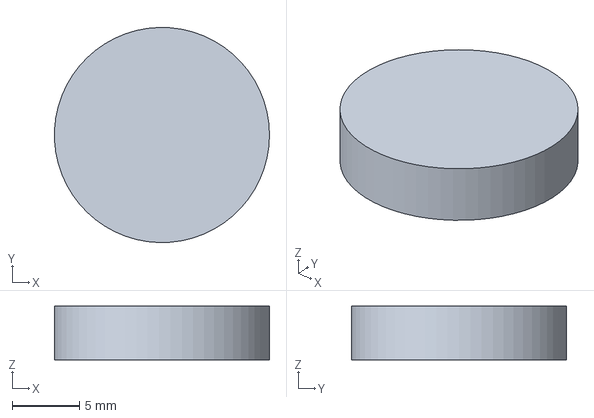
[picture p246: CAD file, 2026-10-27]
models/step/BUY-12_handle-stop-cap-urethane-d16-x-4.step
16.0 x 16.0 x 4.00 mm
