nanda-1243/tngexp/models/step/MP-212_plug-stud-size-kit-same-for-every-size.step

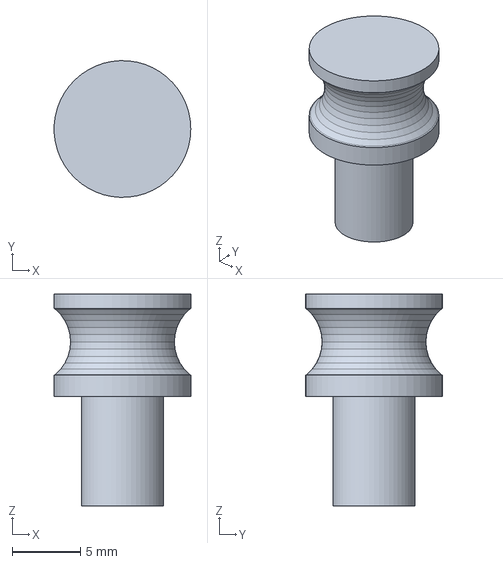
[picture p247: CAD file, 2026-10-27]
models/step/MP-212_plug-stud-size-kit-same-for-every-size.step
9.99 x 10.00 x 15.5 mm
