nanda-1243/tngexp/models/step/BUY-44_puller-m5-t-handle-loose-tool.step

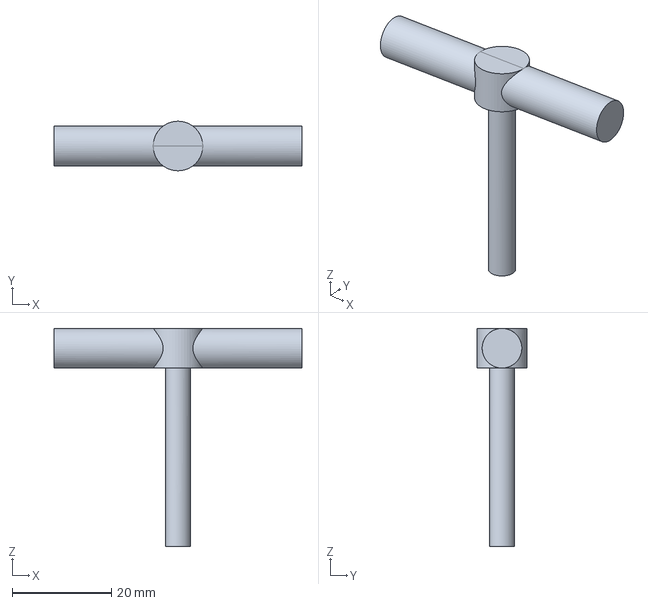
[picture p248: CAD file, 2026-10-27]
models/step/BUY-44_puller-m5-t-handle-loose-tool.step
50.0 x 10.0 x 44.0 mm
