nanda-1243/tngexp/models/step/BUY-30_grip-red-tpr-d32-x-120.step

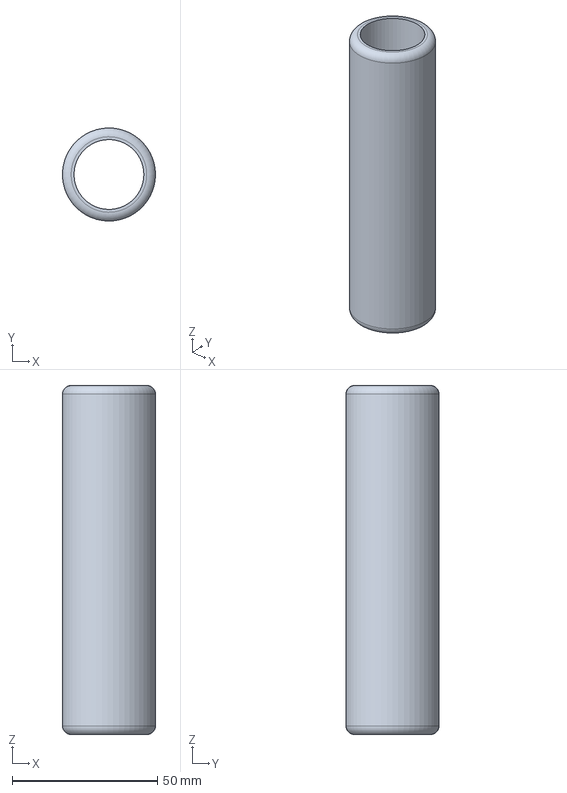
[picture p249: CAD file, 2026-10-27]
models/step/BUY-30_grip-red-tpr-d32-x-120.step
32.0 x 32.0 x 120.0 mm
