nanda-1243/tngexp/models/step/MP-110_clevis.step

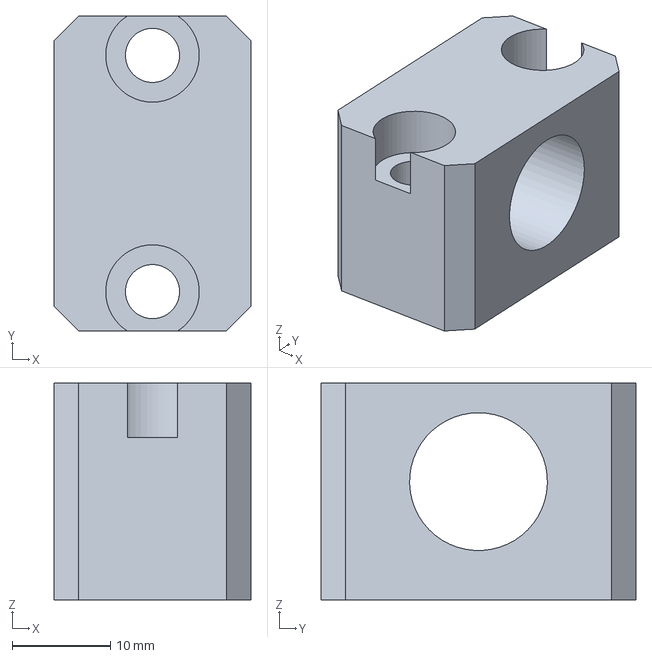
[picture p250: CAD file, 2026-10-27]
models/step/MP-110_clevis.step
20.0 x 32.0 x 22.0 mm
