nanda-1243/tngexp/models/step/MP-223-D50_plug-round-kit-d50.step

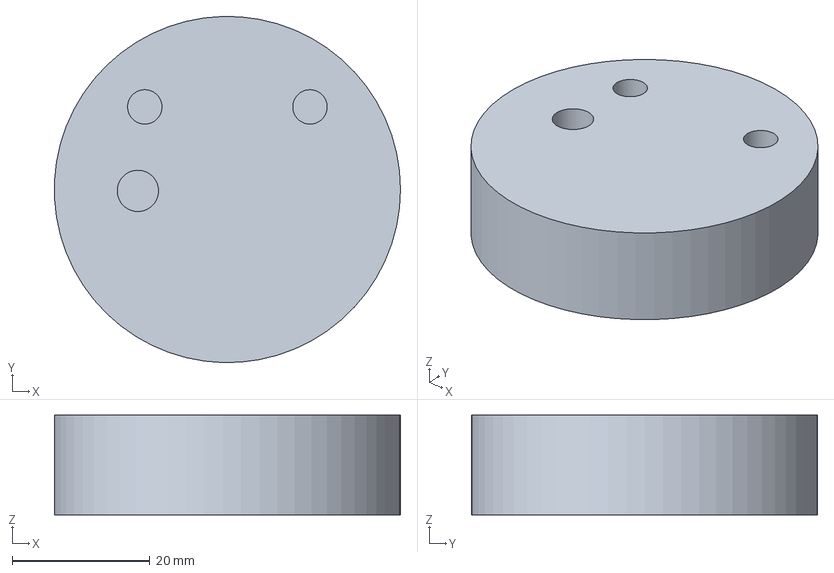
[picture p251: CAD file, 2026-10-27]
models/step/MP-223-D50_plug-round-kit-d50.step
50.3 x 50.3 x 14.5 mm
