nanda-1243/tngexp/models/step/MP-226-D50_pickup-pedestal-round-kit-d50.step

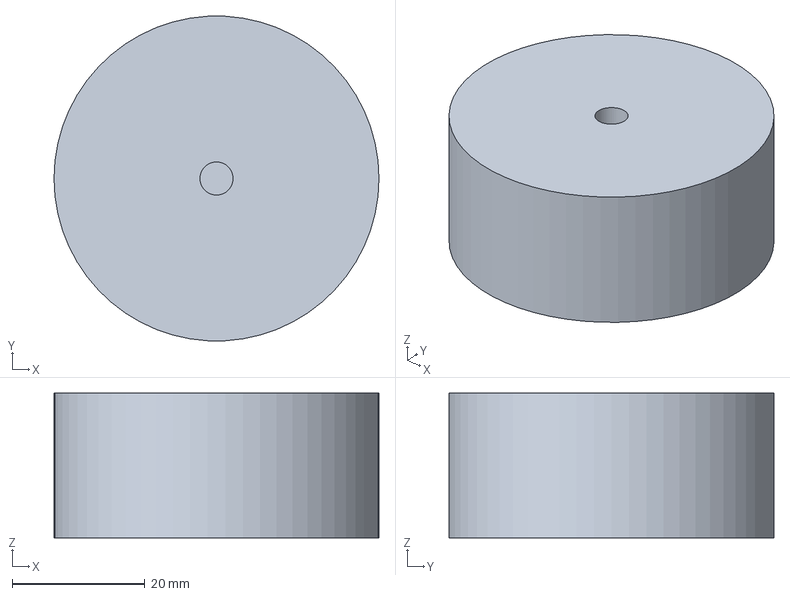
[picture p252: CAD file, 2026-10-27]
models/step/MP-226-D50_pickup-pedestal-round-kit-d50.step
49.0 x 48.9 x 21.8 mm
