nanda-1243/tngexp/models/step/MP-109_ram.step

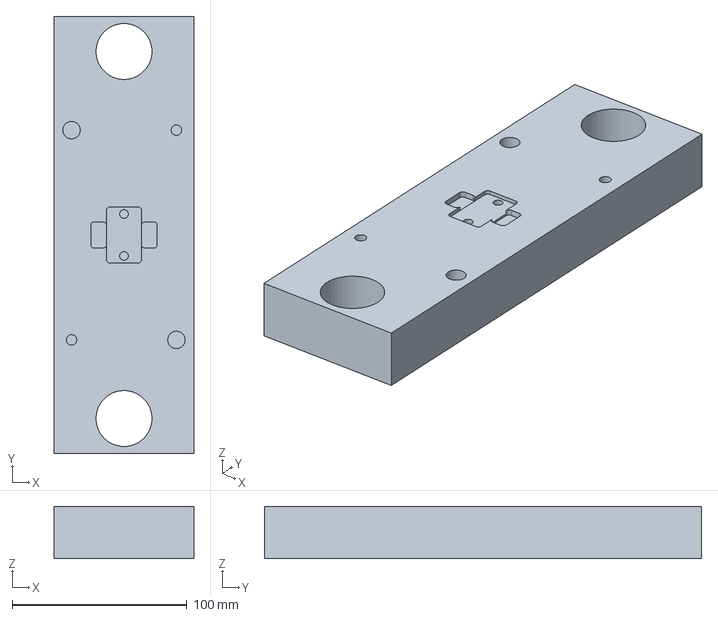
[picture p253: CAD file, 2026-10-27]
models/step/MP-109_ram.step
80.0 x 250.0 x 30.0 mm
