nanda-1243/tngexp/models/step/BUY-14_ptfe-composite-bushing-16-x-18-x-15-cheeks.step

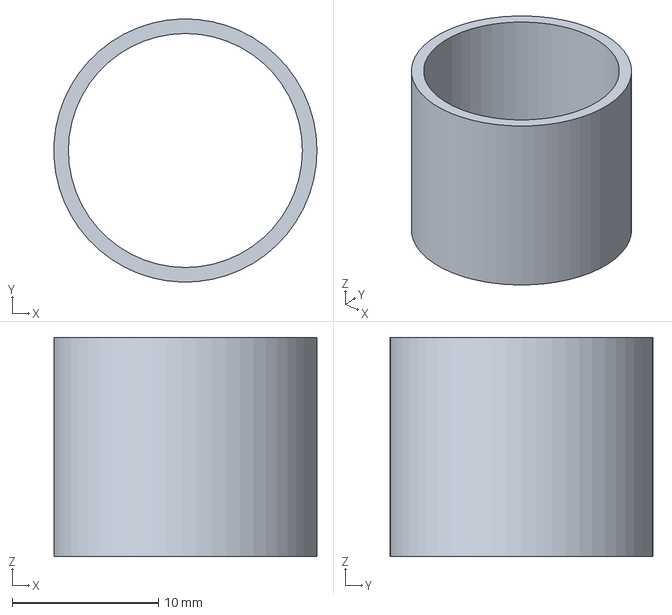
[picture p254: CAD file, 2026-10-27]
models/step/BUY-14_ptfe-composite-bushing-16-x-18-x-15-cheeks.step
18.0 x 18.0 x 15.0 mm
