nanda-1243/tngexp/models/step/BUY-23_urethane-bumper-d16-x-12-m6-stud.step

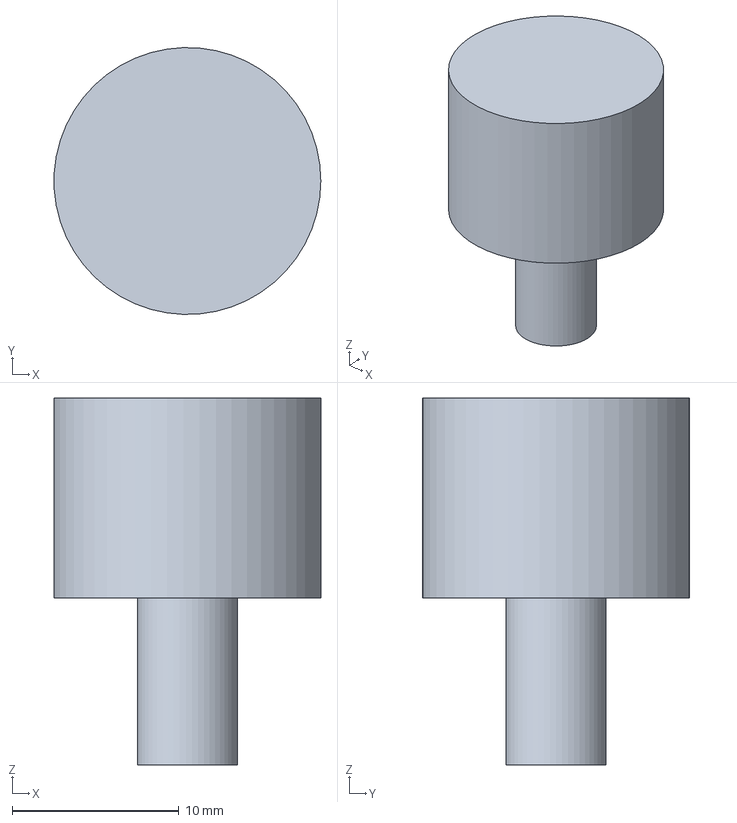
[picture p255: CAD file, 2026-10-27]
models/step/BUY-23_urethane-bumper-d16-x-12-m6-stud.step
16.0 x 16.0 x 22.0 mm
