nanda-1243/tngexp/models/step/MP-210_upper-carrier-universal.step

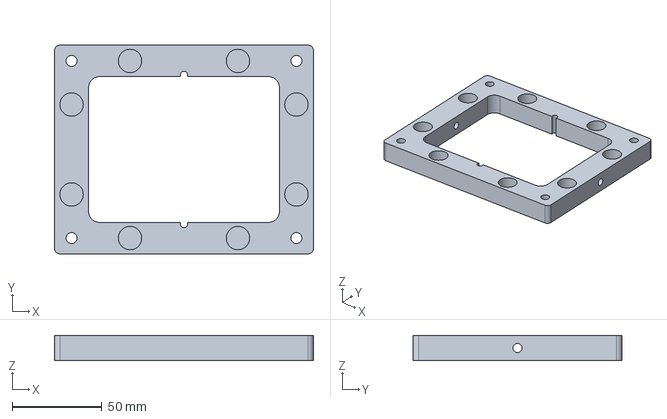
[picture p256: CAD file, 2026-10-27]
models/step/MP-210_upper-carrier-universal.step
144.0 x 116.0 x 14.0 mm
