nanda-1243/tngexp/models/step/BUY-20_return-spring-d3-5-wire-od-31-5-shown-installed-109-5.step

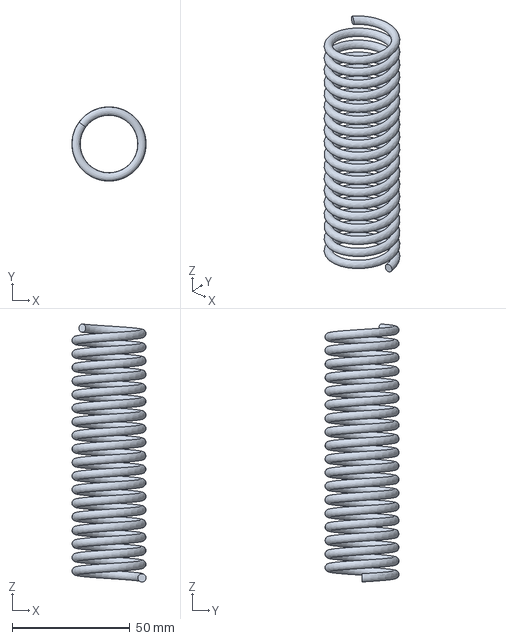
[picture p257: CAD file, 2026-10-27]
models/step/BUY-20_return-spring-d3-5-wire-od-31-5-shown-installed-109-5.step
31.5 x 31.5 x 109.5 mm
