nanda-1243/tngexp/models/step/MP-203-6363_plug-kit-63-5-x-63-5.step

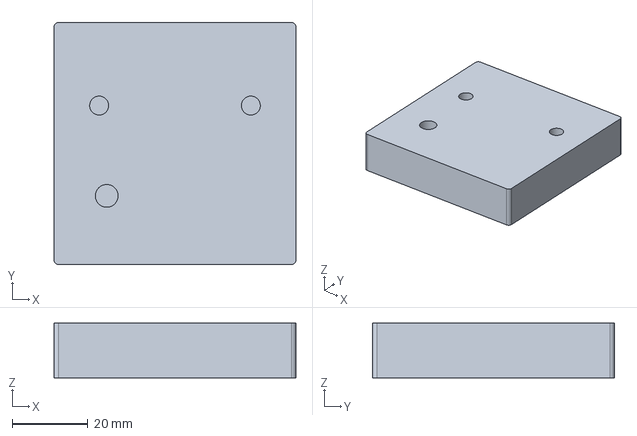
[picture p258: CAD file, 2026-10-27]
models/step/MP-203-6363_plug-kit-63-5-x-63-5.step
63.8 x 63.8 x 14.5 mm
