nanda-1243/tngexp/models/step/MP-203-5380_plug-kit-53-x-80.step

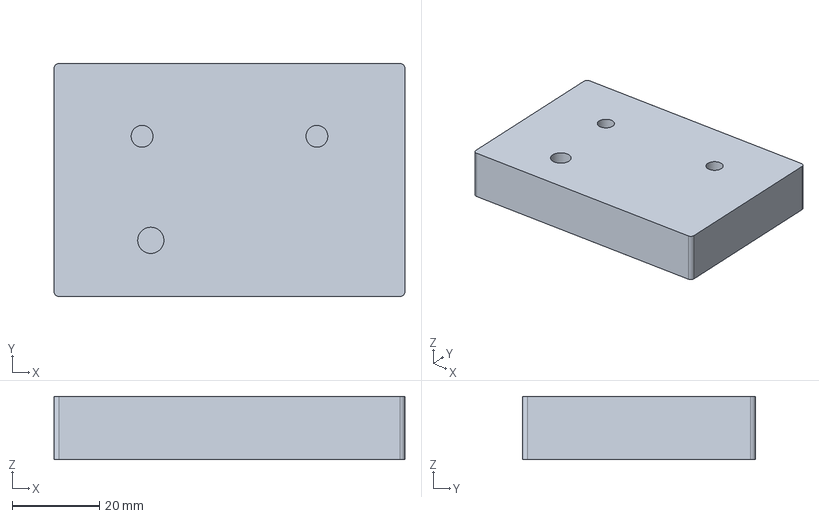
[picture p259: CAD file, 2026-10-27]
models/step/MP-203-5380_plug-kit-53-x-80.step
80.3 x 53.3 x 14.5 mm
