nanda-1243/tngexp/models/step/BUY-34_die-spring-iso-10243-d10-x-32-blue-medium-shown-installed-26.step

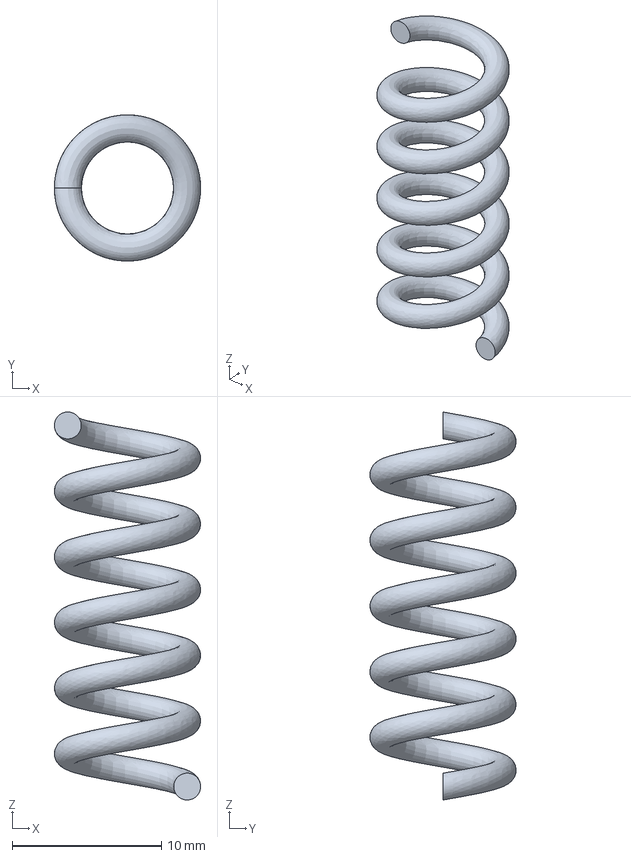
[picture p260: CAD file, 2026-10-27]
models/step/BUY-34_die-spring-iso-10243-d10-x-32-blue-medium-shown-installed-26.step
9.80 x 9.80 x 26.0 mm
