nanda-1243/tngexp/models/step/BUY-45_spring-plunger-m4-nylon-tip-upper-ring.step

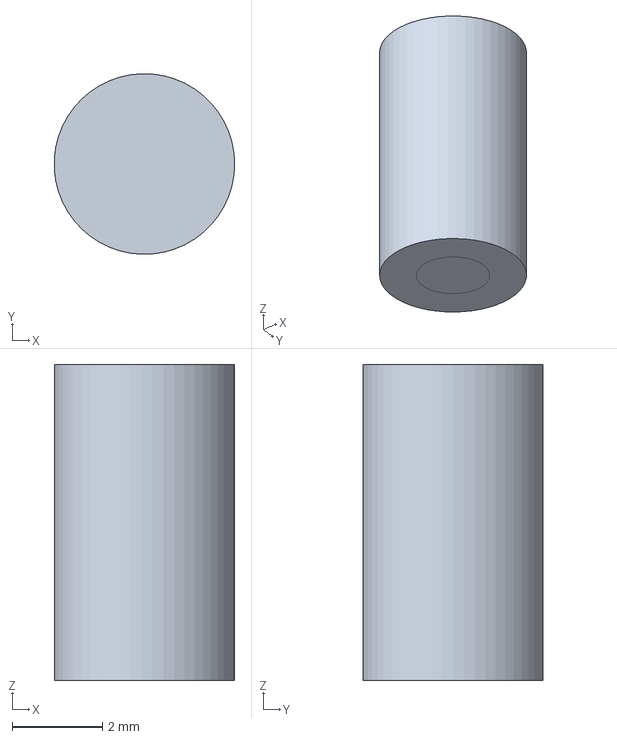
[picture p261: CAD file, 2026-10-27]
models/step/BUY-45_spring-plunger-m4-nylon-tip-upper-ring.step
4.00 x 4.00 x 7.00 mm
