nanda-1243/tngexp/models/step/BUY-39_ball-lock-pin-d6-push-button-grip-55.step

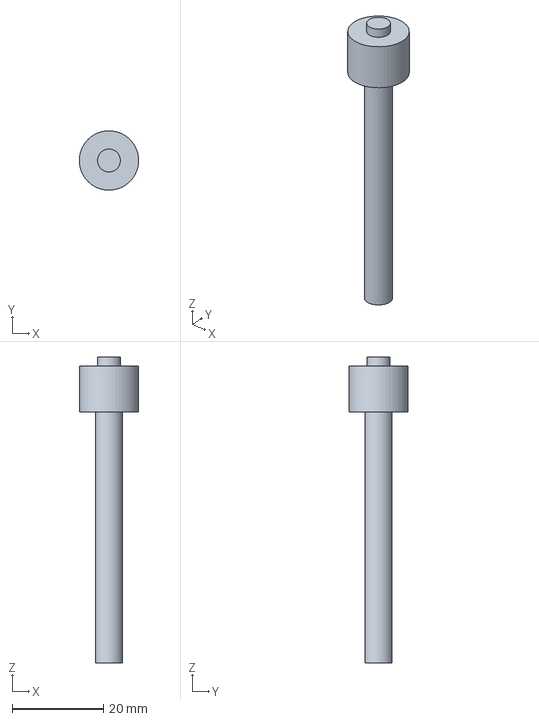
[picture p262: CAD file, 2026-10-27]
models/step/BUY-39_ball-lock-pin-d6-push-button-grip-55.step
13.0 x 13.0 x 67.0 mm
