nanda-1243/tngexp/models/step/BUY-32_push-knob-phenolic-d24-m6.step

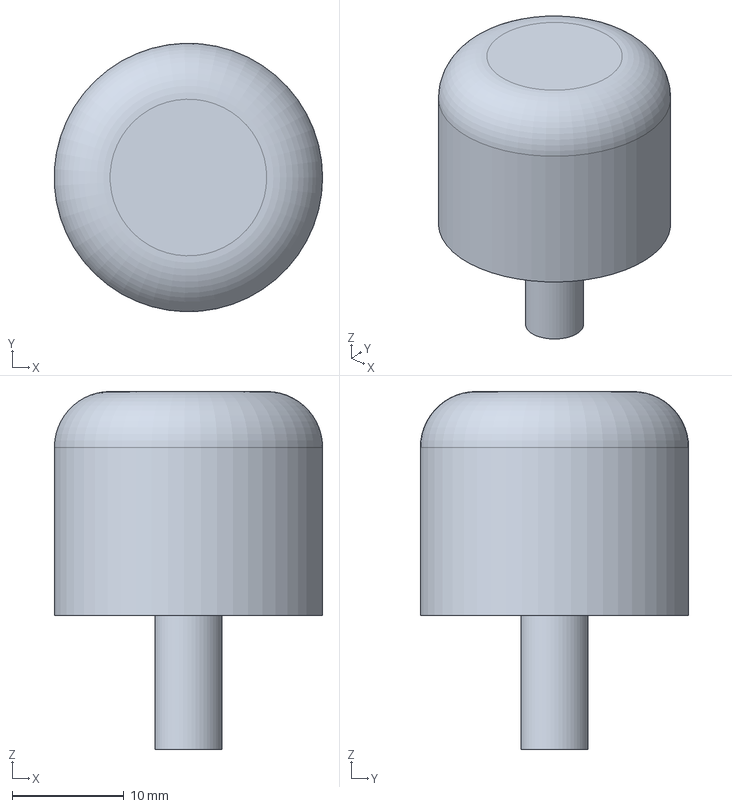
[picture p263: CAD file, 2026-10-27]
models/step/BUY-32_push-knob-phenolic-d24-m6.step
24.0 x 24.0 x 32.0 mm
