nanda-1243/tngexp/(list of files, cad)

Other CAD files:
models/step/MP-207-6363_pickup-ring-a-kit-63-5-x-63-5.step
models/step/MP-227-D56_pickup-ring-a-round-kit-d56.step
models/step/MP-227-D58_pickup-ring-a-round-kit-d58.step
models/step/MP-229-D56_crimp-ring-b-round-kit-d56.step
models/step/BUY-48_pin-d4-x-10-pedestal-and-anvil-anti-rotation.step
models/step/MP-209-5050_crimp-ring-b-kit-50-x-50.step
models/step/MP-229-D58_crimp-ring-b-round-kit-d58.step
models/step/MP-229-D50_crimp-ring-b-round-kit-d50.step
models/step/MP-209-6590_crimp-ring-b-kit-65-x-90.step
models/step/MP-209-6363_crimp-ring-b-kit-63-5-x-63-5.step
models/step/MP-224-D50_upper-ring-round-kit-d50.step
models/step/MP-102-F_guide-rail-front.step
models/step/MP-209-5380_crimp-ring-b-kit-53-x-80.step
models/step/MP-204-5380_upper-ring-kit-53-x-80.step
models/step/MP-224-D56_upper-ring-round-kit-d56.step
models/step/MP-103-F_keeper-strip-front.step
models/step/MP-229-D44_crimp-ring-b-round-kit-d44.step
models/step/MP-211-A_lower-carrier-a-universal-pickup.step
models/assembly/MagPress-M4_assembly.obj
models/step/BUY-02_countersunk-screw-m5-x-20-iso-10642.step
models/step/BUY-02_countersunk-screw-m5-x-30-iso-10642.step
models/step/BUY-03_cap-screw-m5-x-35-iso-4762-stop-blocks.step
models/step/BUY-04_stop-screw-m6-x-0-75-x-40-hex.step
models/step/BUY-05_thin-lock-nut-m6-x-0-75.step
models/step/BUY-06_column-clamp-screw-m10-x-16-din-7984-low-head.step
models/step/BUY-06_column-clamp-screw-m10-x-25-iso-4762.step
models/step/BUY-07_column-clamp-washer-d32-x-2-5-hardened.step
models/step/BUY-07_column-clamp-washer-d32-x-4.step
models/step/BUY-08_nord-lock-washer-m16.step
models/step/BUY-09_column-nut-m16-x-1-5.step
models/step/BUY-10_handle-stop-screw-m10-x-1-x-12-nylon-patch-set-screw.step
models/step/BUY-10_handle-stop-screw-m10-x-1-x-20-set-screw.step
models/step/BUY-11_handle-stop-jam-nut-m10-x-1.step
models/step/BUY-21_washer-d32-x-3-return-rod.step
models/step/BUY-22_nylock-nut-m10.step
models/step/BUY-24_cap-screw-m8-x-30-iso-4762-cheeks.step
models/step/BUY-25_nord-lock-washer-m8.step
models/step/BUY-27_cap-screw-m5-x-25-iso-4762-clevis.step
models/step/BUY-28_low-head-cap-screw-m5-x-16-din-7984-die-holder.step
models/step/BUY-29_lock-screw-m5-x-10-iso-4027-cone-point-die-holder.step
models/step/BUY-35_shoulder-screw-iso-7379-d6-x-10-upper-carrier.step
models/step/BUY-36_shoulder-screw-iso-7379-d6-x-12-lower-carriers.step
models/step/BUY-38_thumb-screw-m5-knurled-cone-point-upper-ring.step
models/step/BUY-38_thumb-screw-m5-knurled-dog-point-d3-5-x-3-upper-ring.step
models/step/BUY-40_countersunk-screw-m5-x-16-iso-10642-station-bases.step
models/step/BUY-40_countersunk-screw-m5-x-20-iso-10642-station-bases.step
models/stl/BUY-01_rubber-pad-d24-x-3.stl
models/stl/BUY-02_countersunk-screw-m5-x-20-iso-10642.stl
models/stl/BUY-02_countersunk-screw-m5-x-30-iso-10642.stl
models/stl/BUY-03_cap-screw-m5-x-35-iso-4762-stop-blocks.stl
models/stl/BUY-04_stop-screw-m6-x-0-75-x-40-hex.stl
models/stl/BUY-05_thin-lock-nut-m6-x-0-75.stl
models/stl/BUY-06_column-clamp-screw-m10-x-16-din-7984-low-head.stl
models/stl/BUY-06_column-clamp-screw-m10-x-25-iso-4762.stl
models/stl/BUY-07_column-clamp-washer-d32-x-2-5-hardened.stl
models/stl/BUY-07_column-clamp-washer-d32-x-4.stl
models/stl/BUY-08_nord-lock-washer-m16.stl
models/stl/BUY-09_column-nut-m16-x-1-5.stl
models/stl/BUY-10_handle-stop-screw-m10-x-1-x-12-nylon-patch-set-screw.stl
models/stl/BUY-10_handle-stop-screw-m10-x-1-x-20-set-screw.stl
models/stl/BUY-11_handle-stop-jam-nut-m10-x-1.stl
models/stl/BUY-12_handle-stop-cap-urethane-d16-x-4.stl
models/stl/BUY-13_flanged-bronze-bushing-25-x-32-x-33-ram.stl
models/stl/BUY-14_ptfe-composite-bushing-16-x-18-x-15-cheeks.stl
models/stl/BUY-15_ptfe-composite-bushing-16-x-18-x-20-lever-o.stl
models/stl/BUY-16_ptfe-composite-bushing-12-x-14-x-20-lever-a-clevis.stl
models/stl/BUY-17_ptfe-composite-bushing-12-x-14-x-6-links.stl
models/stl/BUY-18_retaining-ring-din-471-12.stl
models/stl/BUY-19_retaining-ring-din-471-16.stl
models/stl/BUY-20_return-spring-d3-5-wire-od-31-5-shown-installed-109-5.stl
models/stl/BUY-21_washer-d32-x-3-return-rod.stl
models/stl/BUY-22_nylock-nut-m10.stl
models/stl/BUY-23_urethane-bumper-d16-x-12-m6-stud.stl
models/stl/BUY-24_cap-screw-m8-x-30-iso-4762-cheeks.stl
models/stl/BUY-25_nord-lock-washer-m8.stl
models/stl/BUY-26_dowel-pin-d6-x-16-cheeks.stl
models/stl/BUY-27_cap-screw-m5-x-25-iso-4762-clevis.stl
models/stl/BUY-28_low-head-cap-screw-m5-x-16-din-7984-die-holder.stl
models/stl/BUY-29_lock-screw-m5-x-10-iso-4027-cone-point-die-holder.stl
models/stl/BUY-30_grip-red-tpr-d32-x-120.stl
models/stl/BUY-31_spring-ball-plunger-m6.stl
models/stl/BUY-32_push-knob-phenolic-d14-x-18-m5.stl
models/stl/BUY-32_push-knob-phenolic-d24-m6.stl
models/stl/BUY-33_die-spring-iso-10243-d10-x-32-green-light-shown-installed-30.stl
models/stl/BUY-34_die-spring-iso-10243-d10-x-32-blue-medium-shown-installed-26.stl
models/stl/BUY-34_die-spring-iso-10243-d12-5-x-44-red-heavy-shown-installed-36.stl
models/stl/BUY-35_shoulder-screw-iso-7379-d6-x-10-upper-carrier.stl
models/stl/BUY-36_shoulder-screw-iso-7379-d6-x-12-lower-carriers.stl
models/stl/BUY-37_key-pin-d4-x-14.stl
models/stl/BUY-38_thumb-screw-m5-knurled-cone-point-upper-ring.stl
models/stl/BUY-38_thumb-screw-m5-knurled-dog-point-d3-5-x-3-upper-ring.stl
models/stl/BUY-39_ball-lock-pin-d6-push-button-grip-55.stl
models/stl/BUY-39_quick-release-detent-pin-d6-usable-length-64-ring-handle.stl
models/stl/BUY-40_countersunk-screw-m5-x-16-iso-10642-station-bases.stl
models/stl/BUY-40_countersunk-screw-m5-x-20-iso-10642-station-bases.stl
models/stl/BUY-41_dowel-pin-d6-x-12-station-bases.stl
models/stl/BUY-43_depth-shim-pack-d40-x-1.stl
models/stl/BUY-44_puller-m5-t-handle-loose-tool.stl
models/stl/BUY-45_ball-plunger-m3-upper-ring.stl
models/stl/BUY-45_spring-plunger-m4-nylon-tip-upper-ring.stl
models/stl/BUY-46_dowel-pin-d5-x-14-plug.stl
models/stl/BUY-47_dowel-pin-d12-x-15-pedestal-and-anvil-spigot.stl
models/stl/BUY-48_pin-d4-x-10-pedestal-and-anvil-anti-rotation.stl
models/stl/BUY-49_spring-guide-sleeve-pom-d24-x-d10-5-x-60-return-rod.stl
models/stl/MP-101_base-plate.stl
models/stl/MP-102-B_guide-rail-back.stl
models/stl/MP-102-F_guide-rail-front.stl
models/stl/MP-103-B_keeper-strip-back.stl
models/stl/MP-103-F_keeper-strip-front.stl
models/stl/MP-104_station-stop-block.stl
models/stl/MP-105_die-table-slide.stl
models/stl/MP-106_die-table-stop-pin.stl
models/stl/MP-107_column.stl
models/stl/MP-108_crown.stl
models/stl/MP-109_ram.stl
models/stl/MP-110_clevis.stl
models/stl/MP-111_die-holder.stl
models/stl/MP-112_pivot-cheek.stl
models/stl/MP-113_handle-lever-one-piece.stl
models/stl/MP-114_toggle-link.stl
models/stl/MP-116_pin-a-pin-b-toggle.stl
models/stl/MP-117_pin-o-handle-pivot.stl
models/stl/MP-118_return-rod.stl
models/stl/MP-119_pivot-spacer.stl
models/stl/MP-120_station-pilot.stl
models/stl/MP-121_handle-stop-post.stl
models/stl/MP-201_upper-die-body-universal.stl
models/stl/MP-202_upper-die-shank-universal.stl
models/stl/MP-203-5050_plug-kit-50-x-50.stl
models/stl/MP-203-5380_plug-kit-53-x-80.stl
models/stl/MP-203-6363_plug-kit-63-5-x-63-5.stl
models/stl/MP-203-6590_plug-kit-65-x-90.stl
models/stl/MP-204-5050_upper-ring-kit-50-x-50.stl
models/stl/MP-204-5380_upper-ring-kit-53-x-80.stl
models/stl/MP-204-6363_upper-ring-kit-63-5-x-63-5.stl
models/stl/MP-204-6590_upper-ring-kit-65-x-90.stl
models/stl/MP-205_station-base-universal.stl
models/stl/MP-206-5050_pickup-pedestal-kit-50-x-50.stl
models/stl/MP-206-5380_pickup-pedestal-kit-53-x-80.stl
models/stl/MP-206-6363_pickup-pedestal-kit-63-5-x-63-5.stl
models/stl/MP-206-6590_pickup-pedestal-kit-65-x-90.stl
models/stl/MP-207-5050_pickup-ring-a-kit-50-x-50.stl
models/stl/MP-207-5380_pickup-ring-a-kit-53-x-80.stl
models/stl/MP-207-6363_pickup-ring-a-kit-63-5-x-63-5.stl
models/stl/MP-207-6590_pickup-ring-a-kit-65-x-90.stl
models/stl/MP-208-5050_crimp-anvil-kit-50-x-50.stl
models/stl/MP-208-5380_crimp-anvil-kit-53-x-80.stl
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
