nanda-1243/tngexp/print-templates/A4/template_50x50_A4.pdf

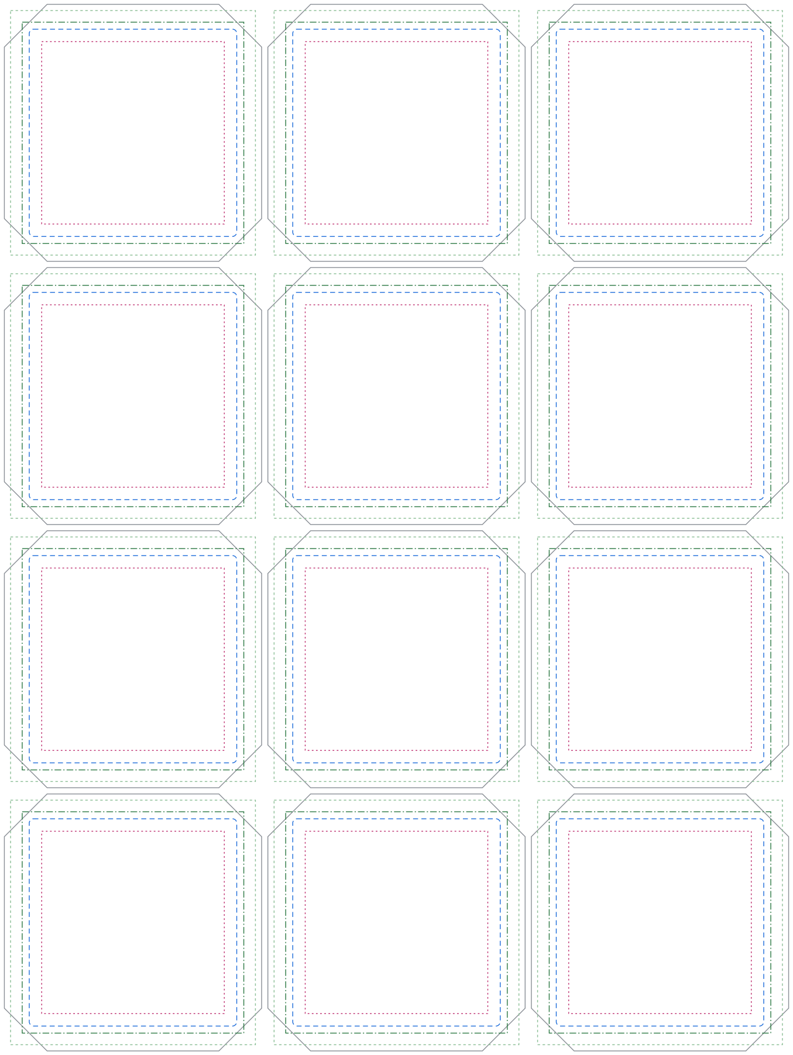
[picture p302: figure]

MagPress M4 · 50 × 50 · 12 per sheet · print at 100 % (actual size) | 50 mm
grey: cut line · green: back border (text between the two green lines shows on the back) · blue dashed: face edge · pink dotted: keep text inside
