nanda-1243/tngexp/print-templates/Letter/template_D56_Letter.pdf

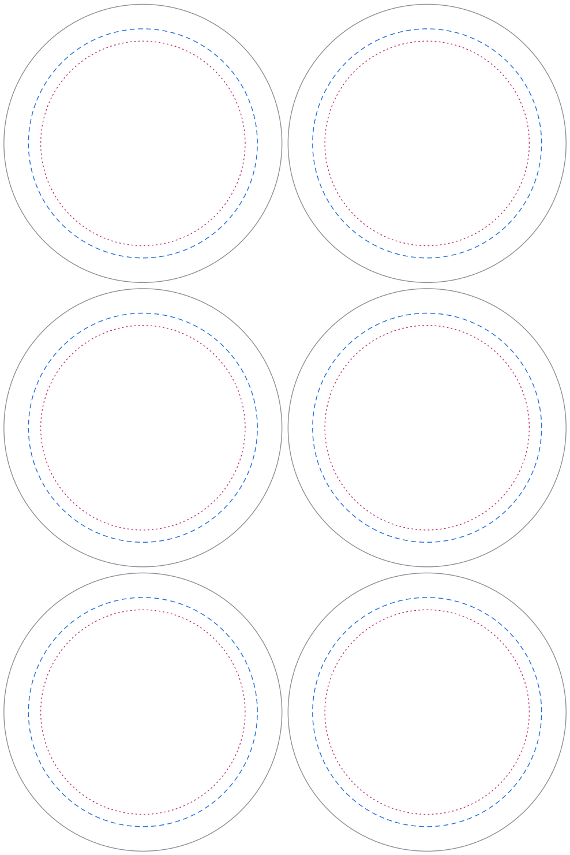
[picture p303: figure]

MagPress M4 · Ø56 · 6 per sheet · print at 100 % (actual size) | 50 mm
grey: cut line · blue dashed: face edge · pink dotted: keep text inside (round magnets roll the edge under)
