nanda-1243/tngexp/release/RevC1/MagPress-M4_Assembly-Manual_RevC1.pdf

# MagPress M4 — Assembly manual (Rev C.1)

How to build the MagPress M4 photo-magnet press from its parts, in 19 steps: frame and die table, ram and crown, toggle drive, universal die, a size kit, then set-up and tests. Every picture comes from the 3D model in models/: the parts added in a step are in colour and pulled apart along the way they go in; parts already fitted are grey. Labels give the part number; the parts table under each picture gives the name, quantity and 3D file.

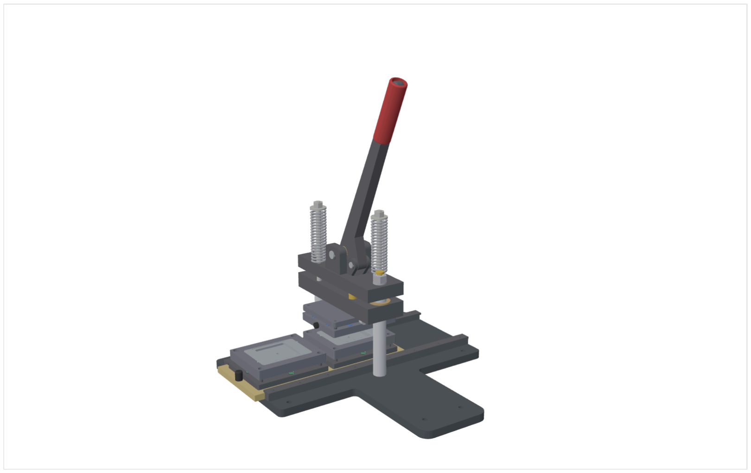
[picture p322: figure]

## Before you start

Parts. Made parts (MP-xxx) are made to the drawing set in release/; bought parts (BUY-xx) are in the BOM and in models/parts.csv. Lay every step's parts out and check them off before you start the step. Directions. Front is the operator side (the base tongue). Left and right are as seen from the front. Station A (pickup) is the left station on the die table, station B (crimp) the right. Pushing the table to the right puts station A under the ram.
Bushings. The pin bushings are PTFE-composite and run dry: no grease, never ream them after pressing. Press them with a stepped mandrel, never with a hammer.
Lubrication. Columns and the graphite-plugged ram bushings run dry: wipe them clean. Light oil on the rails only. No oil on the dies.
Threadlocker. Clean threads with solvent before Loctite. The torque table below lists every joint. Safety. The press weighs about 45 kg: lift it with two people. The pinch points are between the dies and between the table and the stop blocks. Wear gloves when handling tinplate shells.

Rev C.1. Every part in this manual was checked against every other in the 3D model at six handle angles, from fully up to on the stop: nothing clashes. Rev C.1 fixed the seven clashes found in Rev C
with these changes (details in models/README.md):
MagPress M4 · Assembly manual · Rev C.1 | 1

Part | Change | Step
Ram MP-109 | Two link-clearance pockets on the top beside the clevis: the links' R12 lower ends dipped 2 mm into the ram. | 6
Crown MP-108 | Reliefs in the slot walls for the ends of pin B (underside, handle up) and pin A (top, handle down). | 7
Die table MP-105, push knobs | Ø14 knobs on the table top at each end, instead of Ø24 knobs on the end faces that reached into the base. | 3
Base MP-101, column MP-107 | Counterbore 8.5 deep and column spigot 6.5: the M10 × 16 low-head clamp screw and Ø32 × 2.5 washer sit flush underneath. | 2
Handle stop | M10 × 1 × 12 set screw with a nylon patch and no jam nut: there was no room for the nut. | 12
Stop screw | M6 × 0.75 × 40: the 25 mm screw could not reach through the stop block. | 5

## Tools and materials

Arbor or hydraulic press (5 t) with a flat bed, support blocks and stepped bushing mandrels for 12/14, 16/18 and 25/32 bushings
Torque wrenches 2–25 N·m and 20–110 N·m; hex keys 2.5, 3, 4, 5, 6, 8 mm; spanners and sockets 10, 16,
17, 24 mm
External retaining-ring pliers for Ø12 and Ø16 shafts
Ø18 H7 line reamer with a long pilot (for the pivot cheeks)
Straightedge, feeler gauges, 0.05 mm shim, dial indicator on a magnetic base, calipers, depth gauge, square, bore gauge
Ø16 centring pin with a point and a Ø12 centring plug (station alignment, step 14)
Loctite 243 (medium) and 222 (low strength), rubber adhesive, light machine oil
Two wooden bearers about 50 mm high and a wooden block about 60 mm high
For the tests: 10 kN load cell (20 kN for the proof load), hanging scale, dummy die block

## Torque and thread-locker table

Joint | Fastener | Torque | Thread lock
Rail and keeper screws | M5 × 20 ISO 10642 | 6 N·m | —
Stop-block screws | M5 × 35 ISO 4762 | 6 N·m | Loctite 243
Column clamp screws | M10 × 16 DIN 7984 | 40 N·m | Loctite 243
Column nuts | M16 × 1.5 + Nord-Lock | 100 N·m, two passes | —
Clevis screws | M5 × 25 ISO 4762 | 6 N·m | Loctite 243
Die-holder screws | M5 × 16 DIN 7984 | 6 N·m | Loctite 243
Station pilot | M6 | hand tight | Loctite 243
Return rods into the ram | M10 | 20 N·m * | Loctite 243
Bumpers | M6 stud | hand tight | Loctite 243
Cheek screws | M8 × 30 + Nord-Lock | 25 N·m * | —
Return-spring nuts | M10 nylock | to 109.5 mm spring length | —
Shank into the die body | M10 | 25 N·m * | Loctite 243
Die-holder lock screw | M5 cone point | about 3 N·m | nylon patch
Station-base screws | M5 × 16 ISO 10642 | 6 N·m | —
Carrier shoulder screws | ISO 7379 Ø6 | 8 N·m | —
Plug stud | M6 | 8 N·m * | Loctite 243
Table stop pin | M4 | 2.5 N·m * | Loctite 243
Stop screws | M6 × 0.75 × 40 + lock nut | set, then lock | —
Handle-stop screw | M10 × 1 × 12 | set to the 3° rest | nylon patch
Ball plunger, ring plungers | M6, M4 | set, then lock | Loctite 222
Ring thumb screws | M5 | finger tight | —

Values marked * are standard values for property class 8.8 screws; the others are from the drawings and the build pack.

Part A — | Frame and die table
Step 1 — | Prepare the base plate

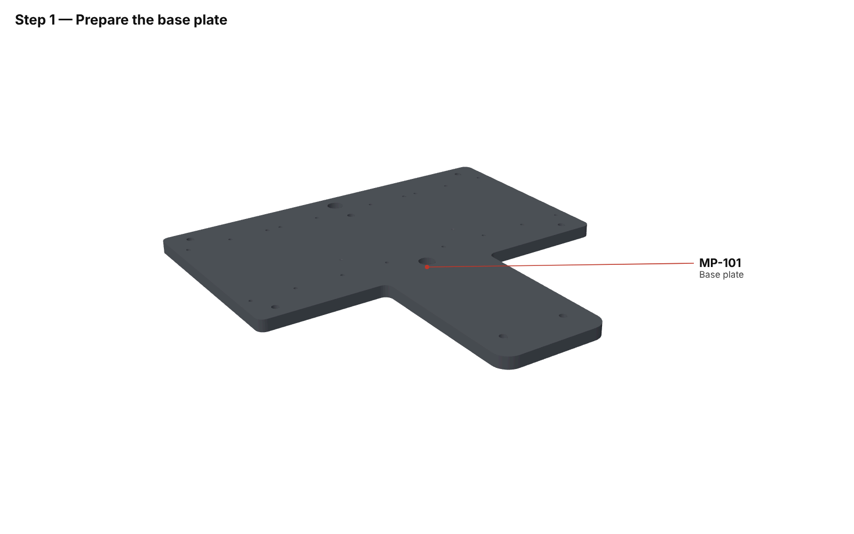
[picture p323: figure]

Part | Name | Qty | 3D model
MP-101 | Base plate | 1 | MP-101_base-plate .step / .stl

Tools: Straightedge, feeler gauges, bore gauge, two wooden bearers about 50 mm high

1. Deburr and clean the plate. Check the counterbores C1/C2 (Ø33 × 8.5) are on the underside and the tongue is at the front.
2. Check flatness of the slide area (X ±230 × Y ±75): 0.05 mm with a straightedge and feelers.
3. Check the column holes C1/C2: Ø20 H7, 210.00 ±0.01 apart.
4. Put the plate on two wooden bearers for the rest of the build, so you can reach the screws underneath.

Check. Flat within 0.05 mm under the die table; column holes to size and position.

Step 2 — | Columns

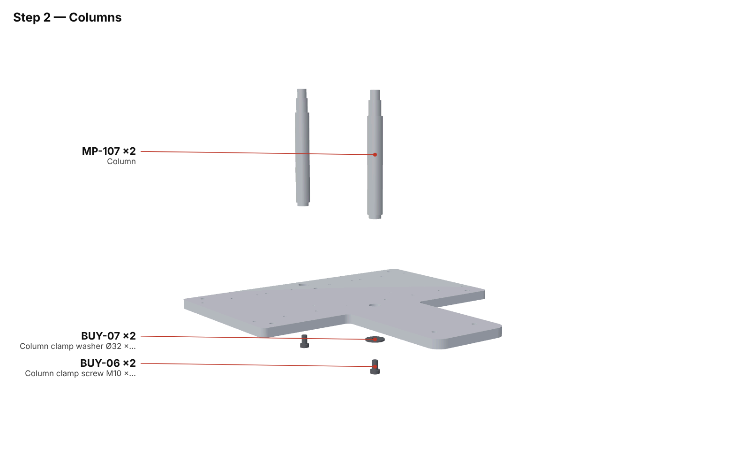
[picture p324: figure]

Part | Name | Qty | 3D model
MP-107 | Column | 2 | MP-107_column .step / .stl
BUY-07 | Column clamp washer Ø32 × 2.5, hardened | 2 | BUY-07_column-clamp-washer-d32-x-2-5-hardened .step / .stl
BUY-06 | Column clamp screw M10 × 16 DIN 7984 (low head) | 2 | BUY-06_column-clamp-screw-m10-x-16-din-7984-low-head .step / .stl

Tools: Arbor or hydraulic press (5 t), flat support block, square, dial indicator, torque wrench, 8 mm hex key, Loctite 243

1. Support the base on the press bed directly under the first hole.
2. Press the column's Ø20 p6 spigot (the short end) into C1 from the top until the Ø25 shoulder seats on the plate. Press straight; a light oil film on the spigot helps.
3. Repeat for the second column in C2.
4. From underneath, fit the hardened Ø32 × 2.5 washer into each counterbore and pull the column down with the M10 × 16 low-head clamp screw, Loctite 243, 40 N·m. The head ends flush with the base underside.

Check. Each column square to the base within 0.05 per 100 mm; centres 210.00 ±0.01 at the top.

Step 3 — | Die table on the bench

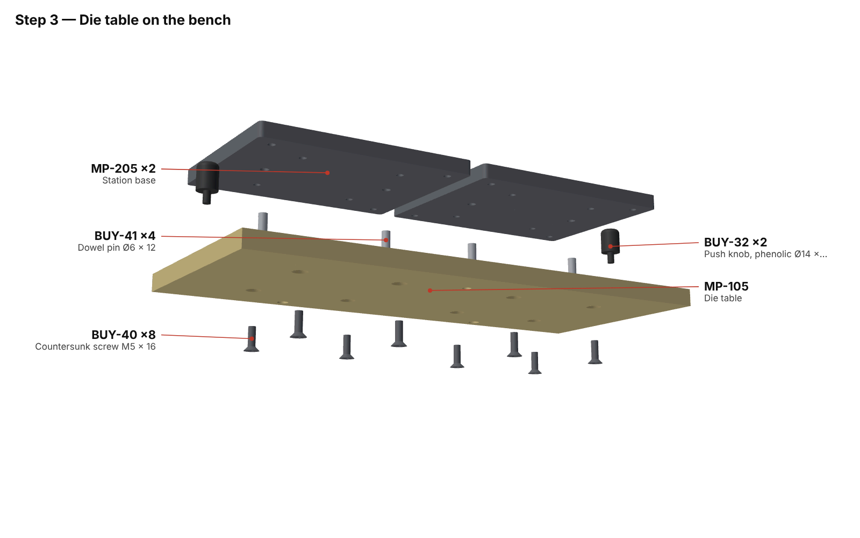
[picture p325: figure]

Part | Name | Qty | 3D model
MP-105 | Die table (slide) | 1 | MP-105_die-table-slide .step / .stl
BUY-41 | Dowel pin Ø6 × 12 (station bases) | 4 | BUY-41_dowel-pin-d6-x-12-station-bases .step / .stl
MP-205 | Station base (universal) | 2 | MP-205_station-base-universal .step / .stl
BUY-40 | Countersunk screw M5 × 16 ISO 10642 (station bases) | 8 | BUY-40_countersunk-screw-m5-x-16-iso-10642-station-b ases .step / .stl
BUY-32 | Push knob, phenolic Ø14 × 18, M5 | 2 | BUY-32_push-knob-phenolic-d14-x-18-m5 .step / .stl

Tools: Soft-face mallet, 3 mm hex key, torque wrench

1. The station bases go on now because their screws are under the table.
2. Press two Ø6 × 12 dowels into each pair of G holes in the table top, 6 mm proud.
3. Put a station base (MP-205) on each pair of dowels: base A over the left station, base B over the right. The Ø4 hole Q in each base goes to the front.
4. From underneath, fit the eight M5 × 16 countersunk screws (F1 to F8) flush, 6 N·m.
5. Screw the two Ø14 push knobs into the M5 holes K1/K2 on the table top, one at each end.

Check. Screw heads flush or below the table underside; bases sit flat on the table.

Step 4 — | Guide rails, keepers and the die table

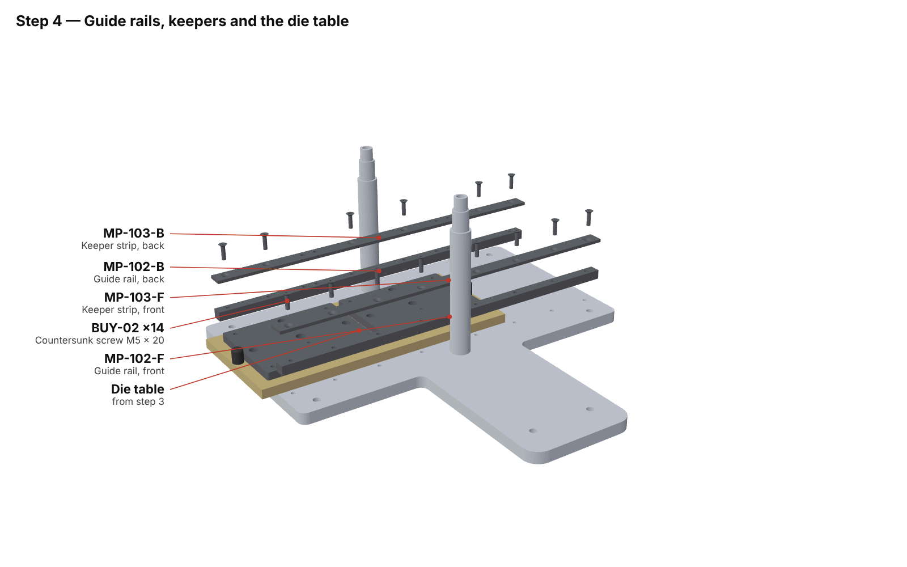
[picture p326: figure]

Part | Name | Qty | 3D model
— | Die table from step 3
MP-102-F | Guide rail, front | 1 | MP-102-F_guide-rail-front .step / .stl
MP-102-B | Guide rail, back | 1 | MP-102-B_guide-rail-back .step / .stl
MP-103-F | Keeper strip, front | 1 | MP-103-F_keeper-strip-front .step / .stl
MP-103-B | Keeper strip, back | 1 | MP-103-B_keeper-strip-back .step / .stl
BUY-02 | Countersunk screw M5 × 20 ISO 10642 | 14 | BUY-02_countersunk-screw-m5-x-20-iso-10642 .step / .stl

Tools: 0.05 mm shim, 3 mm hex key, torque wrench, light oil

1. Lay the front rail (-F, 8 holes) and the back rail (-B, 10 holes) on the base over the rail screw holes.
2. Put the die table between them as a gauge, with a 0.05 mm shim between the table and one rail.
3. Lay the keepers on the rails with the hole line toward the outside, so the inner edge overlaps the table by 5 mm: front keeper (-F) at the front, back keeper (-B, with four plain holes) at the back.
4. Fit the fourteen M5 × 20 countersunk screws through keeper and rail into the base, 6 N·m, working from the centre out. Leave the four plain holes in the back keeper for the stop blocks.
5. Pull out the shim. Put a few drops of light oil on the rails.

Check. The table runs end to end with fingertip force, with no rock and no lift at the ends; running clearance 0.03 to 0.05 mm.

Step 5 — | Stop blocks, stop pin and ball plunger

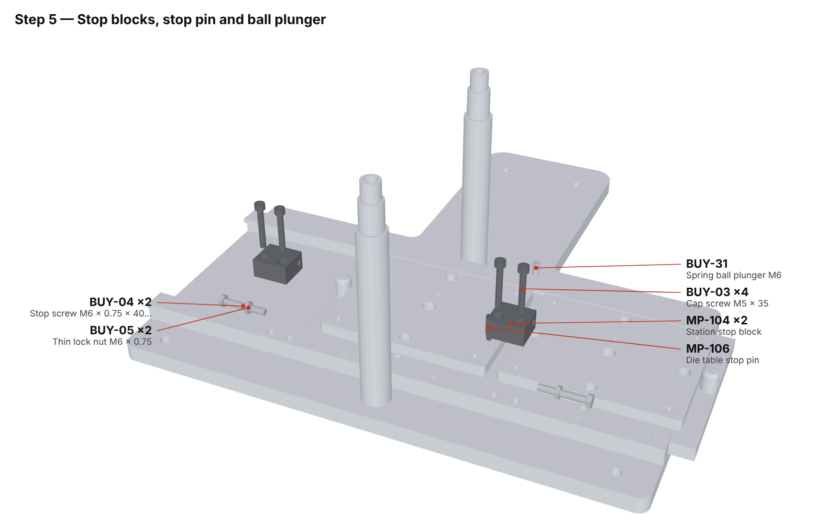
[picture p327: figure]

Part | Name | Qty | 3D model
MP-104 | Station stop block | 2 | MP-104_station-stop-block .step / .stl
BUY-03 | Cap screw M5 × 35 ISO 4762 (stop blocks) | 4 | BUY-03_cap-screw-m5-x-35-iso-4762-stop-blocks .step / .stl
BUY-04 | Stop screw M6 × 0.75 × 40 hex | 2 | BUY-04_stop-screw-m6-x-0-75-x-40-hex .step / .stl
BUY-05 | Thin lock nut M6 × 0.75 | 2 | BUY-05_thin-lock-nut-m6-x-0-75 .step / .stl
MP-106 | Die table stop pin | 1 | MP-106_die-table-stop-pin .step / .stl
BUY-31 | Spring ball plunger M6 | 1 | BUY-31_spring-ball-plunger-m6 .step / .stl

Tools: 4 mm hex key, 10 mm spanner, screwdriver, torque wrench, Loctite 243 and 222

1. Put a stop block (MP-104) over each pair of plain holes in the back keeper, the overhang toward the table.
2. Fit two M5 × 35 cap screws per block through keeper and rail into the base, Loctite 243, 6 N·m.
3. Screw an M6 × 0.75 × 40 stop screw with its lock nut into each block from the outside, tip toward the centre. Leave the lock nuts loose: the stations are set in step 14.
4. Screw the stop pin (MP-106) into hole S on the table top, Loctite 243, 2.5 N·m.
5. Screw the ball plunger into hole BP from the top until it clicks into the detent spots at both stations. Lock it with Loctite 222.

Check. The table clicks at both stations and the stop pin meets a stop screw at each end.

Part B — | Ram and crown
Step 6 — | Ram sub-assembly

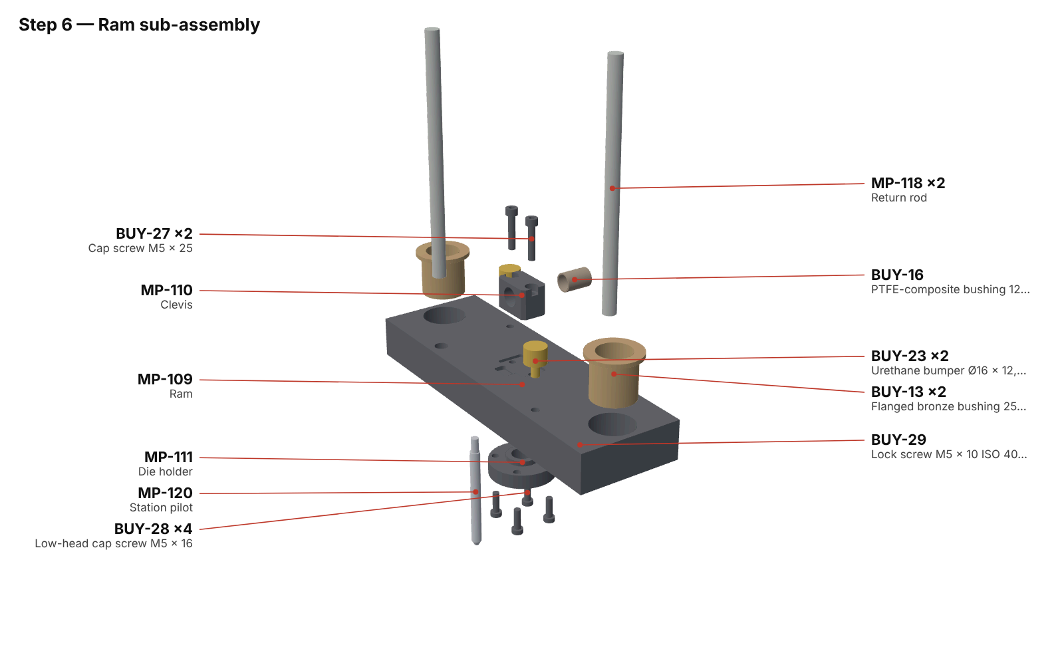
[picture p328: figure]

Part | Name | Qty | 3D model
MP-109 | Ram | 1 | MP-109_ram .step / .stl
BUY-13 | Flanged bronze bushing 25 × 32 × 33 (ram) | 2 | BUY-13_flanged-bronze-bushing-25-x-32-x-33-ram .step / .stl
MP-110 | Clevis | 1 | MP-110_clevis .step / .stl
BUY-16 | PTFE-composite bushing 12 × 14 × 20 (lever A, clevis) | 1 | BUY-16_ptfe-composite-bushing-12-x-14-x-20-lever-a-c levis .step / .stl
BUY-27 | Cap screw M5 × 25 ISO 4762 (clevis) | 2 | BUY-27_cap-screw-m5-x-25-iso-4762-clevis .step / .stl
MP-111 | Die holder | 1 | MP-111_die-holder .step / .stl
BUY-28 | Low-head cap screw M5 × 16 DIN 7984 (die holder) | 4 | BUY-28_low-head-cap-screw-m5-x-16-din-7984-die-holde r .step / .stl
BUY-29 | Lock screw M5 × 10 ISO 4027, cone point (die holder) | 1 | BUY-29_lock-screw-m5-x-10-iso-4027-cone-point-die-ho lder .step / .stl
MP-120 | Station pilot | 1 | MP-120_station-pilot .step / .stl
MP-118 | Return rod | 2 | MP-118_return-rod .step / .stl
BUY-23 | Urethane bumper Ø16 × 12, M6 stud | 2 | BUY-23_urethane-bumper-d16-x-12-m6-stud .step / .stl

Tools: Press and stepped mandrels (25/32 and 12/14 bushings), 3 and 4 mm hex keys, 17 mm spanner, torque wrench, Loctite 243

1. Press the two flanged bronze bushings into the ram's Ø32 bores from the top, flange on the top face, flush with the underside.
2. Press the 12 × 14 × 20 PTFE-composite bushing into the clevis bore, flush both sides. Never ream or grease these bushings.

3. Check the two link-clearance pockets L1/L2 beside the clevis pocket are clean and deburred: the links' lower ends run in them. Put the clevis in the 2 mm pocket on the ram top, bore running left to right. Fit two M5 × 25 cap screws, Loctite 243, 6 N·m.
4. Push the die holder's Ø24 spigot into the ram underside, its Ø4 orientation hole to the front. Fit four M5 × 16 low-head screws from below, Loctite 243, 6 N·m. Screw the M5 cone-point lock screw into the holder's side hole and back it off.
5. Screw the station pilot into hole PL under the ram (back side), Loctite 243. The tip ends 84 mm below the ram.
6. Screw the two return rods into R1/R2 on the ram top, Loctite 243, 20 N·m.
7. Screw the two urethane bumpers into U1/U2 on the ram top, Loctite 243, hand tight.

Check. Clevis bore parallel to the ram underside within 0.02; pilot square to the ram.

Step 7 — | Crown sub-assembly

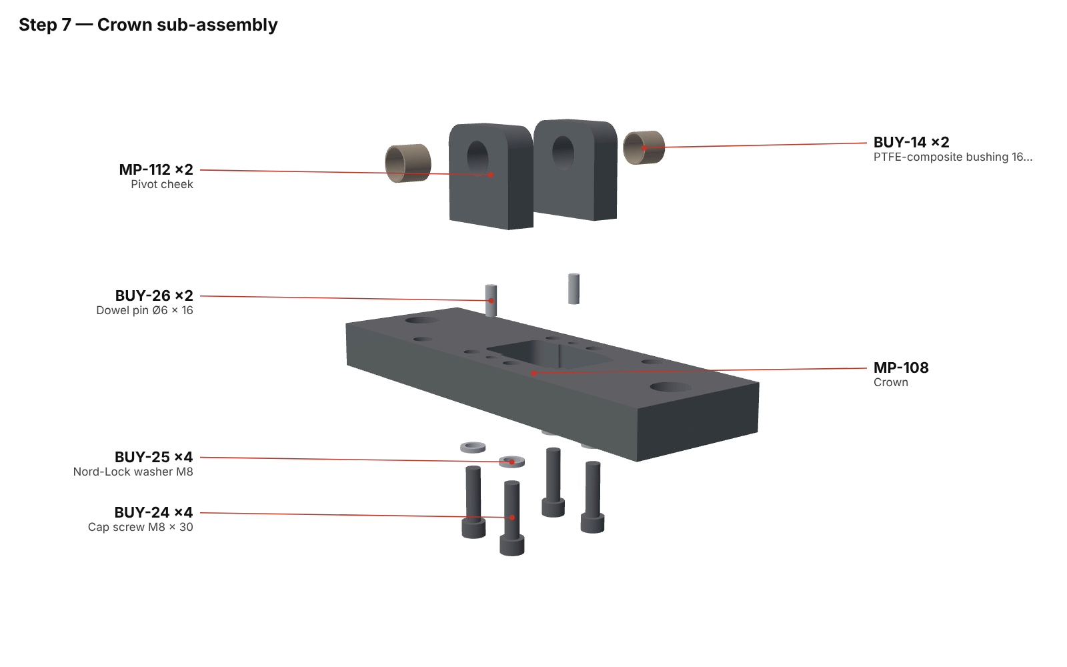
[picture p329: figure]

Part | Name | Qty | 3D model
MP-108 | Crown | 1 | MP-108_crown .step / .stl
BUY-26 | Dowel pin Ø6 × 16 (cheeks) | 2 | BUY-26_dowel-pin-d6-x-16-cheeks .step / .stl
MP-112 | Pivot cheek | 2 | MP-112_pivot-cheek .step / .stl
BUY-14 | PTFE-composite bushing 16 × 18 × 15 (cheeks) | 2 | BUY-14_ptfe-composite-bushing-16-x-18-x-15-cheeks .step / .stl
BUY-25 | Nord-Lock washer M8 | 4 | BUY-25_nord-lock-washer-m8 .step / .stl
BUY-24 | Cap screw M8 × 30 ISO 4762 (cheeks) | 4 | BUY-24_cap-screw-m8-x-30-iso-4762-cheeks .step / .stl

Tools: Ø18 H7 line reamer with pilot, press and 16/18 mandrel, 6 mm hex key, torque wrench

1. Deburr the four reliefs in the slot walls (N1/N2 underneath, N3/N4 on top): the ends of pins B and A pass through them.
2. Press the two Ø6 × 16 dowels into P1/P2 on the crown top, 8 mm proud.
3. Put a pivot cheek on each dowel, the bore running left to right. Fix each with two M8 × 30 cap screws and Nord-Lock washers from below, 25 N·m.
4. Line-ream both cheek bores together to Ø18 H7 in one pass.
5. Press a 16 × 18 × 15 PTFE-composite bushing into each cheek, 0.5 mm in from each face. Do not ream the bushings afterwards.

Check. A Ø16 g6 test pin slides through both cheeks freely with no binding.

Step 8 — | Ram and crown onto the columns

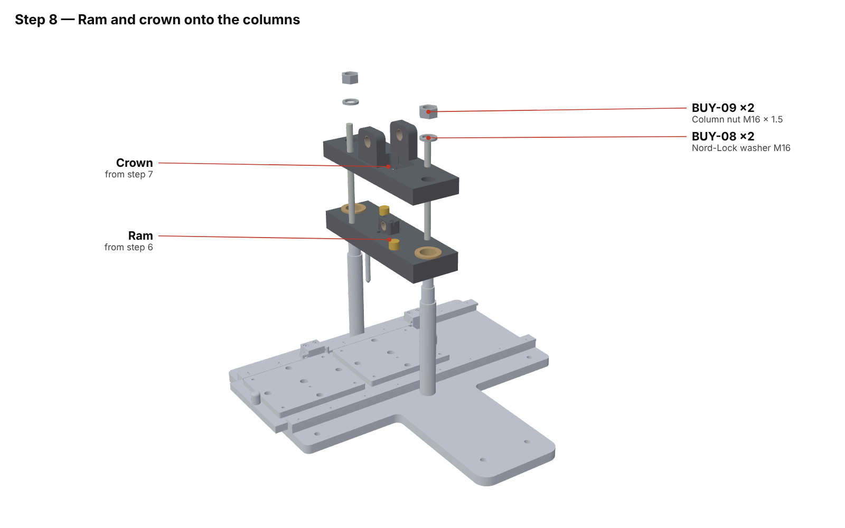
[picture p330: figure]

Part | Name | Qty | 3D model
— | Ram sub-assembly from step 6
— | Crown sub-assembly from step 7
BUY-08 | Nord-Lock washer M16 | 2 | BUY-08_nord-lock-washer-m16 .step / .stl
BUY-09 | Column nut M16 × 1.5 | 2 | BUY-09_column-nut-m16-x-1-5 .step / .stl

Tools: 24 mm socket, torque wrench (100 N·m), wooden block about 60 mm high

1. Wipe the columns clean and dry: the graphite-plugged bushings run without grease.
2. Slide the ram down over the column tops, bushing flanges up. Let it rest low on a wooden block on the die table.
3. Lower the crown over the column spigots, cheeks on top, with the return rods passing up through holes
R1/R2.
4. Fit a Nord-Lock washer pair and an M16 × 1.5 nut on each column. Tighten to 100 N·m in two passes, alternating.

Check. The ram slides the full column length under its own weight. If it binds, loosen the nuts and re-seat the crown.

Part C — | Toggle drive
Step 9 — | Lever and links on the bench


Part | Name | Qty | 3D model
MP-113 | Handle lever (one piece) | 1 | MP-113_handle-lever-one-piece .step / .stl
BUY-15 | PTFE-composite bushing 16 × 18 × 20 (lever O) | 1 | BUY-15_ptfe-composite-bushing-16-x-18-x-20-lever-o .step / .stl
BUY-16 | PTFE-composite bushing 12 × 14 × 20 (lever A, clevis) | 1 | BUY-16_ptfe-composite-bushing-12-x-14-x-20-lever-a-c levis .step / .stl
BUY-30 | Grip, red TPR Ø32 × 120 | 1 | BUY-30_grip-red-tpr-d32-x-120 .step / .stl
MP-114 | Toggle link | 2 | MP-114_toggle-link .step / .stl
BUY-17 | PTFE-composite bushing 12 × 14 × 6 (links) | 4 | BUY-17_ptfe-composite-bushing-12-x-14-x-6-links .step / .stl

Tools: Press and 16/18 and 12/14 mandrels, rubber adhesive

1. Press the 16 × 18 × 20 bushing into the lever's pivot bore O and the 12 × 14 × 20 bushing into the crank bore A, flush both faces.
2. Push the red grip onto the grip zone with rubber adhesive, centred 320 mm from O (it covers 260 to
380).
3. Press a 12 × 14 × 6 bushing into each bore of both links, flush with the outer face. The links are a matched pair: keep their stamp marks together and facing out.

Check. Pins slide through every bushing by hand with no play you can feel.

Step 10 — | Hang the lever on pin O

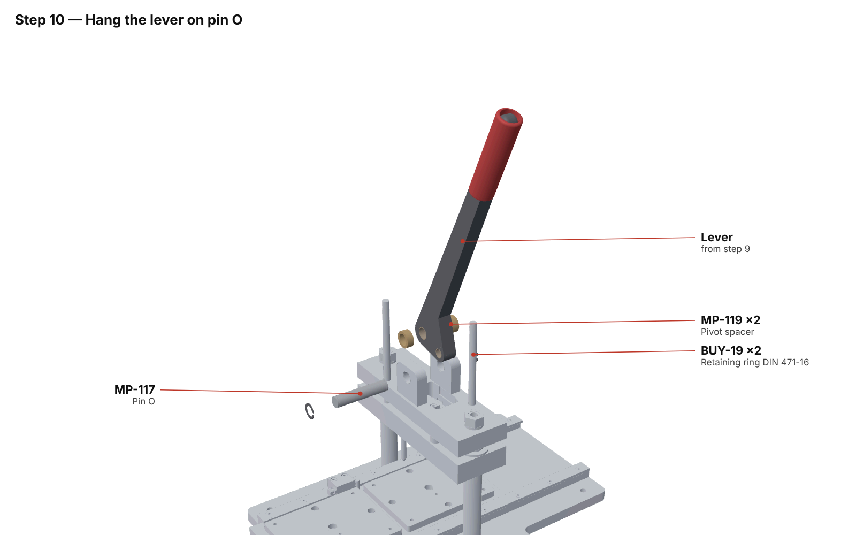
[picture p331: figure]

Part | Name | Qty | 3D model
— | Lever from step 9
MP-119 | Pivot spacer | 2 | MP-119_pivot-spacer .step / .stl
MP-117 | Pin O (handle pivot) | 1 | MP-117_pin-o-handle-pivot .step / .stl
BUY-19 | Retaining ring DIN 471-16 | 2 | BUY-19_retaining-ring-din-471-16 .step / .stl

Tools: External retaining-ring pliers (Ø16)

1. Hold the lever between the cheeks, handle pointing to the front, with a bronze spacer each side of it.
2. Push pin O through: left cheek, spacer, lever, spacer, right cheek.
3. Fit a DIN 471-16 retaining ring in the groove at each end.

Check. The lever swings freely through its whole arc; end float 0.1 to 0.5 mm.

Step 11 — | Links, pin A and pin B

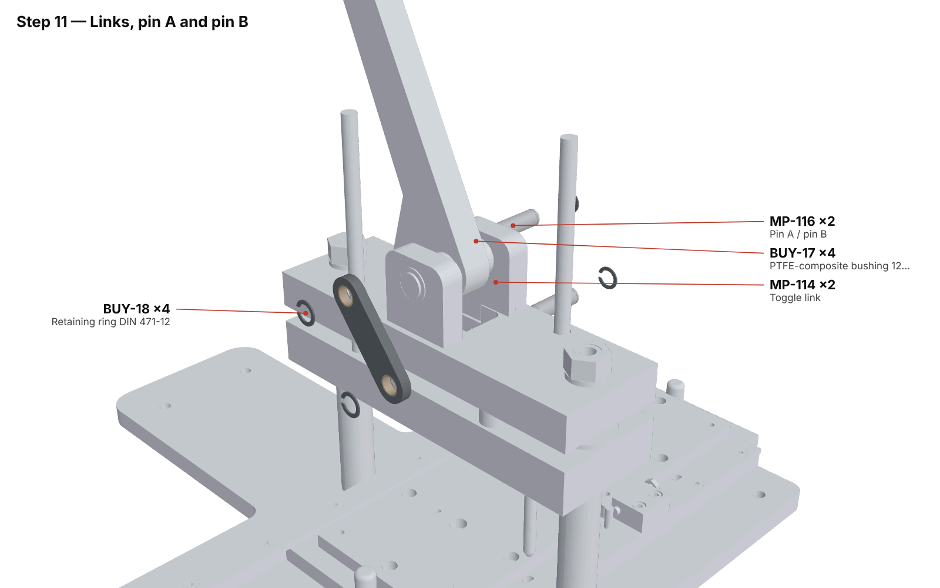
[picture p332: figure]

Part | Name | Qty | 3D model
MP-114 | Toggle link | 2 | MP-114_toggle-link .step / .stl
BUY-17 | PTFE-composite bushing 12 × 14 × 6 (links) | 4 | BUY-17_ptfe-composite-bushing-12-x-14-x-6-links .step / .stl
MP-116 | Pin A / pin B (toggle) | 2 | MP-116_pin-a-pin-b-toggle .step / .stl
BUY-18 | Retaining ring DIN 471-12 | 4 | BUY-18_retaining-ring-din-471-12 .step / .stl

Tools: External retaining-ring pliers (Ø12)

1. Put a link each side of the lever at the crank bore A, stamp marks out. Push pin A through and fit a DIN 471-12 ring at each end.
2. With the ram still resting low, swing the links down either side of the clevis. Raise the ram until the bores line up and push pin B through link, clevis and link.
3. Fit a DIN 471-12 ring at each end of pin B. Pin B can only go in with the ram low: with the handle up its ends sit in the crown reliefs.

Check. Lifting the handle lifts the ram smoothly; nothing touches the crown or the ram top through the full stroke.

Step 12 — | Return springs and handle stop

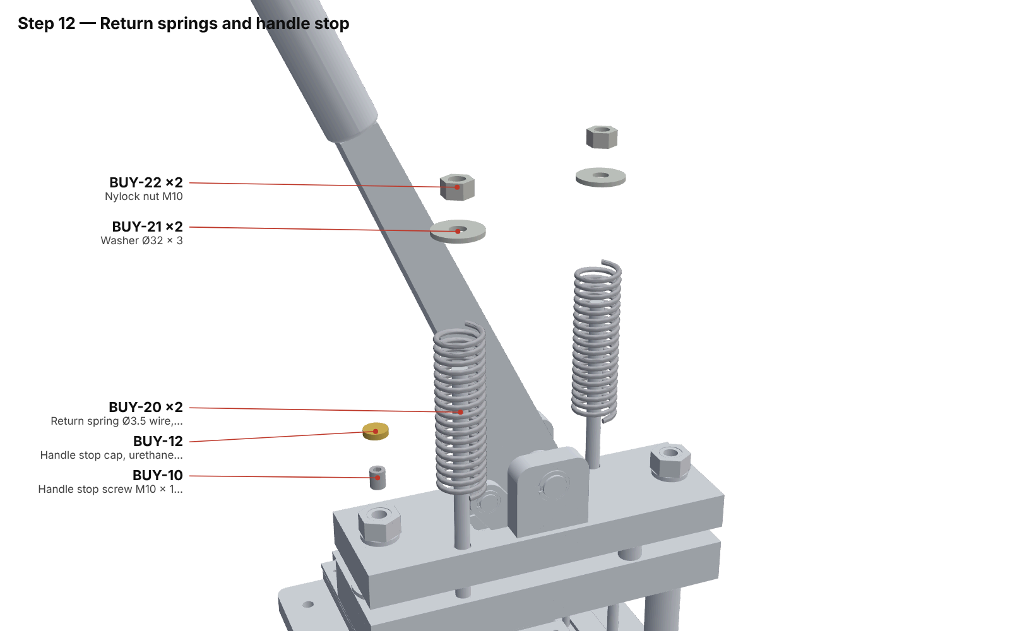
[picture p333: figure]

Part | Name | Qty | 3D model
BUY-20 | Return spring Ø3.5 wire, OD 31.5 (shown installed, 109.5) | 2 | BUY-20_return-spring-d3-5-wire-od-31-5-shown-install ed-109-5 .step / .stl
BUY-21 | Washer Ø32 × 3 (return rod) | 2 | BUY-21_washer-d32-x-3-return-rod .step / .stl
BUY-22 | Nylock nut M10 | 2 | BUY-22_nylock-nut-m10 .step / .stl
BUY-10 | Handle stop screw M10 × 1 × 12, nylon patch (set screw) | 1 | BUY-10_handle-stop-screw-m10-x-1-x-12-nylon-patch-se t-screw .step / .stl
BUY-12 | Handle stop cap, urethane Ø16 × 4 | 1 | BUY-12_handle-stop-cap-urethane-d16-x-4 .step / .stl

Tools: 17 mm socket, 5 mm hex key, calipers, protractor or angle gauge

1. Take the wooden block out. Drop a return spring over each return rod, then a Ø32 × 3 washer and an M10 nylock nut.
2. Tighten each nut until the ram is pulled up against the bumpers and the spring measures 109.5 mm (about 80 N).
3. Screw the M10 × 1 × 12 handle-stop set screw (nylon patch) into the top of the front column and put the urethane cap on it.
4. Pull the handle down onto the stop. Adjust the screw until the lever rests 3° above horizontal; the nylon patch holds the setting.

Check. Handle swings 65° to 3° and springs back to the open stop from fully down, 20 times out of 20. Ram travel 38.9 ±0.3 mm.

Part D — | Universal die
Step 13 — | Lower dies

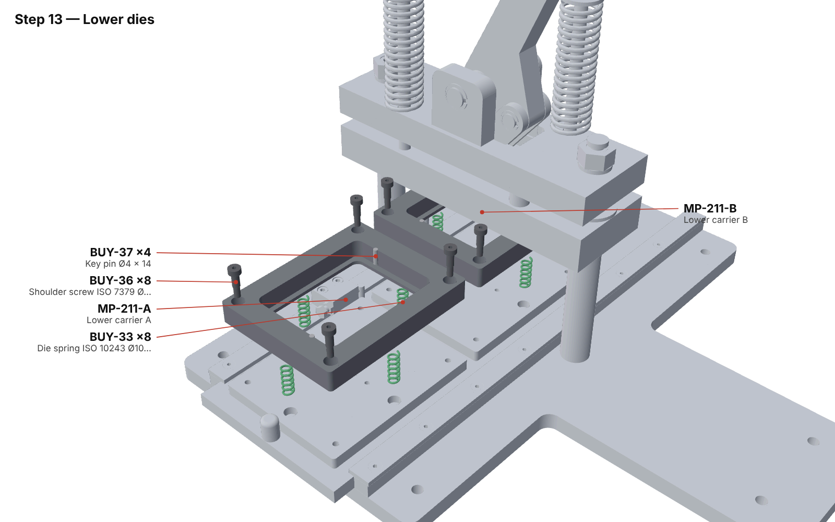
[picture p334: figure]

Part | Name | Qty | 3D model
BUY-33 | Die spring ISO 10243 Ø10 × 32 green (light), shown installed 30 | 8 | BUY-33_die-spring-iso-10243-d10-x-32-green-light-sh own-installed-30 .step / .stl
MP-211-A | Lower carrier A (universal, pickup) | 1 | MP-211-A_lower-carrier-a-universal-pickup .step / .stl
BUY-37 | Key pin Ø4 × 14 | 4 | BUY-37_key-pin-d4-x-14 .step / .stl
MP-211-B | Lower carrier B (universal, crimp) | 1 | MP-211-B_lower-carrier-b-universal-crimp .step / .stl
BUY-36 | Shoulder screw ISO 7379 Ø6 × 12 (lower carriers) | 8 | BUY-36_shoulder-screw-iso-7379-d6-x-12-lower-carrie rs .step / .stl

Tools: 5 mm hex key, torque wrench

1. Check the key pins are pressed flush in each carrier: carrier A (green band) has them at KA, carrier B (red band) at KB.
2. Put four green die springs in the pockets of each station base.
3. Lay carrier A on the left station and carrier B on the right, spring pockets down over the springs.
4. Fit four Ø6 × 12 shoulder screws through each carrier into its base, 8 N·m, in a cross pattern.

Check. Each carrier moves 8 mm freely and springs back square.

### Step 14 — Align the stations

Tools: Ø16 centring pin with a point (fits the die holder), Ø12 centring plug (fits hole C), 10 mm spanner, dial indicator

1. Do this before the upper die goes on: the die holder must be empty.
2. Put the Ø16 centring pin in the die holder and lock it with the holder's cone-point screw. Put the Ø12 plug in hole C of station base A.
3. Push the table to the right until it clicks (station A under the ram). Lower the handle slowly and adjust the right-hand stop screw until the pin point lands on the plug centre. Lock the nut.
4. Push the table to the left (station B under the ram) and set the left-hand stop screw the same way.
5. Move the table 3 mm off a station and make a slow stroke: the station pilot must land on the table and stop the stroke. Repeat at the other station.

Check. ±0.05 mm at both stations; off station the stroke stops with the dies at least 5 mm apart.

Step 15 — | Upper die on the bench


Part | Name | Qty | 3D model
MP-201 | Upper die body (universal) | 1 | MP-201_upper-die-body-universal .step / .stl
MP-202 | Upper die shank (universal) | 1 | MP-202_upper-die-shank-universal .step / .stl
BUY-42 | Orientation pin Ø4 × 10 | 1 | BUY-42_orientation-pin-d4-x-10 .step / .stl
BUY-34 | Die spring ISO 10243 Ø10 × 32 blue (medium), shown installed 26 | 8 | BUY-34_die-spring-iso-10243-d10-x-32-blue-medium-sh own-installed-26 .step / .stl
MP-210 | Upper carrier (universal) | 1 | MP-210_upper-carrier-universal .step / .stl
BUY-37 | Key pin Ø4 × 14 | 2 | BUY-37_key-pin-d4-x-14 .step / .stl
BUY-38 | Thumb screw M5, knurled, cone point (upper ring) | 2 | BUY-38_thumb-screw-m5-knurled-cone-point-upper-ring .step / .stl
BUY-35 | Shoulder screw ISO 7379 Ø6 × 10 (upper carrier) | 4 | BUY-35_shoulder-screw-iso-7379-d6-x-10-upper-carrie r .step / .stl

Tools: 16 mm spanner on the shank flats or soft jaws, 5 mm hex key, torque wrench, Loctite 243, a block with a Ø20 hole

1. Screw the shank (MP-202) into the M10 hole in the die body's top face, Loctite 243, until the Ø16 face seats: 25 N·m.
2. Press the Ø4 × 10 orientation pin into hole O on the body top, 4 mm proud.
3. Check the two key pins are flush in the upper carrier. Screw the two thumb screws into the carrier ends and back them out of the pocket.
4. Turn the body over onto the block (shank down through the hole). Put the eight blue die springs in its spring pockets.
5. Lay the carrier on the springs, pocket side up. Fit the four Ø6 × 10 shoulder screws through the carrier into the body. Tighten them in a cross pattern a turn at a time: the springs push back with about 680 N in total. Finish at 8 N·m.

Check. The carrier pushes up 5.5 mm evenly and springs back square to the body.

Step 16 — | Mount the upper die

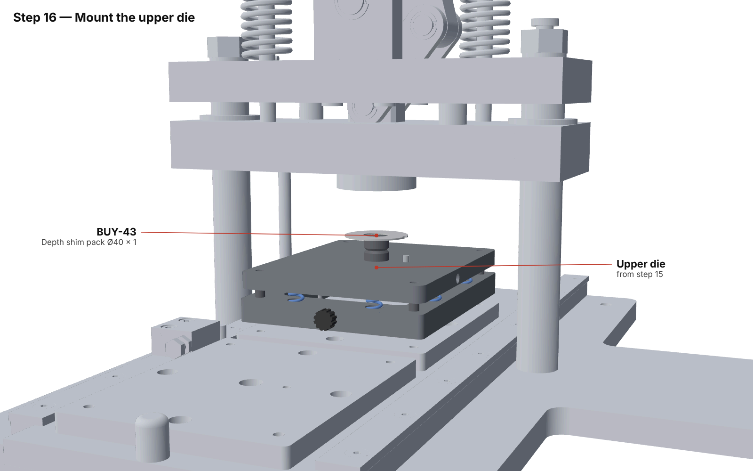
[picture p335: figure]

Part | Name | Qty | 3D model
— | Upper die from step 15
BUY-43 | Depth shim pack Ø40 × 1 | 1 | BUY-43_depth-shim-pack-d40-x-1 .step / .stl

Tools: 2.5 mm hex key

1. Put the shim pack on the body top over the shank and orientation pin. Start with no shims; the depth is set in step 19.
2. Push the shank up into the die holder, the orientation pin into the holder's Ø4 hole (front).
3. Tighten the cone-point lock screw into the shank's V-groove, firmly (about 3 N·m).

Check. Upper die face parallel to the table within 0.05 at all four corners.

Part E — | Size kit
Step 17 — | Prepare a size kit


Part | Name | Qty | 3D model
MP-203-6363 | Plug, kit 63.5 × 63.5 | 1 | MP-203-6363_plug-kit-63-5-x-63-5 .step / .stl
BUY-46 | Dowel pin Ø5 × 14 (plug) | 2 | BUY-46_dowel-pin-d5-x-14-plug .step / .stl
MP-212 | Plug stud (size kit, same for every size) | 1 | MP-212_plug-stud-size-kit-same-for-every-size .step / .stl
MP-204-6363 | Upper ring, kit 63.5 × 63.5 | 1 | MP-204-6363_upper-ring-kit-63-5-x-63-5 .step / .stl
BUY-45 | Spring plunger M4, nylon tip (upper ring) | 4 | BUY-45_spring-plunger-m4-nylon-tip-upper-ring .step / .stl
MP-206-6363 | Pickup pedestal, kit 63.5 × 63.5 | 1 | MP-206-6363_pickup-pedestal-kit-63-5-x-63-5 .step / .stl
BUY-47 | Dowel pin Ø12 × 15 (pedestal and anvil spigot) | 2 | BUY-47_dowel-pin-d12-x-15-pedestal-and-anvil-spigot .step / .stl
BUY-48 | Pin Ø4 × 10 (pedestal and anvil anti-rotation) | 2 | BUY-48_pin-d4-x-10-pedestal-and-anvil-anti-rotation .step / .stl
MP-208-6363 | Crimp anvil, kit 63.5 × 63.5 | 1 | MP-208-6363_crimp-anvil-kit-63-5-x-63-5 .step / .stl

Tools: Press, 3 mm hex key, depth gauge or feelers, torque wrench, Loctite 243 and 222

1. Do this once per kit; every kit is prepared the same way. Kit 6363 is shown.
2. Plug: press the two Ø5 × 14 dowels into the D holes on the top face, 5.5 mm proud. Screw the stud (MP-
212) into the M6 hole, Loctite 243, 8 N·m.
3. Upper ring: screw the four M4 spring plungers into the side holes until each ball stands 0.2 to 0.3 mm into the opening. Lock with Loctite 222.
4. Pickup pedestal and crimp anvil: press a Ø12 × 15 dowel into the underside hole C (7 mm proud) and a Ø4 × 10 pin into hole Q (4 mm proud).
5. Rings A and B need no preparation. Check every part carries the kit's size code (and U, A or B).

Check. Plug dowels and stud square to the face; plungers all the same protrusion.

Step 18 — | Fit the size kit

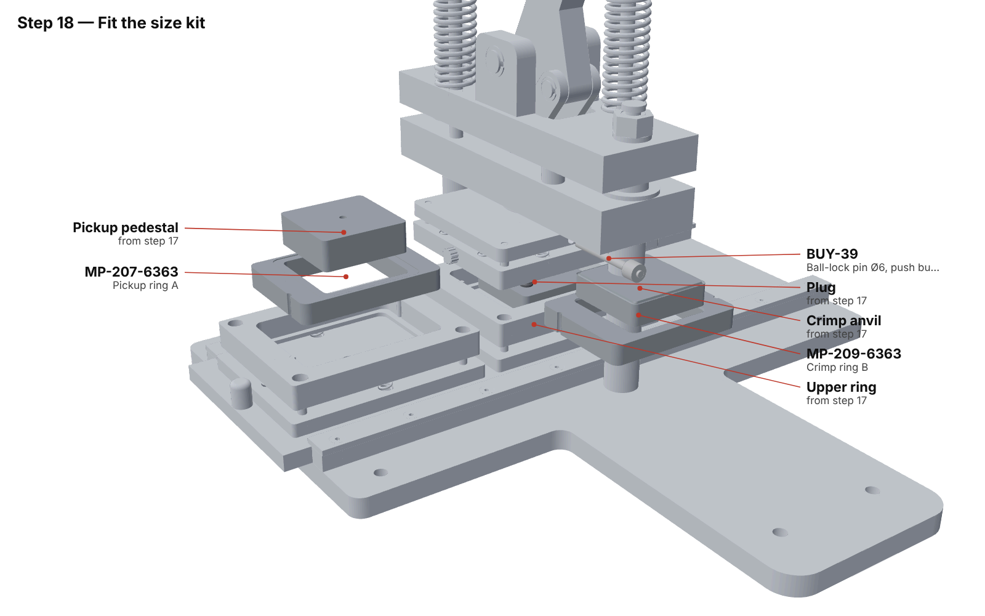
[picture p336: figure]

Part | Name | Qty | 3D model
— | Plug from step 17
— | Upper ring from step 17
— | Pickup pedestal from step 17
— | Crimp anvil from step 17
BUY-39 | Ball-lock pin Ø6, push button, grip 55 | 1 | BUY-39_ball-lock-pin-d6-push-button-grip-55 .step / .stl
MP-207-6363 | Pickup ring A, kit 63.5 × 63.5 | 1 | MP-207-6363_pickup-ring-a-kit-63-5-x-63-5 .step / .stl
MP-209-6363 | Crimp ring B, kit 63.5 × 63.5 | 1 | MP-209-6363_crimp-ring-b-kit-63-5-x-63-5 .step / .stl

Tools: None

1. With the handle up on its stop, offer the plug up to the die body: dowels into the D holes, stud into hole
K. It only fits one way.
2. Push the ball-lock pin in through the front of the body until it locks. It passes the stud's groove and holds the plug.
3. Push the upper ring up into the upper carrier with its key slots on the key pins, and tighten the two thumb screws.
4. Drop pickup ring A into carrier A, then the pickup pedestal through it, dowel into hole C and pin into hole Q.
5. Drop crimp ring B into carrier B, then the crimp anvil the same way. The key pins stop a ring going into the wrong carrier.

Check. One slow dry stroke on each station: the upper ring enters both lower rings without touching.

Part F — | Set-up and tests
Step 19 — | Feet, set-up and first magnets

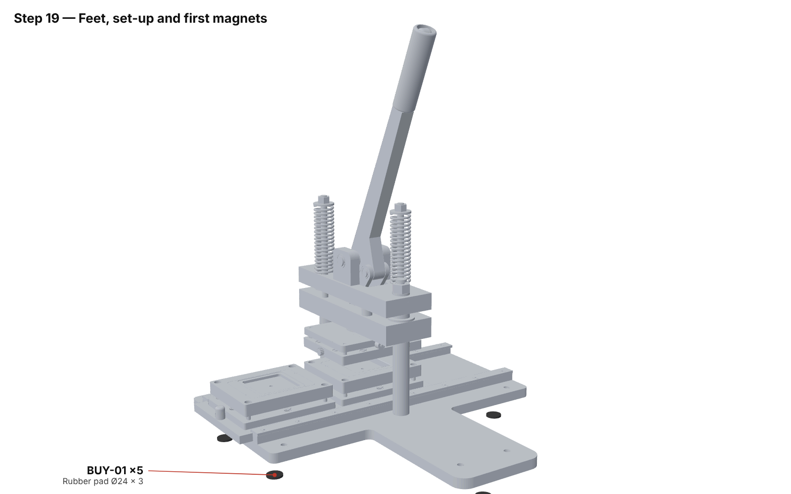
[picture p337: figure]

Part | Name | Qty | 3D model
BUY-01 | Rubber pad Ø24 × 3 | 5 | BUY-01_rubber-pad-d24-x-3 .step / .stl

Tools: Calipers, 10 kN load cell and dummy block, hanging scale, marker

1. Stick the feet under the base, clear of the six bench holes: four at (±200, ±80) and one under the tongue.
2. Put the press on a flat bench (two people: it weighs about 45 kg). For all-day use bolt it down through the Ø9 holes.
3. Set the depth: make a magnet, then add shims (0.1 / 0.2 / 0.5) until the crimp finishes with the handle about 5 to 10° above horizontal. Write the shim value on the frame label.
4. Run the tests in the table below, then make two test magnets per kit and check the corners and the crimp.

Check. Every test in the table below passes.

Test | How | Pass
Station alignment | Step 14. | ±0.05 mm at both stations
Station pilot | Table 3 mm off station, slow stroke; repeat at the other station and on the other side. | Stroke stops with the dies at least 5 mm apart
Handle return | Pull the handle fully down onto its stop and let go, 20 times. | Returns to the open stop every time
Stroke and handle stop | Measure ram travel from handle up to handle down. | 38.9 ±0.3 mm; handle stops 3° above horizontal
Depth | Shims so the crimp finishes with the handle 5 to 10° above horizontal (step 19). | Full crimp with a firm push, no hard knock
Force | 10 kN load cell on station B with a dummy block; 200 N on the grip with a hanging scale. | ≥ 5.5 kN
Ring alignment | Marker blue on the lower ring tops, slow stroke on each station. | Even contact all round; the upper ring never touches a lower ring edge
Magnet quality | Make 20 of each size. | No white paper at the edges, no torn film, no corner wrinkles, flange closed all round
Size-kit change | Change the kit, timing it; try each wrong ring in each carrier. | Under 2 minutes; no wrong ring seats
Reference height | Handle on its closed stop: die-holder face to table top. Write it on the frame label. | Re-check after any service; within 0.1 mm
Proof load (prototype only) | 20 kN cell on station B, push the grip to 16 kN; dial indicator before and after. | No permanent set; stroke still 38.9 ±0.3
Endurance (prototype) | 1,000 strokes, then 10,000; repeat alignment and quality checks. | No change; no galling; ≤ 1 mm handle play at the grip

## Changing the size kit

1. Rest the handle up on its stop and push the table to the right (station A under the ram).
2. Upper: hold the upper ring, loosen its two thumb screws and lower it out. Press the button on the ball-lock pin, pull it out, and lower the plug off its dowels.
3. Fit the new plug (it only fits one way) and push the pin home. Push the new upper ring up so its key slots meet the pins, and tighten the thumb screws.
4. Lower: screw the M5 T-handle puller into each pedestal or anvil and lift it out, then lift the ring out by its opening. Drop in the new ring A and pickup pedestal on the left, and ring B and crimp anvil on the right.
5. One slow dry stroke on each station, then two test magnets. Check the corners and the crimp before running a batch.

## Maintenance

When | Task
Each shift | Wipe the die table, rails and dies. Blow shell chips out of the rings. No oil on the dies.
Weekly or 5,000 strokes | Check the thumb screws, the die lock screw and the handle-stop setting. Light oil on the rails only.
25,000 strokes | Check handle play (≤ 1 mm at the grip) and the column nut torque. Clean tin pick-up from the die edges with a brass brush.
250,000 strokes | Replace the die springs and return springs. Inspect the bushings and pins. Dye-penetrant check the die corners.

If a shell jams, follow the un-jam procedure in docs/research/failure-review.md.
