nanda-1243/tngexp/light/render_assembled.png

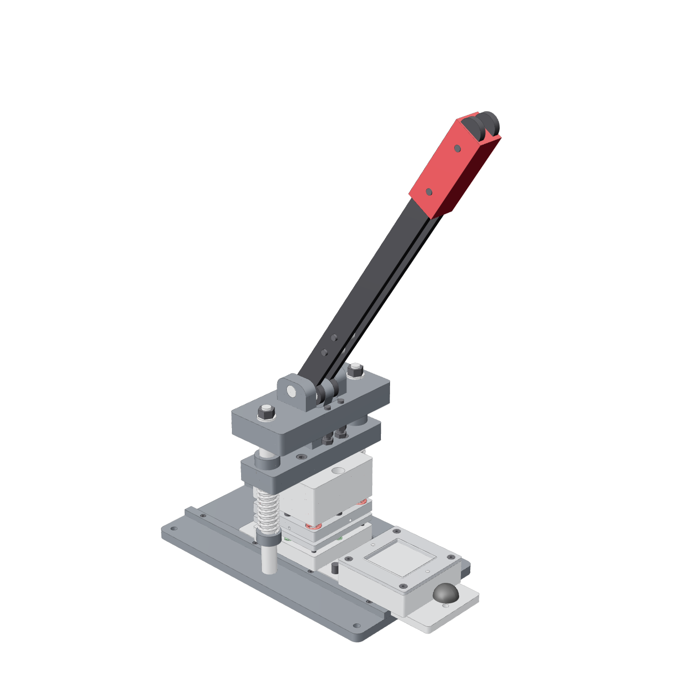
light/render_assembled.png
