nanda-1243/tngexp/(commit log)

2026-10-27 MagPress M4 Rev A: first design and drawing set
    Manual photo fridge-magnet press: toggle drive, H-frame, sliding
    two-station die table, four complete die sets (50x50, 63.5x63.5,
    53x80, 65x90). Build-pack page with 3D model, 30-sheet A3 drawing
    set and DXF profiles. The Rev A drawing generator source was not
    kept; Rev B adds the source.
    Claude-Session: https://claude.ai/code/session_017137sUEZWiCfgMXUwcQoy5
2026-10-27 MagPress M4 Rev B: failure review fixes
    One-piece handle lever (MP-115 deleted), pin O 16 mm, dry
    PTFE-composite bushings, stronger return springs, station pilot
    MP-120, 15 mm base on pads, adjustable handle stop, A2 dies
    re-tempered after EDM, 16 kN design load. Adds the drawing
    generator source (cad/).
    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
2026-10-27 MagPress M4 Rev C (final): universal die + size kits, research
    - One universal die (body, carriers, station bases, springs) plus a
    six-part hardened size kit per size, changed by hand in about a
    minute (MP-201 to MP-212, 33-sheet drawing set, 38 DXF).
    - Crimp anvil with a roll channel; die springs re-rated to their
    ISO 10243 limits.
    - Final consistency check: return springs lengthened to 128 mm free
    (at least 30% holding margin at every handle angle); mass
    estimate corrected to about 45 kg.
    - calc/engineering_calcs.py reproduces every calculated figure.
    - docs/: design notes, sources, failure review (FMEA) and the
    stepped-die study.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
2026-10-27 Track the design conversation transcript
    Session transcript (JSONL), its session state file and the fetched
    research PDF, under docs/conversation/. Old app login passwords quoted
    from qa.md are redacted.
    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
2026-10-27 Add 3D models of every part (STEP, STL, OBJ) and the placed assembly
    models/build_models.py builds each made part from the drawing source in
    cad/ and each bought part at catalogue size: 100 part files (52 made,
    including all four size kits; 48 bought) in STEP, STL and OBJ, plus the
    assembly (187 placed parts) as STEP, GLB and OBJ, and parts.csv.
    The interference check on the assembly found six fit problems in Rev C.
    They are listed in models/README.md and design-notes open items; the
    drawings and BOM are not changed in this commit.
    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
2026-10-27 Add the assembly manual (Markdown + PDF), illustrated from the 3D models
    docs/assembly/manual.py builds 19 assembly steps from the placed 3D
    assembly: an exploded step picture with part labels, the parts table
    (with links to each part's STEP/STL), tools, procedure, torque and
    check for every step, plus front matter (conventions, safety, tools,
    torque and thread-locker table), set-up and tests, size-kit change and
    maintenance. The six Rev C fit problems are flagged in the steps where
    they apply. Output: docs/assembly-manual.md and
    release/MagPress-M4_Assembly-Manual_RevC.pdf (26 A4 pages).
    Claude-Session: https://claude.ai/code/session_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
2026-10-27 MagPress M4 Rev C.1: fix the seven clashes found by the 3D interference check
    The interference check now runs at six handle angles, from handle up to
    the 3 deg stop, with the ram, lever and links moved to match. Rev C had
    seven clashes; Rev C.1 has none.
    - Ram MP-109: link clearance pockets L1/L2 on the top beside the clevis
    (the links' R12 lower ends dipped 2 mm into the ram).
    - Crown MP-108: slot-wall reliefs N1/N2 (underside, pin B ends, handle
    up) and N3/N4 (top, pin A ends, handle down). Crown 212 MPa at the
    16 kN design load (was 192); calc and results updated.
    - Die table MP-105: push knobs moved to the top face (M5, Ø14 x 18); the
    Ø24 end-face knobs reached into the base.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
2026-10-27 Add 3D-printing packs: every part as its own STL (half scale and full size) and OBJ
    models/make_print_pack.py zips the 99 part files from models/stl and
    models/obj into release/: folders by group (frame, die table, press drive,
    universal die, kit hardware, one folder per size kit), the number to print
    in each file name, and a README with scale, fit and bed-size notes. The
    half-scale STLs are scaled 50% so the whole press fits a 256 mm bed.
    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
2026-10-27 Build pack: the finished magnet in 3D and an animated section of how the folds are made
    Section 02 of the build pack gains:
    - The finished magnet in 3D for the selected size (front, back, edge cut
    open), with face, thickness, photo-paper and safe-area sizes, the layer
    stack and a to-scale print layout.
    - An animated section through one edge of the dies at true size, through
    both strokes in 10 stages: the photo and film wrapping the shell at
    station A, the pickup, and the crimp at station B where the tails and
    the skirt curl into the anvil's R1 roll channel under the back plate.
    - A note on how the paper gathers at the R4 corners.
    Both views come from one forming-geometry function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
2026-10-27 Rev D: round size kits Ø44, Ø50, Ø56, Ø58
    Four round kits for the same press and universal die. The round plug
    hangs on a second, inner dowel pattern in the upper die body (MP-201:
    D2 at (±12, −8), K2 at (−4.4, 12), same ball-lock pin line). Round kit
    parts are turned or bored and need no Ø4 anti-rotation pins.
    - Drawings: MP-223 to MP-229 (round plug, upper ring, pickup pedestal,
    pickup ring A, crimp anvil, crimp ring B), MP-201 inner pattern,
    cover and GA to Rev D; 39 sheets, 50 DXF.
    - Calcs: round-kit forces 2.13 to 2.81 kN (hand ≤ 90 N), kit masses.
    - Models: 24 round-kit part files (STEP/STL/OBJ), 123 files in all;
    interference check repeated with round kit D58 fitted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
2026-10-27 Magnet studio (in progress), print templates, Rev D design review
    - web/magnet-studio.html: photo layout tool for the press. Eight sizes,
    photo crop by drag and zoom, outlines, patterns, signature, date,
    brand and caption marks, A4/Letter sheets at true size with cut lines,
    PDF/PNG export, blank template and SVG guide.
    - web/studio/core.js: sizes, geometry, drawing helpers and the style
    registry; style libraries (frames, patterns, presets so far) are still
    being written.
    - web/tools/studio_gallery.js: contact sheets and error check for styles.
    - print-templates/: blank A4 and Letter templates and SVG design guides
    for every size, made by web/tools/make_templates.js.
    - docs/resear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
2026-10-27 Magnet studio: finished outline styles (24 frames)
    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
2026-10-27 Magnet studio: 18 background patterns and 34 ready-made looks; text styles in progress
    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
2026-10-27 Magnet studio: final text styles (31 marks), opens on a ready-made look; README links studio, templates and review
    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
2026-10-27 Magnet studio and print templates: sharp corners on square and rectangular magnets
    Commercial square photo magnets have essentially square corners. The studio
    and templates now use an R1 face corner (was R4) and square-cut paper (was
    R6 corners); the cutting tip says trimmer or rectangular punch.
    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
2026-10-27 Magnet studio: text on the folded back border, back view, mitred corners
    - Marks (signature, date, brand, caption) can go on the photo or on the
    back border: bottom, top, left, right or all round. The text is printed
    in the band that folds onto the back, turned so it reads upright there.
    - "Back, after pressing" view shows the folded border, back plate and
    magnet sheet as you will hold them.
    - Paper overhang = shell depth (4.5 mm default, selectable); the back
    border starts 1.7 mm past the face (green guide line).
    - Square and rectangular paper corners clipped at 45° so the folded
    border meets in a mitre on the back; templates and SVG guides updated.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
2026-10-27 Rev E: die kit and frame fixes from the design review, models rebuilt (0 overlaps)
    Sharp R1 corners with flat-fold anvil and corner reliefs, detent pin along X,
    shank and pilot spigots, F7 drop-in fits, 120 wide crown, handle-stop post
    MP-121, screw lengths, M3 ball plungers, dog-point thumb screws, 6 pads,
    spring guide sleeves. Calcs: hand force at the stop and crown bolt line.
    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
2026-10-27 Rev E build pack: sharp corners, flat-fold forming, new numbers and BOM (in progress); studio brand memo@1243
    Build pack page: R1 kit corners, paper 4.5 bleed with 45 deg clipped corners,
    flat-fold crimp animation and finished magnet (photo border on the back),
    crown 120, stop post MP-121, pilot D10, detent pin, sleeves, 6 pads, specs,
    BOM and part notes. Base PL label D12. Studio default brand text memo@1243.
    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
2026-10-27 Rev E: flat tin blanks folded in stroke 1, stronger upper springs; Rev E release
    Market check (docs/research/market-check-folds.md): sharp-cornered tin photo
    magnets start from a flat tin blank with clipped corners that the press folds,
    and the edge is folded flat under the back. Rev E now does the same:
    tin blank X + 8 with 45 deg corners, ring A stepped recess, pedestal edge R0.8.
    Folding the tin needs about 1.3 kN, so the upper die gets 8 red D12.5 x 44
    springs (1.57 -> 2.54 kN) in a 20 mm die body with a counterbore for the holder.
    Hand force at the stop 210-268 N square.
    Release files in release/RevE: drawings (40 sheets), DXF, assembly manual,
    print packs. Models rebuilt: 0 overlaps.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
2026-10-28 Rev E: double flat fold (hem) on the back; tin, photo and film X + 12
    The square magnets' edge now folds twice on the back: down the side,
    inward under the back plate, then back on itself, pressed flat in two
    layers. The photo stays outside as a 2.8 mm printed border and the cut
    tin edge is hidden inside the fold.
    - Crimp anvil MP-208: cove R0.7, floor 0.85 below the platform, platform
    wall at X - 6.6 turns the edge back. Magnet about 2.4 mm thick.
    - Tin blank, photo and film all X + 12 (6 mm bleed), corners clipped 45 deg.
    - Pickup pedestal 23.0 high (was 21.8) so the whole 6 mm flange is drawn
    in stroke 1; ring A recess X + 12.5 x 0.6; pickup stop at travel 34.2.
    - Round kits keep the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
2026-10-28 Verification work in progress: fit, sweep, frame FEA, forming solver; India sourcing guide
    - verify/: fastener engagement check (91 fasteners and pins), 1-degree interference
    sweep (no overlaps), CalculiX FEA of crown, base plate and lever at 16 kN, and an
    explicit plane-strain strip-forming solver with its validation runs.
    - docs/sourcing-india.md: where to get every part in Andhra Pradesh and Delhi NCR,
    with researched prices and a cost estimate.
    - docs/verification.md: report (forming section pending).
    - Orientation pin Ø4 x 10 -> Ø4 x 12, die-holder hole 6 -> 8 deep (sources only;
    models and drawings are rebuilt in the next commit).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
2026-10-28 Verification WIP: stroke-1 fixes (ring A ledge, upper ring mouth), forming scripts, FEA plot limits
    Ring A opening X + 10.5 and an R1.5 upper-ring mouth so the flat blank is
    wiped down, not drawn; plungers moved to 2.5 above the ring bottom. Stroke-2
    hem still under investigation (verify/stroke2y.py), values may change.
    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
2026-10-29 Verification WIP: stroke-2 insert and reference-crimp models, findings log
    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
2026-10-29 Verification: square kits on hold; forming results, reference crimp, sourcing status
    Explicit forming model of tin + photo + film:
    - Stroke 1 as drawn draws the flange (15-17 N/mm) beyond the upper spring
    preload; ring A opening X + 10.5 and an R2.5 upper-ring mouth fix it
    (65 x 90 plug >= 1.05 mm clear at friction 0.25).
    - Stroke 2, the double flat fold, makes the wall buckle; every variant in
    the Rev E die layout fails, while a commercial-style crimp (short skirt,
    back filling the shell, tight rings) forms cleanly in the same model.
    Square size kit sources are back at the Rev E release state (orientation
    pin fix kept); the report, calc note, sourcing guide and build page say the
    s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
2026-10-29 Market magnet dissection: confirmed edge construction (sharp crease, angled flap, photo and film tucked), photos
    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
2026-10-29 Market notes: material set photo; tin appears pre-formed (to confirm)
    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
2026-10-29 Market notes: tin is supplied flat; owner builds own press with seller's pre-cut material
    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
2026-10-29 Light press MagPress L1 (rev L1-A): design, drawings, DXF, STEP, forming check
    One die set for 63.5 x 63.5 with the market edge (tin folded once, flap
    turned in onto the acrylic card). Single source light/l1.py drives the 3D
    models, the 28-sheet drawing set, 19 DXF cutting profiles and the BOM.
    - Frame: steel base, head and ram, two D20 chrome columns, sliding table
    with ball detent; toggle as a lever fork on 16 mm stub pins with one
    central link (a 12 mm through pin O was overstressed). 25.9 kg, no
    clashes through the stroke at either station.
    - Dies: 7.1 mm plug recess so stroke 1 leaves a straight wall; cup ring
    with an 18 deg taper and a 1 mm nose that fills the upper ring's mou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
